mattbettcher/m68030-sbc/README.md

# m68030-sbc

Homebrew MC68030 single-board computer.

See [68030-design/spec.md](68030-design/spec.md) for the design specification.

Open [68030-design/kicad/m68030-sbc.kicad_pro](68030-design/kicad/m68030-sbc.kicad_pro) in KiCad 9.
