mattbettcher/m68030-sbc/68030-design/cpld/dram/pinout.csv

pin | fitter_name | function
1 | PWR_RST_n | GCLR (dedicated input)
2 |  | CLK_DRAMC on GCLK2 (for a future CPU-clock-synchronous FSM; unused in Rev A logic)
3 | VCC
4 | CAS0_n
5 | RAS1_n
6 | RAS2_n
7 | GND
8 | RAS3_n
9 | MA11
10 | MA10
11 | MA7
12 | MA6
13 | VCC
14 | TDI
15 | MA5
16 |  | reserved STERM_n (solder jumper JP801 open)
17 |  | reserved CBREQ_n (solder jumper JP802 open)
18 |  | reserved CBACK_n (solder jumper JP803 open)
19 | GND
20 | MA1
21 | MA3
22 | MA0
23 | TMS
24 | MA4
25 | MA2
26 | VCC
27 | MA8
28 | DSACK0_n
29 | MA9
30 | DSACK1_n
31 | R_W
32 | GND
33 | DRAM_SEL_n
34 | A0
35 | SIZ1
36 | SIZ0
37 | A1
38 | VCC
39 | A26
40 | A25
41 | A24
42 | GND
43 | VCC
44 | A23
45 | A21
46 | A22
47 | GND
48 | A18
49 | A19
50 |  | reserved DS_n (solder jumper JP804 open)
51 | A11
52 | A17
53 | VCC
54 | A10
55 | A13
56 | A7
57 | A8
58 | A4
59 | GND
60 | A2
61 | A6
62 | TCK
63 | A9
64 | A3
65 | A12
66 | VCC
67 | A15
68 | A5
69 | A14
70 | CAS2_n
71 | TDO
72 | GND
73 | A16
74 | MUX_SEL
75 | WE_n
76 | RAS0_n
77 | CAS1_n
78 | VCC
79 | CAS3_n
80 | A20
81 |  | spare I/O/GCLK3 (test point TP809)
82 | GND
83 | DRAM_CLK | GCLK1 (dedicated input)
84 | AS_n | OE1 (dedicated input)
