mattbettcher/m68030-sbc/68030-design/cpld/glue/pinout.csv

pin | fitter_name | function
1 | PWR_RST_n | GCLR (dedicated input)
2 | DS_n | OE2/GCLK2 (dedicated input)
3 | VCC
4 | IPL1_n
5 | DRAM_SEL_n
6 | AVEC_n
7 | GND
8 | DSACK0_n
9 | FC2
10 | FC1
11 | FC0
12 | EXP_SEL_n
13 | VCC
14 | TDI
15 | PERIPH_RST_n
16 | EXP_INT_n
17 | A19
18 | R_W
19 | GND
20 | EXP_BUF_EN_n
21 | IDE_DIOR_n
22 | A16
23 | TMS
24 | A15
25 | NMI_BTN_n
26 | VCC
27 | WARM_RST_BTN_n
28 | A2
29 | LED_n
30 | A3
31 | A13
32 | GND
33 | A18
34 | BUS_RD_n
35 | A17
36 | A14
37 | DUART_INT_n
38 | VCC
39 | BUS_WR_n
40 | ROM_CE_n
41 | NIC_INT_n
42 | GND
43 | VCC
44 | HALT_LED_n
45 | DUART_RST
46 |  | reserved SPI_HW_SCK (jumper | open)
47 | GND
48 |  | reserved SPI_HW_MOSI (jumper | open)
49 |  | reserved SPI_HW_MISO (jumper | open)
50 | IDE_BUF_EN_n
51 | DUART_CS_n
52 | IDE_CS1_n
53 | VCC
54 | IDE_INTRQ
55 | IDE_CS0_n
56 | IDE_IORDY
57 | IDE_DA2
58 | IDE_DIOW_n
59 | GND
60 | IDE_DA1
61 | CIIN_n
62 | TCK
63 | IDE_DA0
64 | HALT_n
65 | BERR_n
66 | VCC
67 | FPU_CS_n
68 | IPL0_n
69 | STATUS_n
70 | IPL2_n
71 | TDO
72 | GND
73 | RESET_n
74 | A29
75 | A28
76 | A31
77 | A30
78 | VCC
79 | A27
80 | A1
81 | DSACK1_n
82 | GND
83 | CLK | GCLK1 (dedicated input)
84 | AS_n | OE1 (dedicated input)
