mattbettcher/m68030-sbc/68030-design/fab/check/drill-overlay-v3.png

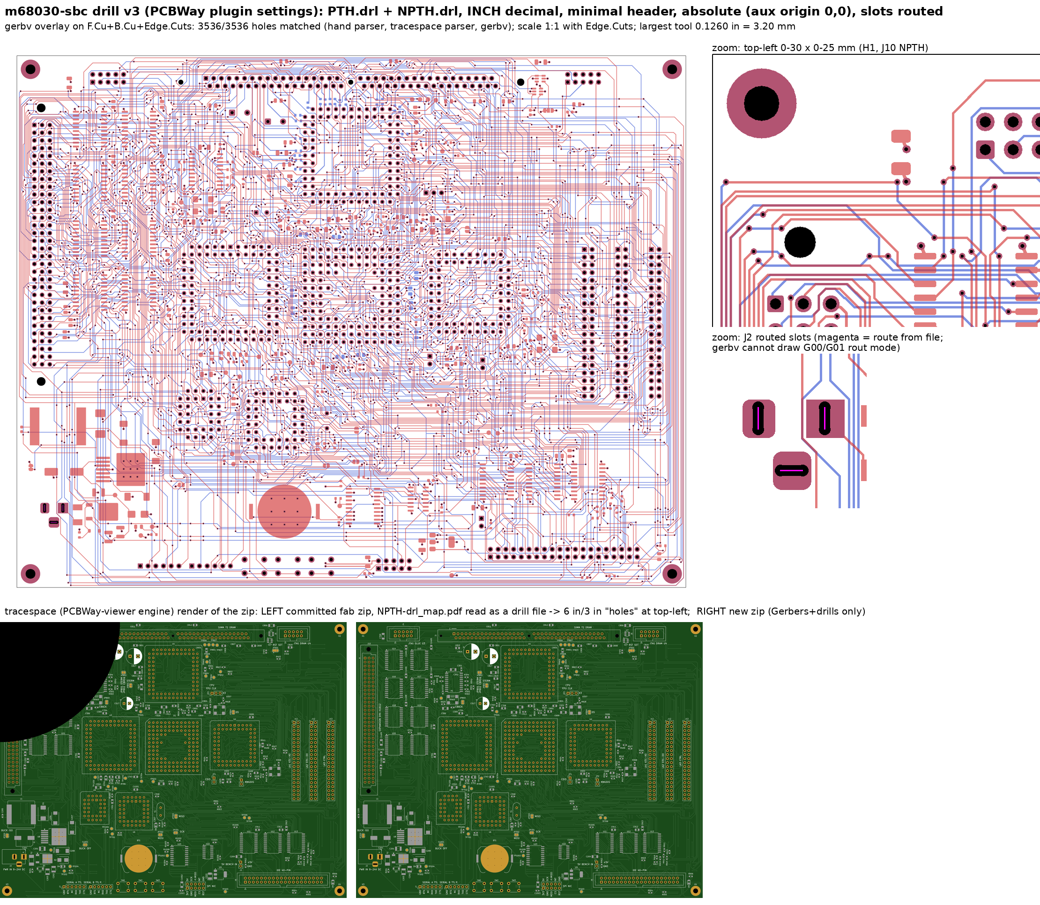
68030-design/fab/check/drill-overlay-v3.png
