mattbettcher/m68030-sbc/68030-design/fab/check/In1_Cu.png

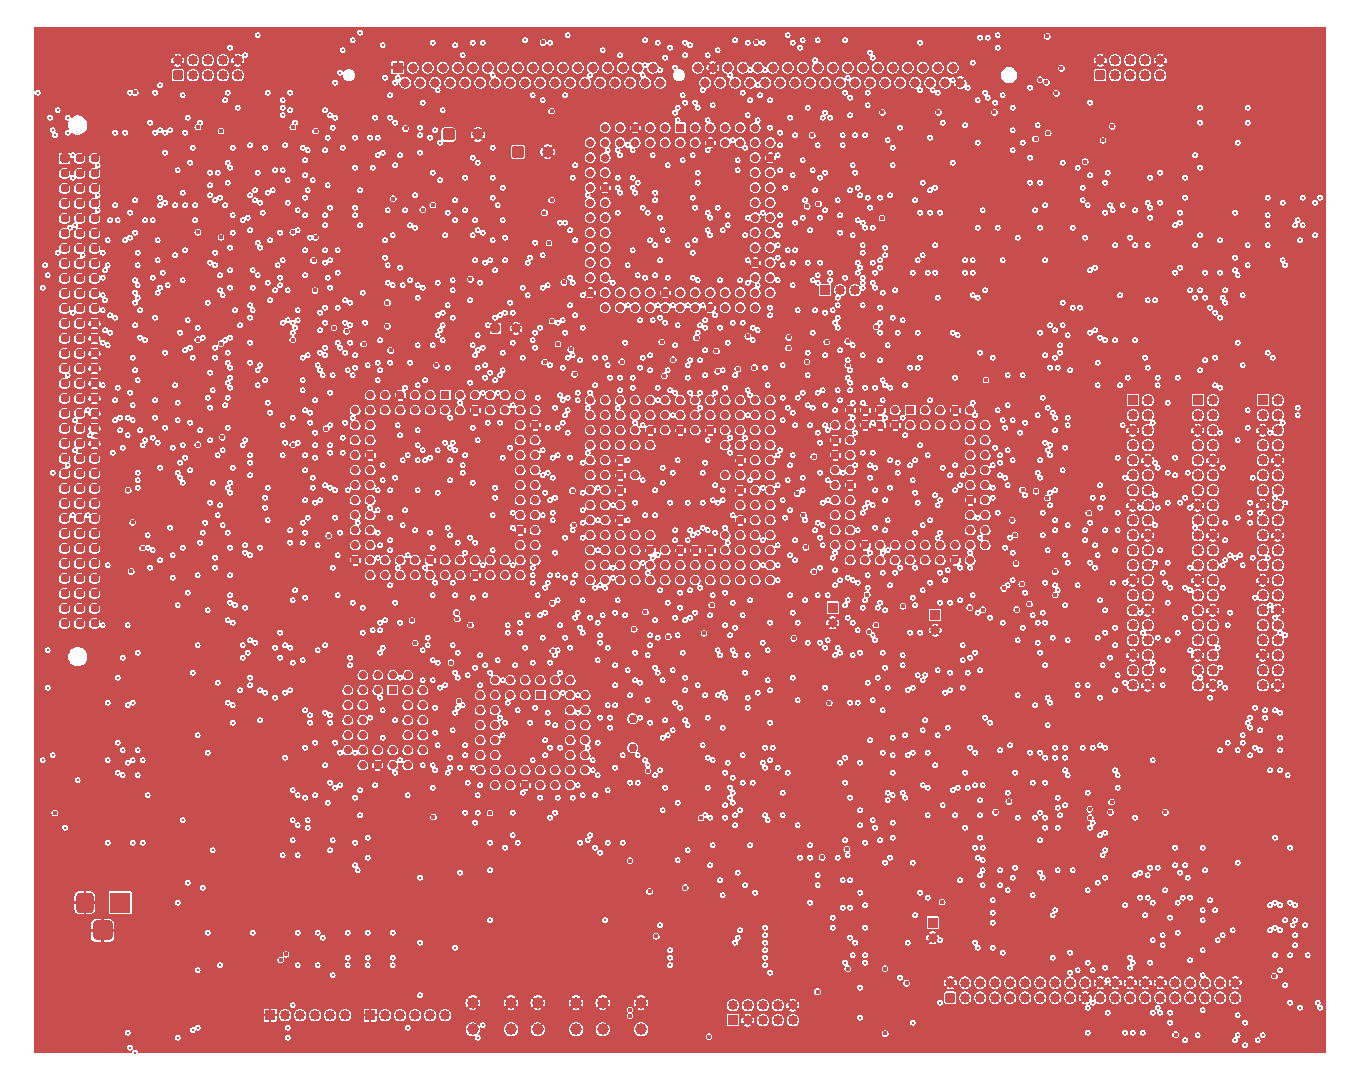
68030-design/fab/check/In1_Cu.png
