mattbettcher/m68030-sbc/68030-design/fab/check/In2_Cu.png

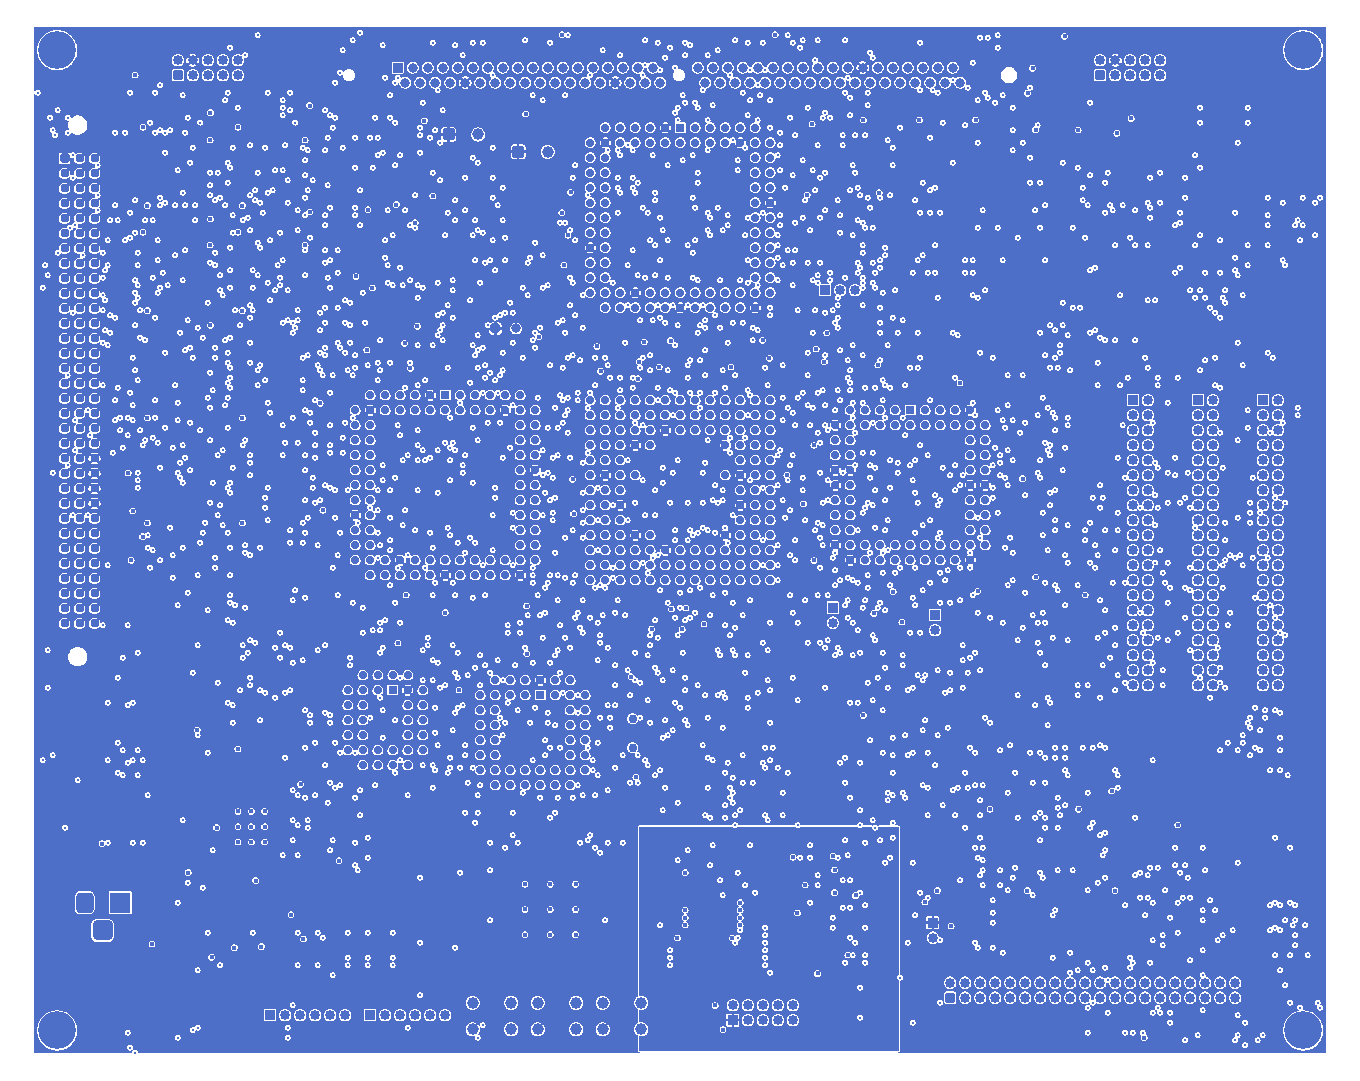
68030-design/fab/check/In2_Cu.png
