mattbettcher/m68030-sbc/68030-design/fab/check/inner-planes-gerbv.png

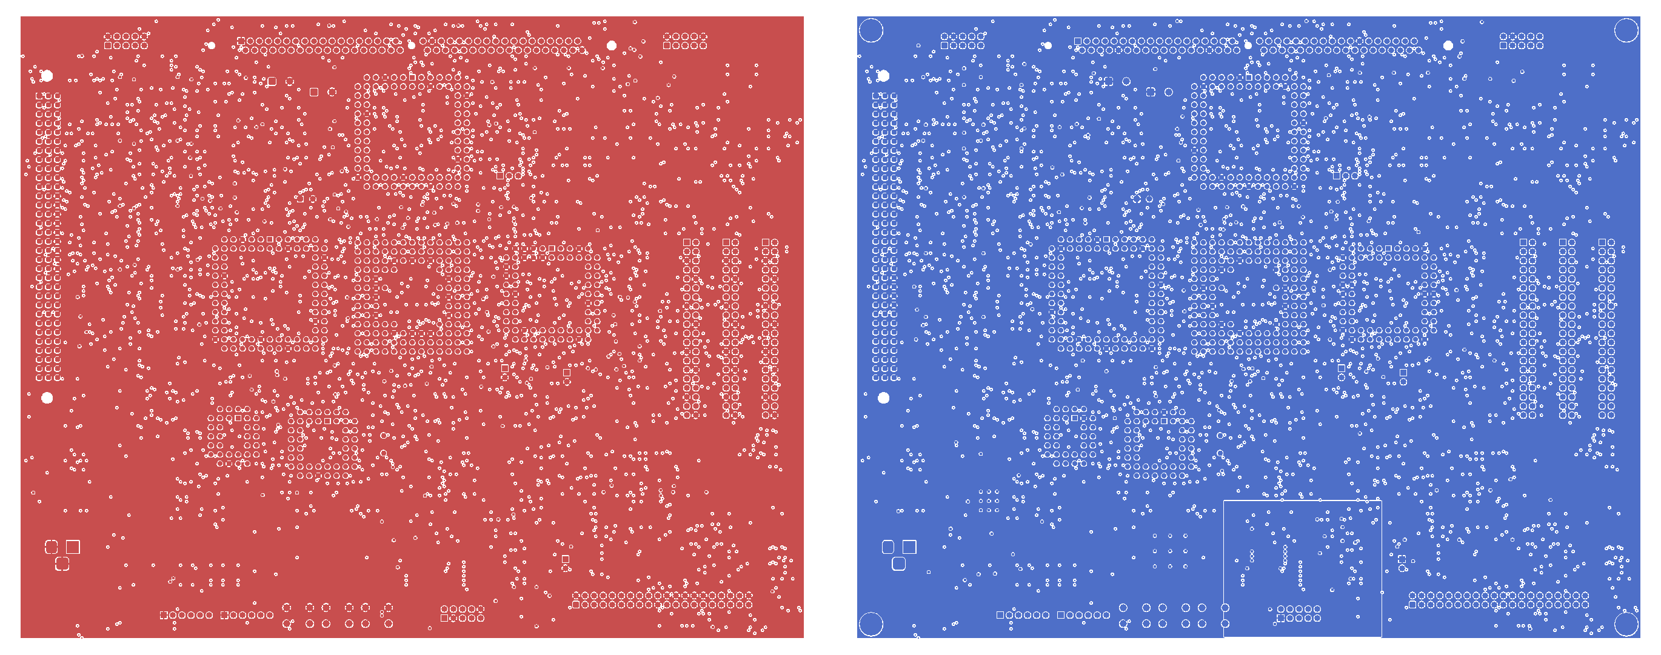
68030-design/fab/check/inner-planes-gerbv.png
