mattbettcher/m68030-sbc/68030-design/fab/check/topleft.png

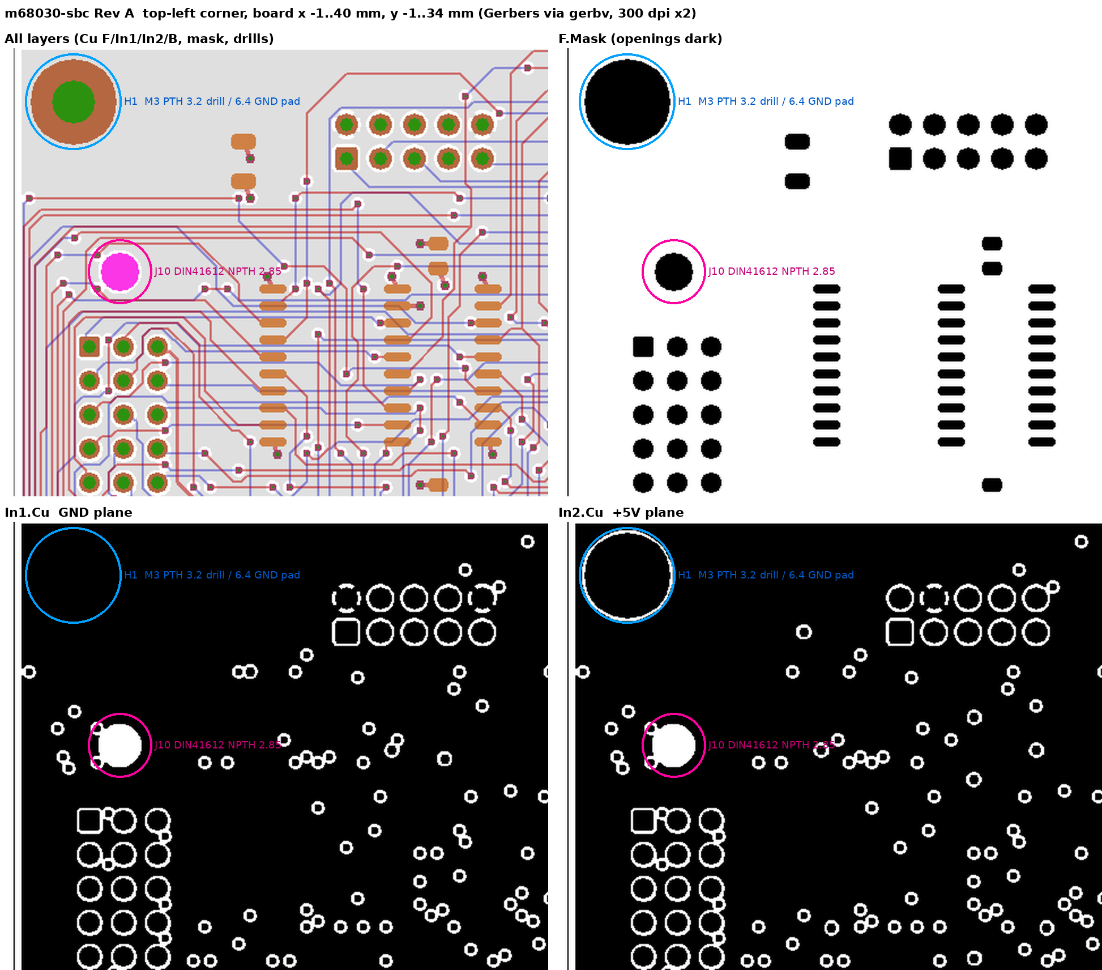
68030-design/fab/check/topleft.png
