mattbettcher/m68030-sbc/68030-design/renders/condense-assessment.png

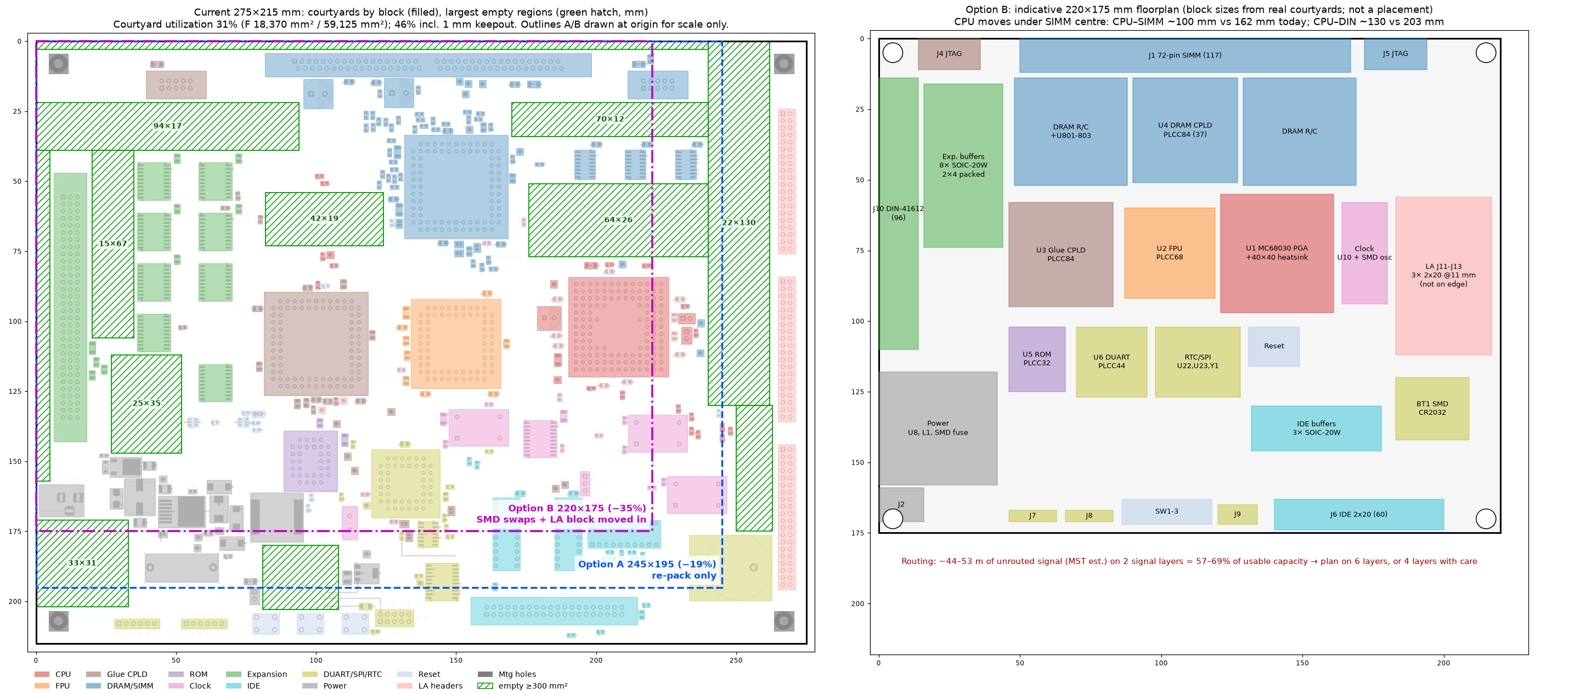
68030-design/renders/condense-assessment.png
