mattbettcher/m68030-sbc/68030-design/renders/m68030-sbc-3d-bottom.png

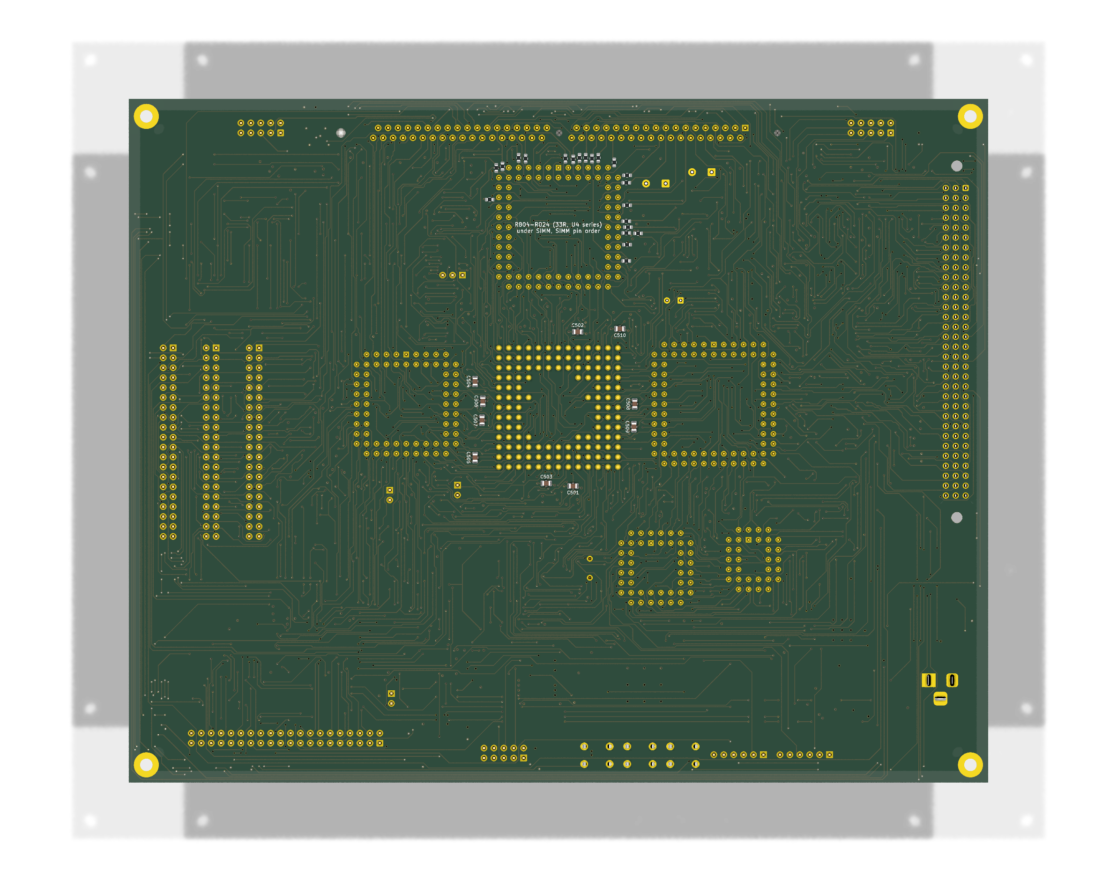
68030-design/renders/m68030-sbc-3d-bottom.png
