mattbettcher/m68030-sbc/68030-design/renders/m68030-sbc-220x175-pinswap-autoroute-4L.png

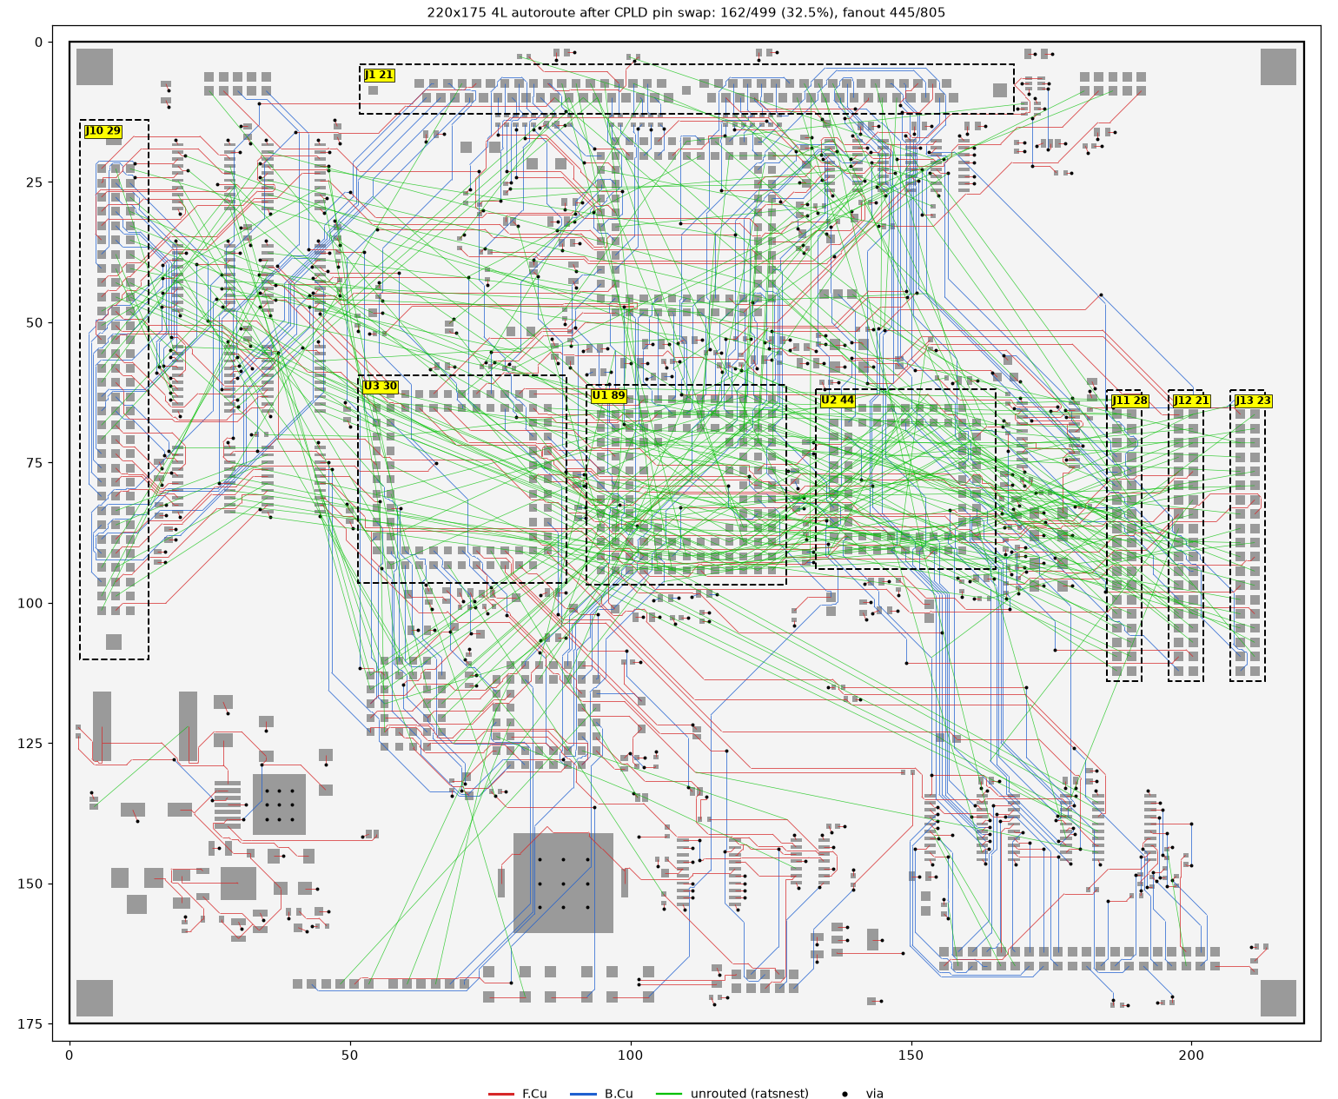
68030-design/renders/m68030-sbc-220x175-pinswap-autoroute-4L.png
