mattbettcher/m68030-sbc/68030-design/renders/m68030-sbc-B.Cu.png

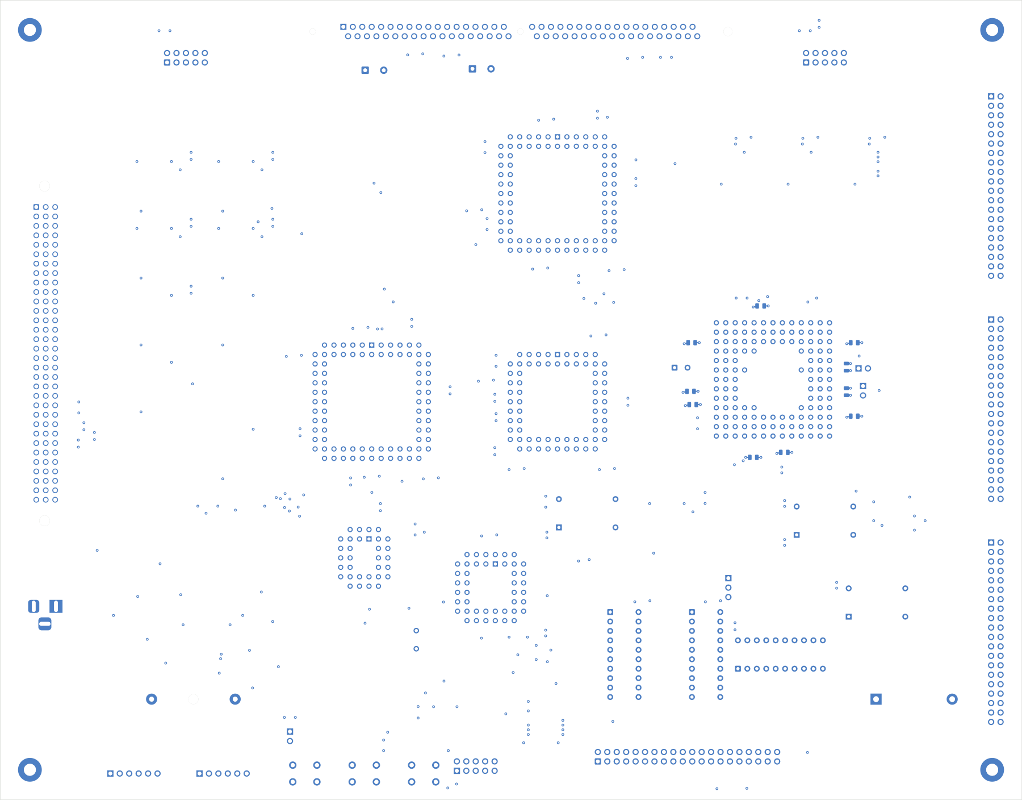
68030-design/renders/m68030-sbc-B.Cu.png
