mattbettcher/m68030-sbc/68030-design/renders/m68030-sbc-labels-zoom-bottom-right.png

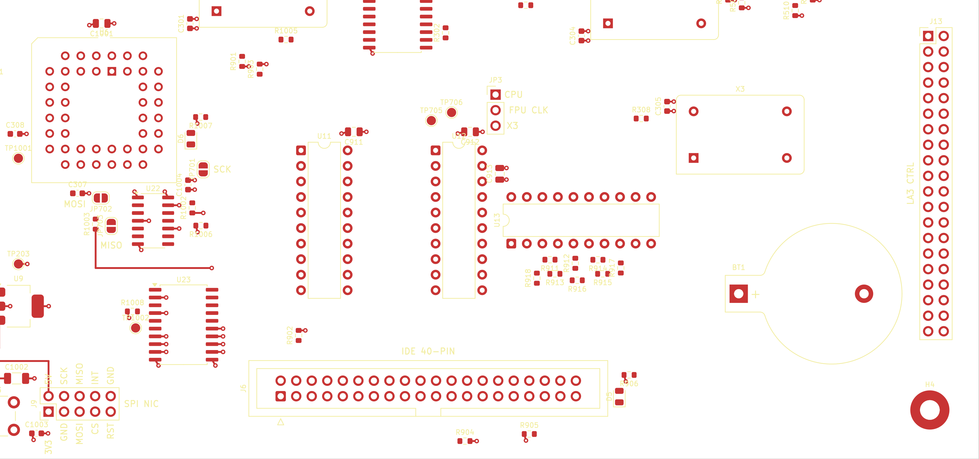
68030-design/renders/m68030-sbc-labels-zoom-bottom-right.png
