mattbettcher/m68030-sbc/68030-design/renders/m68030-sbc-labels-zoom-cpu-jumpers.png

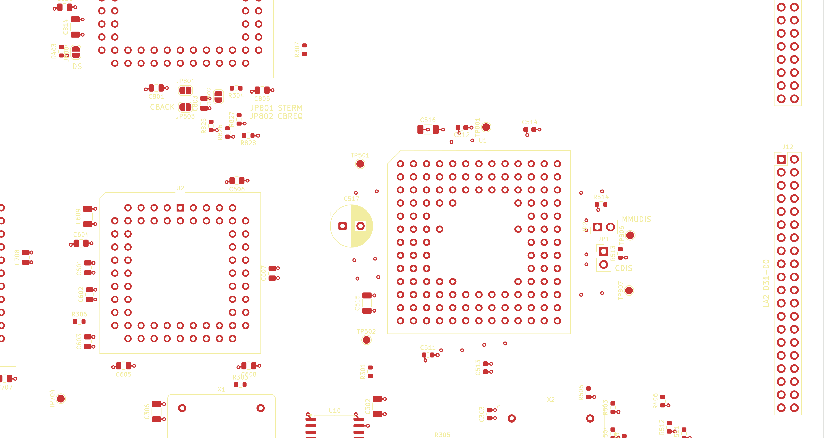
68030-design/renders/m68030-sbc-labels-zoom-cpu-jumpers.png
