mattbettcher/m68030-sbc/68030-design/renders/m68030-sbc-labels-zoom-top.png

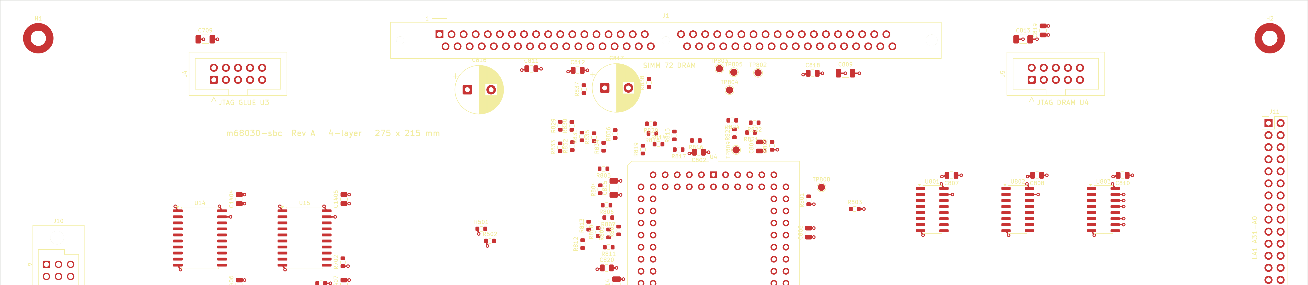
68030-design/renders/m68030-sbc-labels-zoom-top.png
