mattbettcher/m68030-sbc/68030-design/renders/m68030-sbc-routed-top.png

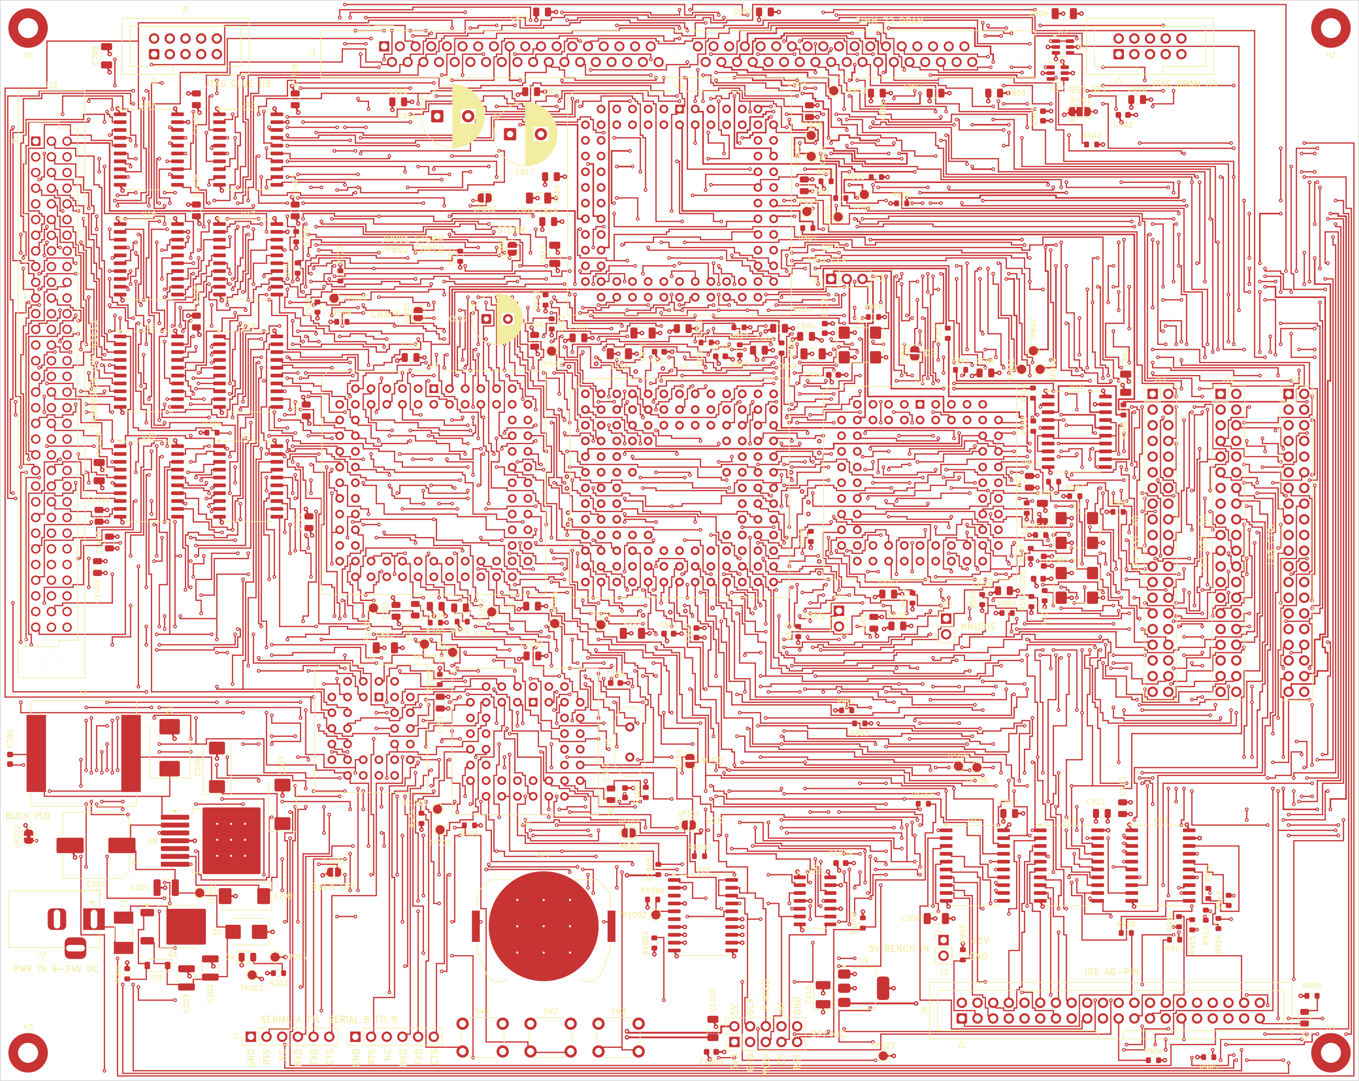
68030-design/renders/m68030-sbc-routed-top.png
