mattbettcher/m68030-sbc/68030-design/fab/m68030-sbc-bom.csv

Section | Refs | Qty | Value | Footprint | MPN | Source (bom.csv) | DNP | Notes
Fitted | BT1 | 1 | CR2032 | Battery:BatteryHolder_Keystone_3034_1x20mm | Keystone 3034 | DigiKey 36-3034-ND
Fitted | C201 C202 C203 | 3 | 10u | Capacitor_SMD:C_1210_3225Metric
Fitted | C204 | 1 | 100u | Capacitor_SMD:CP_Elec_10x10.5
Fitted | C205 | 1 | 10n | Capacitor_SMD:C_0603_1608Metric
Fitted | C206 C207 C208 | 3 | 100u | Capacitor_Tantalum_SMD:CP_EIA-7343-43_Kemet-X | KEMET T495X107K010ATE100 [VERIFY]
Fitted | C209 C302 C306 C515 C516 C552 C609 C709 C809 C813 C814 C815 C1002 C1409 | 14 | 10u | Capacitor_SMD:C_1206_3216Metric
Fitted | C210 | 1 | 22u 10V tant | Capacitor_Tantalum_SMD:CP_EIA-3528-21_Kemet-B
Fitted | C301 C303 C305 C401 C402 C1003 C1004 | 7 | 100n | Capacitor_SMD:C_0603_1608Metric
Fitted | C307 C308 | 2 | 22p C0G | Capacitor_SMD:C_0603_1608Metric
Fitted | C501 C502 C503 C504 C505 C506 C507 C508 C509 C510 C551 C601 C602 C603 C604 C605 C606 C607 C608 C701 C702 C703 C704 C705 C706 C707 C708 C801 C802 C803 C804 C805 C806 C807 C808 C810 C811 C812 C911 C912 C913 C1001 C1401 C1402 C1403 C1404 C1405 C1406 C1407 C1408 | 50 | 100n | Capacitor_SMD:C_0805_2012Metric
Fitted | C511 C512 C513 C514 | 4 | 330p | Capacitor_SMD:C_0603_1608Metric
Fitted | C517 | 1 | 220u | Capacitor_THT:CP_Radial_D8.0mm_P3.50mm
Fitted | C816 C817 | 2 | 470u | Capacitor_THT:CP_Radial_D10.0mm_P5.00mm
Fitted | D1 | 1 | B540C | Diode_SMD:D_SMC | B540C-13-F
Fitted | D2 | 1 | SMBJ28CA | Diode_SMD:D_SMB | SMBJ28CA (28 V standoff, bidirectional)
Fitted | D3 | 1 | MMSZ5242B | Diode_SMD:D_SOD-123 | MMSZ5242B (12 V)
Fitted | D4 | 1 | PWR | LED_SMD:LED_0805_2012Metric
Fitted | D5 | 1 | IDE | LED_SMD:LED_0805_2012Metric
Fitted | D6 | 1 | OP6 | LED_SMD:LED_0805_2012Metric
Fitted | D701 | 1 | USER | LED_SMD:LED_0805_2012Metric
Fitted | D702 | 1 | HALTED | LED_SMD:LED_0805_2012Metric
Fitted | F1 | 1 | T5A 0454005.MR | Fuse:Fuse_Littelfuse-NANO2-451_453 | Littelfuse 0454005.MR | DigiKey / Newark
Fitted | J1 | 1 | SIMM-72 socket | m68030-sbc:SIMM-72_TE-5822021-4 | TE 5822021-4
Fitted | J2 | 1 | 9-24V DC | Connector_BarrelJack:BarrelJack_Horizontal
Fitted | J4 | 1 | JTAG (ATDH1150USB) | Connector_IDC:IDC-Header_2x05_P2.54mm_Vertical
Fitted | J5 | 1 | JTAG U4 (ATDH1150USB) | Connector_IDC:IDC-Header_2x05_P2.54mm_Vertical
Fitted | J6 | 1 | IDE 40-pin | Connector_IDC:IDC-Header_2x20_P2.54mm_Vertical | Wurth 61204021621 | Wurth
Fitted | J7 J8 | 2 | TTL-232 | Connector_PinHeader_2.54mm:PinHeader_1x06_P2.54mm_Vertical
Fitted | J9 | 1 | SPI NIC | Connector_PinHeader_2.54mm:PinHeader_2x05_P2.54mm_Vertical
Fitted | J10 | 1 | DIN41612-C-96 | Connector_DIN:DIN41612_C_3x32_Female_Vertical_THT | HARTING 09032966821 | HARTING
Fitted | J11 | 1 | LA1 A31-A0 | Connector_PinHeader_2.54mm:PinHeader_2x20_P2.54mm_Vertical | Samtec TSW-120-07-G-D
Fitted | J12 | 1 | LA2 D31-D0 | Connector_PinHeader_2.54mm:PinHeader_2x20_P2.54mm_Vertical | Samtec TSW-120-07-G-D
Fitted | J13 | 1 | LA3 control | Connector_PinHeader_2.54mm:PinHeader_2x20_P2.54mm_Vertical | Samtec TSW-120-07-G-D
Fitted | JP1 | 1 | CDIS (cache disable) | Connector_PinHeader_2.54mm:PinHeader_1x02_P2.54mm_Vertical
Fitted | JP2 | 1 | MMUDIS (MMU disable) | Connector_PinHeader_2.54mm:PinHeader_1x02_P2.54mm_Vertical
Fitted | JP3 | 1 | FPU_CLK_SEL | Connector_PinHeader_2.54mm:PinHeader_1x03_P2.54mm_Vertical
Fitted | L1 | 1 | 22uH | Inductor_SMD:L_Bourns_SRP1770TA_16.9x16.9mm | Bourns SRP1770TA-220M
Fitted | Q1 | 1 | SUD50P04-08 | Package_TO_SOT_SMD:TO-252-2 | SUD50P04-08-GE3 | Newark / TME
Fitted | R201 R401 R403 R404 R405 R510 R511 R512 R513 R514 R825 R826 R827 R828 R902 R903 R905 R1002 R1003 R1004 R1008 | 21 | 10k | Resistor_SMD:R_0603_1608Metric
Fitted | R202 R406 R407 R501 R502 R503 R504 R505 R506 R507 R508 R509 R705 R706 R906 R1007 | 16 | 1k | Resistor_SMD:R_0603_1608Metric
Fitted | R301 R302 R303 R304 R305 R306 R307 | 7 | 33R | Resistor_SMD:R_0603_1608Metric
Fitted | R402 | 1 | 100k | Resistor_SMD:R_0603_1608Metric
Fitted | R701 R702 R703 R704 R801 R802 R803 R901 R1001 | 9 | 4.7k | Resistor_SMD:R_0603_1608Metric
Fitted | R804 R805 R806 R807 R808 R809 R810 R811 R812 R813 R814 R815 R816 R817 R818 R819 R820 R821 R822 R823 R824 R911 R912 R913 R914 R915 R916 R917 R918 | 29 | 33 | Resistor_SMD:R_0603_1608Metric
Fitted | R904 | 1 | 5.6k | Resistor_SMD:R_0603_1608Metric
Fitted | R1005 | 1 | 1.0k | Resistor_SMD:R_0603_1608Metric
Fitted | R1006 | 1 | 2.2k | Resistor_SMD:R_0603_1608Metric
Fitted | SW1 | 1 | WARM_RESET | Button_Switch_THT:SW_PUSH_6mm_H5mm
Fitted | SW2 | 1 | NMI | Button_Switch_THT:SW_PUSH_6mm_H5mm
Fitted | SW3 | 1 | COLD_RESET | Button_Switch_THT:SW_PUSH_6mm_H5mm
Fitted | U1 | 1 | MC68030RC33C | m68030-sbc:PGA128_13x13_MC68030 | MC68030RC33C | Rochester Electronics via DigiKey (authorized)
Fitted | U2 | 1 | MC68882FN33A | Package_LCC:PLCC-68_THT-Socket | MC68882FN33A (or FN25A) | Brokers (FN33A); verify authenticity
Fitted | U3 U4 | 2 | ATF1508AS-7JX84 | Package_LCC:PLCC-84_THT-Socket | ATF1508AS-7JX84 | Microchip Direct
Fitted | U5 | 1 | SST39SF040-70-4C-NHE | Package_LCC:PLCC-32_THT-Socket | SST39SF040-70-4C-NHE | Microchip / distributors
Fitted | U6 | 1 | SC26C92A1A | Package_LCC:PLCC-44_THT-Socket | SC26C92A1A | Brokers only (Digi-Key/Mouser/Rochester stock 0 on 2026-10-03)
Fitted | U7 | 1 | TPS3702CX50DDCR | Package_TO_SOT_SMD:SOT-23-6 | TPS3702CX50DDCR | DigiKey
Fitted | U8 | 1 | LM2678S-5.0 | Package_TO_SOT_SMD:TO-263-7_TabPin4 | LM2678S-5.0/NOPB | DigiKey
Fitted | U9 | 1 | AMS1117-3.3 | Package_TO_SOT_SMD:SOT-223-3_TabPin2 | AMS1117-3.3
Fitted | U10 | 1 | 74ACT244 | Package_SO:SOIC-20W_7.5x12.8mm_P1.27mm | SN74ACT244DWR
Fitted | U11 U12 U13 U18 U19 U20 U21 | 7 | SN74ACT245DW | Package_SO:SOIC-20W_7.5x12.8mm_P1.27mm | SN74ACT245DW | TI; TI / Mouser 595-SN74ACT245DW
Fitted | U14 U15 U16 U17 | 4 | SN74ACT244DW | Package_SO:SOIC-20W_7.5x12.8mm_P1.27mm | SN74ACT244DW | TI
Fitted | U22 | 1 | SN74LVC125ADR | Package_SO:SOIC-14_3.9x8.7mm_P1.27mm | SN74LVC125ADR | TI
Fitted | U23 | 1 | DS3234S# | Package_SO:SOIC-20W_7.5x12.8mm_P1.27mm | DS3234S# | DigiKey
Fitted | U27 | 1 | TPS3808G50DBVR | Package_TO_SOT_SMD:SOT-23-6 | TPS3808G50DBVR | DigiKey
Fitted | X1 | 1 | 25.000MHz | m68030-sbc:Oscillator_SMD_ECS-3951M_7.0x5.0mm_DIP14PinMap | ECS-3951M-250-BN-TR | DigiKey / Mouser (ECS authorized)
Fitted | X2 | 1 | 50.000MHz | m68030-sbc:Oscillator_SMD_ECS-3951M_7.0x5.0mm_DIP14PinMap | ECS-3951M-500-BN-TR | Mouser 520-3951M-500-BN / DigiKey XC324CT-ND
Fitted | Y1 | 1 | 3.6864MHz | Crystal:Crystal_HC49-4H_Vertical | 3.6864 MHz HC-49 (CL per chosen part)
DNP | C304 | 1 | 100n | Capacitor_SMD:C_0603_1608Metric |  |  | yes
DNP | C818 C819 C820 | 3 | 100n | Capacitor_SMD:C_0805_2012Metric |  |  | yes
DNP | J3 | 1 | 5V_BENCH | Connector_PinHeader_2.54mm:PinHeader_1x02_P2.54mm_Vertical |  |  | yes
DNP | R308 | 1 | 33R | Resistor_SMD:R_0603_1608Metric |  |  | yes
DNP | X3 | 1 | FPU osc (DNP) | m68030-sbc:Oscillator_SMD_ECS-3951M_7.0x5.0mm_DIP14PinMap | ECS-3951M-200-BN-TR [VERIFY freq vs 68882 grade] | DigiKey / Mouser | yes
PCB feature (no part) | H1 H2 H3 H4 | 4 | M3 | MountingHole:MountingHole_3.2mm_M3_Pad |  | n/a
PCB feature (no part) | JP202 | 1 | ISOLATE | Jumper:SolderJumper-2_P1.3mm_Bridged_RoundedPad1.0x1.5mm |  | n/a (PCB)
PCB feature (no part) | JP401 | 1 | SET | Jumper:SolderJumper-3_P1.3mm_Bridged12_RoundedPad1.0x1.5mm |  | n/a (PCB)
PCB feature (no part) | JP701 JP702 JP703 JP801 JP802 JP803 JP804 | 7 | open | Jumper:SolderJumper-2_P1.3mm_Open_RoundedPad1.0x1.5mm |  | n/a (PCB)
PCB feature (no part) | SJ201 | 1 | DISABLE | Jumper:SolderJumper-2_P1.3mm_Open_RoundedPad1.0x1.5mm |  | n/a (PCB)
PCB feature (no part) | TP201 | 1 | VIN | TestPoint:TestPoint_Pad_D1.5mm |  | n/a
PCB feature (no part) | TP202 | 1 | +5V | TestPoint:TestPoint_Pad_D1.5mm |  | n/a
PCB feature (no part) | TP203 | 1 | +3V3 | TestPoint:TestPoint_Pad_D1.5mm |  | n/a
PCB feature (no part) | TP204 | 1 | GND | TestPoint:TestPoint_Pad_D1.5mm |  | n/a
PCB feature (no part) | TP501 | 1 | CIOUT# | TestPoint:TestPoint_Pad_D1.5mm |  | n/a
PCB feature (no part) | TP502 | 1 | DBEN# | TestPoint:TestPoint_Pad_D1.5mm |  | n/a
PCB feature (no part) | TP503 | 1 | BG# | TestPoint:TestPoint_Pad_D1.5mm |  | n/a
PCB feature (no part) | TP701 | 1 | BUS_RD# | TestPoint:TestPoint_Pad_D1.5mm |  | n/a
PCB feature (no part) | TP702 | 1 | BUS_WR# | TestPoint:TestPoint_Pad_D1.5mm |  | n/a
PCB feature (no part) | TP703 | 1 | ROM_CE# | TestPoint:TestPoint_Pad_D1.5mm |  | n/a
PCB feature (no part) | TP704 | 1 | DUART_CS# | TestPoint:TestPoint_Pad_D1.5mm |  | n/a
PCB feature (no part) | TP705 | 1 | IDE_DIOR# | TestPoint:TestPoint_Pad_D1.5mm |  | n/a
PCB feature (no part) | TP706 | 1 | IDE_DIOW# | TestPoint:TestPoint_Pad_D1.5mm |  | n/a
PCB feature (no part) | TP801 | 1 | RAS0# | TestPoint:TestPoint_Pad_D1.5mm |  | n/a
PCB feature (no part) | TP802 | 1 | RAS1# | TestPoint:TestPoint_Pad_D1.5mm |  | n/a
PCB feature (no part) | TP803 | 1 | CAS0# | TestPoint:TestPoint_Pad_D1.5mm |  | n/a
PCB feature (no part) | TP804 | 1 | CAS1# | TestPoint:TestPoint_Pad_D1.5mm |  | n/a
PCB feature (no part) | TP805 | 1 | CAS2# | TestPoint:TestPoint_Pad_D1.5mm |  | n/a
PCB feature (no part) | TP806 | 1 | CAS3# | TestPoint:TestPoint_Pad_D1.5mm |  | n/a
PCB feature (no part) | TP807 | 1 | WE# | TestPoint:TestPoint_Pad_D1.5mm |  | n/a
PCB feature (no part) | TP808 | 1 | MUX_SEL | TestPoint:TestPoint_Pad_D1.5mm |  | n/a
PCB feature (no part) | TP809 | 1 | U4-81 | TestPoint:TestPoint_Pad_D1.5mm |  | n/a
PCB feature (no part) | TP1001 | 1 | OP7 | TestPoint:TestPoint_Pad_D1.5mm |  | n/a
PCB feature (no part) | TP1002 | 1 | RTC_INT | TestPoint:TestPoint_Pad_D1.5mm |  | n/a
PCB feature (no part) | TP1101 | 1 | LED_n | TestPoint:TestPoint_Pad_D1.5mm |  | n/a
PCB feature (no part) | TP1102 | 1 | HALT_LED_n | TestPoint:TestPoint_Pad_D1.5mm |  | n/a
Extra (not a footprint) | XU1 | 1 | Socket for U1 | m68030-sbc:PGA128_13x13_MC68030 (derived from mackerel-68k, | PGA-128 13x13 socket | TBD |  | Verify pin grid and 0.762 mm drill vs chosen socket [VERIFY]
Extra (not a footprint) | XU2 | 1 | Socket for U2 | Package_LCC:PLCC-68_THT-Socket | PLCC-68 THT socket | TBD
Extra (not a footprint) | XU3 XU4 | 2 | Sockets for U3/U4 | Package_LCC:PLCC-84_THT-Socket | PLCC-84 THT socket | TBD
Extra (not a footprint) | XU5 | 1 | Socket for U5 | Package_LCC:PLCC-32_THT-Socket | PLCC-32 THT socket | TBD
Extra (not a footprint) | XU6 | 1 | Socket for U6 | Package_LCC:PLCC-44_THT-Socket | PLCC-44 THT socket | TBD
Extra (not a footprint) | M1 | 1 | Main memory (start with known-good 16 or 64 MB) | n/a (module) | 72-pin 5 V SIMM, 60 ns EDO or FPM, 16-128 MB | Arch Memory (64 MB 60 ns EDO, new-old-stock) |  | Price for 64 MB module; prefer 11/11, 12/11 or 12/12 geometries
Extra (not a footprint) | HS1 | 1 | CPU cooling (up to 2.6 W) | n/a | PGA stick-on heatsink | TBD
