mattbettcher/m68030-sbc/68030-design/kicad/out/m68030-sbc.pdf

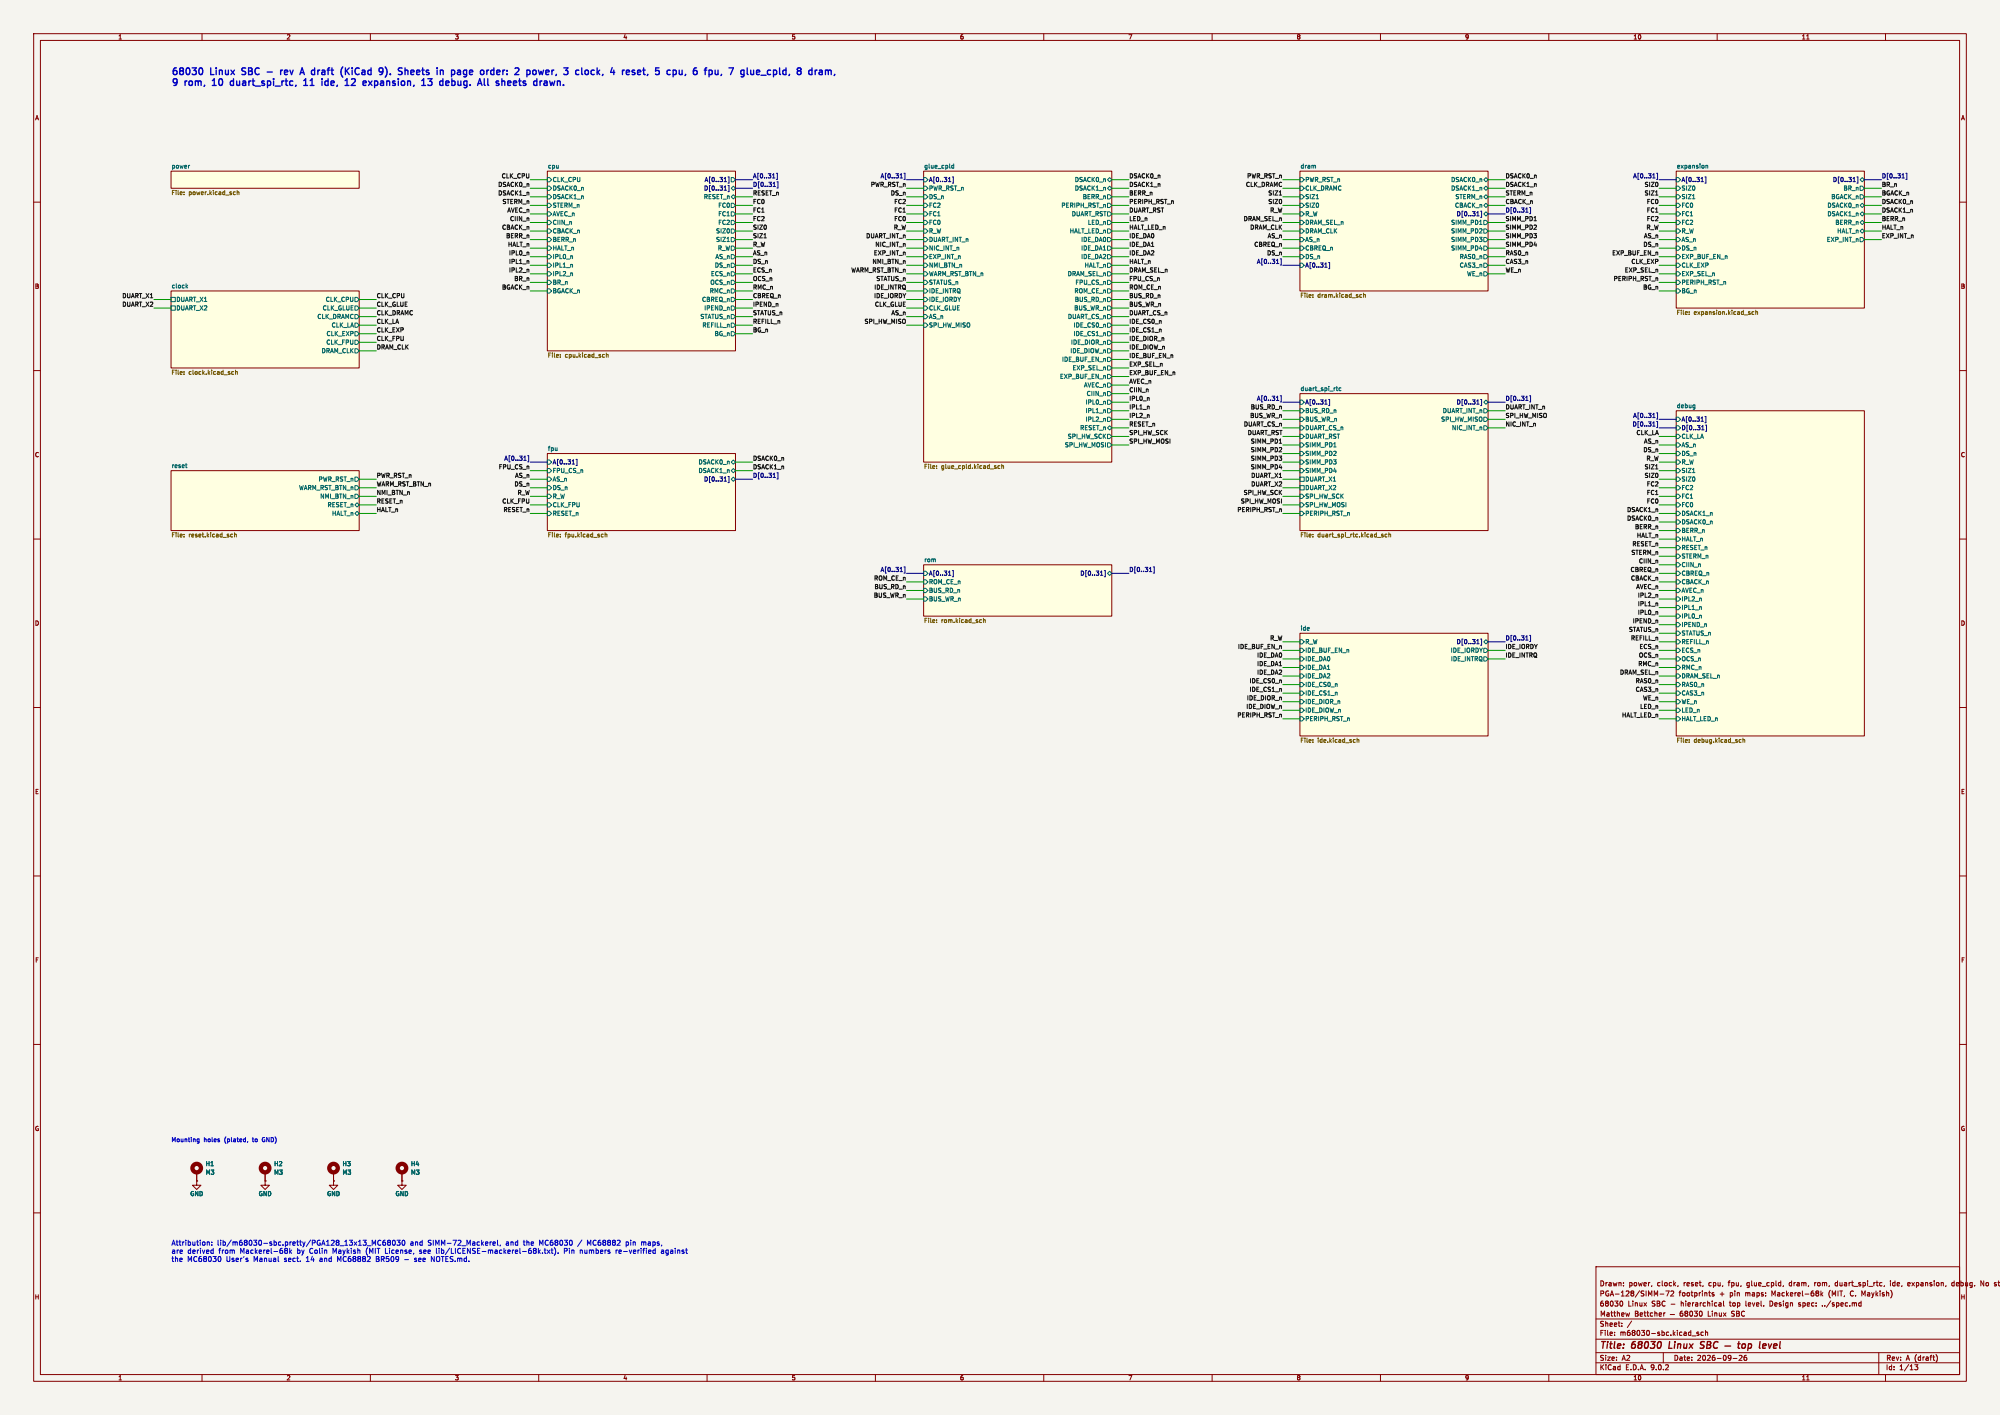
[picture p28: page 1]

68030 Linux SBC - rev A draft (KiCad 9). Sheets in page order: 2 power, 3 clock, 4 reset, 5 cpu, 6 fpu, 7 glue_cpld, 8 dram,

File: dram.kicad_sch power File: power.kicad_sch

the MC68030 User's Manual sect. 14 and MC68882 BR509 - see NOTES.md.

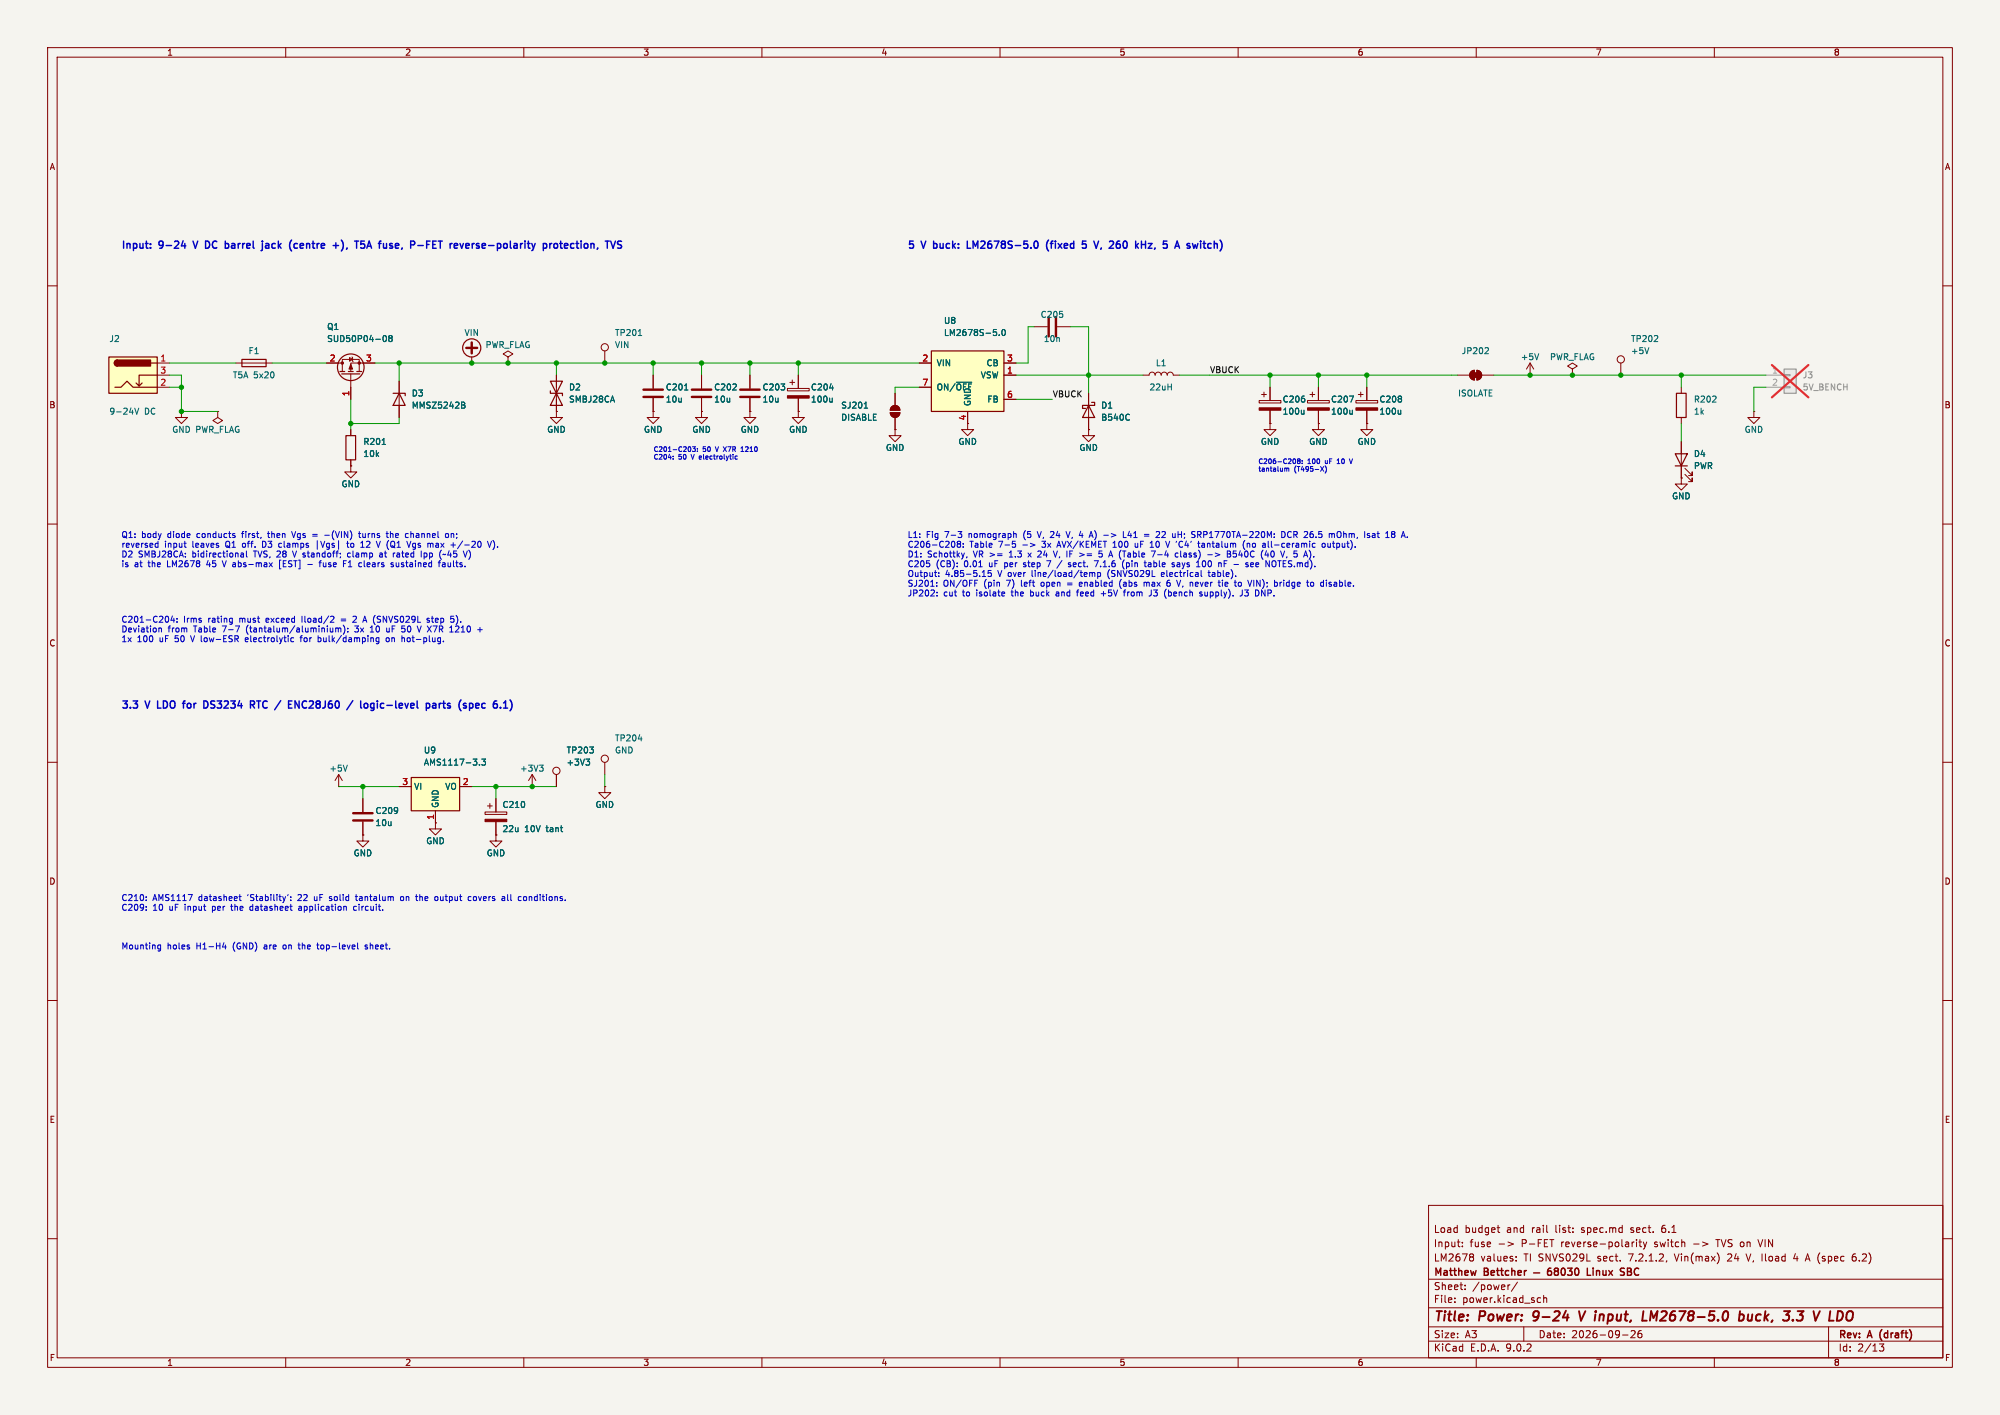
[picture p29: page 2]

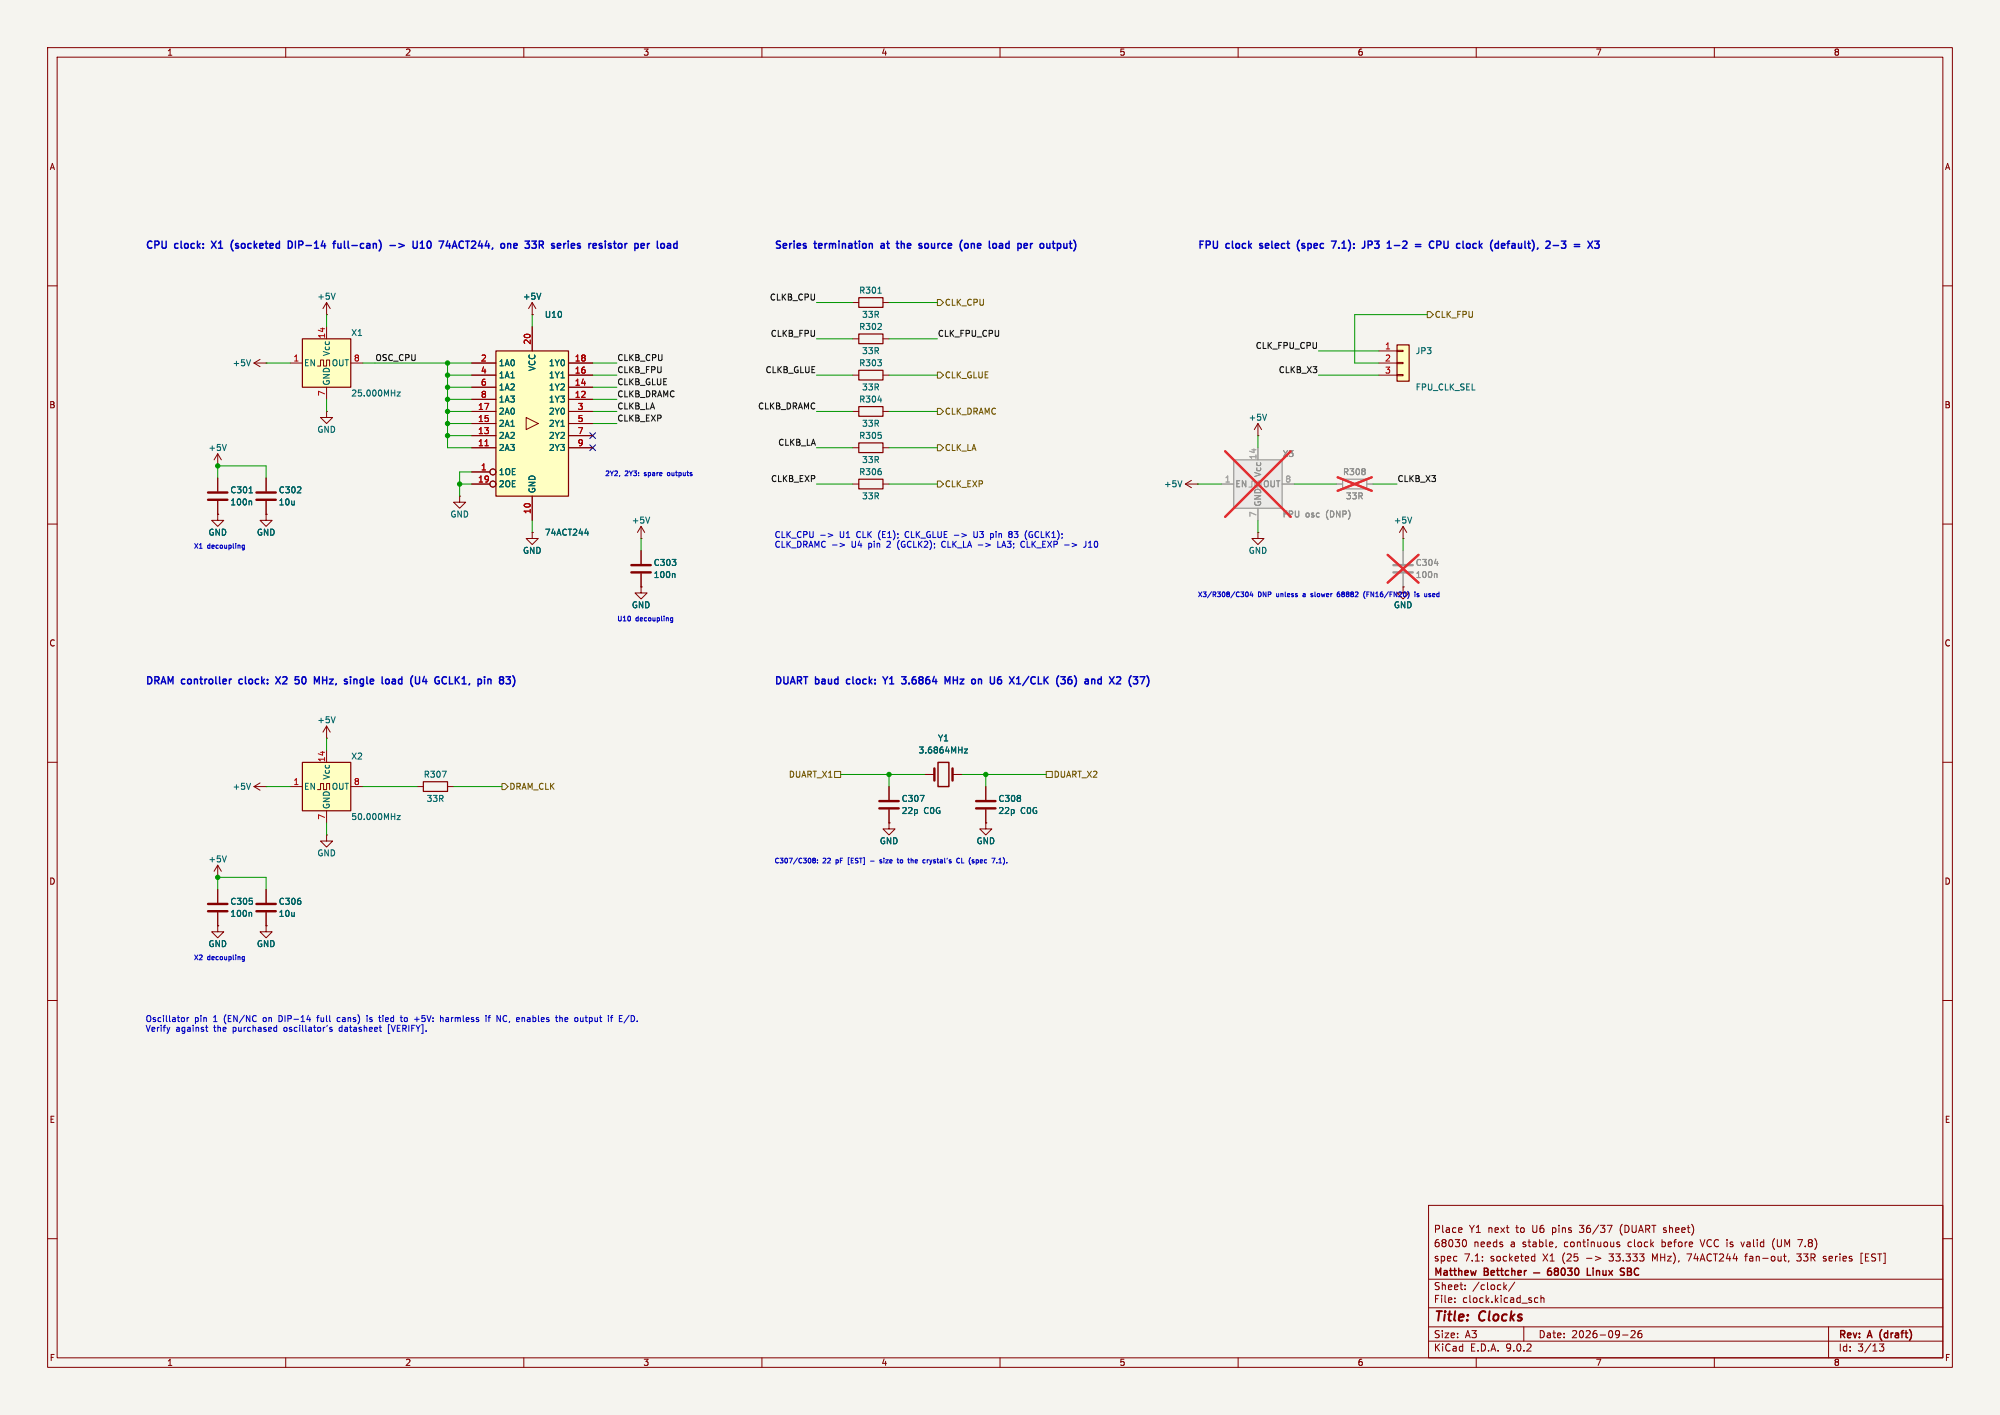
[picture p30: page 3]

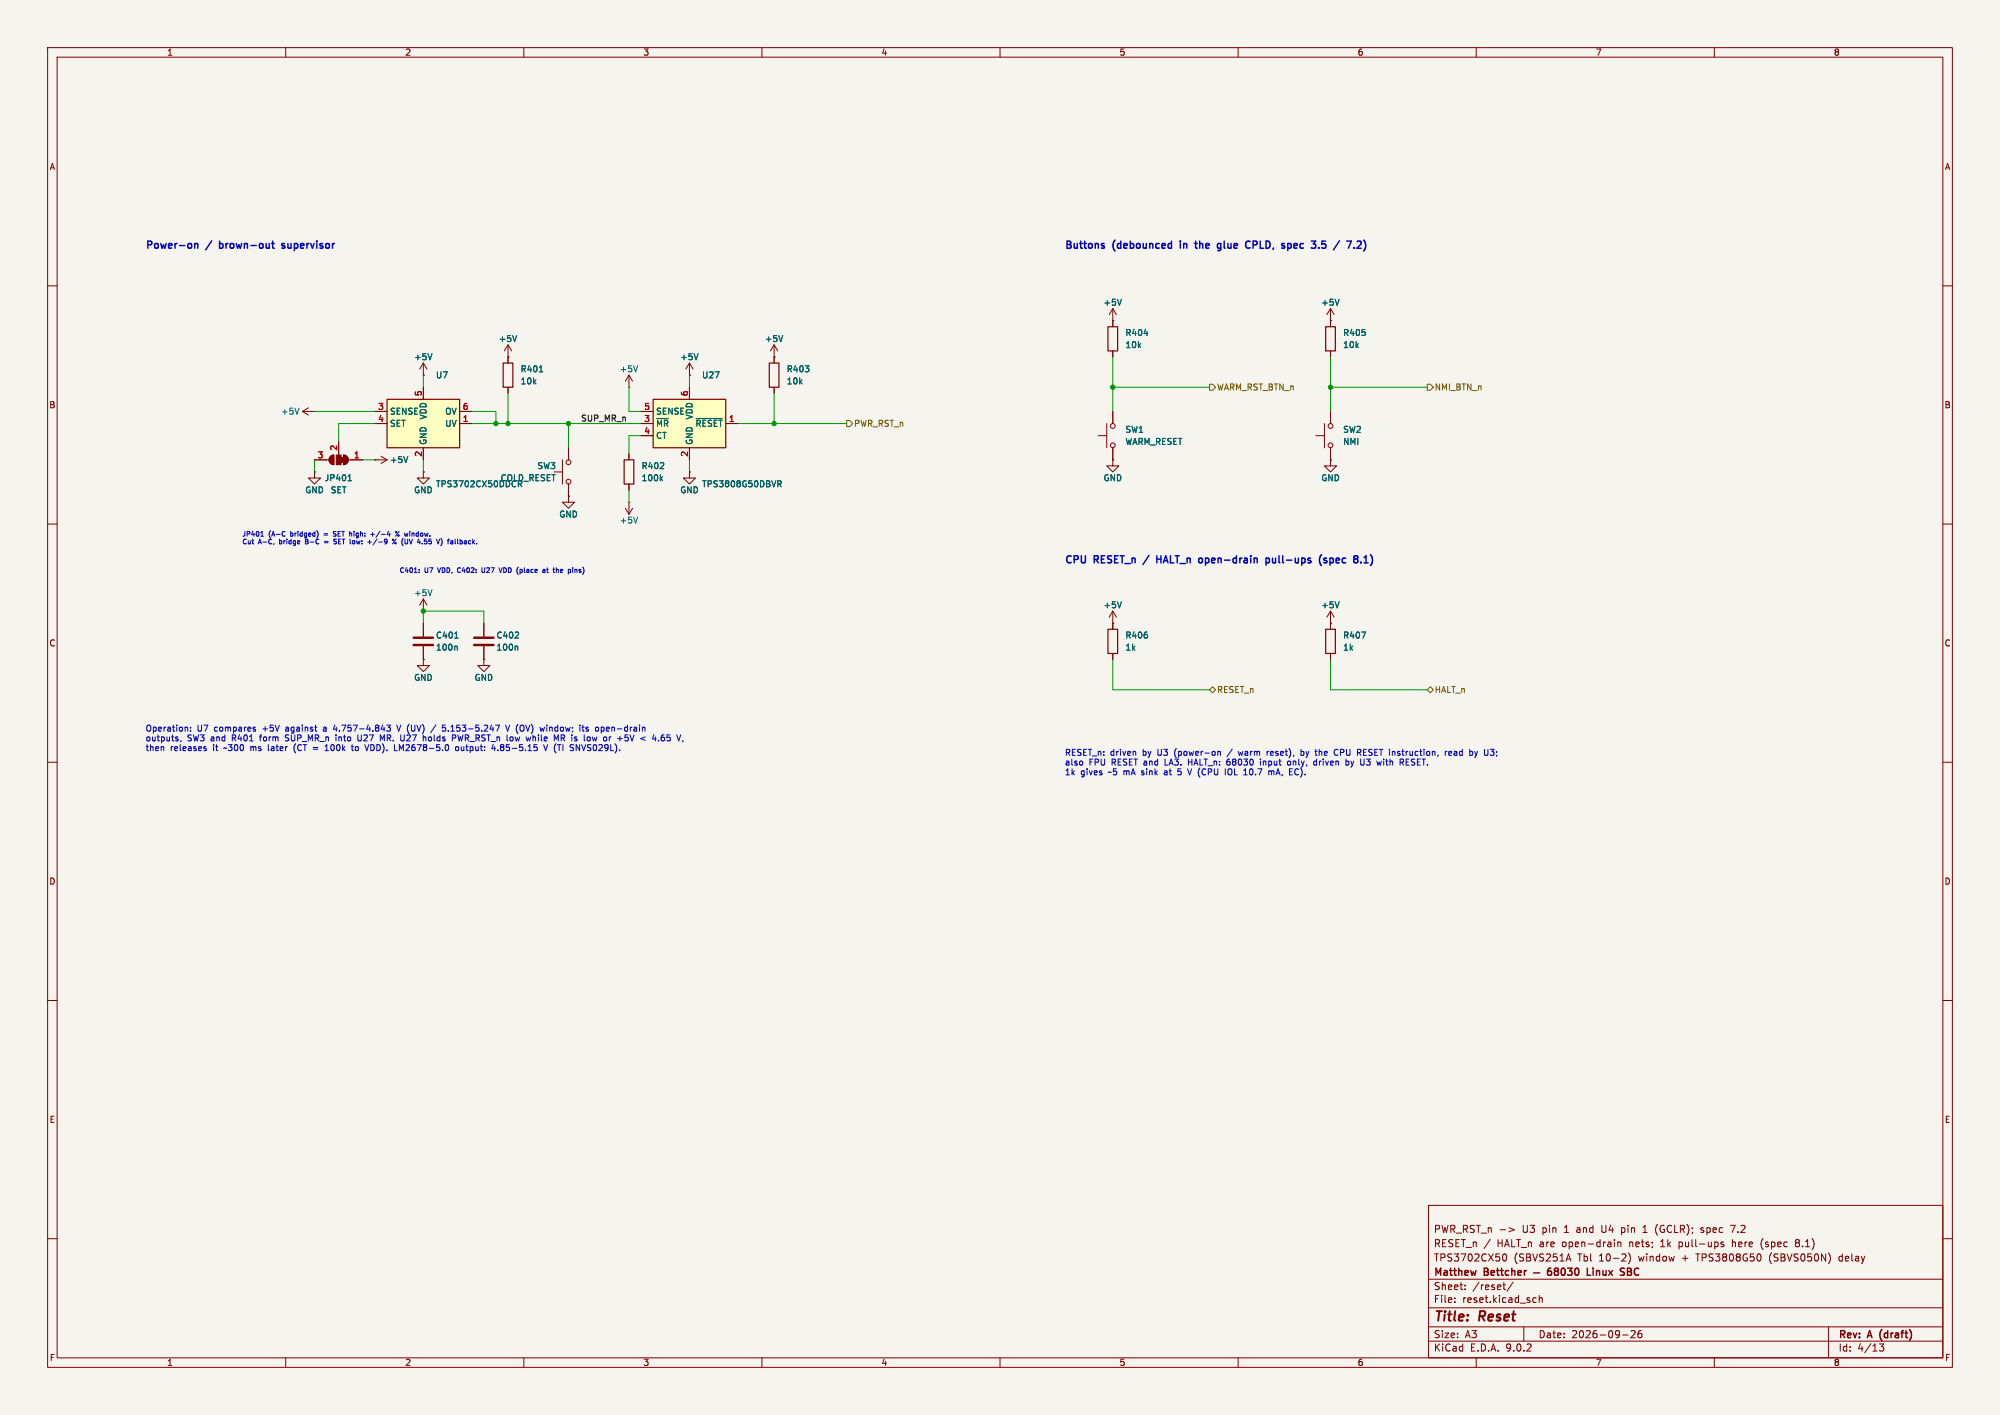
[picture p31: page 4]

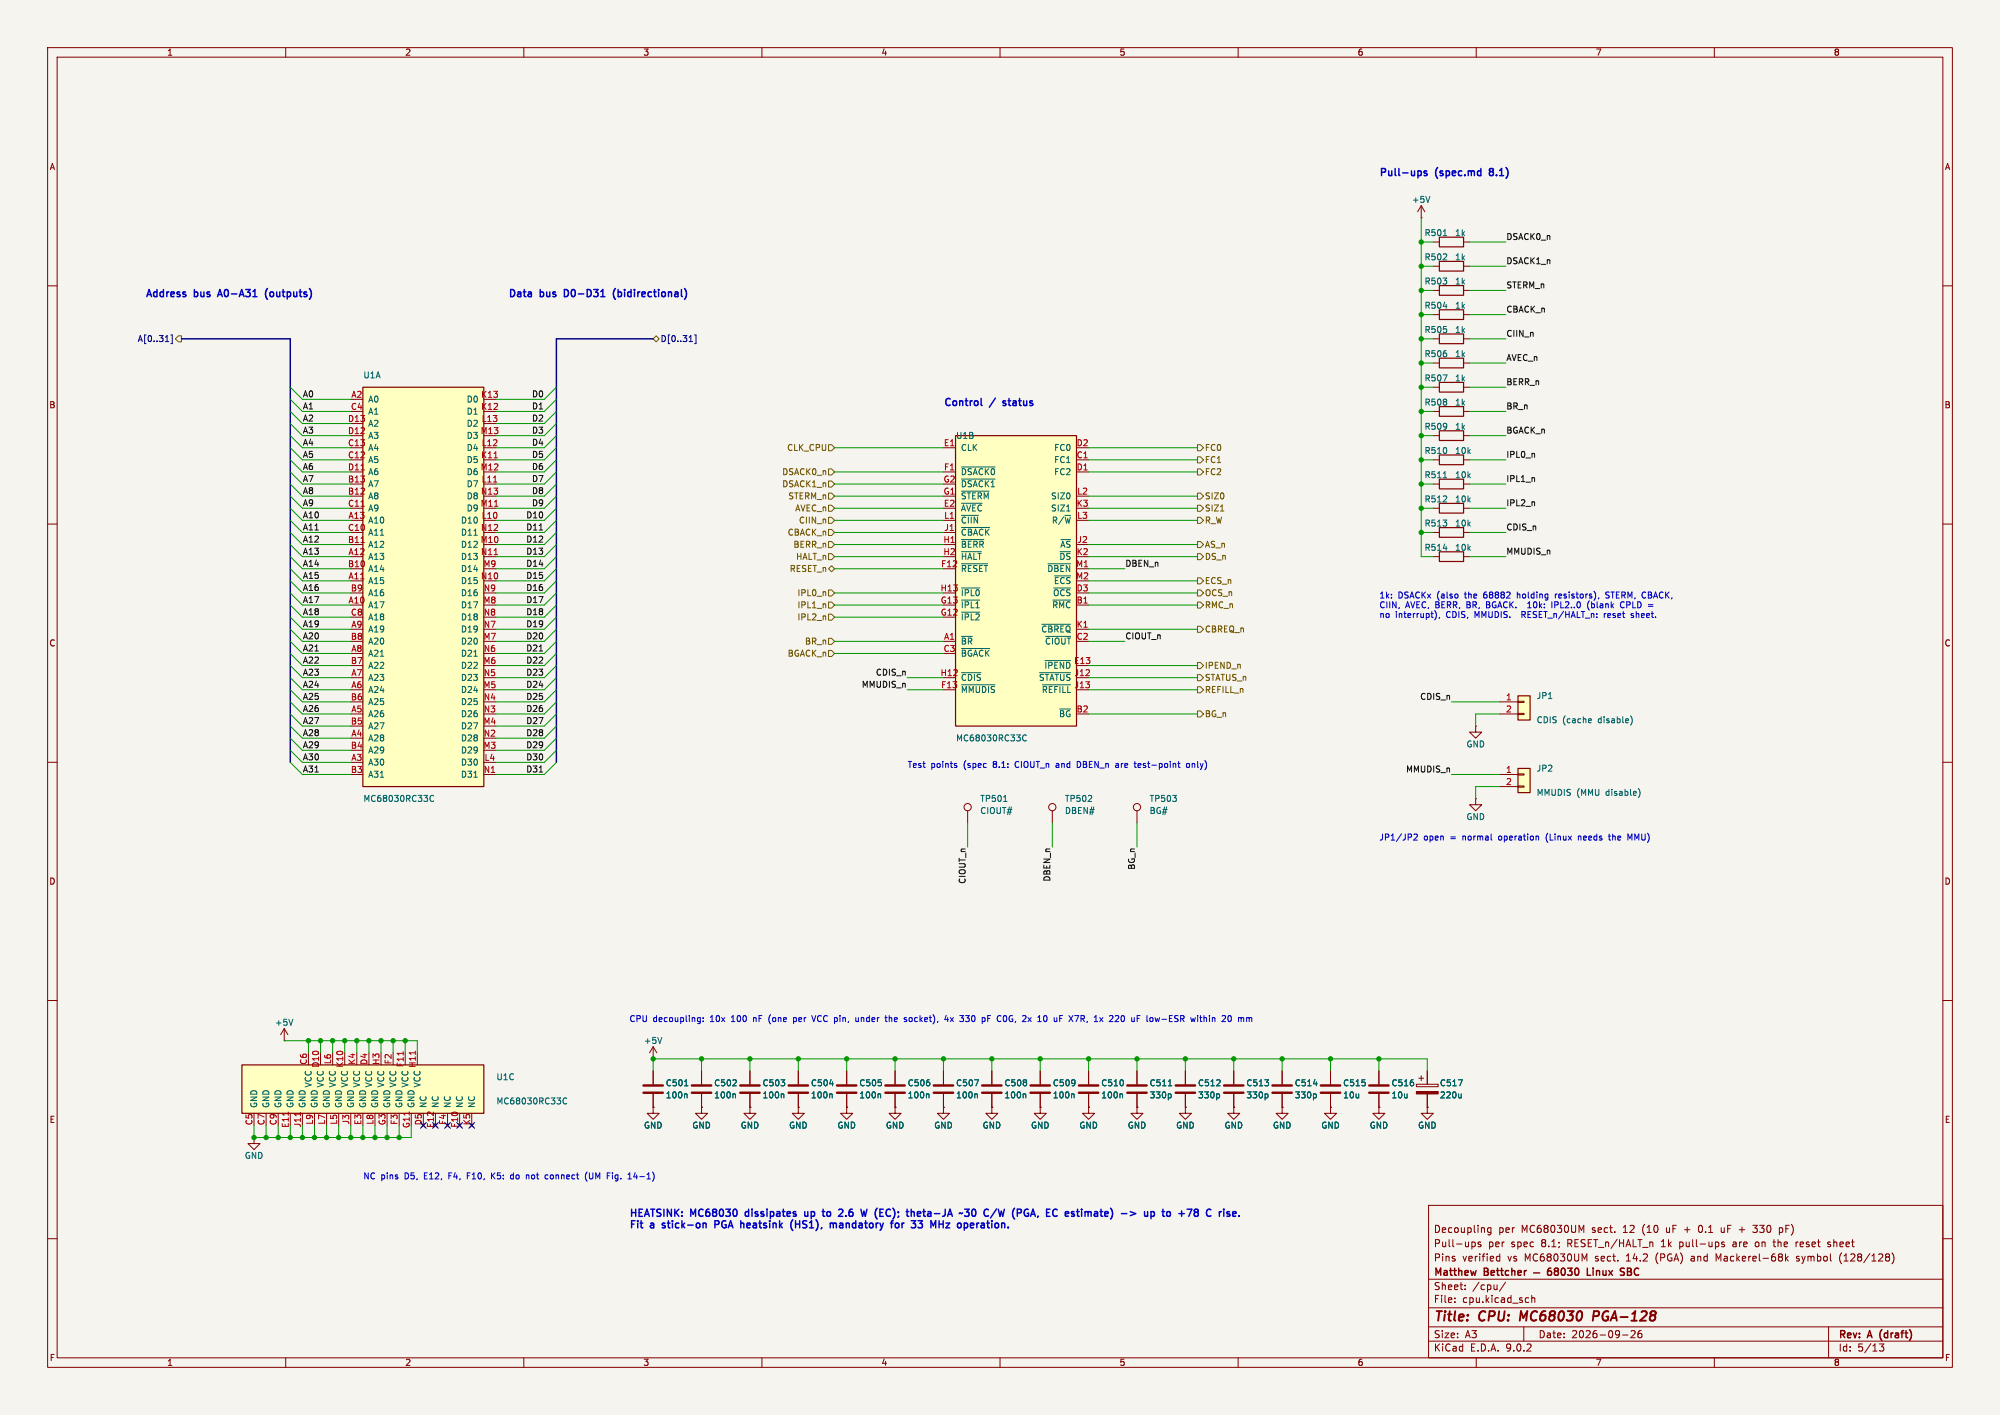
[picture p32: page 5]

NC pins D5, E12, F4, F10, K5: do not connect (UM Fig. 14-1)

Id: 5/13 Title: CPU: MC68030 PGA-128

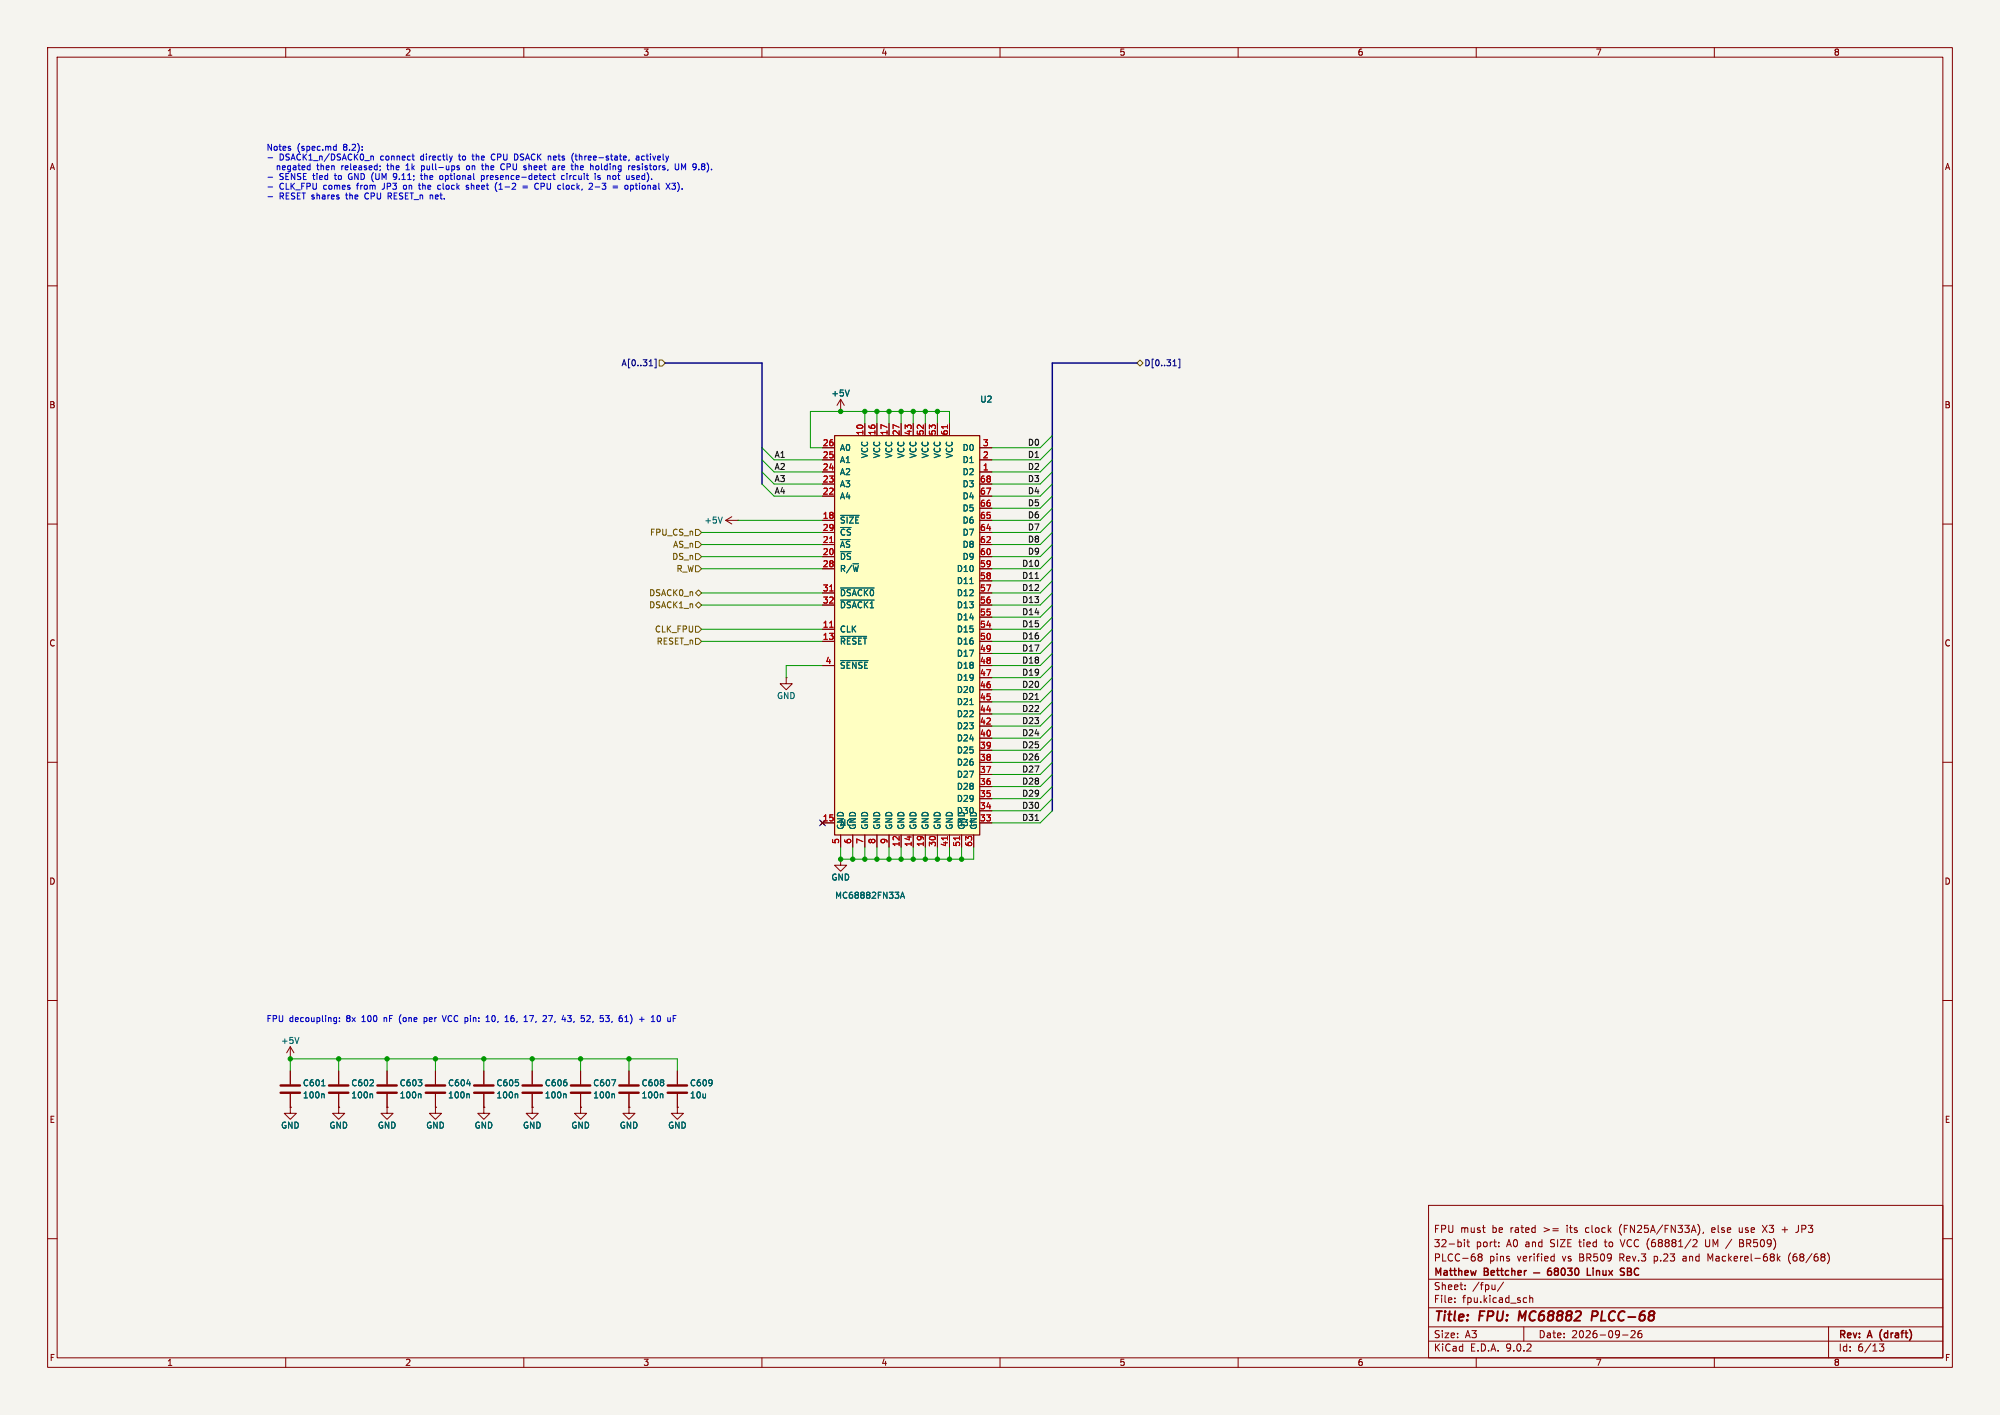
[picture p33: page 6]

9 VCC 27 GND 12 VCC 43 GND 14 VCC 52 GND 19 VCC 53 GND 30 VCC 61 GND 41 GND 51 GND 63 D0 3 D1 2 D2 1 D3 68 D4 67 D5 66 D6 65 D7 64 D8 62 D9 60 D10 59 D11 58 D12 57 D13 56 D14 55 D15 54 D16 50 D17 49 D18 48 D19 47 D20 46 D21 45 D22 44 D23 42 D24 40 D25 39 D26 38 D27 37 D28 36 D29 35 D30 34 D31 33U2 MC68882FN33A

9 VCC 27 GND 12 VCC 43 GND 14 VCC 52 GND 19 VCC 53 GND 30 VCC 61 GND 41 GND 51 GND 63 D0 3 D1 2 D2 1 D3 68 D4 67 D5 66 D6 65 D7 64 D8 62 D9 60 D10 59 D11 58 D12 57 D13 56 D14 55 D15 54 D16 50 D17 49 D18 48 D19 47 D20 46 D21 45 D22 44 D23 42 D24 40 D25 39 D26 38 D27 37 D28 36 D29 35 D30 34 D31 33

Id: 6/13 Title: FPU: MC68882 PLCC-68

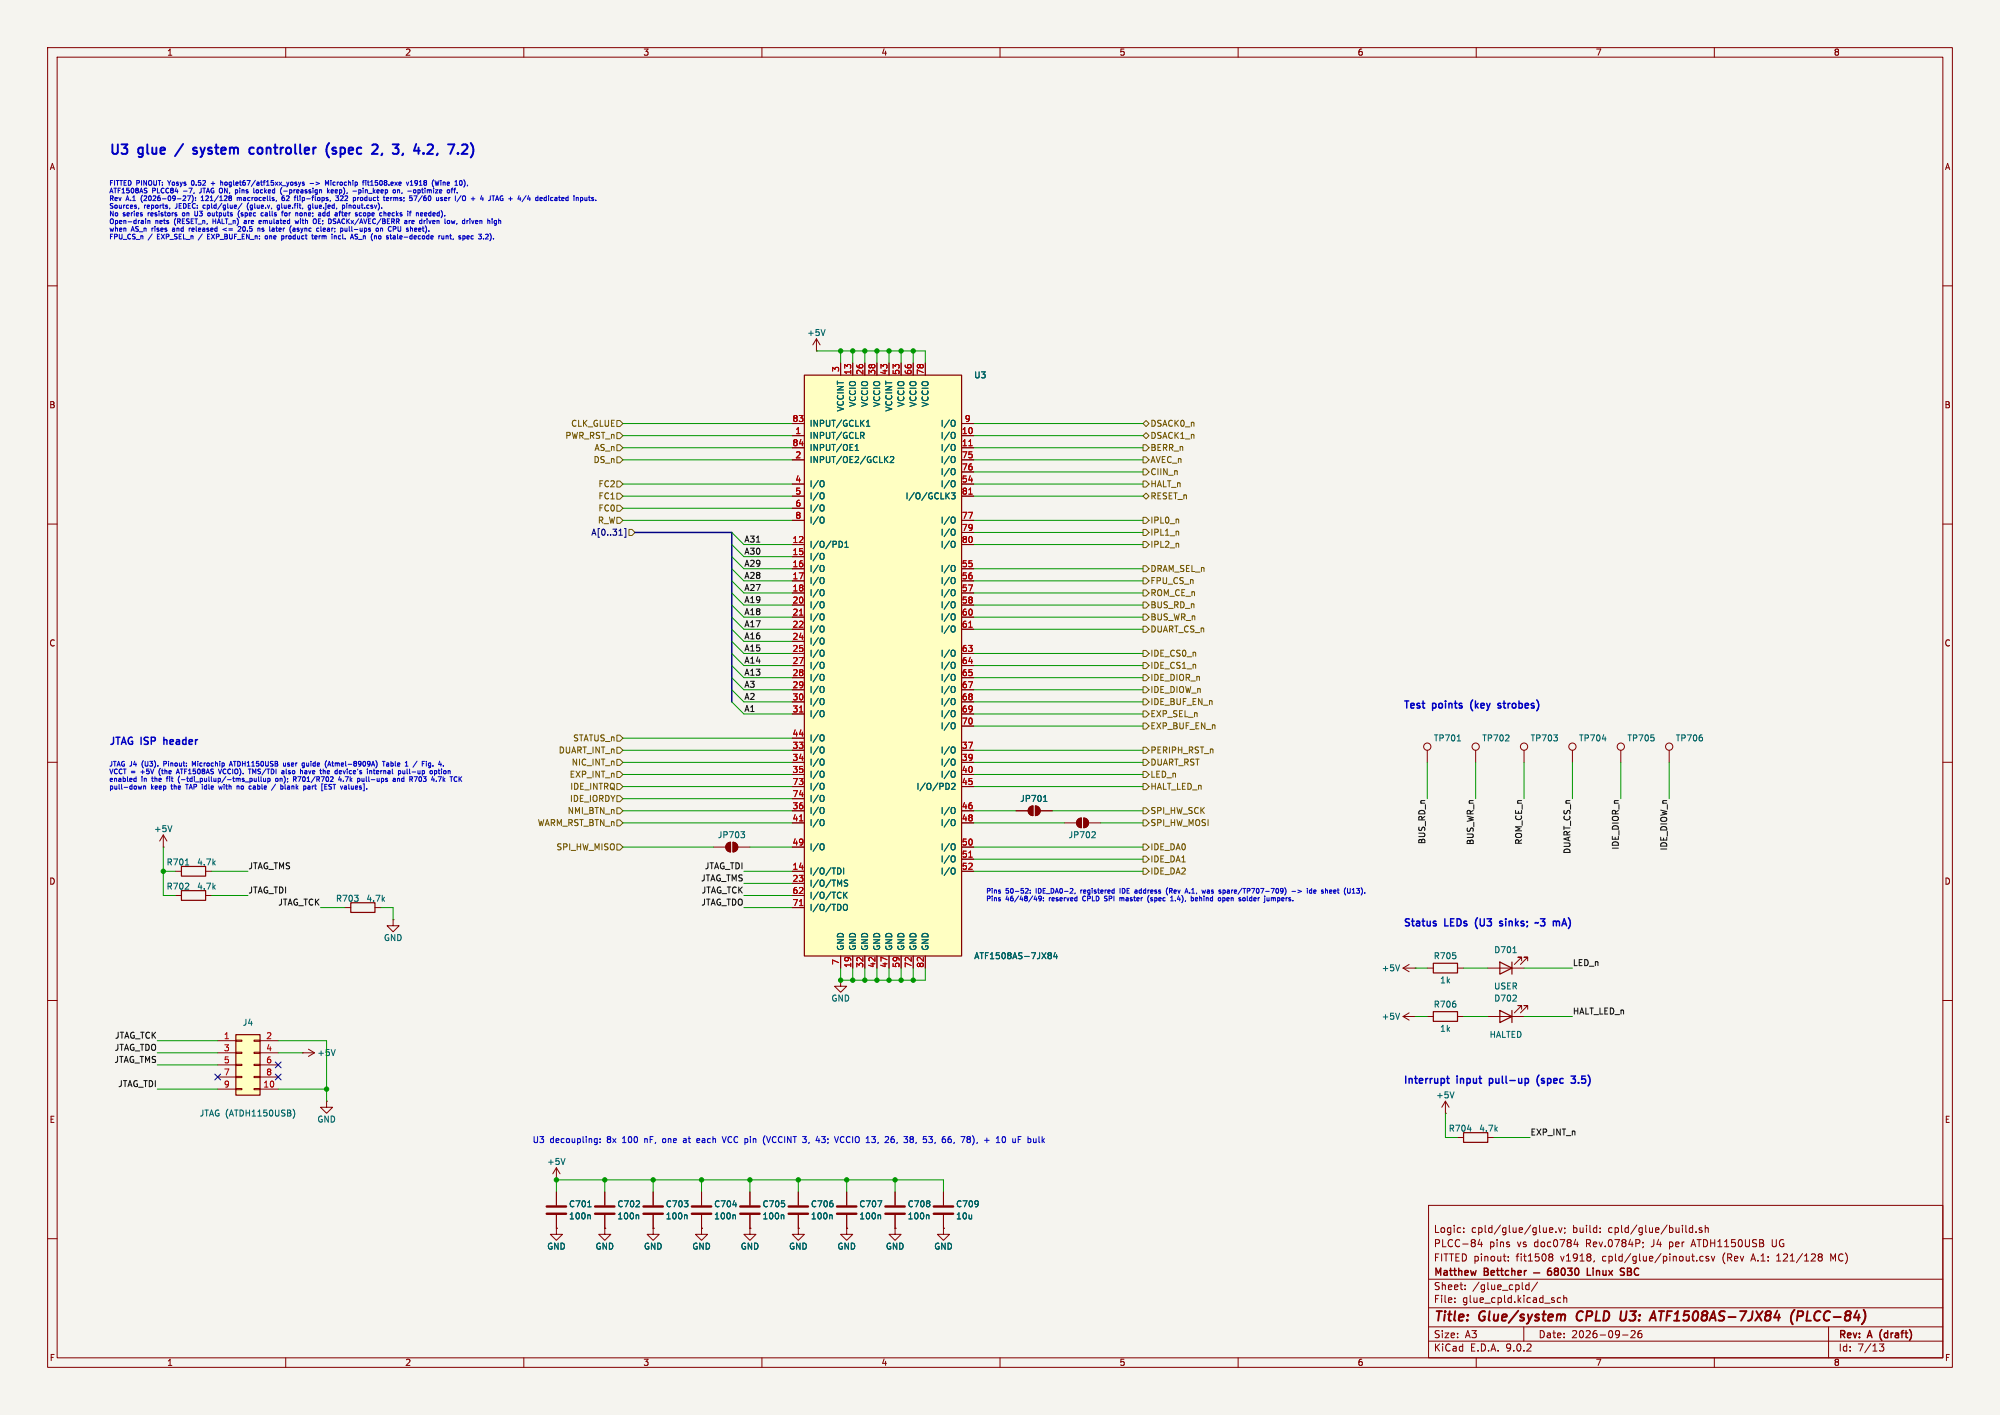
[picture p34: page 7]

7 VCCIO 13 GND 19 VCCIO 26 GND 32 VCCIO 38 GND 42 VCCINT 43 GND 47 VCCIO 53 GND 59 VCCIO 66 GND 72 VCCIO 78 GND 82
U3ATF1508AS-7JX84

Test points (key strobes) C702

FITTED | pinout: fit1508 | pins vs doc0784 | v1918, cpld/glue/pinout.csv | Rev.0784P; | J4 | per ATDH1150USB UG | (Rev A.1: | 121/128 MC) PLCC-84

Bettcher þÿ 68030 | CPLD U3: ATF1508AS-7JX84 Linux SBC (PLCC-84) File: glue_cpld.kicad_sch Sheet: /glue_cpld/ Matthew Id: 7/13 Title: Glue/system

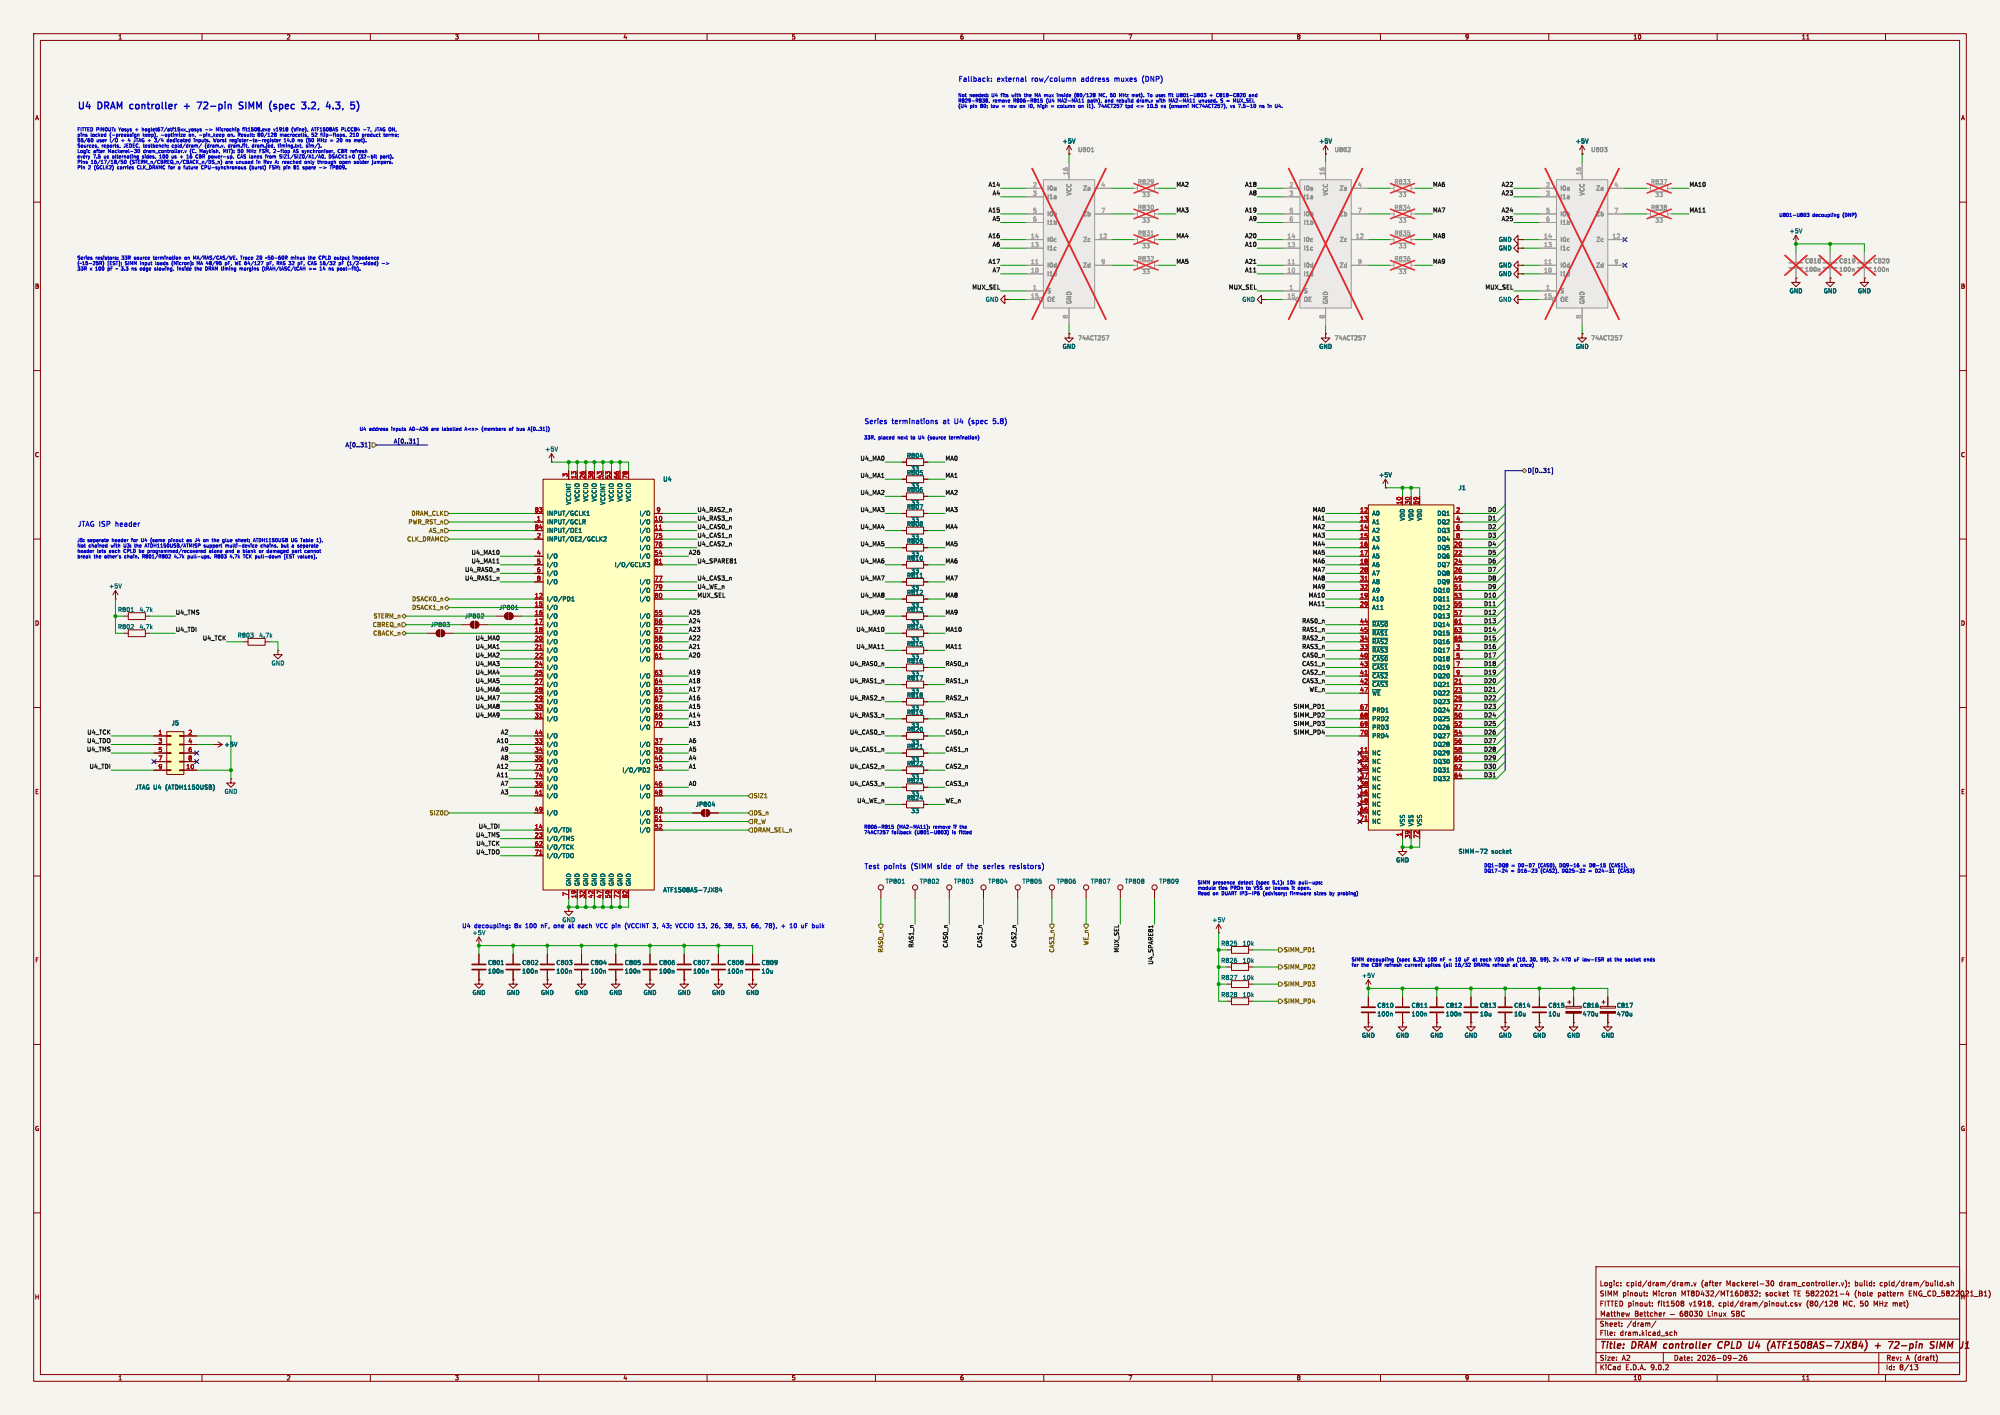
[picture p35: page 8]

7 VCCIO 13 GND 19 VCCIO 26 GND 32 VCCIO 38 GND 42 VCCINT 43 GND 47 VCCIO 53 GND 59 VCCIO 66 GND 72 VCCIO 78 GND 82
U4ATF1508AS-7JX84

1 VDD 30 VSS 39 VDD 59 VSS 72 DQ1

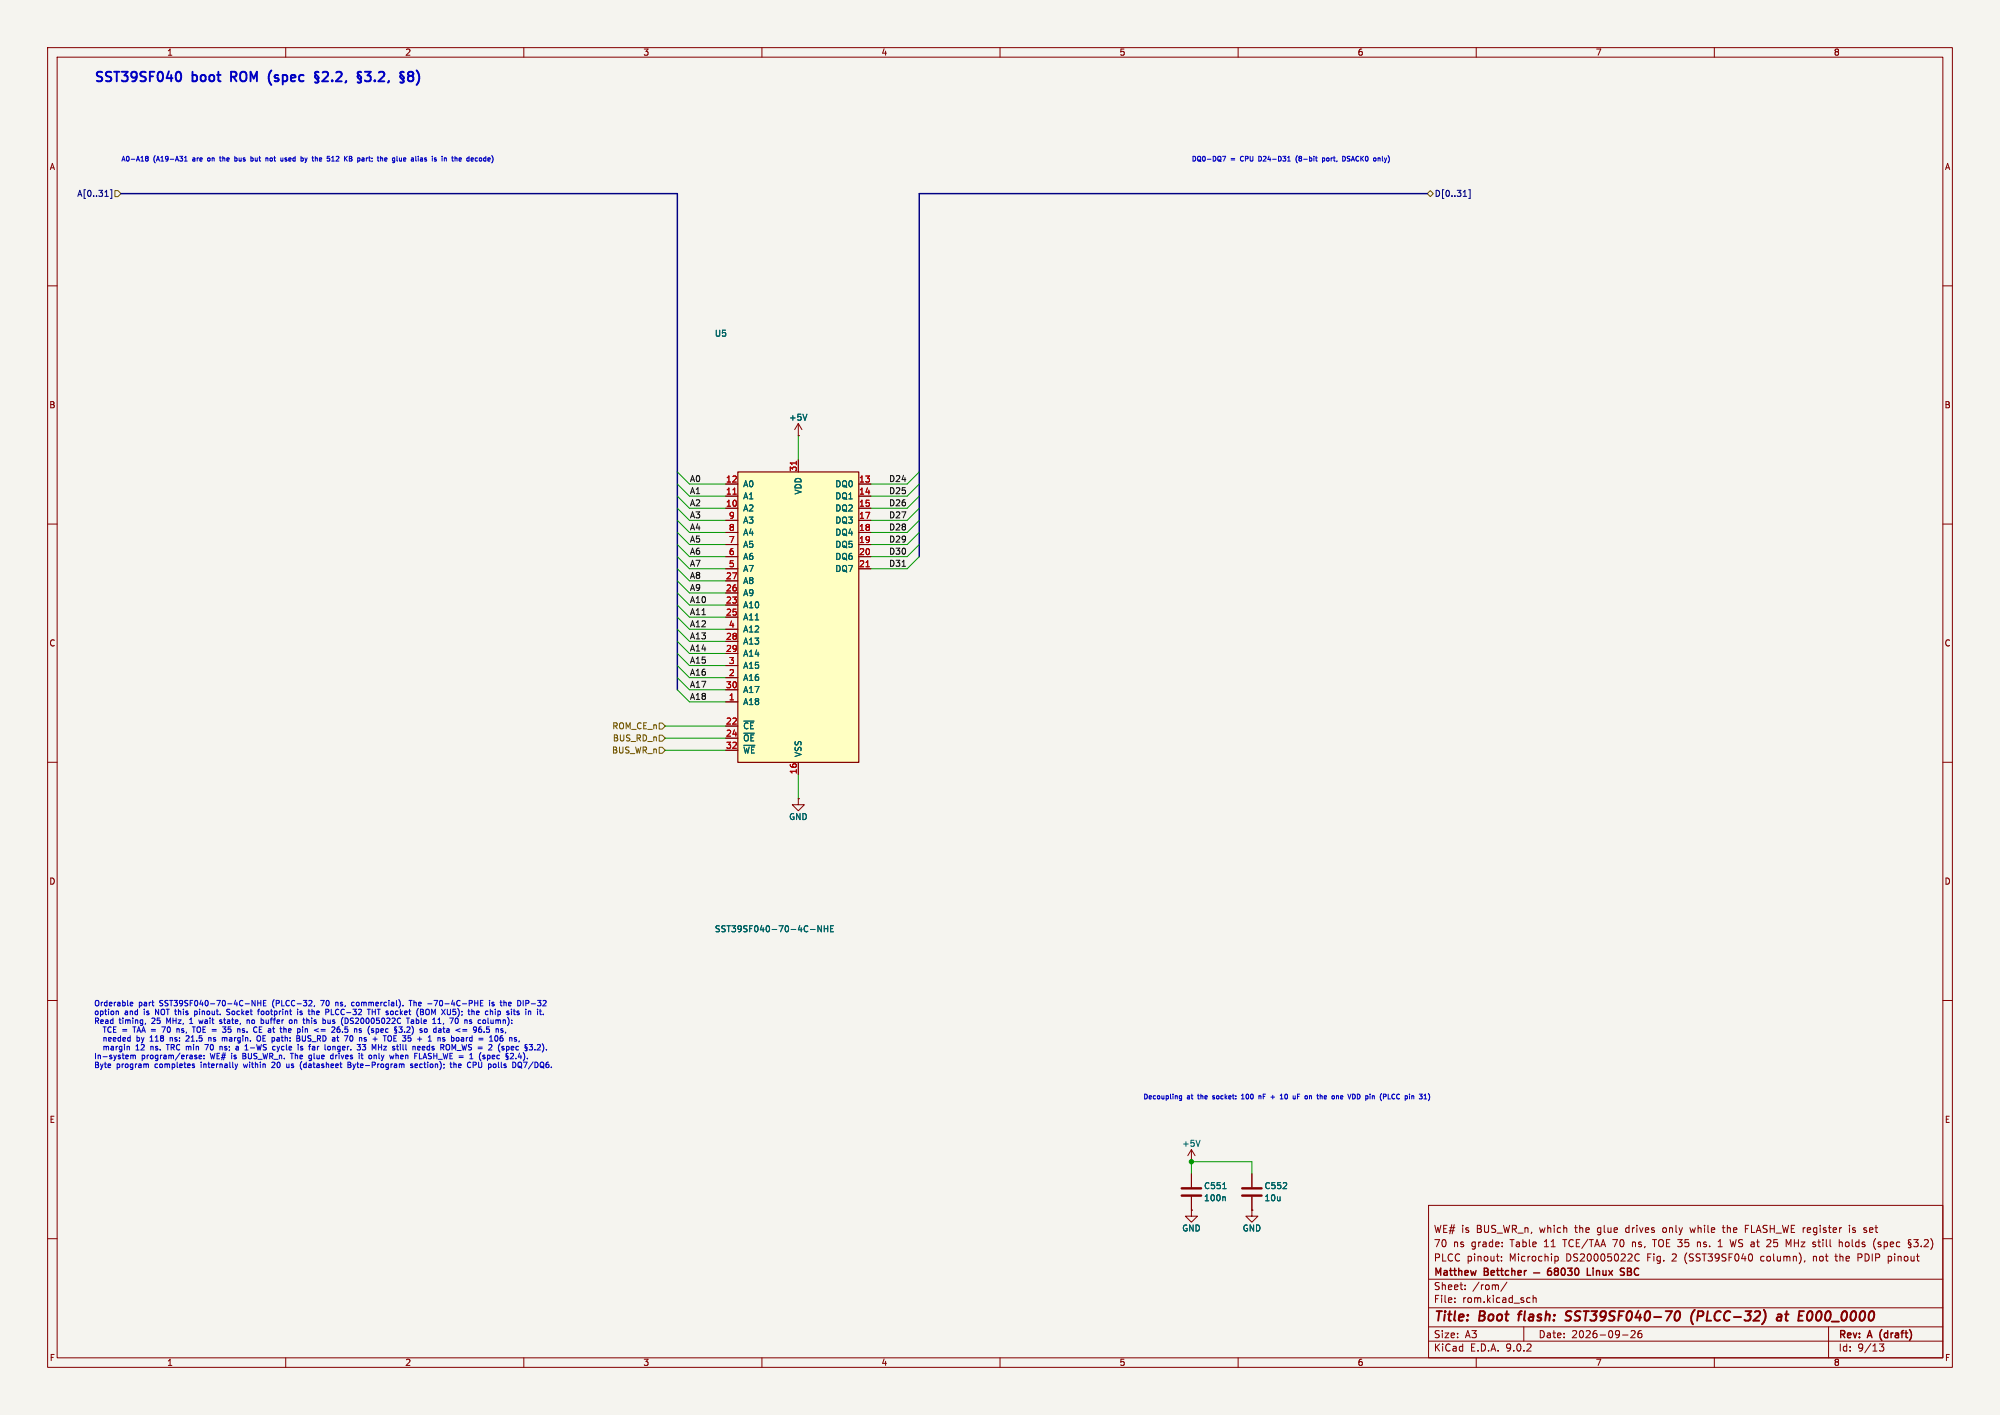
[picture p36: page 9]

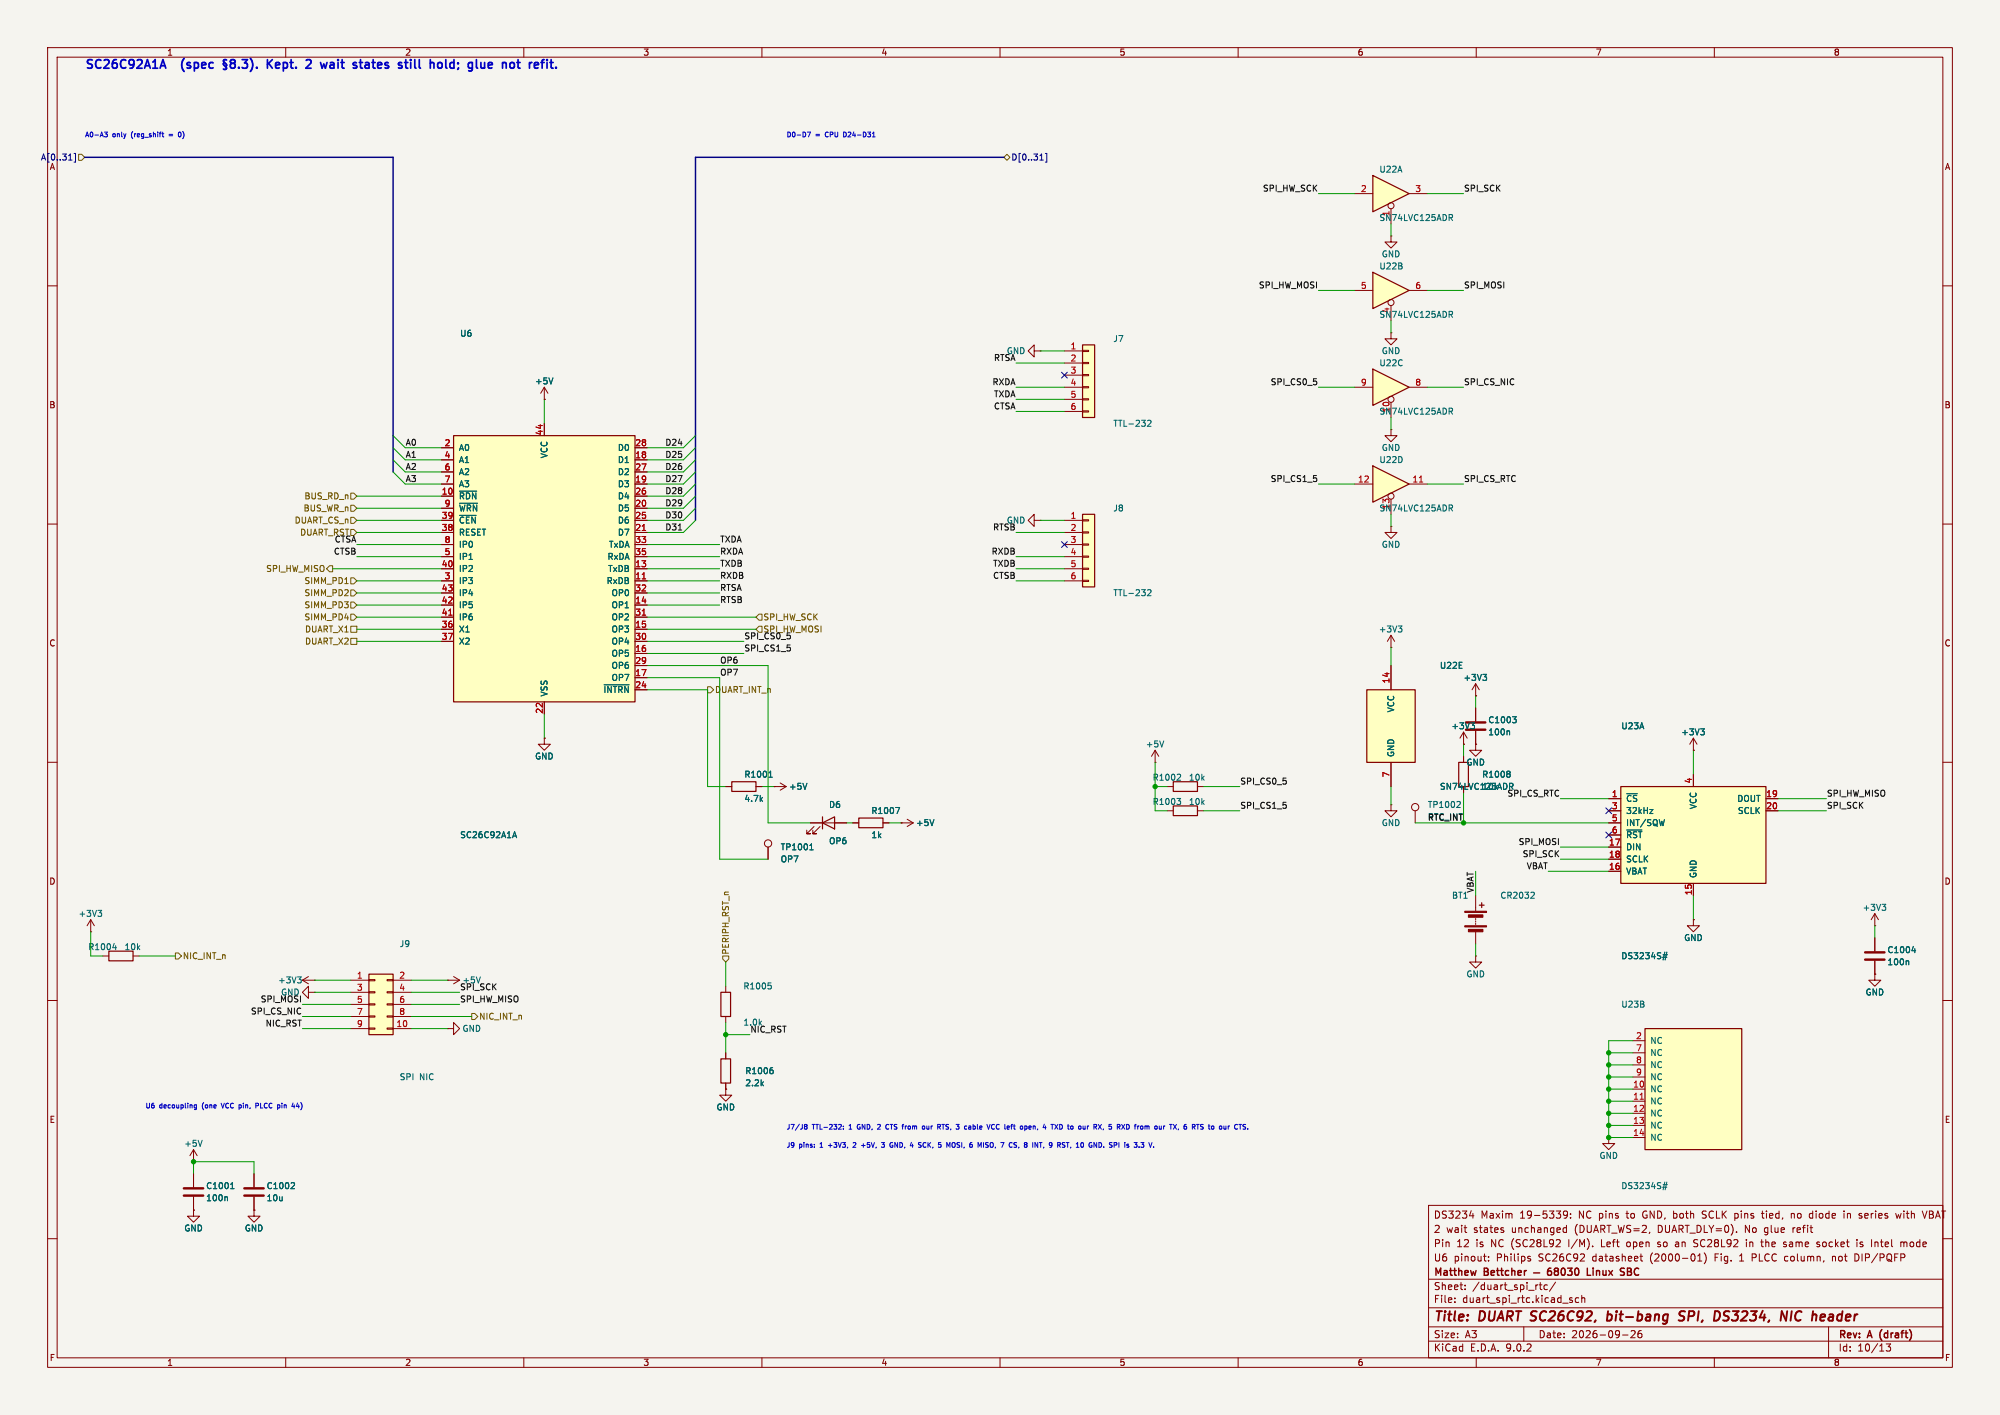
[picture p37: page 10]

A0 2 A1 4 A2 6 A3 7 ~{RDN} 10 ~{WRN} 9 ~{CEN} 39 RESET 38

+5V GND

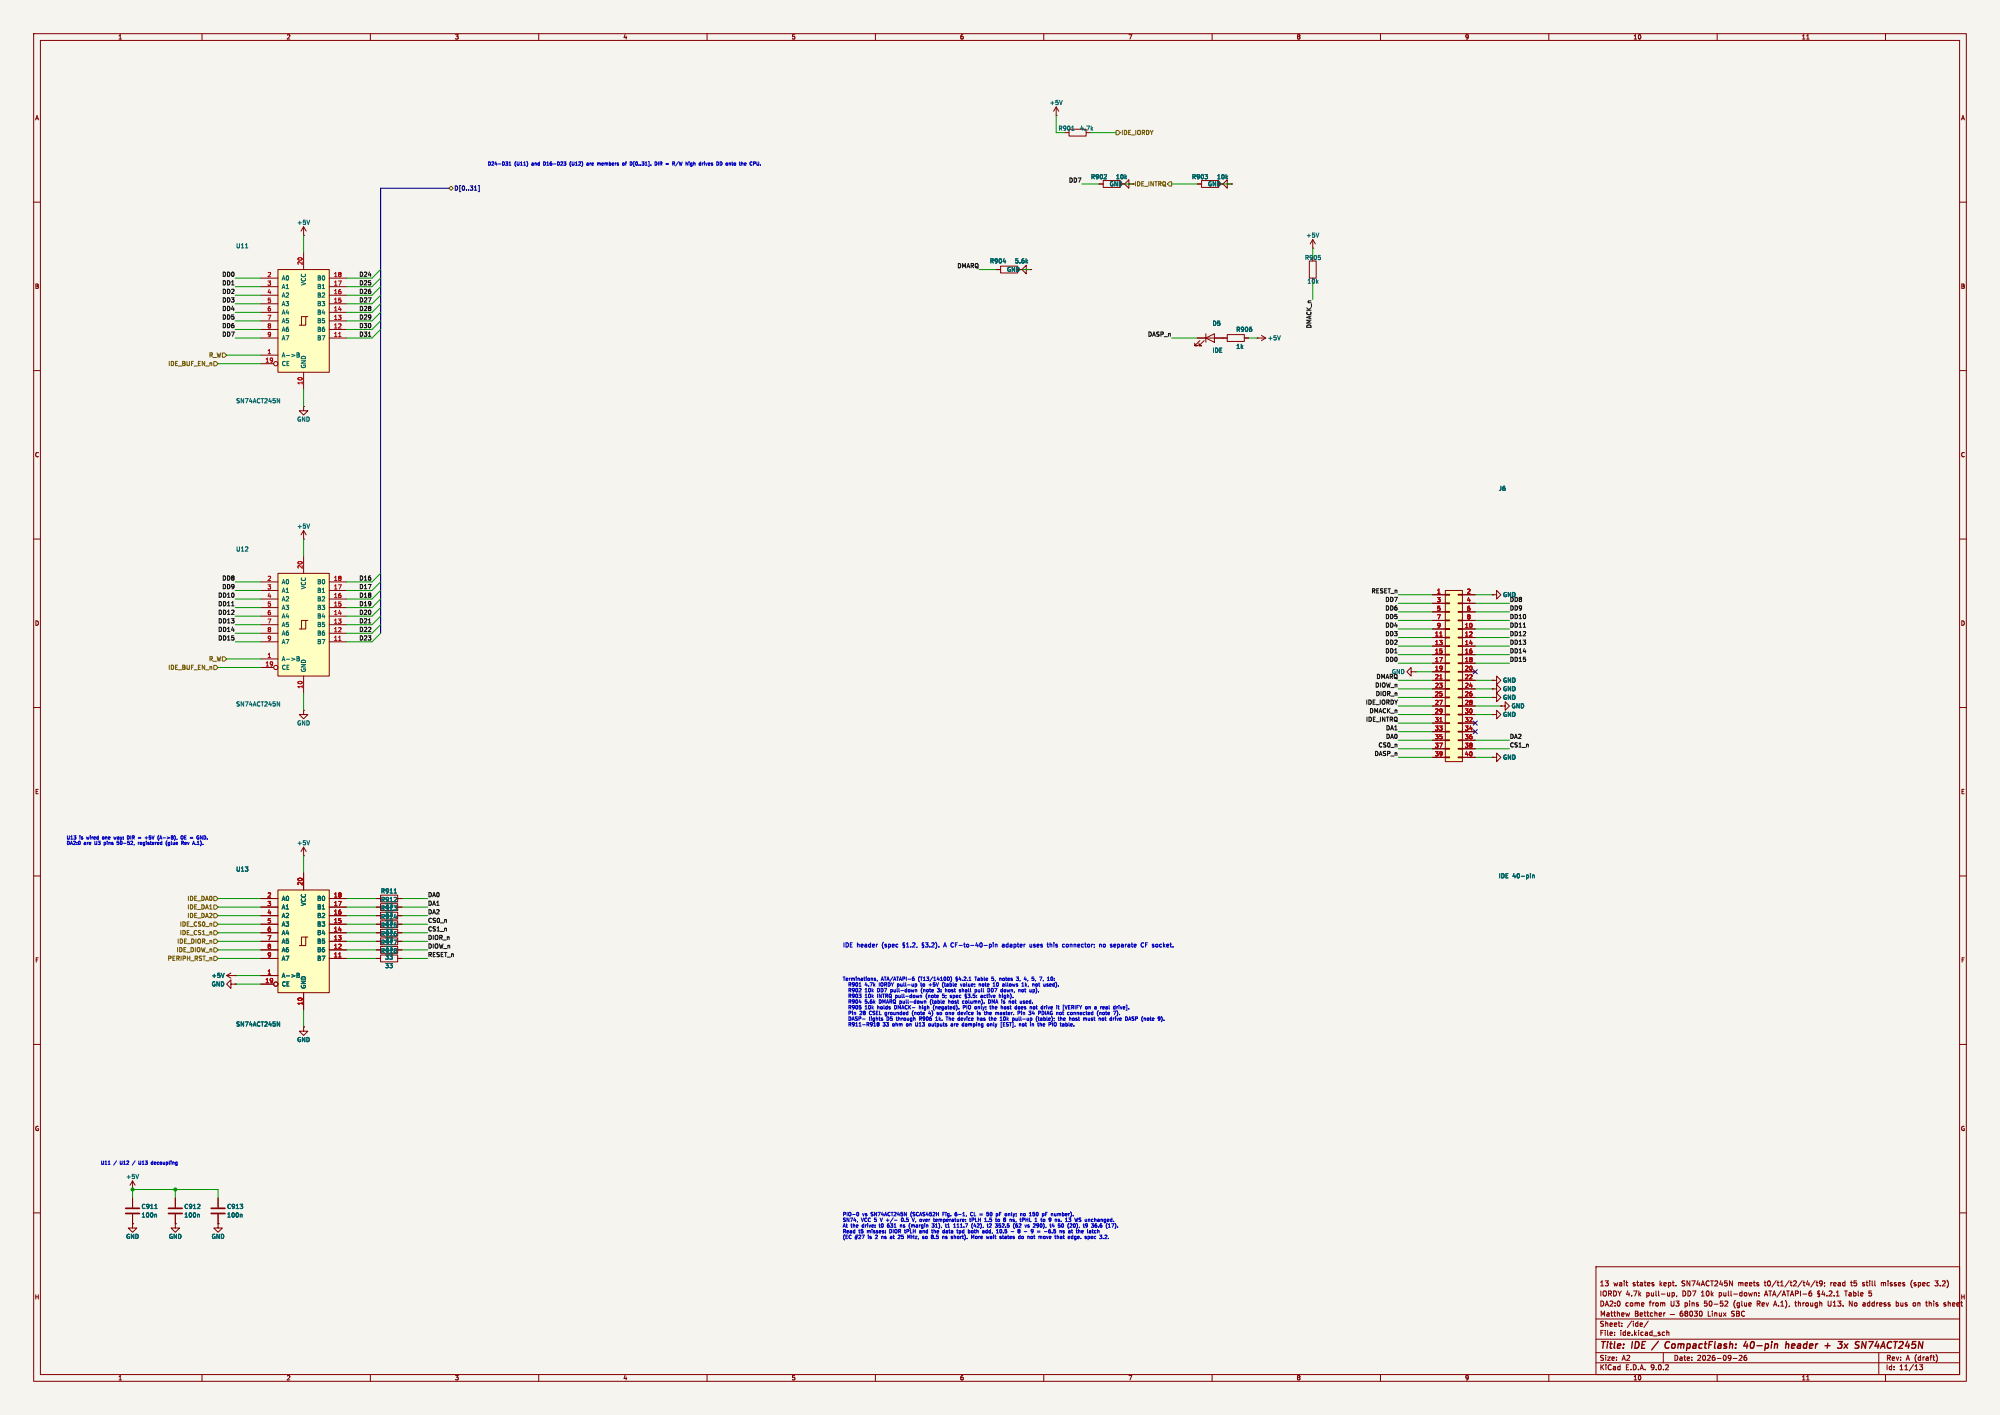
[picture p38: page 11]

IDE 40-pin GND GND

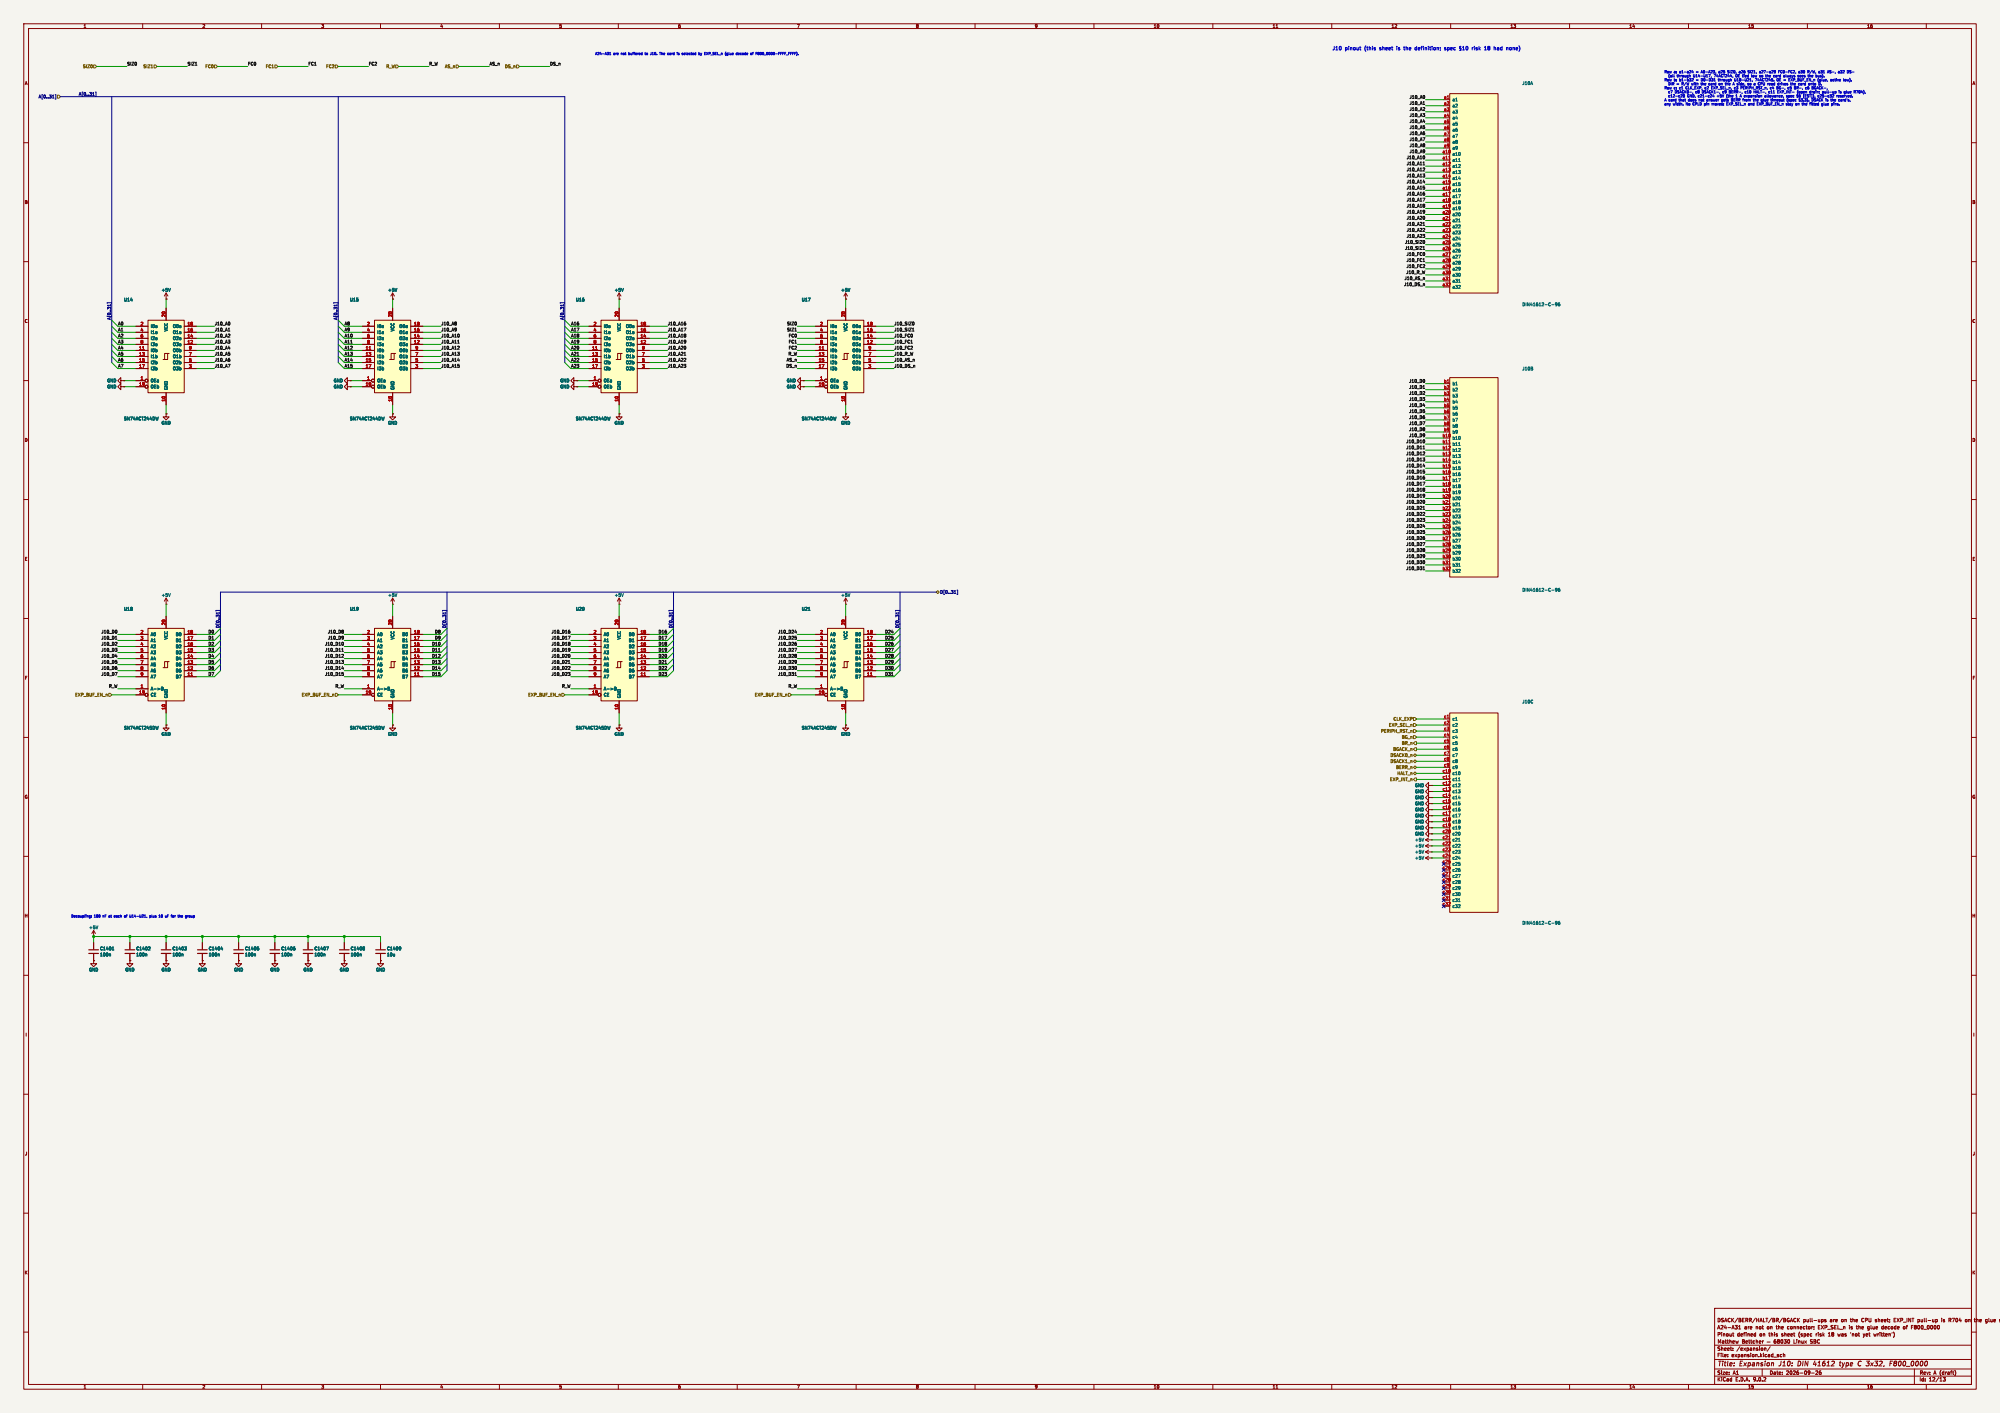
[picture p39: page 12]

+5V GND GND GND GND

GND GND GND GND GND GND GND GND GND
GND

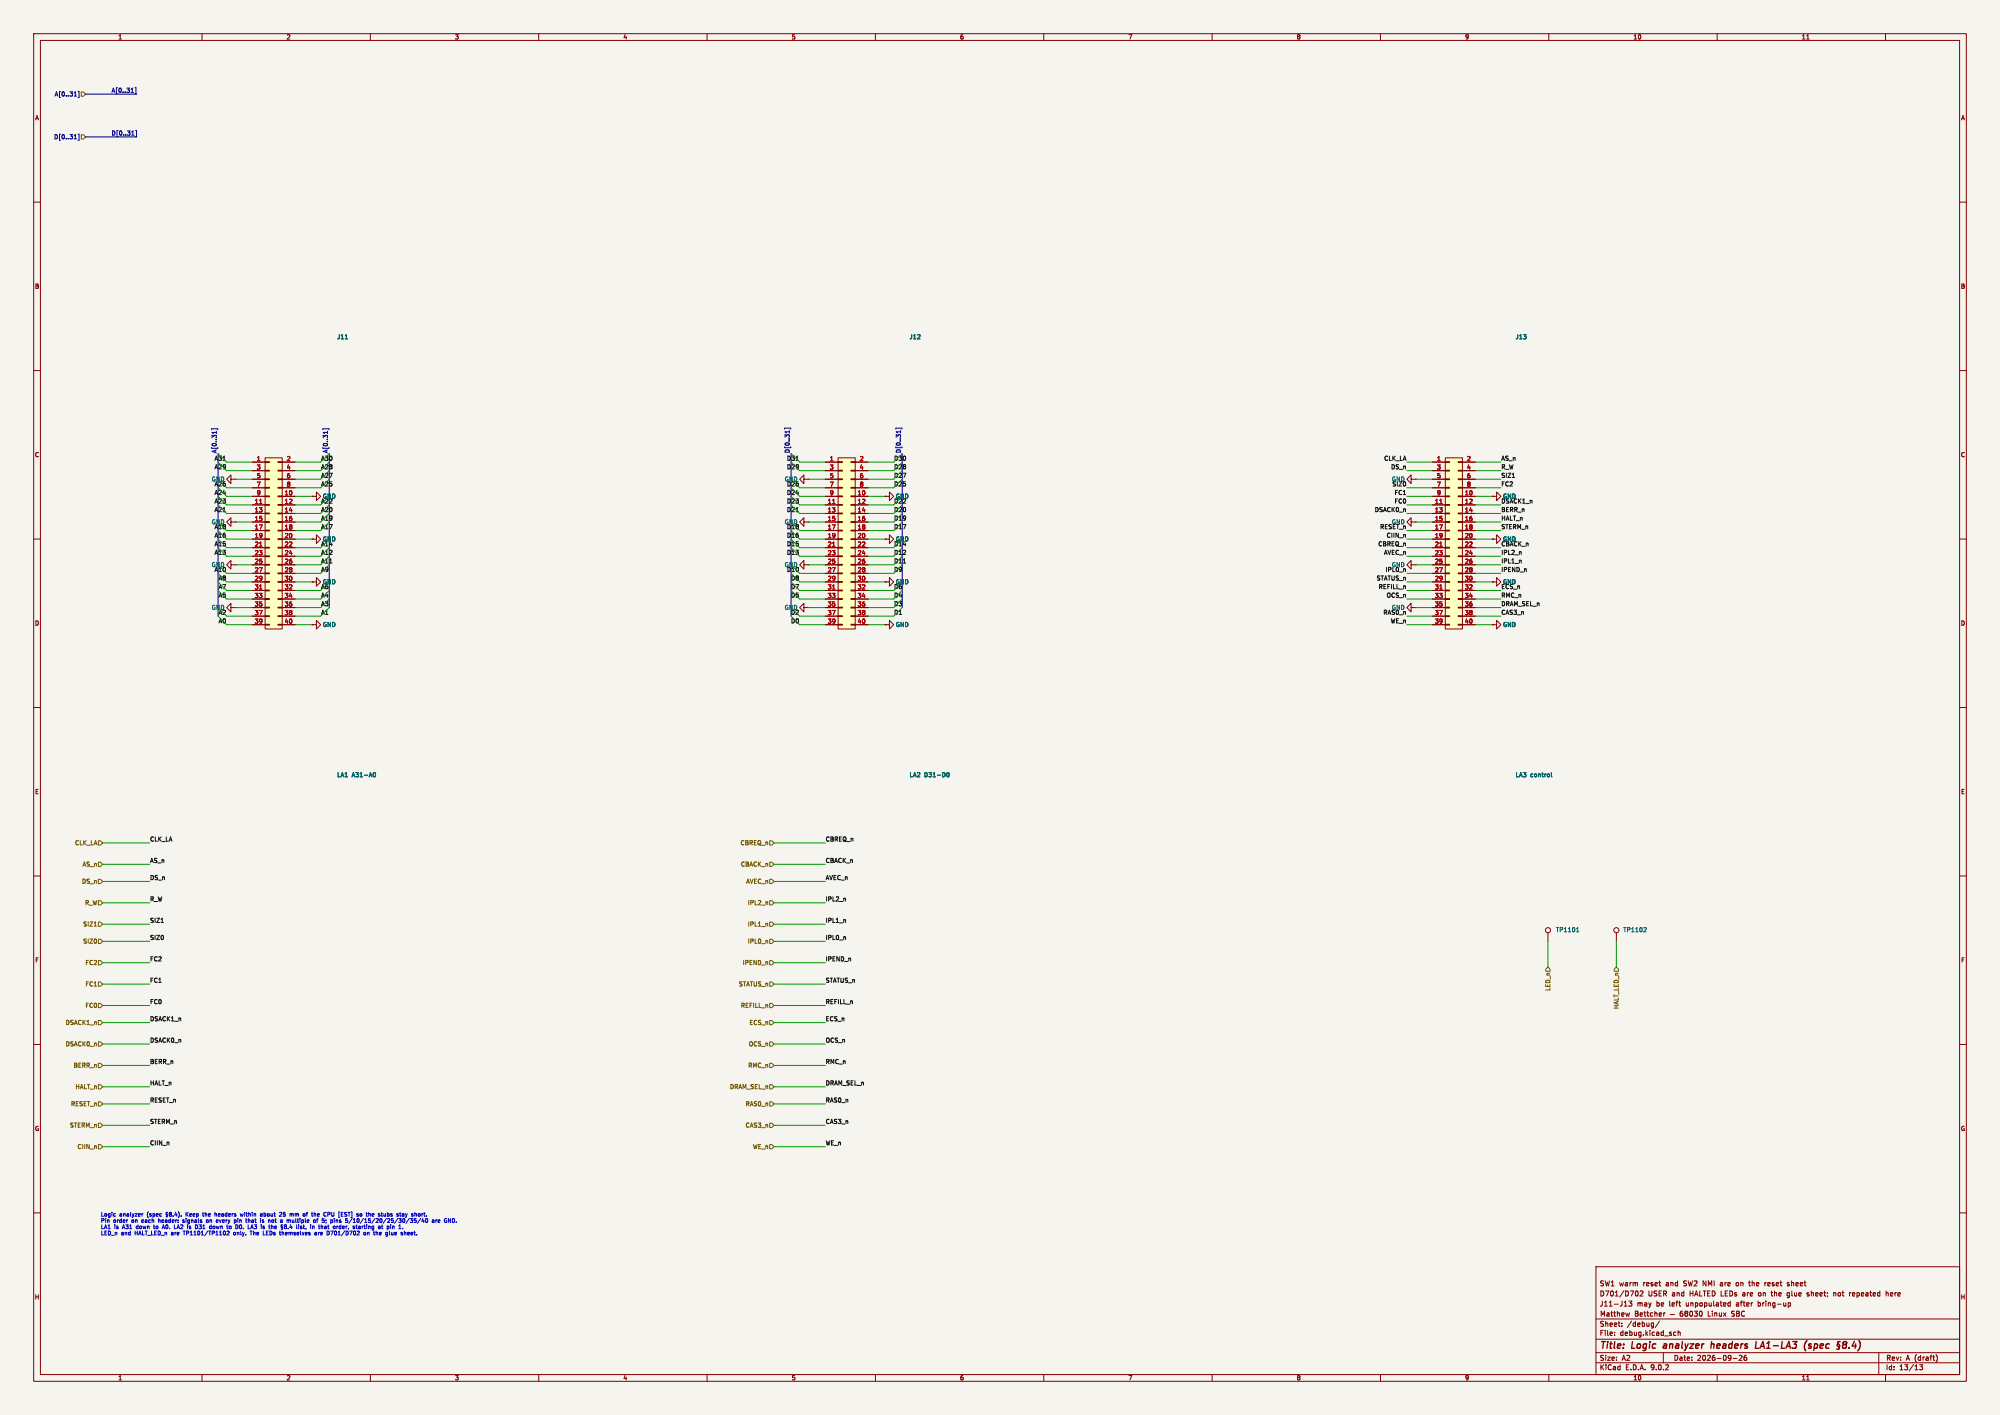
[picture p40: page 13]

SIZ1 A16 A18 A21 A23 A29 A26 A24
LA1 A31-A0 GND GND GND GND GND GND GND GND
