mattbettcher/m68030-sbc/68030-design/kicad/m68030-sbc.kicad_pcb

## KiCad design 68030-design/kicad/m68030-sbc.kicad_pcb (2026-10-18)

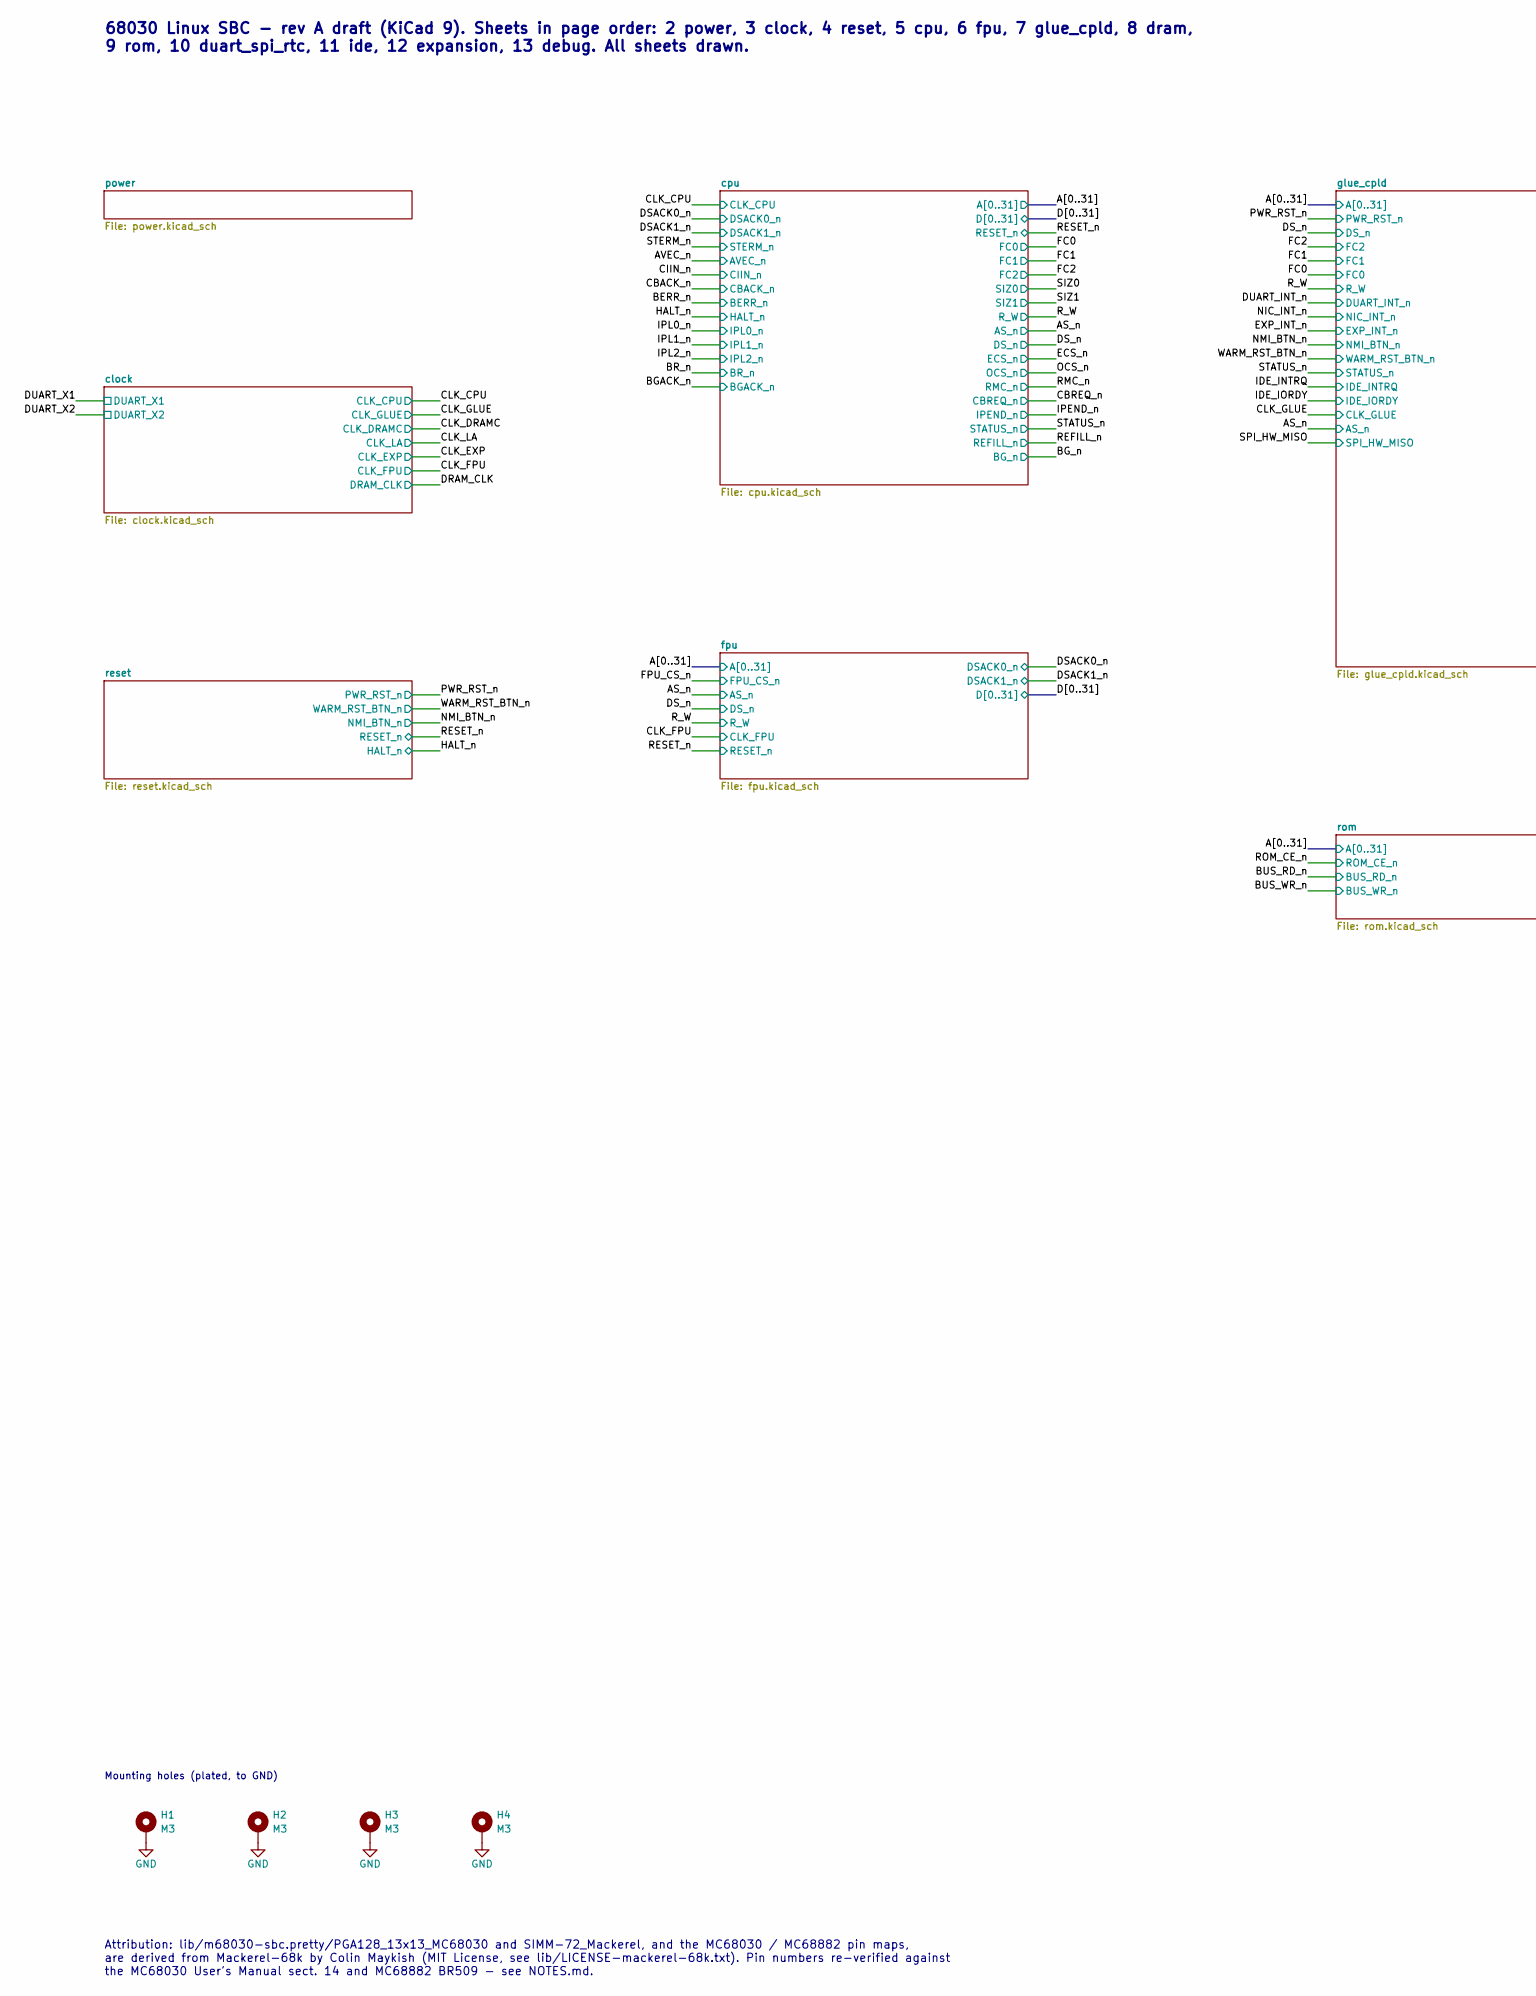
[picture p41: schematic m68030-sbc.kicad_sch, 68030 Linux SBC — top level, part in row 1, column 1]

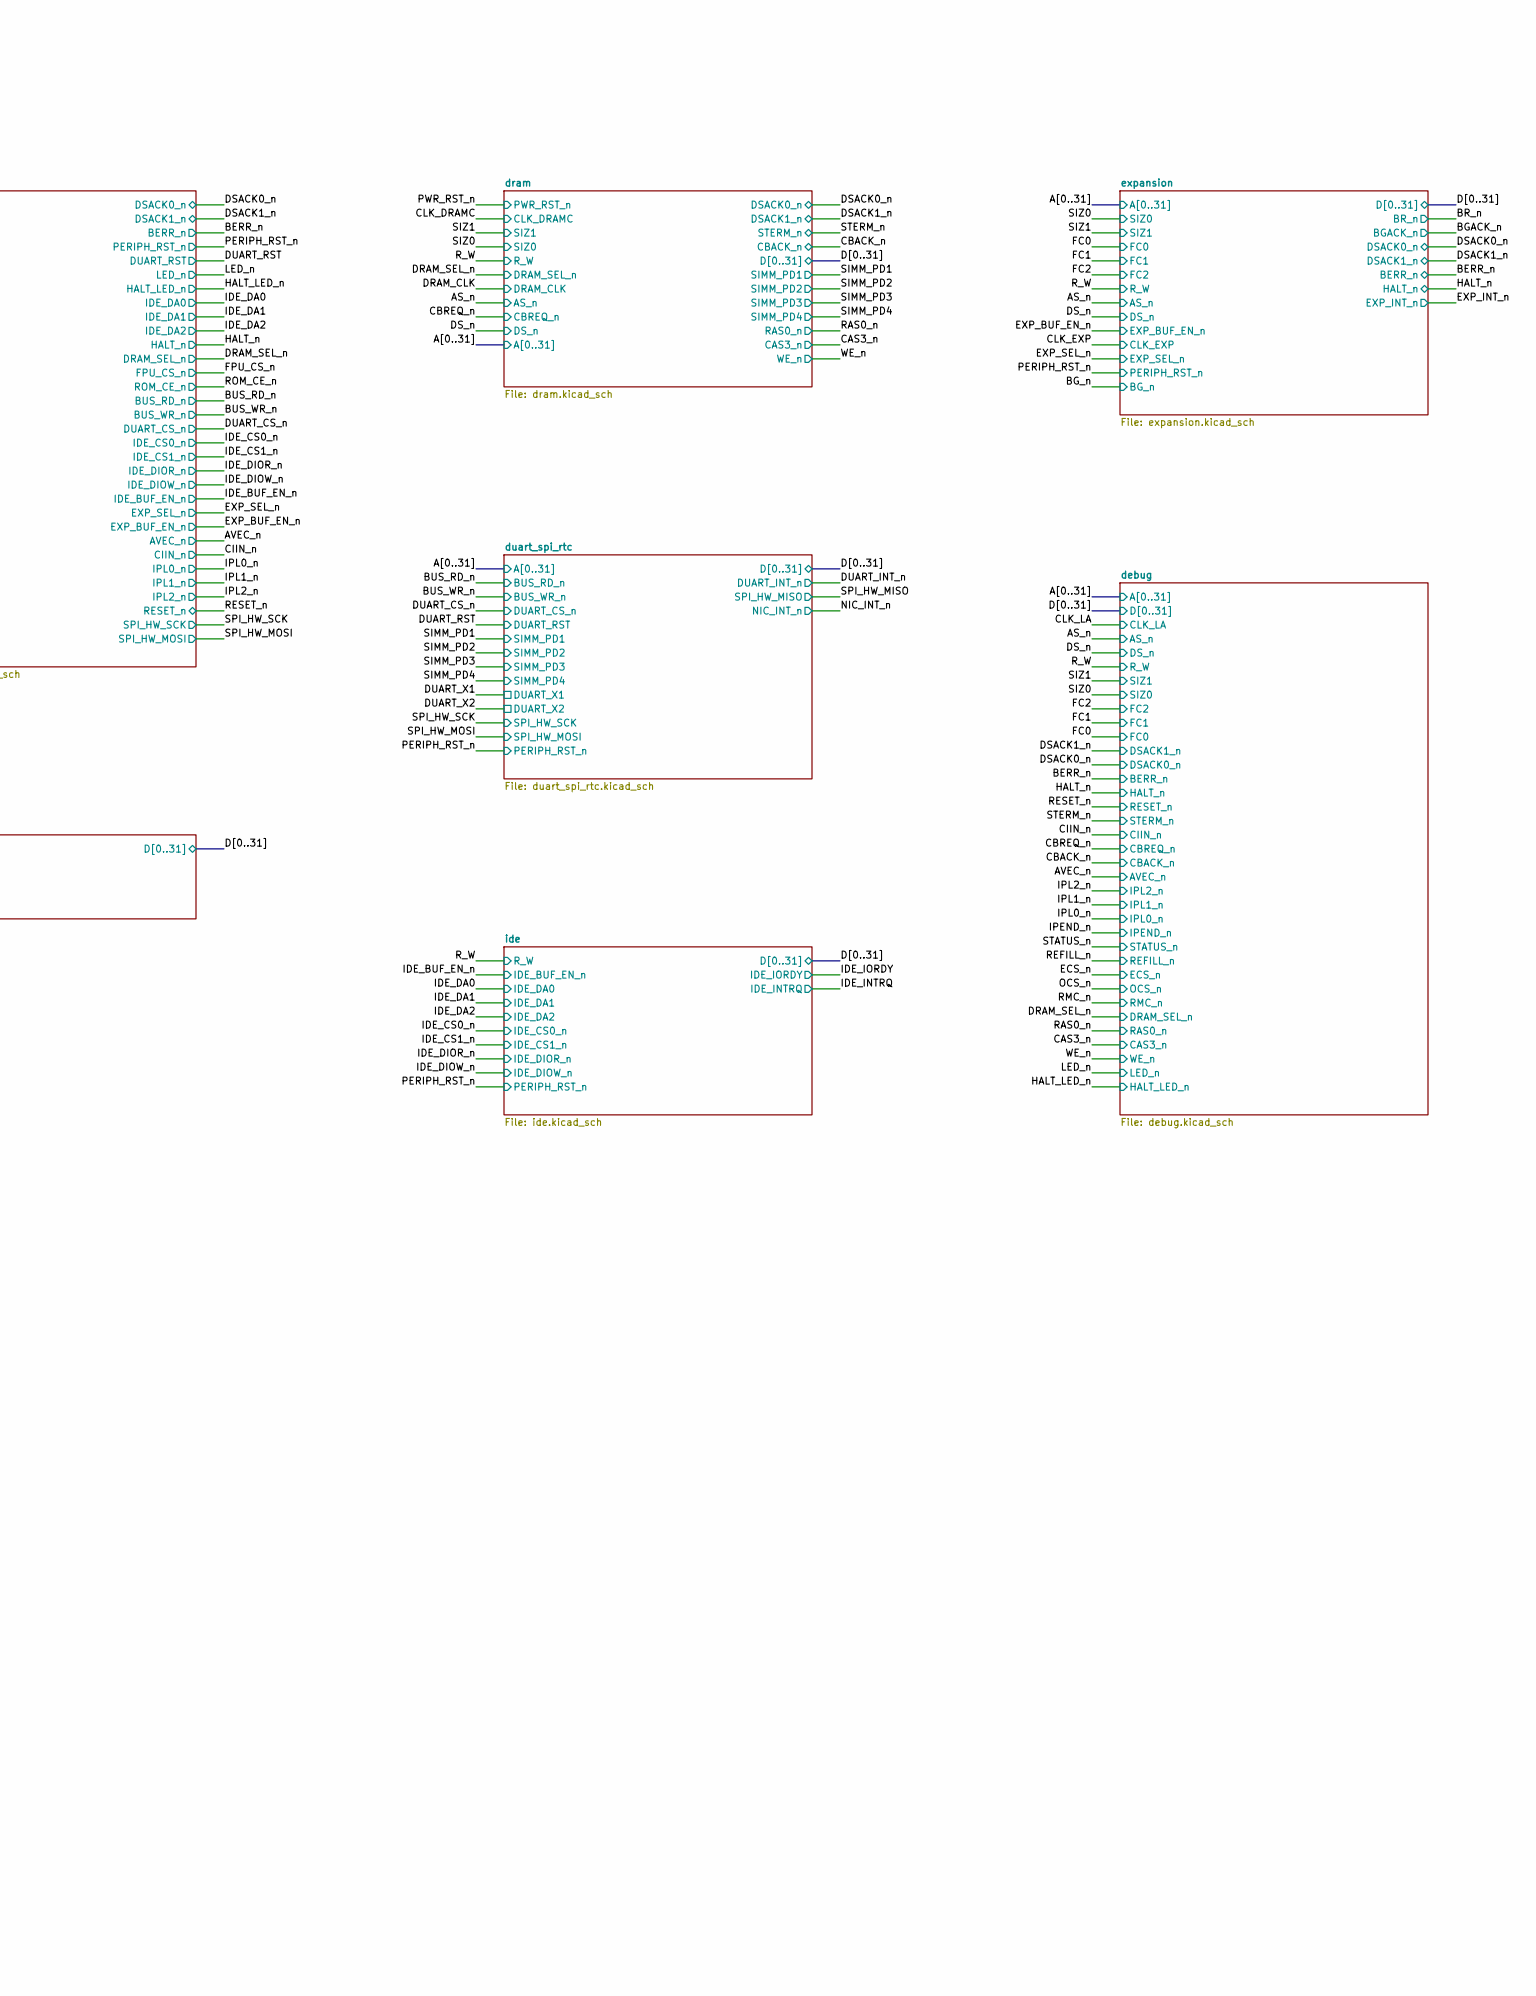
[picture p42: schematic m68030-sbc.kicad_sch, 68030 Linux SBC — top level, part in row 1, column 2]

Parts:
H1, H2, H3, H4: M3; MountingHole_3.2mm_M3_Pad

Connections:
GND: H1.1, H2.1, H3.1, H4.1; also elsewhere on the board

Notes on the sheet:
68030 Linux SBC - rev A draft (KiCad 9). Sheets in page order: 2 power, 3 clock, 4 reset, 5 cpu, 6 fpu, 7 glue_cpld, 8 dram, 9 rom, 10 duart_spi_rtc, 11 ide, 12 expansion, 13 debug. All sheets drawn.
Attribution: lib/m68030-sbc.pretty/PGA128_13x13_MC68030 and SIMM-72_Mackerel, and the MC68030 / MC68882 pin maps, are derived from Mackerel-68k by Colin Maykish (MIT License, see lib/LICENSE-mackerel-68k.txt). Pin numbers re-verified against the MC68030 User's Manual sect. 14 and MC68882 BR509 - se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
Mounting holes (plated, to GND)

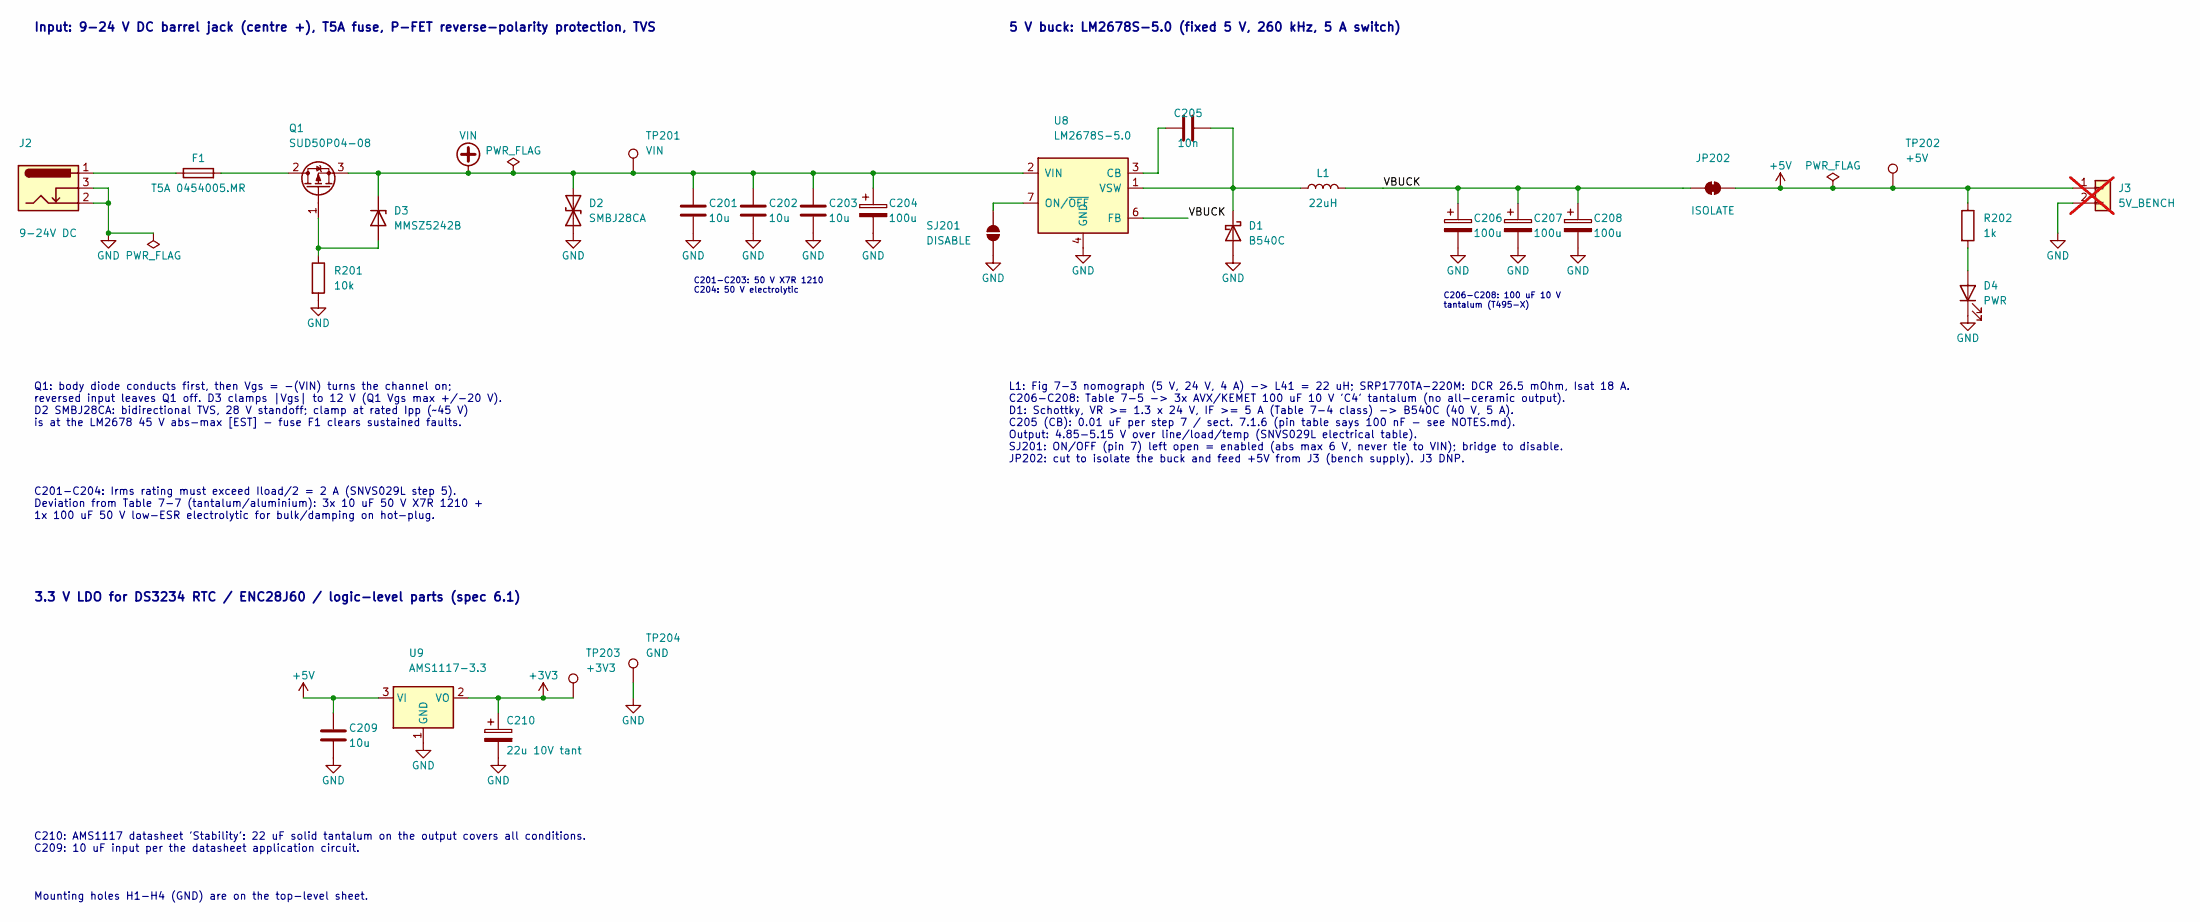
[picture p43: schematic power.kicad_sch, Power: 9-24 V input, LM2678-5.0 buck, 3.3 V LDO]

Parts:
C201, C202, C203: 10u; C_1210_3225Metric; Rating 10 uF 50 V X7R 1210
C204: 100u; CP_Elec_10x10.5; Rating 100 uF 50 V low-ESR aluminium, 10x10.5
C205: 10n; C_0603_1608Metric
C206, C207, C208: 100u; CP_EIA-7343-43_Kemet-X; Rating 100 uF 10 V tantalum; MPN KEMET T495X107K010ATE100 [VERIFY]
C209: 10u; C_1206_3216Metric
C210: 22u 10V tant; CP_EIA-3528-21_Kemet-B
D1: B540C; D_SMC; MPN B540C-13-F
D2: SMBJ28CA; D_SMB; MPN SMBJ28CA (28 V standoff, bidirectional)
D3: MMSZ5242B; D_SOD-123; MPN MMSZ5242B (12 V)
D4: PWR; LED_0805_2012Metric
F1: T5A 0454005.MR; Fuse_Littelfuse-NANO2-451_453; MPN Littelfuse 0454005.MR
J2: 9-24V DC; BarrelJack_Horizontal
J3: 5V_BENCH; PinHeader_1x02_P2.54mm_Vertical; not fitted
JP202: ISOLATE; SolderJumper-2_P1.3mm_Bridged_RoundedPad1.0x1.5mm
L1: 22uH; L_Bourns_SRP1770TA_16.9x16.9mm; MPN Bourns SRP1770TA-220M
Q1: SUD50P04-08; TO-252-2; MPN SUD50P04-08-GE3
R201: 10k; R_0603_1608Metric
R202: 1k; R_0603_1608Metric
SJ201: DISABLE; SolderJumper-2_P1.3mm_Open_RoundedPad1.0x1.5mm
TP201: VIN; TestPoint_Pad_D1.5mm
TP202: +5V; TestPoint_Pad_D1.5mm
TP203: +3V3; TestPoint_Pad_D1.5mm
TP204: GND; TestPoint_Pad_D1.5mm
U8: LM2678S-5.0; TO-263-7_TabPin4; MPN LM2678S-5.0/NOPB
U9: AMS1117-3.3; SOT-223-3_TabPin2; MPN AMS1117-3.3

Connections:
+3V3: C210.1, TP203.1, U9.2 (VO); also elsewhere on the board
+5V: C209.1, J3.1, JP202.2 (B), R202.1, TP202.1, U9.3 (VI); also elsewhere on the board
/power/VBUCK: C206.1, C207.1, C208.1, JP202.1 (A), L1.2, U8.6 (FB)
GND: C201.2, C202.2, C203.2, C204.2, C206.2, C207.2, C208.2, C209.2, C210.2, D1.2 (A), D2.1 (A1), D4.1 (K), J2.2, J2.3, J3.2, R201.2, SJ201.1 (A), TP204.1, U8.4 (GND), U9.1 (GND); also elsewhere on the board
unnamed: C205.2, D1.1 (K), L1.1, U8.1 (VSW)
unnamed: D3.2 (A), Q1.1 (G), R201.1
unnamed: D4.2 (A), R202.2
unnamed: F1.1, J2.1
unnamed: F1.2, Q1.2 (D)
unnamed: SJ201.2 (B), U8.7 (ON/~OFF)
unnamed: C205.1, U8.3 (CB)
VIN: C201.1, C202.1, C203.1, C204.1, D2.2 (A2), D3.1 (K), Q1.3 (S), TP201.1, U8.2 (VIN)

Notes on the sheet:
Input: 9-24 V DC barrel jack (centre +), T5A fuse, P-FET reverse-polarity protection, TVS
C201-C203: 50 V X7R 1210 C204: 50 V electrolytic
Q1: body diode conducts first, then Vgs = -(VIN) turns the channel on; reversed input leaves Q1 off. D3 clamps |Vgs| to 12 V (Q1 Vgs max +/-20 V). D2 SMBJ28CA: bidirectional TVS, 28 V standoff; clamp at rated Ipp (~45 V) is at the LM2678 45 V abs-max [EST] - fuse F1 clears sustained faults.
C201-C204: Irms rating must exceed Iload/2 = 2 A (SNVS029L step 5). Deviation from Table 7-7 (tantalum/aluminium): 3x 10 uF 50 V X7R 1210 + 1x 100 uF 50 V low-ESR electrolytic for bulk/damping on hot-plug.
5 V buck: LM2678S-5.0 (fixed 5 V, 260 kHz, 5 A switch)
C206-C208: 100 uF 10 V tantalum (T495-X)
L1: Fig 7-3 nomograph (5 V, 24 V, 4 A) -> L41 = 22 uH; SRP1770TA-220M: DCR 26.5 mOhm, Isat 18 A. C206-C208: Table 7-5 -> 3x AVX/KEMET 100 uF 10 V 'C4' tantalum (no all-ceramic output). D1: Schottky, VR >= 1.3 x 24 V, IF >= 5 A (Table 7-4 class) -> B540C (40 V, 5 A). C205 (CB): 0.01 uF per step 7 / 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
3.3 V LDO for DS3234 RTC / ENC28J60 / logic-level parts (spec 6.1)
C210: AMS1117 datasheet 'Stability': 22 uF solid tantalum on the output covers all conditions. C209: 10 uF input per the datasheet application circuit.
Mounting holes H1-H4 (GND) are on the top-level sheet.

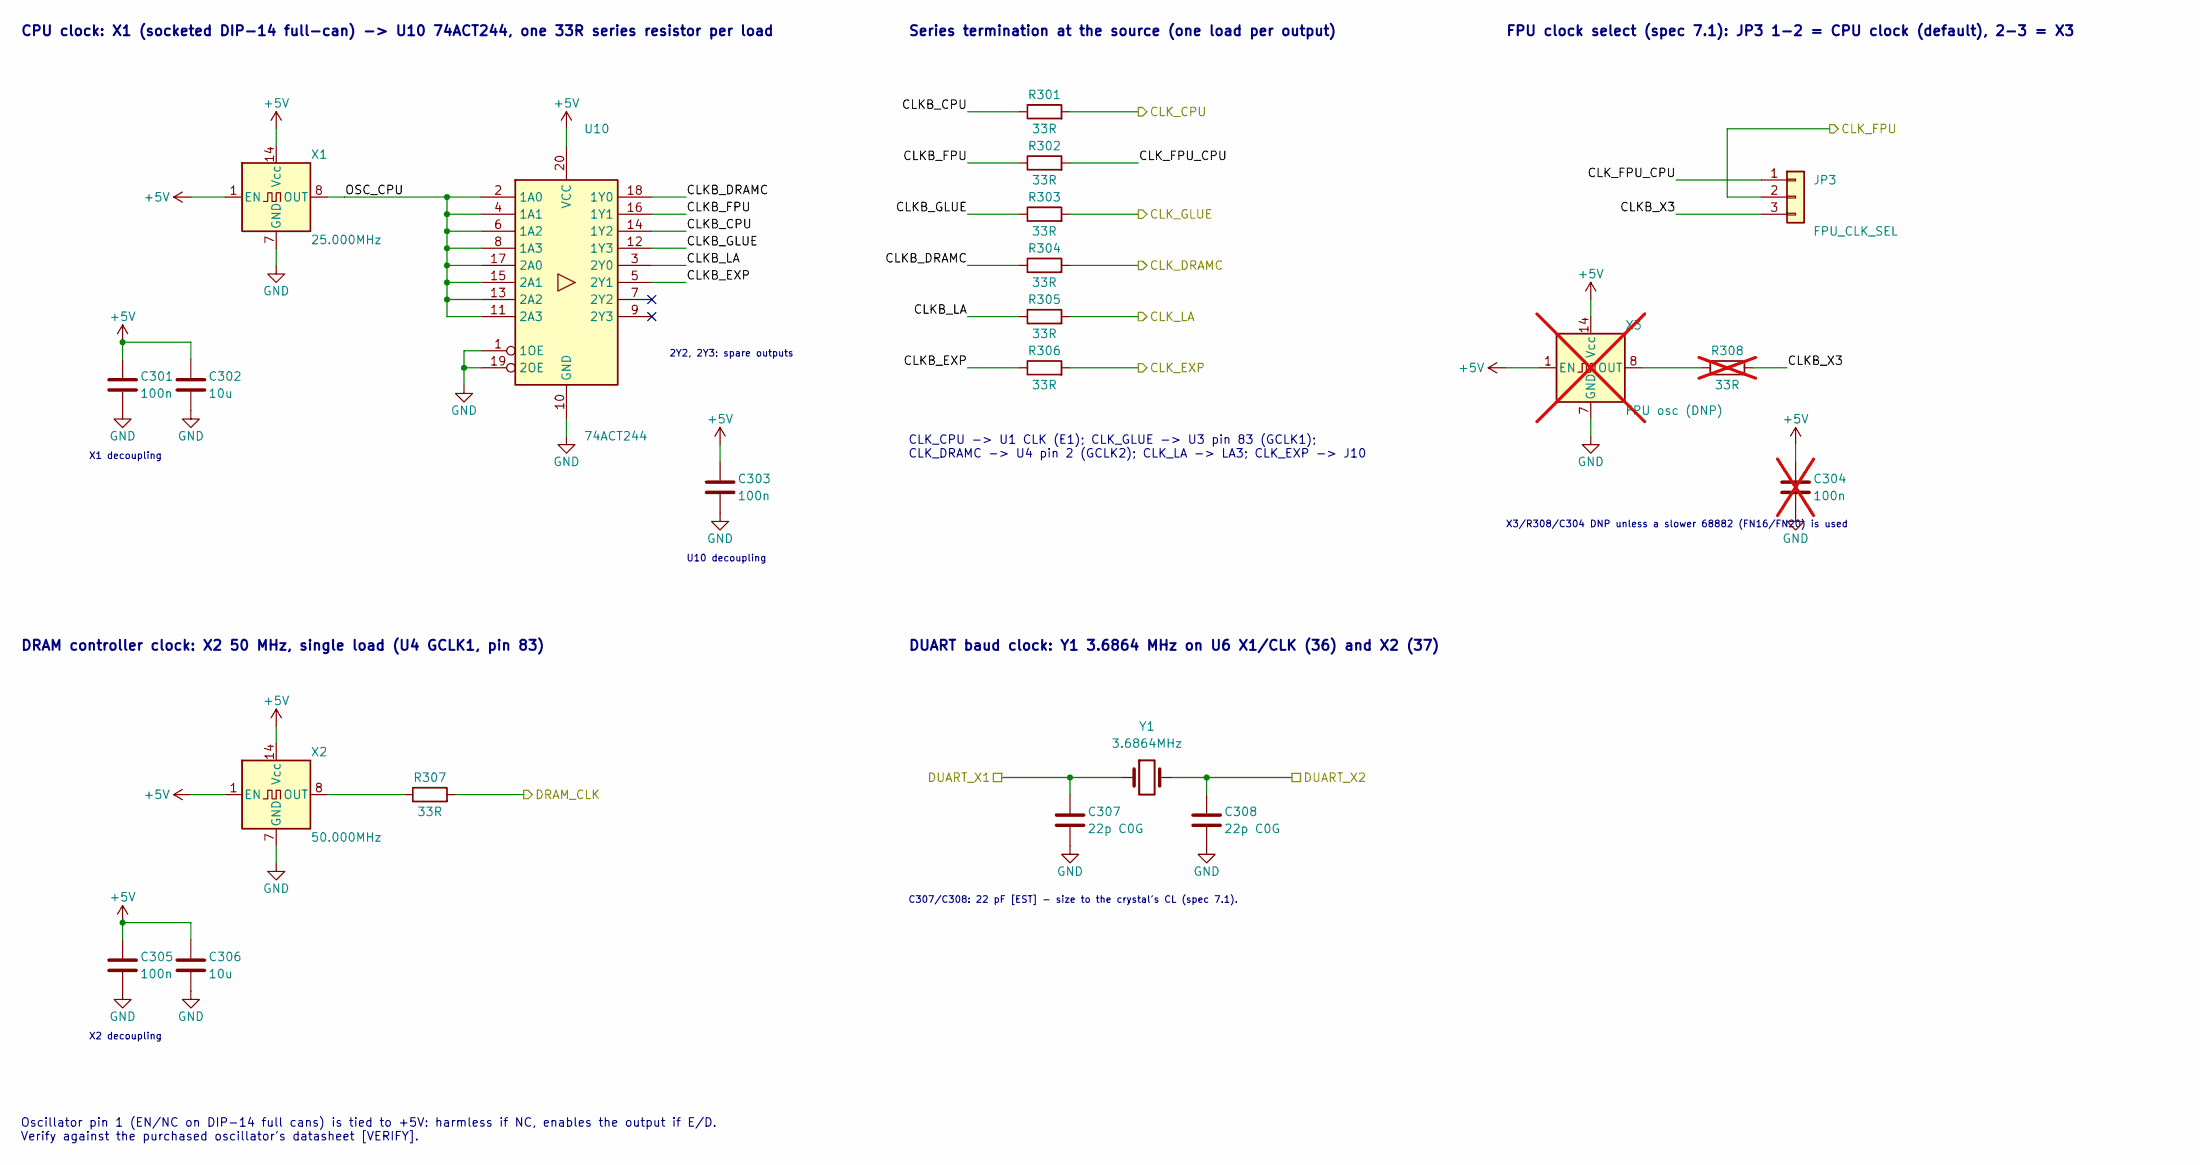
[picture p44: schematic clock.kicad_sch, Clocks]

Parts:
C301, C303, C305: 100n; C_0603_1608Metric
C302, C306: 10u; C_1206_3216Metric
C304: 100n; C_0603_1608Metric; not fitted
C307, C308: 22p C0G; C_0603_1608Metric
JP3: FPU_CLK_SEL; PinHeader_1x03_P2.54mm_Vertical
R301, R302, R303, R304, R305, R306, R307: 33R; R_0603_1608Metric
R308: 33R; R_0603_1608Metric; not fitted
U10: 74ACT244; SOIC-20W_7.5x12.8mm_P1.27mm; MPN SN74ACT244DWR
X1: 25.000MHz; Oscillator_SMD_ECS-3951M_7.0x5.0mm_DIP14PinMap; MPN ECS-3951M-250-BN-TR
X2: 50.000MHz; Oscillator_SMD_ECS-3951M_7.0x5.0mm_DIP14PinMap; MPN ECS-3951M-500-BN-TR
X3: FPU osc (DNP); Oscillator_SMD_ECS-3951M_7.0x5.0mm_DIP14PinMap; MPN ECS-3951M-200-BN-TR [VERIFY freq vs 688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; not fitted
Y1: 3.6864MHz; Crystal_HC49-4H_Vertical; MPN 3.6864 MHz HC-49 (CL per chosen part)

Connections:
+5V: C301.1, C302.1, C303.1, C304.1, C305.1, C306.1, U10.20 (VCC), X1.1 (EN), X1.14 (Vcc), X2.1 (EN), X2.14 (Vcc), X3.1 (EN), X3.14 (Vcc); also elsewhere on the board
/CLK_CPU: R301.2; also elsewhere on the board
/CLK_DRAMC: R304.2; also elsewhere on the board
/CLK_EXP: R306.2; also elsewhere on the board
/CLK_FPU: JP3.2; also elsewhere on the board
/CLK_GLUE: R303.2; also elsewhere on the board
/CLK_LA: R305.2; also elsewhere on the board
/DRAM_CLK: R307.2; also elsewhere on the board
/DUART_X1: C307.1, Y1.1; also elsewhere on the board
/DUART_X2: C308.1, Y1.2; also elsewhere on the board
/clock/CLKB_CPU: R301.1, U10.14 (1Y2)
/clock/CLKB_DRAMC: R304.1, U10.18 (1Y0)
/clock/CLKB_EXP: R306.1, U10.5 (2Y1)
/clock/CLKB_FPU: R302.1, U10.16 (1Y1)
/clock/CLKB_GLUE: R303.1, U10.12 (1Y3)
/clock/CLKB_LA: R305.1, U10.3 (2Y0)
/clock/CLKB_X3: JP3.3, R308.2
/clock/CLK_FPU_CPU: JP3.1, R302.2
/clock/OSC_CPU: U10.2 (1A0), U10.4 (1A1), U10.6 (1A2), U10.8 (1A3), U10.11 (2A3), U10.13 (2A2), U10.15 (2A1), U10.17 (2A0), X1.8 (OUT)
GND: C301.2, C302.2, C303.2, C304.2, C305.2, C306.2, C307.2, C308.2, U10.1 (1OE), U10.10 (GND), U10.19 (2OE), X1.7 (GND), X2.7 (GND), X3.7 (GND); also elsewhere on the board
unnamed: R307.1, X2.8 (OUT)
unnamed: R308.1, X3.8 (OUT)

Notes on the sheet:
CPU clock: X1 (socketed DIP-14 full-can) -> U10 74ACT244, one 33R series resistor per load
2Y2, 2Y3: spare outputs
X1 decoupling
U10 decoupling
Series termination at the source (one load per output)
CLK_CPU -> U1 CLK (E1); CLK_GLUE -> U3 pin 83 (GCLK1); CLK_DRAMC -> U4 pin 2 (GCLK2); CLK_LA -> LA3; CLK_EXP -> J10
FPU clock select (spec 7.1): JP3 1-2 = CPU clock (default), 2-3 = X3
X3/R308/C304 DNP unless a slower 68882 (FN16/FN20) is used
DRAM controller clock: X2 50 MHz, single load (U4 GCLK1, pin 83)
X2 decoupling
DUART baud clock: Y1 3.6864 MHz on U6 X1/CLK (36) and X2 (37)
C307/C308: 22 pF [EST] - size to the crystal's CL (spec 7.1).
Oscillator pin 1 (EN/NC on DIP-14 full cans) is tied to +5V: harmless if NC, enables the output if E/D. Verify against the purchased oscillator's datasheet [VERIFY].

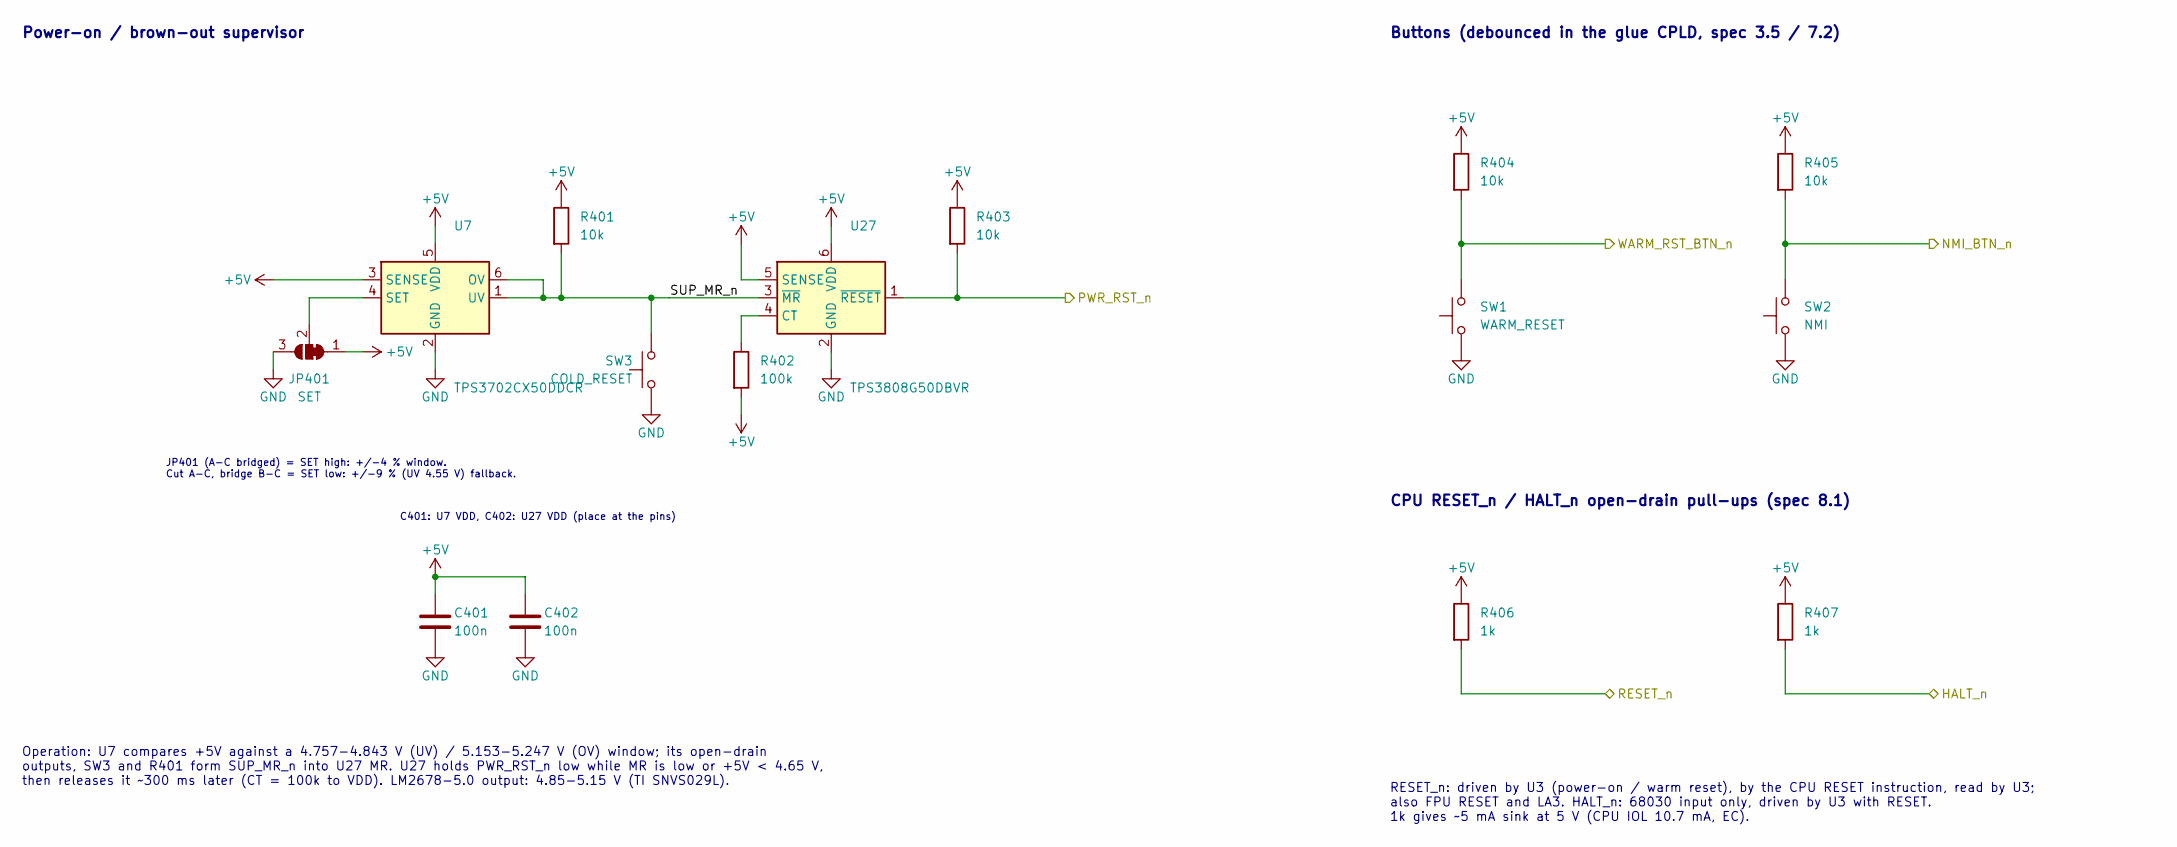
[picture p45: schematic reset.kicad_sch]

Parts:
C401, C402: 100n; C_0603_1608Metric
JP401: SET; SolderJumper-3_P1.3mm_Bridged12_RoundedPad1.0x1.5mm
R401, R403, R404, R405: 10k; R_0603_1608Metric
R402: 100k; R_0603_1608Metric
R406, R407: 1k; R_0603_1608Metric
SW1: WARM_RESET; SW_PUSH_6mm_H5mm
SW2: NMI; SW_PUSH_6mm_H5mm
SW3: COLD_RESET; SW_PUSH_6mm_H5mm
U7: TPS3702CX50DDCR; SOT-23-6; MPN TPS3702CX50DDCR
U27: TPS3808G50DBVR; SOT-23-6; MPN TPS3808G50DBVR

Connections:
+5V: C401.1, C402.1, JP401.1 (A), R401.1, R402.2, R403.1, R404.1, R405.1, R406.1, R407.1, U7.3 (SENSE), U7.5 (VDD), U27.5 (SENSE), U27.6 (VDD); also elsewhere on the board
/HALT_n: R407.2; also elsewhere on the board
/NMI_BTN_n: R405.2, SW2.2; also elsewhere on the board
/PWR_RST_n: R403.2, U27.1 (~RESET); also elsewhere on the board
/RESET_n: R406.2; also elsewhere on the board
/WARM_RST_BTN_n: R404.2, SW1.2; also elsewhere on the board
/reset/SUP_MR_n: R401.2, SW3.2, U7.1 (UV), U7.6 (OV), U27.3 (~MR)
GND: C401.2, C402.2, JP401.3 (B), SW1.1, SW2.1, SW3.1, U7.2 (GND), U27.2 (GND); also elsewhere on the board
unnamed: JP401.2 (C), U7.4 (SET)
unnamed: R402.1, U27.4 (CT)

Notes on the sheet:
Power-on / brown-out supervisor
JP401 (A-C bridged) = SET high: +/-4 % window. Cut A-C, bridge B-C = SET low: +/-9 % (UV 4.55 V) fallback.
C401: U7 VDD, C402: U27 VDD (place at the pins)
Operation: U7 compares +5V against a 4.757-4.843 V (UV) / 5.153-5.247 V (OV) window; its open-drain outputs, SW3 and R401 form SUP_MR_n into U27 MR. U27 holds PWR_RST_n low while MR is low or +5V < 4.65 V, then releases it ~300 ms later (CT = 100k to VDD). LM2678-5.0 output: 4.85-5.15 V (TI SNVS029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
Buttons (debounced in the glue CPLD, spec 3.5 / 7.2)
CPU RESET_n / HALT_n open-drain pull-ups (spec 8.1)
RESET_n: driven by U3 (power-on / warm reset), by the CPU RESET instruction, read by U3; also FPU RESET and LA3. HALT_n: 68030 input only, driven by U3 with RESET. 1k gives ~5 mA sink at 5 V (CPU IOL 10.7 mA, EC).
