mattbettcher/m68030-sbc/68030-design/kicad/m68030-sbc.kicad_pcb

## KiCad design 68030-design/kicad/m68030-sbc.kicad_pcb (continued)

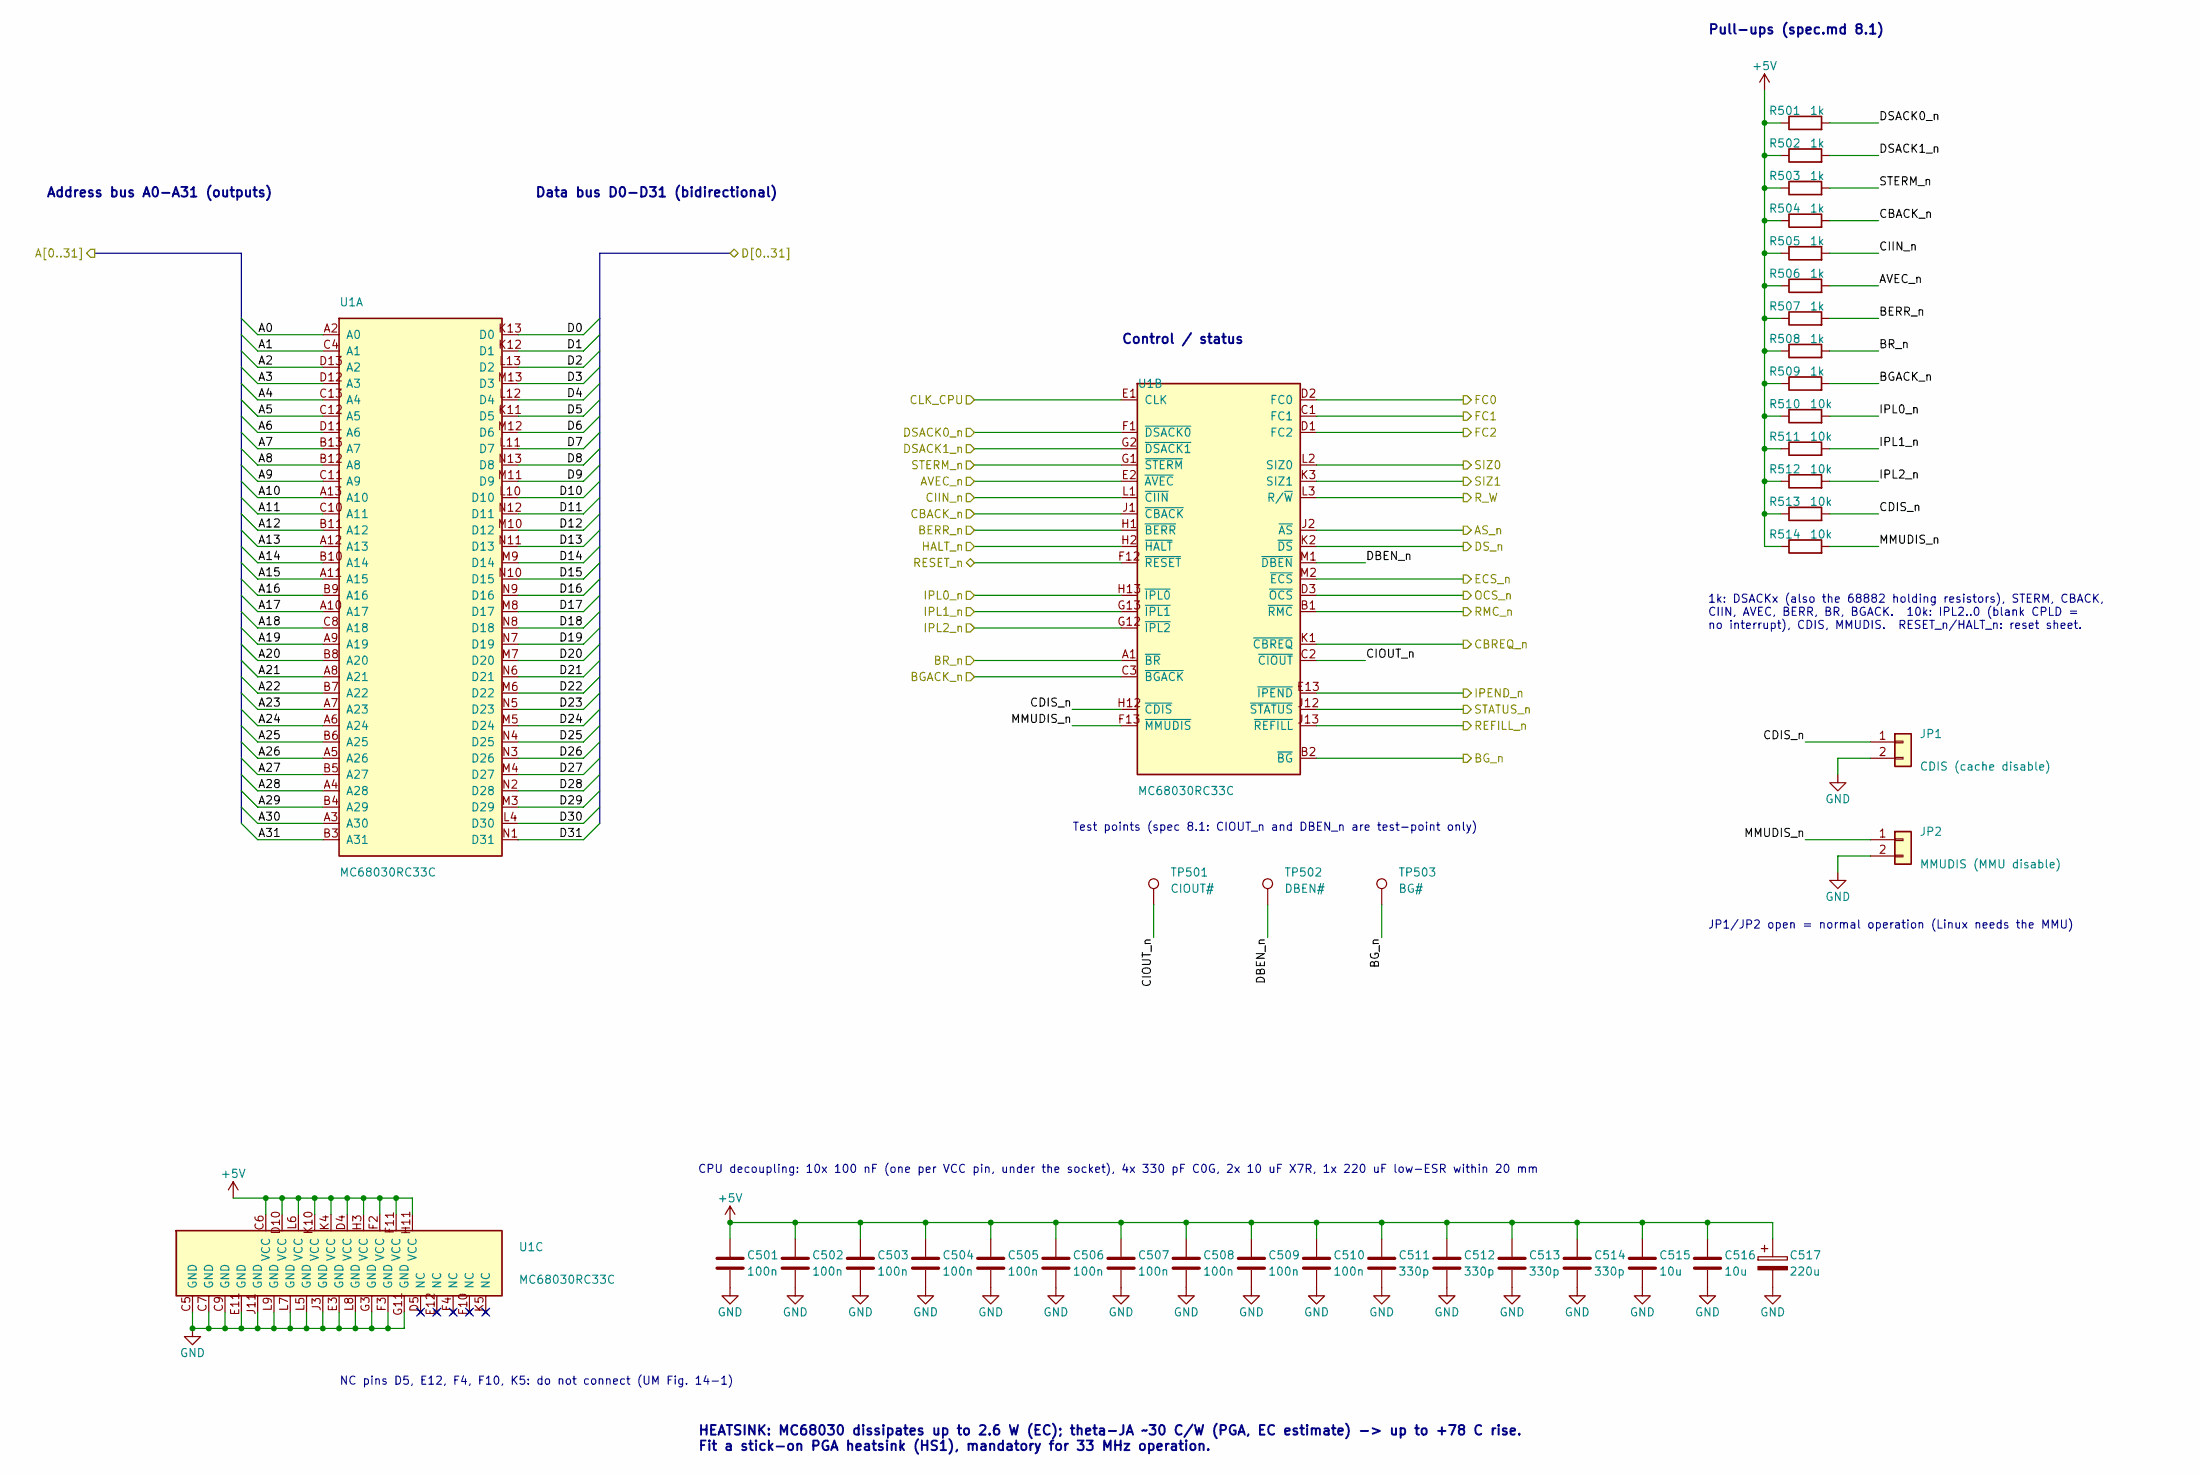
[picture p46: schematic cpu.kicad_sch, CPU: MC68030 PGA-128]

Parts:
C501, C502, C503, C504, C505, C506, C507, C508, C509, C510: 100n; C_0805_2012Metric
C511, C512, C513, C514: 330p; C_0603_1608Metric
C515, C516: 10u; C_1206_3216Metric
C517: 220u; CP_Radial_D8.0mm_P3.50mm
JP1: CDIS (cache disable); PinHeader_1x02_P2.54mm_Vertical
JP2: MMUDIS (MMU disable); PinHeader_1x02_P2.54mm_Vertical
R501, R502, R503, R504, R505, R506, R507, R508, R509: 1k; R_0603_1608Metric
R510, R511, R512, R513, R514: 10k; R_0603_1608Metric
TP501: CIOUT#; TestPoint_Pad_D1.5mm
TP502: DBEN#; TestPoint_Pad_D1.5mm
TP503: BG#; TestPoint_Pad_D1.5mm
U1: MC68030RC33C; PGA128_13x13_MC68030; MPN MC68030RC33C

Connections:
+5V: C501.1, C502.1, C503.1, C504.1, C505.1, C506.1, C507.1, C508.1, C509.1, C510.1, C511.1, C512.1, C513.1, C514.1, C515.1, C516.1, C517.1, R501.1, R502.1, R503.1, R504.1, R505.1, R506.1, R507.1, R508.1, R509.1, R510.1, R511.1, R512.1, R513.1, R514.1, U1.C6 (VCC), U1.D4 (VCC), U1.D10 (VCC), U1.F2 (VCC), U1.F11 (VCC), U1.H3 (VCC), U1.H11 (VCC), U1.K4 (VCC), U1.K10 (VCC), U1.L6 (VCC); also elsewhere on the board
/A0: U1.A2 (A0); also elsewhere on the board
/A1: U1.C4 (A1); also elsewhere on the board
/A2: U1.D13 (A2); also elsewhere on the board
/A3: U1.D12 (A3); also elsewhere on the board
/A4: U1.C13 (A4); also elsewhere on the board
/A5: U1.C12 (A5); also elsewhere on the board
/A6: U1.D11 (A6); also elsewhere on the board
/A7: U1.B13 (A7); also elsewhere on the board
/A8: U1.B12 (A8); also elsewhere on the board
/A9: U1.C11 (A9); also elsewhere on the board
/A10: U1.A13 (A10); also elsewhere on the board
/A11: U1.C10 (A11); also elsewhere on the board
/A12: U1.B11 (A12); also elsewhere on the board
/A13: U1.A12 (A13); also elsewhere on the board
/A14: U1.B10 (A14); also elsewhere on the board
/A15: U1.A11 (A15); also elsewhere on the board
/A16: U1.B9 (A16); also elsewhere on the board
/A17: U1.A10 (A17); also elsewhere on the board
/A18: U1.C8 (A18); also elsewhere on the board
/A19: U1.A9 (A19); also elsewhere on the board
/A20: U1.B8 (A20); also elsewhere on the board
/A21: U1.A8 (A21); also elsewhere on the board
/A22: U1.B7 (A22); also elsewhere on the board
/A23: U1.A7 (A23); also elsewhere on the board
/A24: U1.A6 (A24); also elsewhere on the board
/A25: U1.B6 (A25); also elsewhere on the board
/A26: U1.A5 (A26); also elsewhere on the board
/A27: U1.B5 (A27); also elsewhere on the board
/A28: U1.A4 (A28); also elsewhere on the board
/A29: U1.B4 (A29); also elsewhere on the board
/A30: U1.A3 (A30); also elsewhere on the board
/A31: U1.B3 (A31); also elsewhere on the board
/AS_n: U1.J2 (~AS); also elsewhere on the board
/AVEC_n: R506.2, U1.E2 (~AVEC); also elsewhere on the board
/BERR_n: R507.2, U1.H1 (~BERR); also elsewhere on the board
/BGACK_n: R509.2, U1.C3 (~BGACK); also elsewhere on the board
/BG_n: TP503.1, U1.B2 (~BG); also elsewhere on the board
/BR_n: R508.2, U1.A1 (~BR); also elsewhere on the board
/CBACK_n: R504.2, U1.J1 (~CBACK); also elsewhere on the board
/CBREQ_n: U1.K1 (~CBREQ); also elsewhere on the board
/CIIN_n: R505.2, U1.L1 (~CIIN); also elsewhere on the board
/CLK_CPU: U1.E1 (CLK); also elsewhere on the board
/D0: U1.K13 (D0); also elsewhere on the board
/D1: U1.K12 (D1); also elsewhere on the board
/D2: U1.L13 (D2); also elsewhere on the board
/D3: U1.M13 (D3); also elsewhere on the board
/D4: U1.L12 (D4); also elsewhere on the board
/D5: U1.K11 (D5); also elsewhere on the board
/D6: U1.M12 (D6); also elsewhere on the board
/D7: U1.L11 (D7); also elsewhere on the board
/D8: U1.N13 (D8); also elsewhere on the board
/D9: U1.M11 (D9); also elsewhere on the board
/D10: U1.L10 (D10); also elsewhere on the board
/D11: U1.N12 (D11); also elsewhere on the board
/D12: U1.M10 (D12); also elsewhere on the board
/D13: U1.N11 (D13); also elsewhere on the board
/D14: U1.M9 (D14); also elsewhere on the board
/D15: U1.N10 (D15); also elsewhere on the board
/D16: U1.N9 (D16); also elsewhere on the board
/D17: U1.M8 (D17); also elsewhere on the board
/D18: U1.N8 (D18); also elsewhere on the board
/D19: U1.N7 (D19); also elsewhere on the board
/D20: U1.M7 (D20); also elsewhere on the board
/D21: U1.N6 (D21); also elsewhere on the board
/D22: U1.M6 (D22); also elsewhere on the board
/D23: U1.N5 (D23); also elsewhere on the board
/D24: U1.M5 (D24); also elsewhere on the board
/D25: U1.N4 (D25); also elsewhere on the board
/D26: U1.N3 (D26); also elsewhere on the board
/D27: U1.M4 (D27); also elsewhere on the board
/D28: U1.N2 (D28); also elsewhere on the board
/D29: U1.M3 (D29); also elsewhere on the board
/D30: U1.L4 (D30); also elsewhere on the board
/D31: U1.N1 (D31); also elsewhere on the board
/DSACK0_n: R501.2, U1.F1 (~DSACK0); also elsewhere on the board
/DSACK1_n: R502.2, U1.G2 (~DSACK1); also elsewhere on the board
/DS_n: U1.K2 (~DS); also elsewhere on the board
/ECS_n: U1.M2 (~ECS); also elsewhere on the board
/FC0: U1.D2 (FC0); also elsewhere on the board
/FC1: U1.C1 (FC1); also elsewhere on the board
/FC2: U1.D1 (FC2); also elsewhere on the board
/HALT_n: U1.H2 (~HALT); also elsewhere on the board
/IPEND_n: U1.E13 (~IPEND); also elsewhere on the board
/IPL0_n: R510.2, U1.H13 (~IPL0); also elsewhere on the board
/IPL1_n: R511.2, U1.G13 (~IPL1); also elsewhere on the board
/IPL2_n: R512.2, U1.G12 (~IPL2); also elsewhere on the board
/OCS_n: U1.D3 (~OCS); also elsewhere on the board
/REFILL_n: U1.J13 (~REFILL); also elsewhere on the board
/RESET_n: U1.F12 (~RESET); also elsewhere on the board
/RMC_n: U1.B1 (~RMC); also elsewhere on the board
/R_W: U1.L3 (R/~W); also elsewhere on the board
/SIZ0: U1.L2 (SIZ0); also elsewhere on the board
/SIZ1: U1.K3 (SIZ1); also elsewhere on the board
/STATUS_n: U1.J12 (~STATUS); also elsewhere on the board
/STERM_n: R503.2, U1.G1 (~STERM); also elsewhere on the board
/cpu/CDIS_n: JP1.1, R513.2, U1.H12 (~CDIS)
/cpu/CIOUT_n: TP501.1, U1.C2 (~CIOUT)
/cpu/DBEN_n: TP502.1, U1.M1 (~DBEN)
/cpu/MMUDIS_n: JP2.1, R514.2, U1.F13 (~MMUDIS)
GND: C501.2, C502.2, C503.2, C504.2, C505.2, C506.2, C507.2, C508.2, C509.2, C510.2, C511.2, C512.2, C513.2, C514.2, C515.2, C516.2, C517.2, JP1.2, JP2.2, U1.C5 (GND), U1.C7 (GND), U1.C9 (GND), U1.E3 (GND), U1.E11 (GND), U1.F3 (GND), U1.G3 (GND), U1.G11 (GND), U1.J3 (GND), U1.J11 (GND), U1.L5 (GND), U1.L7 (GND), U1.L8 (GND), U1.L9 (GND); also elsewhere on the board

Notes on the sheet:
Address bus A0-A31 (outputs)
Data bus D0-D31 (bidirectional)
Control / status
Test points (spec 8.1: CIOUT_n and DBEN_n are test-point only)
Pull-ups (spec.md 8.1)
1k: DSACKx (also the 68882 holding resistors), STERM, CBACK, CIIN, AVEC, BERR, BR, BGACK. 10k: IPL2..0 (blank CPLD = no interrupt), CDIS, MMUDIS. RESET_n/HALT_n: reset sheet.
JP1/JP2 open = normal operation (Linux needs the MMU)
NC pins D5, E12, F4, F10, K5: do not connect (UM Fig. 14-1)
CPU decoupling: 10x 100 nF (one per VCC pin, under the socket), 4x 330 pF C0G, 2x 10 uF X7R, 1x 220 uF low-ESR within 20 mm
HEATSINK: MC68030 dissipates up to 2.6 W (EC); theta-JA ~30 C/W (PGA, EC estimate) -> up to +78 C rise. Fit a stick-on PGA heatsink (HS1), mandatory for 33 MHz operation.

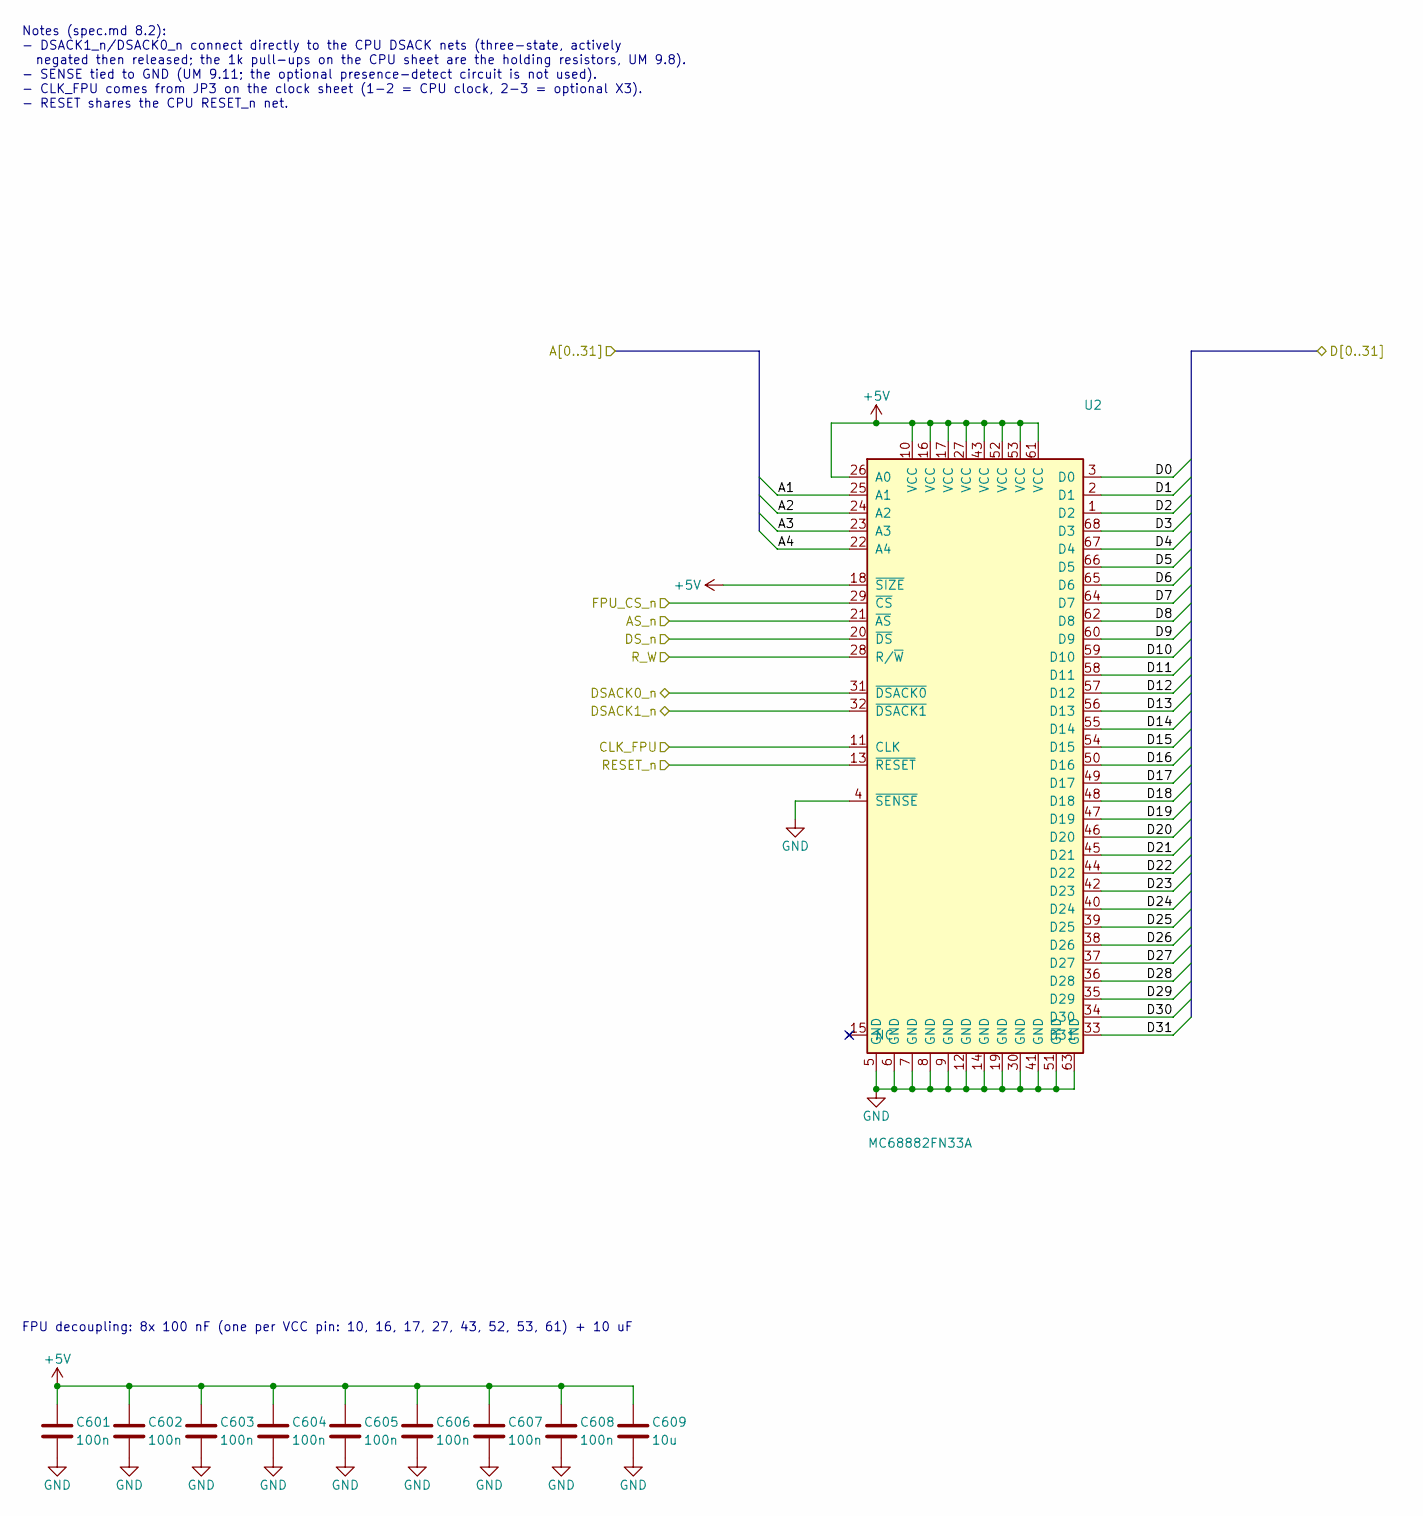
[picture p47: schematic fpu.kicad_sch, FPU: MC68882 PLCC-68]

Parts:
C601, C602, C603, C604, C605, C606, C607, C608: 100n; C_0805_2012Metric
C609: 10u; C_1206_3216Metric
U2: MC68882FN33A; PLCC-68_THT-Socket; MPN MC68882FN33A (or FN25A)

Connections:
+5V: C601.1, C602.1, C603.1, C604.1, C605.1, C606.1, C607.1, C608.1, C609.1, U2.10 (VCC), U2.16 (VCC), U2.17 (VCC), U2.18 (~SIZE), U2.26 (A0), U2.27 (VCC), U2.43 (VCC), U2.52 (VCC), U2.53 (VCC), U2.61 (VCC); also elsewhere on the board
/A1: U2.25 (A1); also elsewhere on the board
/A2: U2.24 (A2); also elsewhere on the board
/A3: U2.23 (A3); also elsewhere on the board
/A4: U2.22 (A4); also elsewhere on the board
/AS_n: U2.21 (~AS); also elsewhere on the board
/CLK_FPU: U2.11 (CLK); also elsewhere on the board
/D0: U2.3 (D0); also elsewhere on the board
/D1: U2.2 (D1); also elsewhere on the board
/D2: U2.1 (D2); also elsewhere on the board
/D3: U2.68 (D3); also elsewhere on the board
/D4: U2.67 (D4); also elsewhere on the board
/D5: U2.66 (D5); also elsewhere on the board
/D6: U2.65 (D6); also elsewhere on the board
/D7: U2.64 (D7); also elsewhere on the board
/D8: U2.62 (D8); also elsewhere on the board
/D9: U2.60 (D9); also elsewhere on the board
/D10: U2.59 (D10); also elsewhere on the board
/D11: U2.58 (D11); also elsewhere on the board
/D12: U2.57 (D12); also elsewhere on the board
/D13: U2.56 (D13); also elsewhere on the board
/D14: U2.55 (D14); also elsewhere on the board
/D15: U2.54 (D15); also elsewhere on the board
/D16: U2.50 (D16); also elsewhere on the board
/D17: U2.49 (D17); also elsewhere on the board
/D18: U2.48 (D18); also elsewhere on the board
/D19: U2.47 (D19); also elsewhere on the board
/D20: U2.46 (D20); also elsewhere on the board
/D21: U2.45 (D21); also elsewhere on the board
/D22: U2.44 (D22); also elsewhere on the board
/D23: U2.42 (D23); also elsewhere on the board
/D24: U2.40 (D24); also elsewhere on the board
/D25: U2.39 (D25); also elsewhere on the board
/D26: U2.38 (D26); also elsewhere on the board
/D27: U2.37 (D27); also elsewhere on the board
/D28: U2.36 (D28); also elsewhere on the board
/D29: U2.35 (D29); also elsewhere on the board
/D30: U2.34 (D30); also elsewhere on the board
/D31: U2.33 (D31); also elsewhere on the board
/DSACK0_n: U2.31 (~DSACK0); also elsewhere on the board
/DSACK1_n: U2.32 (~DSACK1); also elsewhere on the board
/DS_n: U2.20 (~DS); also elsewhere on the board
/FPU_CS_n: U2.29 (~CS); also elsewhere on the board
/RESET_n: U2.13 (~RESET); also elsewhere on the board
/R_W: U2.28 (R/~W); also elsewhere on the board
GND: C601.2, C602.2, C603.2, C604.2, C605.2, C606.2, C607.2, C608.2, C609.2, U2.4 (~SENSE), U2.5 (GND), U2.6 (GND), U2.7 (GND), U2.8 (GND), U2.9 (GND), U2.12 (GND), U2.14 (GND), U2.19 (GND), U2.30 (GND), U2.41 (GND), U2.51 (GND), U2.63 (GND); also elsewhere on the board

Notes on the sheet:
FPU decoupling: 8x 100 nF (one per VCC pin: 10, 16, 17, 27, 43, 52, 53, 61) + 10 uF
Notes (spec.md 8.2): - DSACK1_n/DSACK0_n connect directly to the CPU DSACK nets (three-state, actively negated then released; the 1k pull-ups on the CPU sheet are the holding resistors, UM 9.8). - SENSE tied to GND (UM 9.11; the optional presence-detect circuit is not used). - CLK_FPU comes from JP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

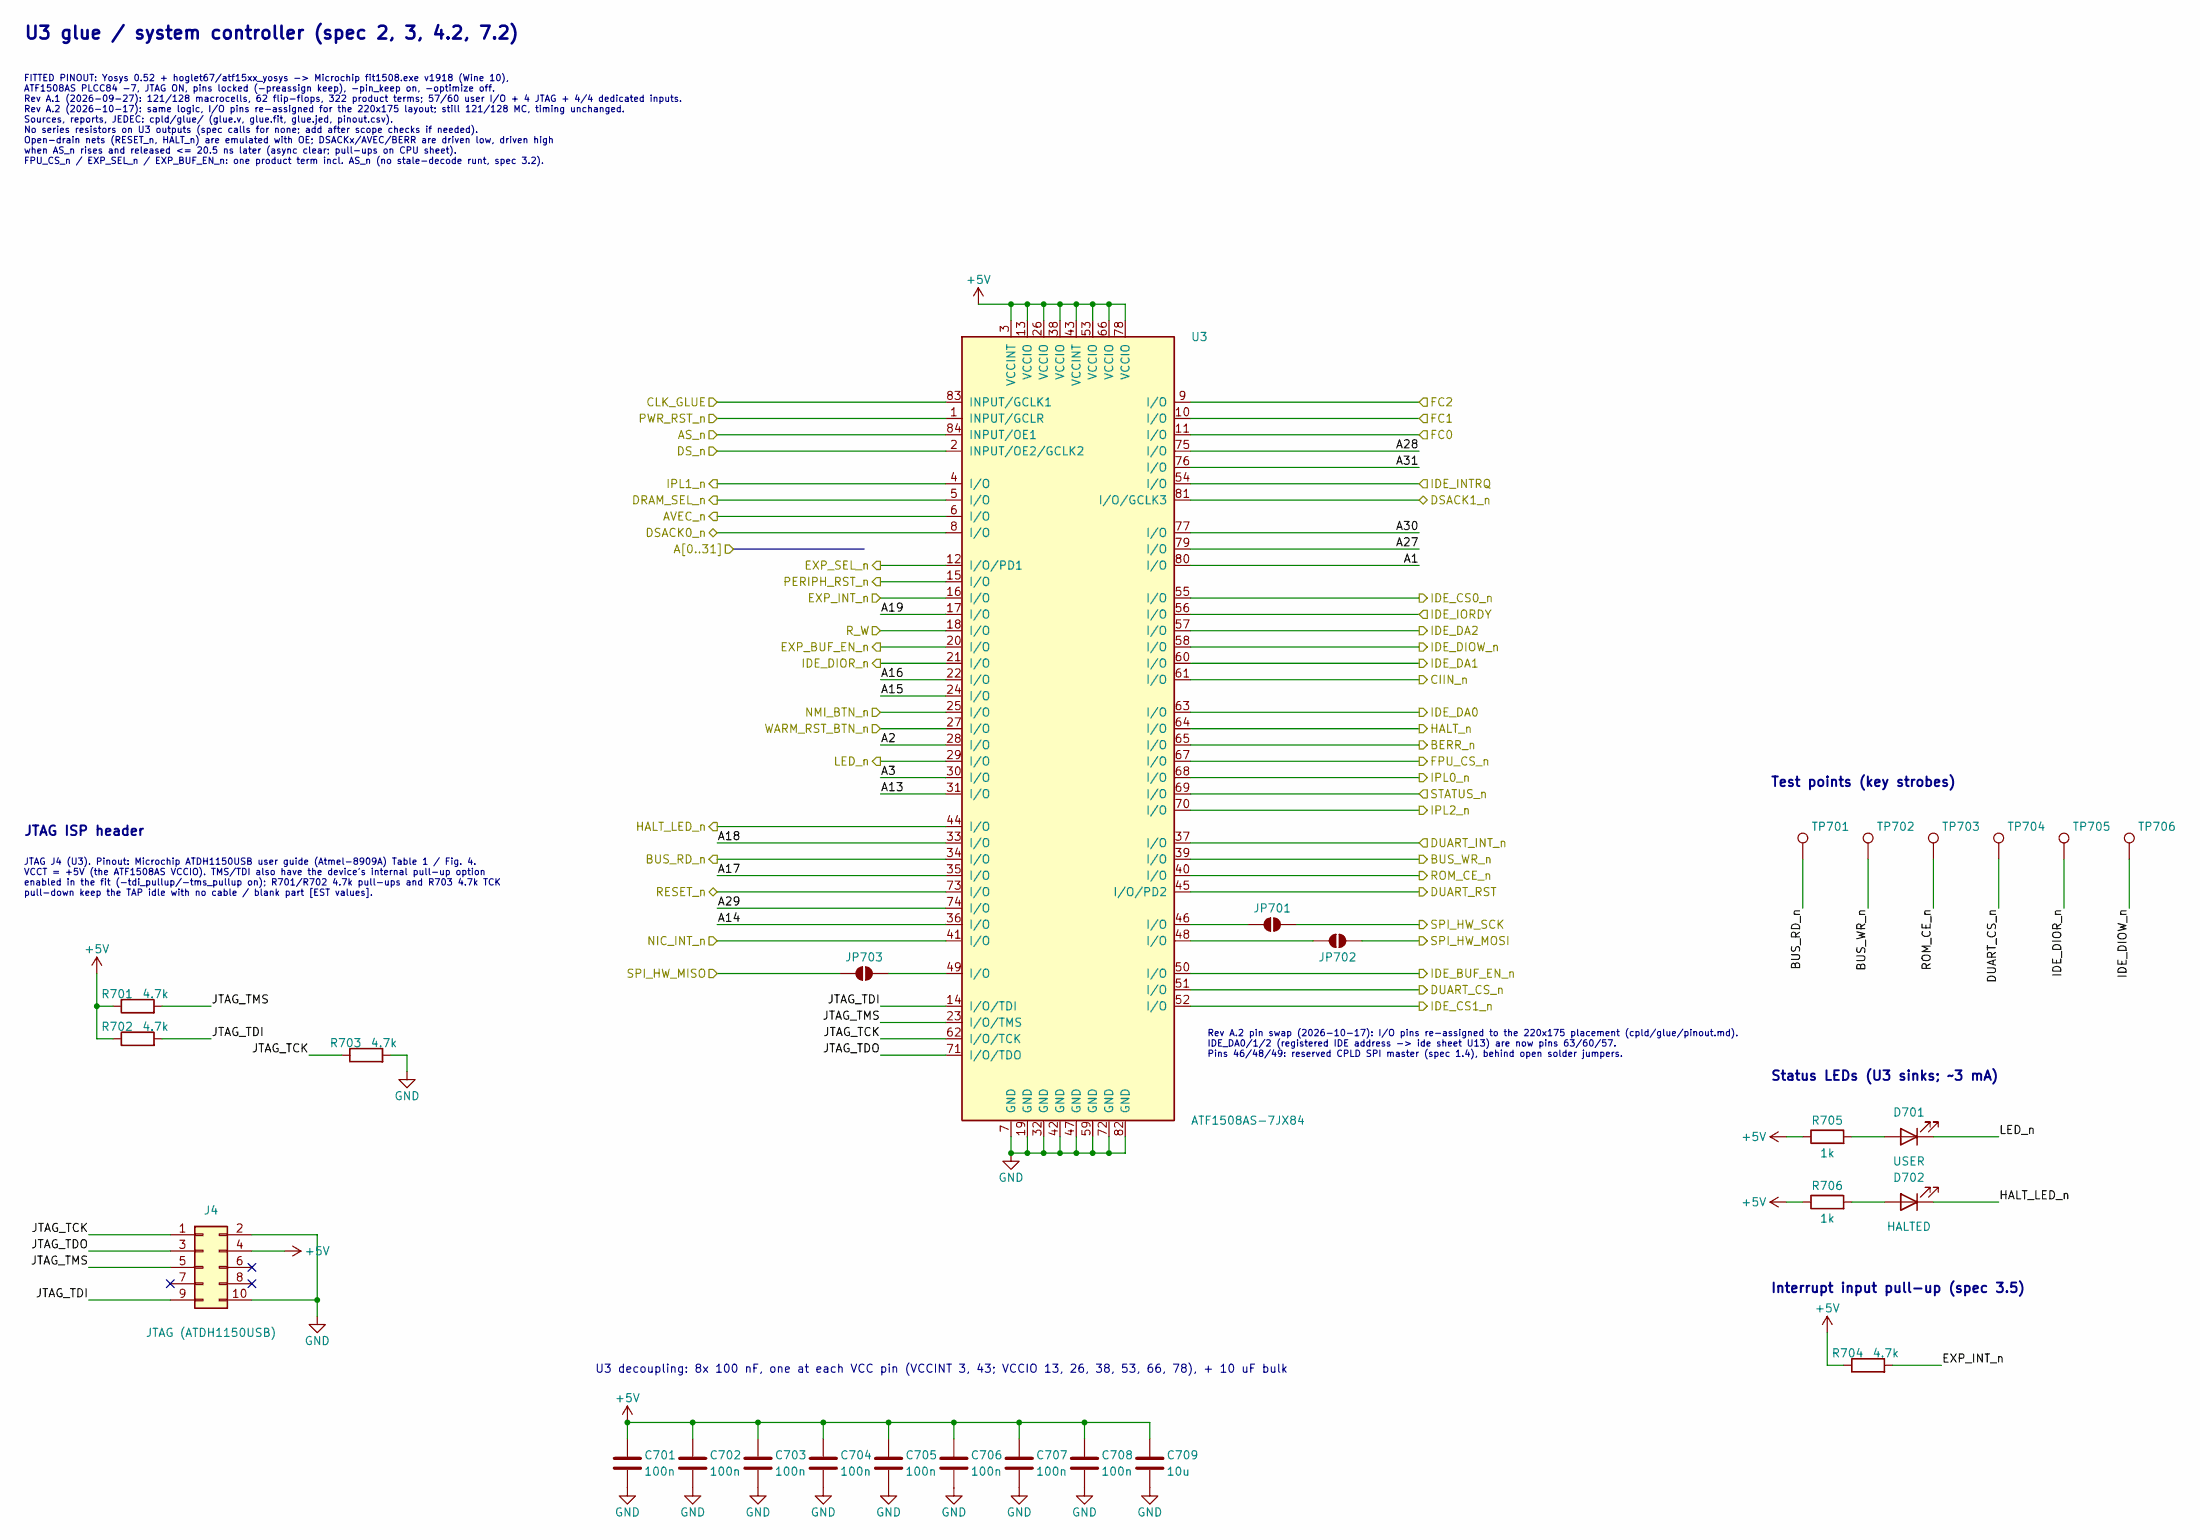
[picture p48: schematic glue_cpld.kicad_sch, Glue/system CPLD U3: ATF1508AS-7JX84 (PLCC-84)]

Parts:
C701, C702, C703, C704, C705, C706, C707, C708: 100n; C_0805_2012Metric
C709: 10u; C_1206_3216Metric
D701: USER; LED_0805_2012Metric
D702: HALTED; LED_0805_2012Metric
J4: JTAG (ATDH1150USB); IDC-Header_2x05_P2.54mm_Vertical
JP701, JP702, JP703: open; SolderJumper-2_P1.3mm_Open_RoundedPad1.0x1.5mm
R701, R702, R703, R704: 4.7k; R_0603_1608Metric
R705, R706: 1k; R_0603_1608Metric
TP701: BUS_RD#; TestPoint_Pad_D1.5mm
TP702: BUS_WR#; TestPoint_Pad_D1.5mm
TP703: ROM_CE#; TestPoint_Pad_D1.5mm
TP704: DUART_CS#; TestPoint_Pad_D1.5mm
TP705: IDE_DIOR#; TestPoint_Pad_D1.5mm
TP706: IDE_DIOW#; TestPoint_Pad_D1.5mm
U3: ATF1508AS-7JX84; PLCC-84_THT-Socket; MPN ATF1508AS-7JX84

Connections:
+5V: C701.1, C702.1, C703.1, C704.1, C705.1, C706.1, C707.1, C708.1, C709.1, J4.4, R701.1, R702.1, R704.1, R705.1, R706.1, U3.3 (VCCINT), U3.13 (VCCIO), U3.26 (VCCIO), U3.38 (VCCIO), U3.43 (VCCINT), U3.53 (VCCIO), U3.66 (VCCIO), U3.78 (VCCIO); also elsewhere on the board
/A1: U3.80 (I/O); also elsewhere on the board
/A2: U3.28 (I/O); also elsewhere on the board
/A3: U3.30 (I/O); also elsewhere on the board
/A13: U3.31 (I/O); also elsewhere on the board
/A14: U3.36 (I/O); also elsewhere on the board
/A15: U3.24 (I/O); also elsewhere on the board
/A16: U3.22 (I/O); also elsewhere on the board
/A17: U3.35 (I/O); also elsewhere on the board
/A18: U3.33 (I/O); also elsewhere on the board
/A19: U3.17 (I/O); also elsewhere on the board
/A27: U3.79 (I/O); also elsewhere on the board
/A28: U3.75 (I/O); also elsewhere on the board
/A29: U3.74 (I/O); also elsewhere on the board
/A30: U3.77 (I/O); also elsewhere on the board
/A31: U3.76 (I/O); also elsewhere on the board
/AS_n: U3.84 (INPUT/OE1); also elsewhere on the board
/AVEC_n: U3.6 (I/O); also elsewhere on the board
/BERR_n: U3.65 (I/O); also elsewhere on the board
/BUS_RD_n: TP701.1, U3.34 (I/O); also elsewhere on the board
/BUS_WR_n: TP702.1, U3.39 (I/O); also elsewhere on the board
/CIIN_n: U3.61 (I/O); also elsewhere on the board
/CLK_GLUE: U3.83 (INPUT/GCLK1); also elsewhere on the board
/DRAM_SEL_n: U3.5 (I/O); also elsewhere on the board
/DSACK0_n: U3.8 (I/O); also elsewhere on the board
/DSACK1_n: U3.81 (I/O/GCLK3); also elsewhere on the board
/DS_n: U3.2 (INPUT/OE2/GCLK2); also elsewhere on the board
/DUART_CS_n: TP704.1, U3.51 (I/O); also elsewhere on the board
/DUART_INT_n: U3.37 (I/O); also elsewhere on the board
/DUART_RST: U3.45 (I/O/PD2); also elsewhere on the board
/EXP_BUF_EN_n: U3.20 (I/O); also elsewhere on the board
/EXP_INT_n: R704.2, U3.16 (I/O); also elsewhere on the board
/EXP_SEL_n: U3.12 (I/O/PD1); also elsewhere on the board
/FC0: U3.11 (I/O); also elsewhere on the board
/FC1: U3.10 (I/O); also elsewhere on the board
/FC2: U3.9 (I/O); also elsewhere on the board
/FPU_CS_n: U3.67 (I/O); also elsewhere on the board
/HALT_LED_n: D702.1 (K), U3.44 (I/O); also elsewhere on the board
/HALT_n: U3.64 (I/O); also elsewhere on the board
/IDE_BUF_EN_n: U3.50 (I/O); also elsewhere on the board
/IDE_CS0_n: U3.55 (I/O); also elsewhere on the board
/IDE_CS1_n: U3.52 (I/O); also elsewhere on the board
/IDE_DA0: U3.63 (I/O); also elsewhere on the board
/IDE_DA1: U3.60 (I/O); also elsewhere on the board
/IDE_DA2: U3.57 (I/O); also elsewhere on the board
/IDE_DIOR_n: TP705.1, U3.21 (I/O); also elsewhere on the board
/IDE_DIOW_n: TP706.1, U3.58 (I/O); also elsewhere on the board
/IDE_INTRQ: U3.54 (I/O); also elsewhere on the board
/IDE_IORDY: U3.56 (I/O); also elsewhere on the board
/IPL0_n: U3.68 (I/O); also elsewhere on the board
/IPL1_n: U3.4 (I/O); also elsewhere on the board
/IPL2_n: U3.70 (I/O); also elsewhere on the board
/LED_n: D701.1 (K), U3.29 (I/O); also elsewhere on the board
/NIC_INT_n: U3.41 (I/O); also elsewhere on the board
/NMI_BTN_n: U3.25 (I/O); also elsewhere on the board
/PERIPH_RST_n: U3.15 (I/O); also elsewhere on the board
/PWR_RST_n: U3.1 (INPUT/GCLR); also elsewhere on the board
/RESET_n: U3.73 (I/O); also elsewhere on the board
/ROM_CE_n: TP703.1, U3.40 (I/O); also elsewhere on the board
/R_W: U3.18 (I/O); also elsewhere on the board
/SPI_HW_MISO: JP703.1 (A); also elsewhere on the board
/SPI_HW_MOSI: JP702.2 (B); also elsewhere on the board
/SPI_HW_SCK: JP701.2 (B); also elsewhere on the board
/STATUS_n: U3.69 (I/O); also elsewhere on the board
/WARM_RST_BTN_n: U3.27 (I/O); also elsewhere on the board
/glue_cpld/JTAG_TCK: J4.1, R703.1, U3.62 (I/O/TCK)
/glue_cpld/JTAG_TDI: J4.9, R702.2, U3.14 (I/O/TDI)
/glue_cpld/JTAG_TDO: J4.3, U3.71 (I/O/TDO)
/glue_cpld/JTAG_TMS: J4.5, R701.2, U3.23 (I/O/TMS)
GND: C701.2, C702.2, C703.2, C704.2, C705.2, C706.2, C707.2, C708.2, C709.2, J4.2, J4.10, R703.2, U3.7 (GND), U3.19 (GND), U3.32 (GND), U3.42 (GND), U3.47 (GND), U3.59 (GND), U3.72 (GND), U3.82 (GND); also elsewhere on the board
unnamed: D701.2 (A), R705.2
unnamed: D702.2 (A), R706.2
unnamed: JP701.1 (A), U3.46 (I/O)
unnamed: JP702.1 (A), U3.48 (I/O)
unnamed: JP703.2 (B), U3.49 (I/O)

Notes on the sheet:
Rev A.2 pin swap (2026-10-17): I/O pins re-assigned to the 220x175 placement (cpld/glue/pinout.md). IDE_DA0/1/2 (registered IDE address -> ide sheet U13) are now pins 63/60/57. Pins 46/48/49: reserved CPLD SPI master (spec 1.4), behind open solder jumpers.
U3 decoupling: 8x 100 nF, one at each VCC pin (VCCINT 3, 43; VCCIO 13, 26, 38, 53, 66, 78), + 10 uF bulk
JTAG J4 (U3). Pinout: Microchip ATDH1150USB user guide (Atmel-8909A) Table 1 / Fig. 4. VCCT = +5V (the ATF1508AS VCCIO). TMS/TDI also have the device's internal pull-up option enabled in the fit (-tdi_pullup/-tms_pullup on); R701/R702 4.7k pull-ups and R703 4.7k TCK pull-down keep the TAP idle with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
JTAG ISP header
Status LEDs (U3 sinks; ~3 mA)
Interrupt input pull-up (spec 3.5)
Test points (key strobes)
U3 glue / system controller (spec 2, 3, 4.2, 7.2)
FITTED PINOUT: Yosys 0.52 + hoglet67/atf15xx_yosys -> Microchip fit1508.exe v1918 (Wine 10), ATF1508AS PLCC84 -7, JTAG ON, pins locked (-preassign keep), -pin_keep on, -optimize off. Rev A.1 (2026-09-27): 121/128 macrocells, 62 flip-flops, 322 product terms; 57/60 user I/O + 4 JTAG + 4/4 dedicated 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
