mattbettcher/m68030-sbc/68030-design/kicad/m68030-sbc.kicad_pcb

## KiCad design 68030-design/kicad/m68030-sbc.kicad_pcb (continued)

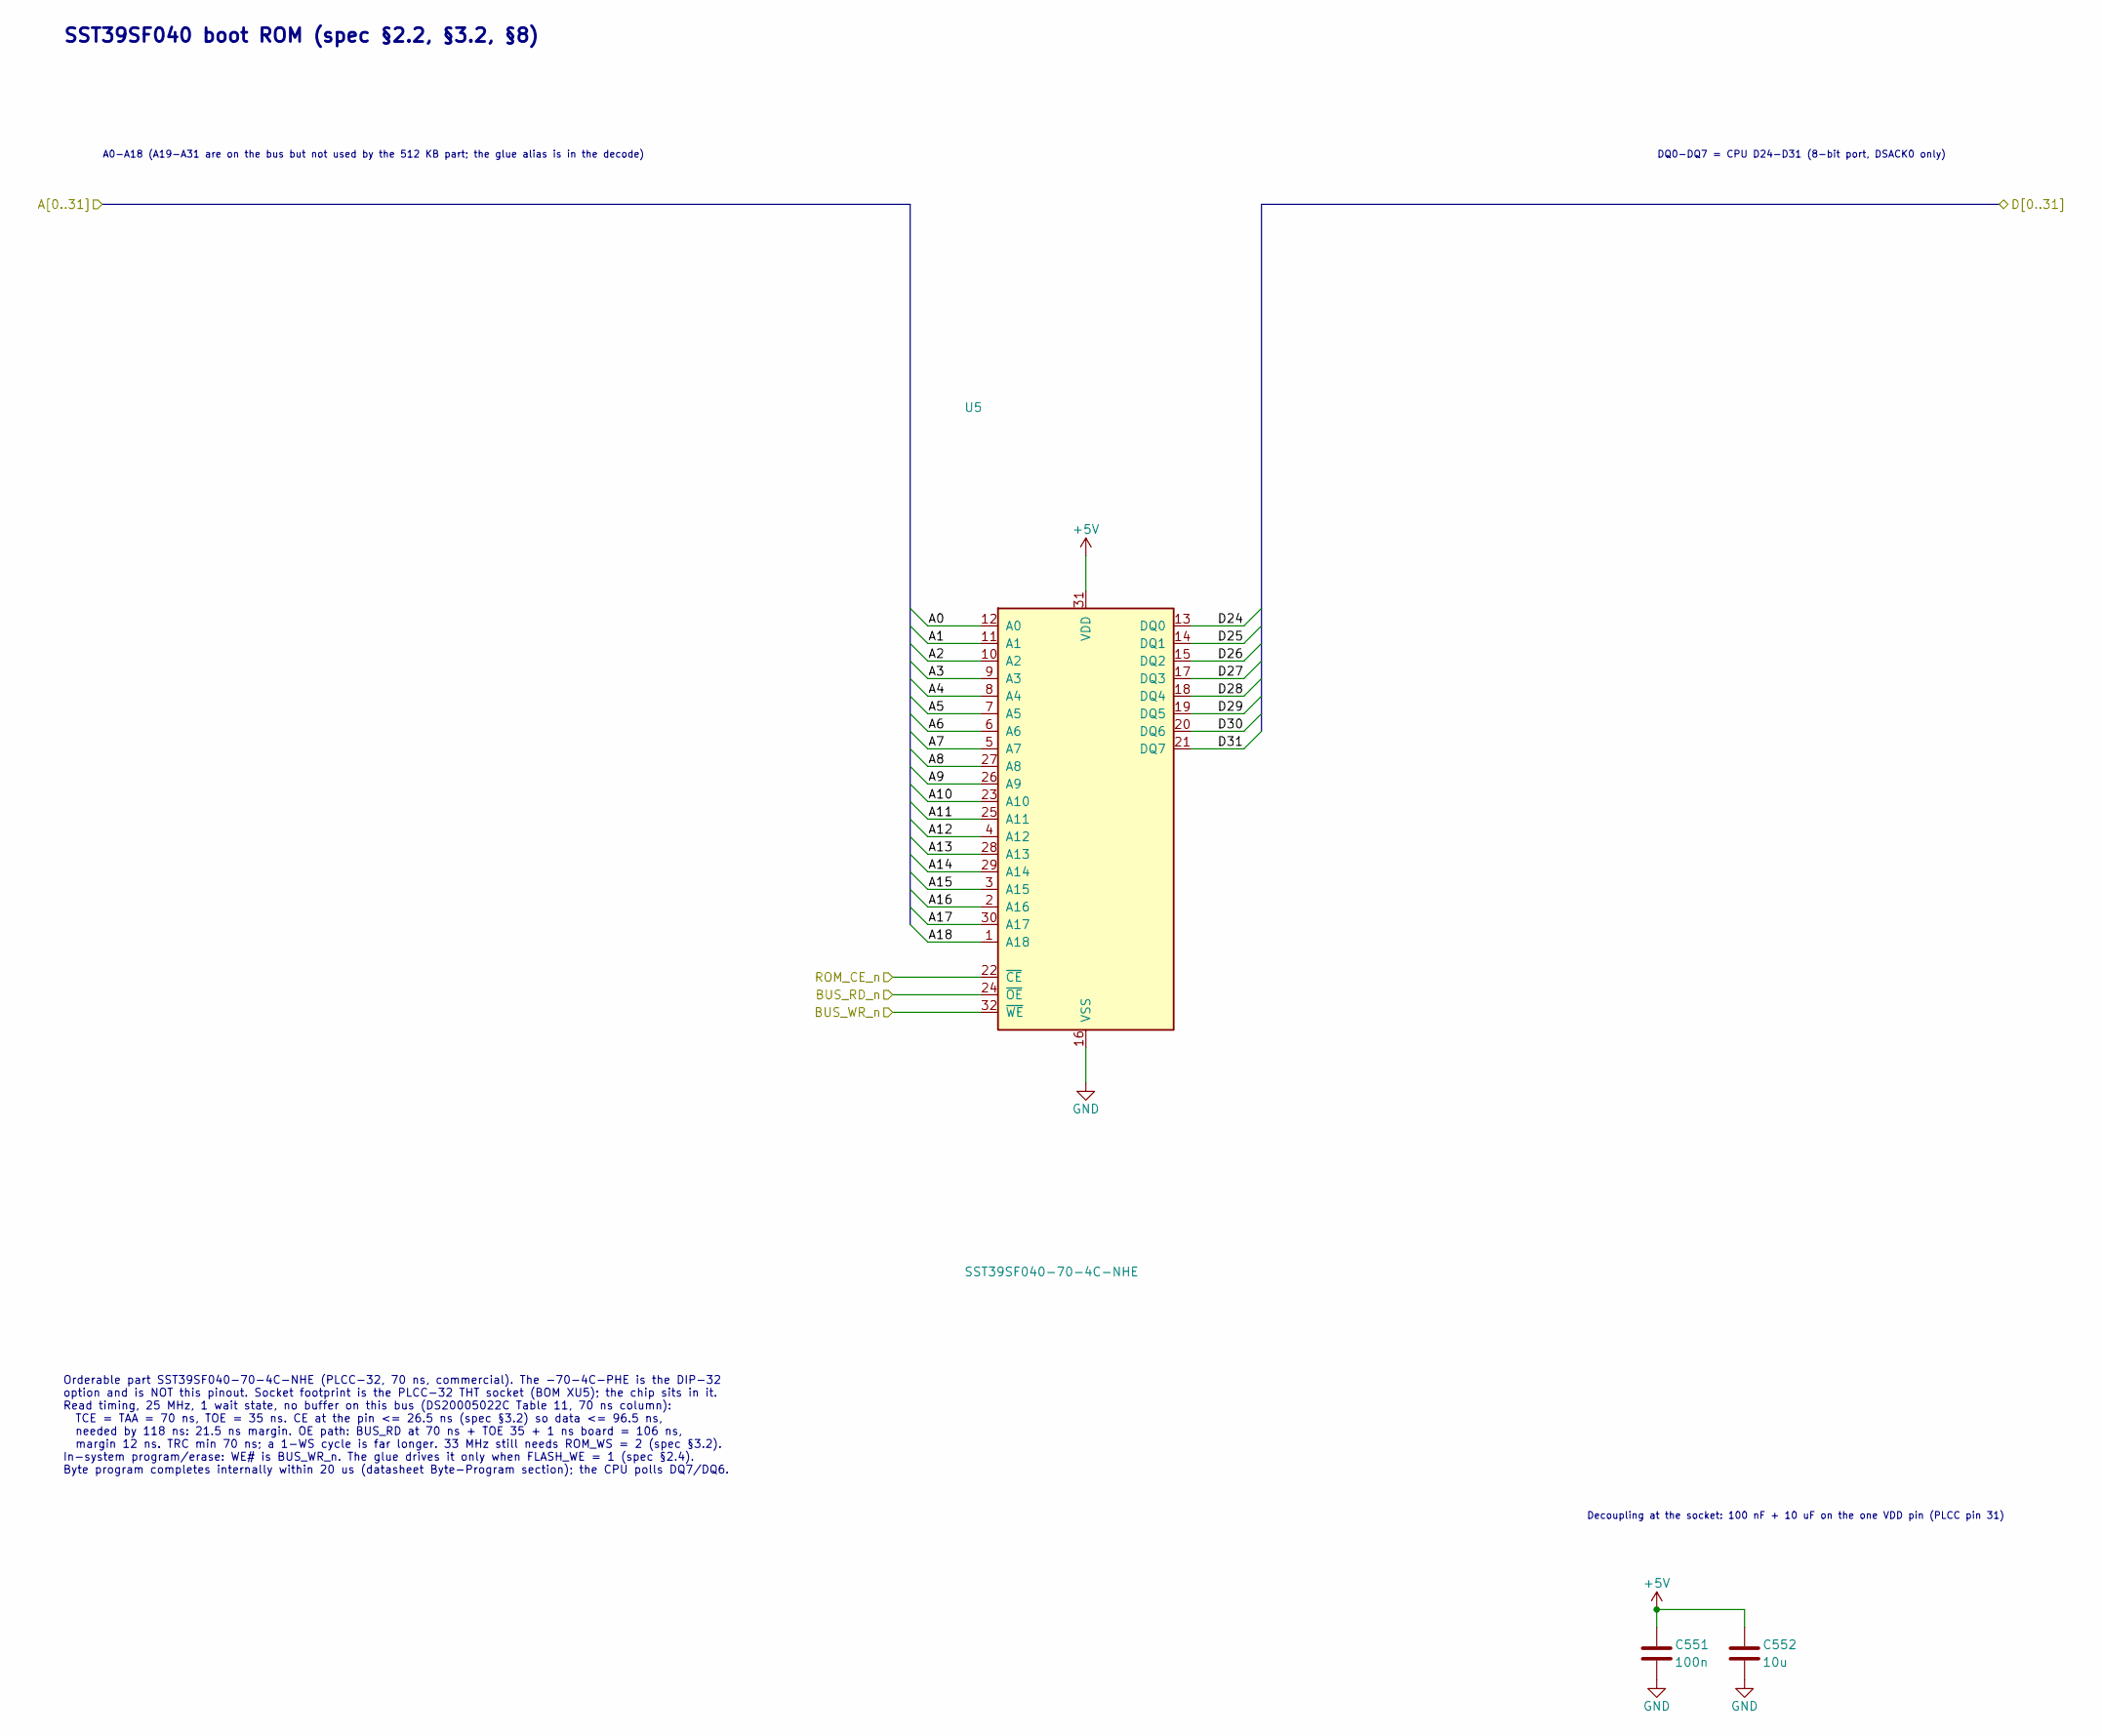
[picture p49: schematic rom.kicad_sch, Boot flash: SST39SF040-70 (PLCC-32) at E000_0000]

Parts:
C551: 100n; C_0805_2012Metric
C552: 10u; C_1206_3216Metric
U5: SST39SF040-70-4C-NHE; PLCC-32_THT-Socket; MPN SST39SF040-70-4C-NHE

Connections:
+5V: C551.1, C552.1, U5.31 (VDD); also elsewhere on the board
/A0: U5.12 (A0); also elsewhere on the board
/A1: U5.11 (A1); also elsewhere on the board
/A2: U5.10 (A2); also elsewhere on the board
/A3: U5.9 (A3); also elsewhere on the board
/A4: U5.8 (A4); also elsewhere on the board
/A5: U5.7 (A5); also elsewhere on the board
/A6: U5.6 (A6); also elsewhere on the board
/A7: U5.5 (A7); also elsewhere on the board
/A8: U5.27 (A8); also elsewhere on the board
/A9: U5.26 (A9); also elsewhere on the board
/A10: U5.23 (A10); also elsewhere on the board
/A11: U5.25 (A11); also elsewhere on the board
/A12: U5.4 (A12); also elsewhere on the board
/A13: U5.28 (A13); also elsewhere on the board
/A14: U5.29 (A14); also elsewhere on the board
/A15: U5.3 (A15); also elsewhere on the board
/A16: U5.2 (A16); also elsewhere on the board
/A17: U5.30 (A17); also elsewhere on the board
/A18: U5.1 (A18); also elsewhere on the board
/BUS_RD_n: U5.24 (~OE); also elsewhere on the board
/BUS_WR_n: U5.32 (~WE); also elsewhere on the board
/D24: U5.13 (DQ0); also elsewhere on the board
/D25: U5.14 (DQ1); also elsewhere on the board
/D26: U5.15 (DQ2); also elsewhere on the board
/D27: U5.17 (DQ3); also elsewhere on the board
/D28: U5.18 (DQ4); also elsewhere on the board
/D29: U5.19 (DQ5); also elsewhere on the board
/D30: U5.20 (DQ6); also elsewhere on the board
/D31: U5.21 (DQ7); also elsewhere on the board
/ROM_CE_n: U5.22 (~CE); also elsewhere on the board
GND: C551.2, C552.2, U5.16 (VSS); also elsewhere on the board

Notes on the sheet:
A0-A18 (A19-A31 are on the bus but not used by the 512 KB part; the glue alias is in the decode)
DQ0-DQ7 = CPU D24-D31 (8-bit port, DSACK0 only)
Decoupling at the socket: 100 nF + 10 uF on the one VDD pin (PLCC pin 31)
SST39SF040 boot ROM (spec §2.2, §3.2, §8)
Orderable part SST39SF040-70-4C-NHE (PLCC-32, 70 ns, commercial). The -70-4C-PHE is the DIP-32 option and is NOT this pinout. Socket footprint is the PLCC-32 THT socket (BOM XU5); the chip sits in it. Read timing, 25 MHz, 1 wait state, no buffer on this bus (DS20005022C Table 11, 70 ns column): TCE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

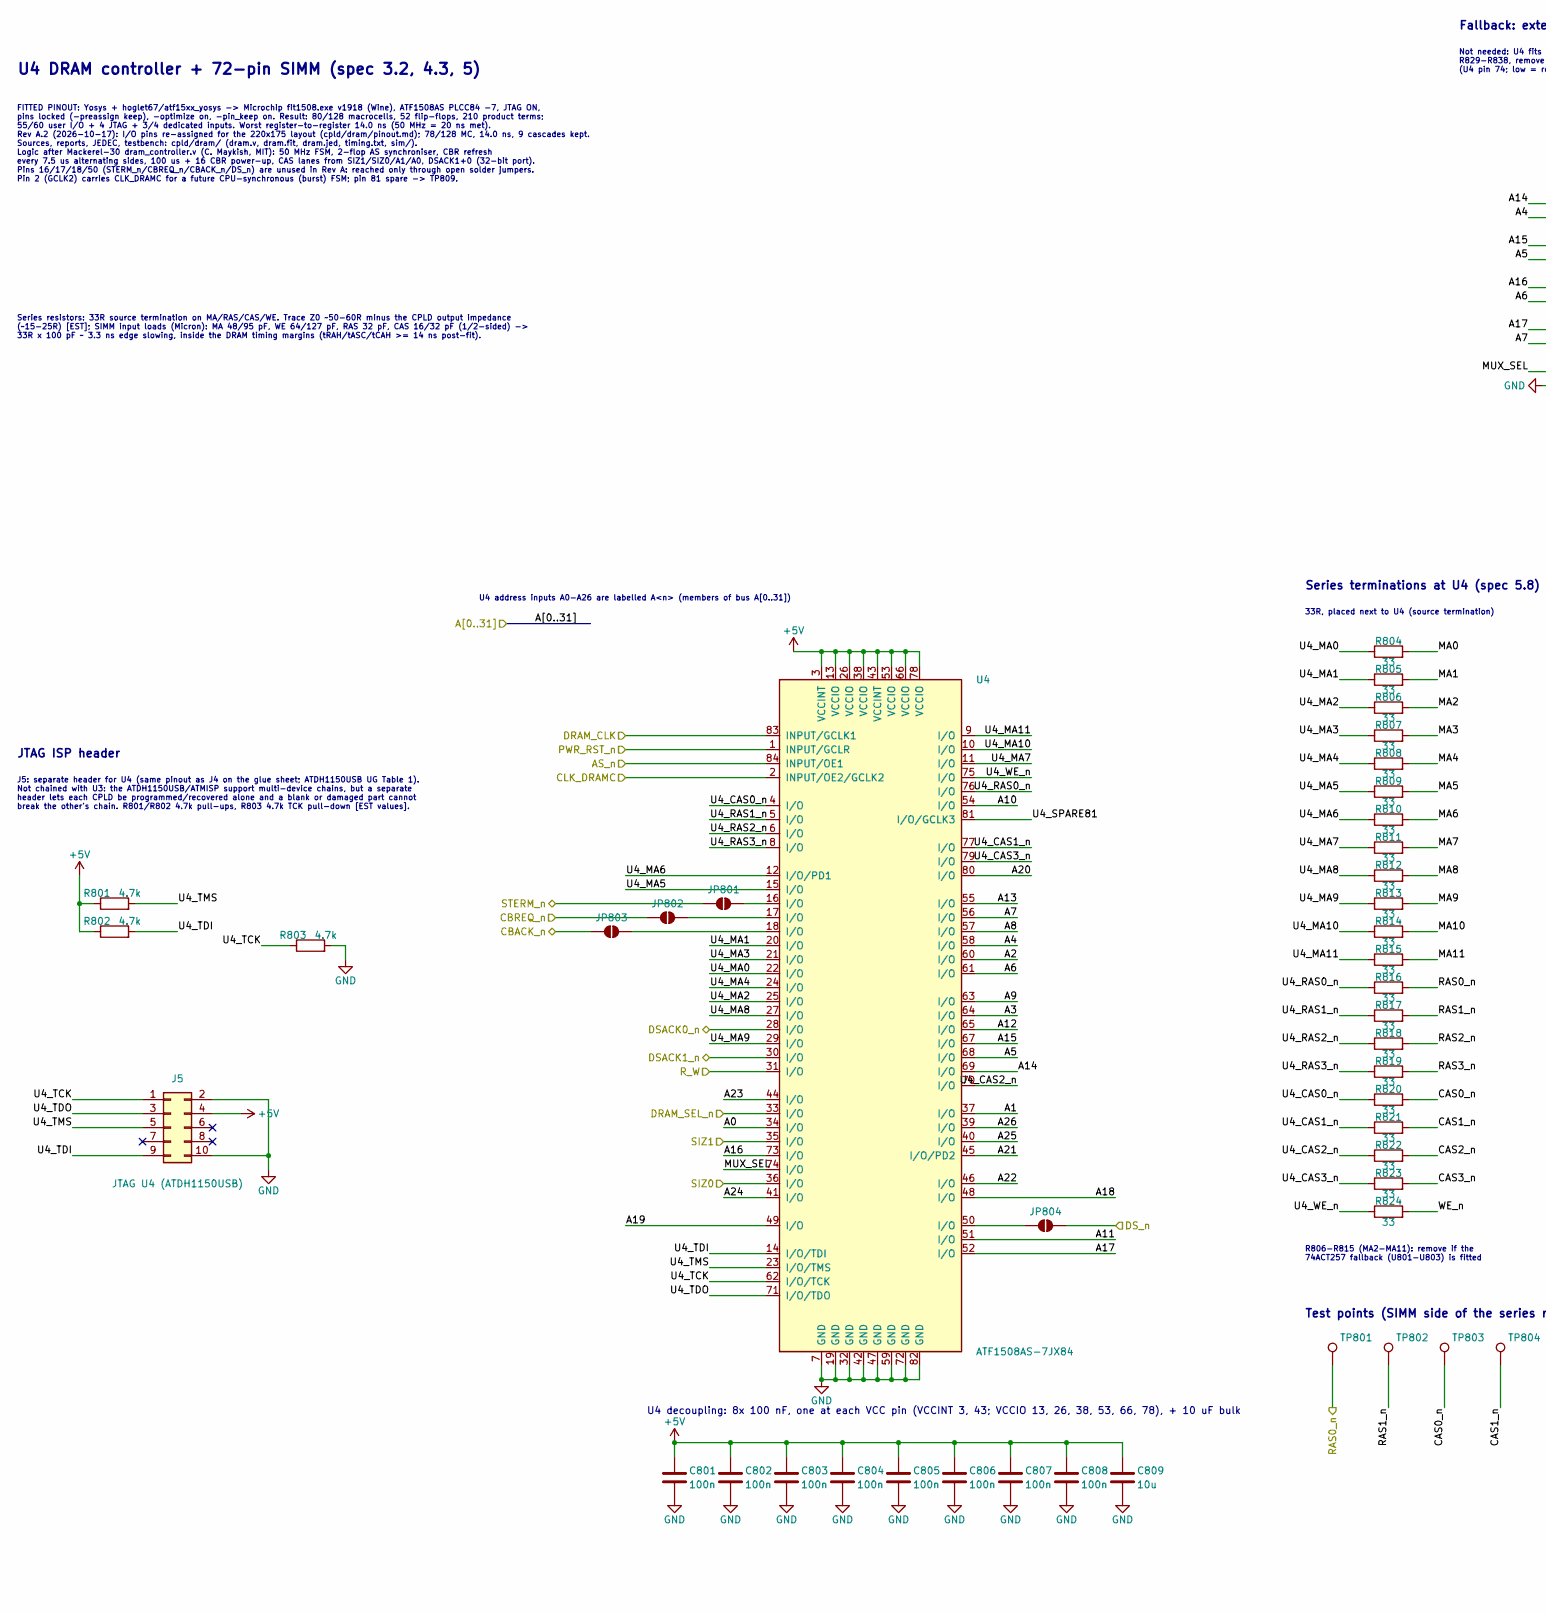
[picture p50: schematic dram.kicad_sch, DRAM controller CPLD U4 (ATF1508AS-7JX84) + 72-pin SIMM J1, part in row 1, column 1]

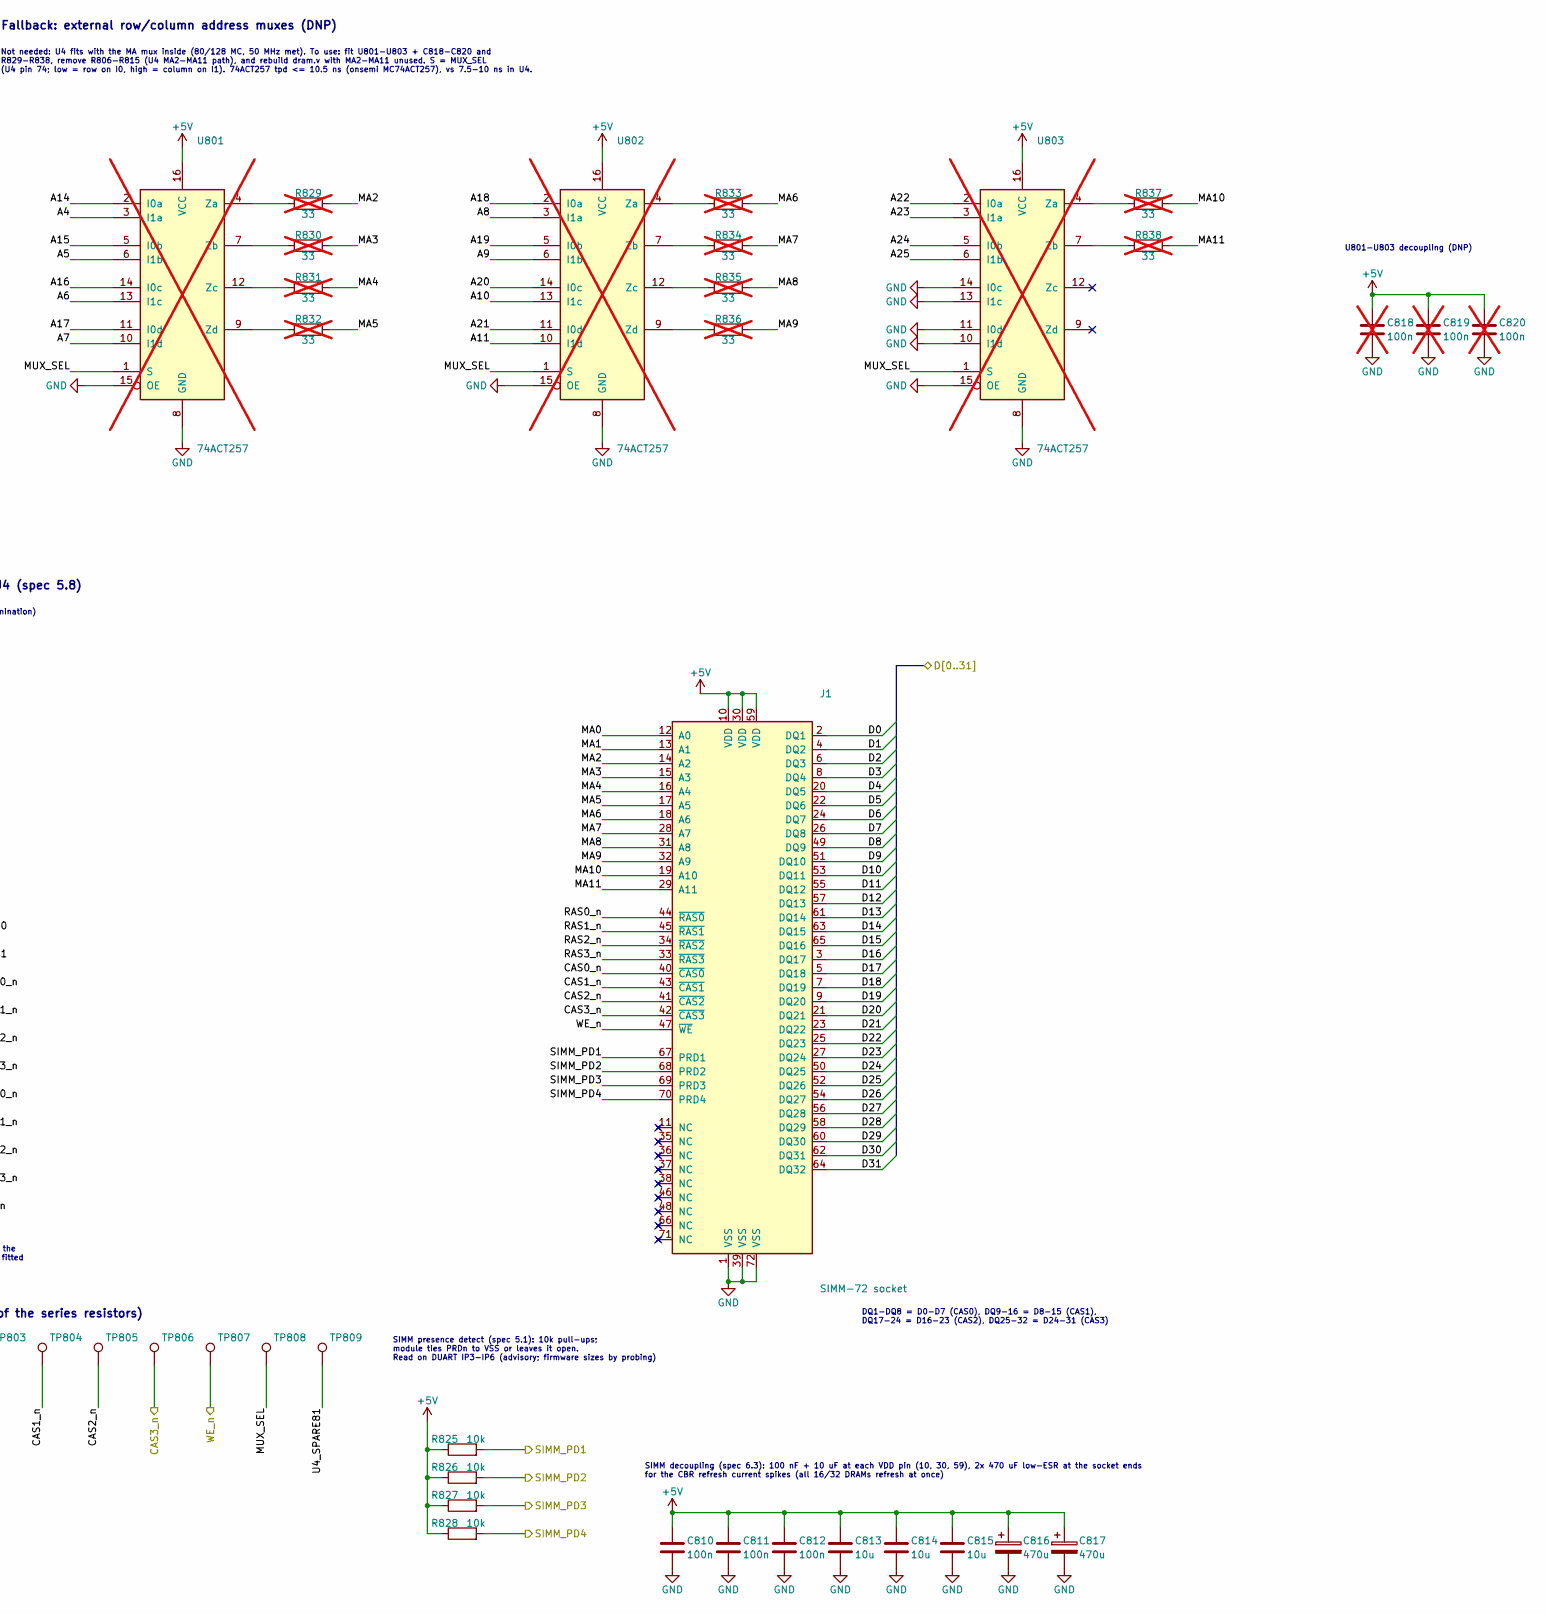
[picture p51: schematic dram.kicad_sch, DRAM controller CPLD U4 (ATF1508AS-7JX84) + 72-pin SIMM J1, part in row 1, column 2]

Parts:
C801, C802, C803, C804, C805, C806, C807, C808, C810, C811, C812: 100n; C_0805_2012Metric
C809, C813, C814, C815: 10u; C_1206_3216Metric
C816, C817: 470u; CP_Radial_D10.0mm_P5.00mm
C818, C819, C820: 100n; C_0805_2012Metric; not fitted
J1: SIMM-72 socket; SIMM-72_TE-5822021-4; MPN TE 5822021-4
J5: JTAG U4 (ATDH1150USB); IDC-Header_2x05_P2.54mm_Vertical
JP801, JP802, JP803, JP804: open; SolderJumper-2_P1.3mm_Open_RoundedPad1.0x1.5mm
R801, R802, R803: 4.7k; R_0603_1608Metric
R804, R805, R806, R807, R808, R809, R810, R811, R812, R813, R814, R815, R816, R817, R818, R819, R820, R821, R822, R823, R824: 33; R_0603_1608Metric
R825, R826, R827, R828: 10k; R_0603_1608Metric
R829, R830, R831, R832, R833, R834, R835, R836, R837, R838: 33; R_0603_1608Metric; not fitted
TP801: RAS0#; TestPoint_Pad_D1.5mm
TP802: RAS1#; TestPoint_Pad_D1.5mm
TP803: CAS0#; TestPoint_Pad_D1.5mm
TP804: CAS1#; TestPoint_Pad_D1.5mm
TP805: CAS2#; TestPoint_Pad_D1.5mm
TP806: CAS3#; TestPoint_Pad_D1.5mm
TP807: WE#; TestPoint_Pad_D1.5mm
TP808: MUX_SEL; TestPoint_Pad_D1.5mm
TP809: U4-81; TestPoint_Pad_D1.5mm
U4: ATF1508AS-7JX84; PLCC-84_THT-Socket; MPN ATF1508AS-7JX84
U801, U802, U803: 74ACT257; SOIC-16_3.9x9.9mm_P1.27mm; MPN MC74ACT257DR2G; not fitted

Connections:
+5V: C801.1, C802.1, C803.1, C804.1, C805.1, C806.1, C807.1, C808.1, C809.1, C810.1, C811.1, C812.1, C813.1, C814.1, C815.1, C816.1, C817.1, C818.1, C819.1, C820.1, J1.10 (VDD), J1.30 (VDD), J1.59 (VDD), J5.4, R801.1, R802.1, R825.1, R826.1, R827.1, R828.1, U4.3 (VCCINT), U4.13 (VCCIO), U4.26 (VCCIO), U4.38 (VCCIO), U4.43 (VCCINT), U4.53 (VCCIO), U4.66 (VCCIO), U4.78 (VCCIO), U801.16 (VCC), U802.16 (VCC), U803.16 (VCC); also elsewhere on the board
/A0: U4.34 (I/O); also elsewhere on the board
/A1: U4.37 (I/O); also elsewhere on the board
/A2: U4.60 (I/O); also elsewhere on the board
/A3: U4.64 (I/O); also elsewhere on the board
/A4: U4.58 (I/O), U801.3 (I1a); also elsewhere on the board
/A5: U4.68 (I/O), U801.6 (I1b); also elsewhere on the board
/A6: U4.61 (I/O), U801.13 (I1c); also elsewhere on the board
/A7: U4.56 (I/O), U801.10 (I1d); also elsewhere on the board
/A8: U4.57 (I/O), U802.3 (I1a); also elsewhere on the board
/A9: U4.63 (I/O), U802.6 (I1b); also elsewhere on the board
/A10: U4.54 (I/O), U802.13 (I1c); also elsewhere on the board
/A11: U4.51 (I/O), U802.10 (I1d); also elsewhere on the board
/A12: U4.65 (I/O); also elsewhere on the board
/A13: U4.55 (I/O); also elsewhere on the board
/A14: U4.69 (I/O), U801.2 (I0a); also elsewhere on the board
/A15: U4.67 (I/O), U801.5 (I0b); also elsewhere on the board
/A16: U4.73 (I/O), U801.14 (I0c); also elsewhere on the board
/A17: U4.52 (I/O), U801.11 (I0d); also elsewhere on the board
/A18: U4.48 (I/O), U802.2 (I0a); also elsewhere on the board
/A19: U4.49 (I/O), U802.5 (I0b); also elsewhere on the board
/A20: U4.80 (I/O), U802.14 (I0c); also elsewhere on the board
/A21: U4.45 (I/O/PD2), U802.11 (I0d); also elsewhere on the board
/A22: U4.46 (I/O), U803.2 (I0a); also elsewhere on the board
/A23: U4.44 (I/O), U803.3 (I1a); also elsewhere on the board
/A24: U4.41 (I/O), U803.5 (I0b); also elsewhere on the board
/A25: U4.40 (I/O), U803.6 (I1b); also elsewhere on the board
/A26: U4.39 (I/O); also elsewhere on the board
/AS_n: U4.84 (INPUT/OE1); also elsewhere on the board
/CAS3_n: J1.42 (~CAS3), R823.2, TP806.1
/CBACK_n: JP803.1 (A); also elsewhere on the board
/CBREQ_n: JP802.1 (A); also elsewhere on the board
/CLK_DRAMC: U4.2 (INPUT/OE2/GCLK2); also elsewhere on the board
/D0: J1.2 (DQ1); also elsewhere on the board
/D1: J1.4 (DQ2); also elsewhere on the board
/D2: J1.6 (DQ3); also elsewhere on the board
/D3: J1.8 (DQ4); also elsewhere on the board
/D4: J1.20 (DQ5); also elsewhere on the board
/D5: J1.22 (DQ6); also elsewhere on the board
/D6: J1.24 (DQ7); also elsewhere on the board
/D7: J1.26 (DQ8); also elsewhere on the board
/D8: J1.49 (DQ9); also elsewhere on the board
/D9: J1.51 (DQ10); also elsewhere on the board
/D10: J1.53 (DQ11); also elsewhere on the board
/D11: J1.55 (DQ12); also elsewhere on the board
/D12: J1.57 (DQ13); also elsewhere on the board
/D13: J1.61 (DQ14); also elsewhere on the board
/D14: J1.63 (DQ15); also elsewhere on the board
/D15: J1.65 (DQ16); also elsewhere on the board
/D16: J1.3 (DQ17); also elsewhere on the board
/D17: J1.5 (DQ18); also elsewhere on the board
/D18: J1.7 (DQ19); also elsewhere on the board
/D19: J1.9 (DQ20); also elsewhere on the board
/D20: J1.21 (DQ21); also elsewhere on the board
/D21: J1.23 (DQ22); also elsewhere on the board
/D22: J1.25 (DQ23); also elsewhere on the board
/D23: J1.27 (DQ24); also elsewhere on the board
/D24: J1.50 (DQ25); also elsewhere on the board
/D25: J1.52 (DQ26); also elsewhere on the board
/D26: J1.54 (DQ27); also elsewhere on the board
/D27: J1.56 (DQ28); also elsewhere on the board
/D28: J1.58 (DQ29); also elsewhere on the board
/D29: J1.60 (DQ30); also elsewhere on the board
/D30: J1.62 (DQ31); also elsewhere on the board
/D31: J1.64 (DQ32); also elsewhere on the board
/DRAM_CLK: U4.83 (INPUT/GCLK1); also elsewhere on the board
/DRAM_SEL_n: U4.33 (I/O); also elsewhere on the board
/DSACK0_n: U4.28 (I/O); also elsewhere on the board
/DSACK1_n: U4.30 (I/O); also elsewhere on the board
/DS_n: JP804.2 (B); also elsewhere on the board
/PWR_RST_n: U4.1 (INPUT/GCLR); also elsewhere on the board
/RAS0_n: J1.44 (~RAS0), R816.2, TP801.1
/R_W: U4.31 (I/O); also elsewhere on the board
/SIMM_PD1: J1.67 (PRD1), R825.2; also elsewhere on the board
/SIMM_PD2: J1.68 (PRD2), R826.2; also elsewhere on the board
/SIMM_PD3: J1.69 (PRD3), R827.2; also elsewhere on the board
/SIMM_PD4: J1.70 (PRD4), R828.2; also elsewhere on the board
/SIZ0: U4.36 (I/O); also elsewhere on the board
/SIZ1: U4.35 (I/O); also elsewhere on the board
/STERM_n: JP801.1 (A); also elsewhere on the board
/WE_n: J1.47 (~WE), R824.2, TP807.1
/dram/CAS0_n: J1.40 (~CAS0), R820.2, TP803.1
/dram/CAS1_n: J1.43 (~CAS1), R821.2, TP804.1
/dram/CAS2_n: J1.41 (~CAS2), R822.2, TP805.1
/dram/MA0: J1.12 (A0), R804.2
/dram/MA1: J1.13 (A1), R805.2
/dram/MA2: J1.14 (A2), R806.2, R829.2
/dram/MA3: J1.15 (A3), R807.2, R830.2
/dram/MA4: J1.16 (A4), R808.2, R831.2
/dram/MA5: J1.17 (A5), R809.2, R832.2
/dram/MA6: J1.18 (A6), R810.2, R833.2
/dram/MA7: J1.28 (A7), R811.2, R834.2
/dram/MA8: J1.31 (A8), R812.2, R835.2
/dram/MA9: J1.32 (A9), R813.2, R836.2
/dram/MA10: J1.19 (A10), R814.2, R837.2
/dram/MA11: J1.29 (A11), R815.2, R838.2
/dram/MUX_SEL: TP808.1, U4.74 (I/O), U801.1 (S), U802.1 (S), U803.1 (S)
/dram/RAS1_n: J1.45 (~RAS1), R817.2, TP802.1
/dram/RAS2_n: J1.34 (~RAS2), R818.2
/dram/RAS3_n: J1.33 (~RAS3), R819.2
/dram/U4_CAS0_n: R820.1, U4.4 (I/O)
/dram/U4_CAS1_n: R821.1, U4.77 (I/O)
/dram/U4_CAS2_n: R822.1, U4.70 (I/O)
/dram/U4_CAS3_n: R823.1, U4.79 (I/O)
/dram/U4_MA0: R804.1, U4.22 (I/O)
/dram/U4_MA1: R805.1, U4.20 (I/O)
/dram/U4_MA2: R806.1, U4.25 (I/O)
/dram/U4_MA3: R807.1, U4.21 (I/O)
/dram/U4_MA4: R808.1, U4.24 (I/O)
/dram/U4_MA5: R809.1, U4.15 (I/O)
/dram/U4_MA6: R810.1, U4.12 (I/O/PD1)
/dram/U4_MA7: R811.1, U4.11 (I/O)
/dram/U4_MA8: R812.1, U4.27 (I/O)
/dram/U4_MA9: R813.1, U4.29 (I/O)
/dram/U4_MA10: R814.1, U4.10 (I/O)
/dram/U4_MA11: R815.1, U4.9 (I/O)
/dram/U4_RAS0_n: R816.1, U4.76 (I/O)
/dram/U4_RAS1_n: R817.1, U4.5 (I/O)
/dram/U4_RAS2_n: R818.1, U4.6 (I/O)
/dram/U4_RAS3_n: R819.1, U4.8 (I/O)
/dram/U4_SPARE81: TP809.1, U4.81 (I/O/GCLK3)
/dram/U4_TCK: J5.1, R803.1, U4.62 (I/O/TCK)
/dram/U4_TDI: J5.9, R802.2, U4.14 (I/O/TDI)
/dram/U4_TDO: J5.3, U4.71 (I/O/TDO)
/dram/U4_TMS: J5.5, R801.2, U4.23 (I/O/TMS)
/dram/U4_WE_n: R824.1, U4.75 (I/O)
GND: C801.2, C802.2, C803.2, C804.2, C805.2, C806.2, C807.2, C808.2, C809.2, C810.2, C811.2, C812.2, C813.2, C814.2, C815.2, C816.2, C817.2, C818.2, C819.2, C820.2, J1.1 (VSS), J1.39 (VSS), J1.72 (VSS), J5.2, J5.10, R803.2, U4.7 (GND), U4.19 (GND), U4.32 (GND), U4.42 (GND), U4.47 (GND), U4.59 (GND), U4.72 (GND), U4.82 (GND), U801.8 (GND), U801.15 (OE), U802.8 (GND), U802.15 (OE), U803.8 (GND), U803.10 (I1d), U803.11 (I0d), U803.13 (I1c), U803.14 (I0c), U803.15 (OE); also elsewhere on the board
unnamed: JP801.2 (B), U4.16 (I/O)
unnamed: JP802.2 (B), U4.17 (I/O)
unnamed: JP803.2 (B), U4.18 (I/O)
unnamed: JP804.1 (A), U4.50 (I/O)
unnamed: R829.1, U801.4 (Za)
unnamed: R830.1, U801.7 (Zb)
unnamed: R831.1, U801.12 (Zc)
unnamed: R832.1, U801.9 (Zd)
unnamed: R833.1, U802.4 (Za)
unnamed: R834.1, U802.7 (Zb)
unnamed: R835.1, U802.12 (Zc)
unnamed: R836.1, U802.9 (Zd)
unnamed: R837.1, U803.4 (Za)
unnamed: R838.1, U803.7 (Zb)

Notes on the sheet:
U4 address inputs A0-A26 are labelled A<n> (members of bus A[0..31])
U4 decoupling: 8x 100 nF, one at each VCC pin (VCCINT 3, 43; VCCIO 13, 26, 38, 53, 66, 78), + 10 uF bulk
Series terminations at U4 (spec 5.8)
33R, placed next to U4 (source termination)
R806-R815 (MA2-MA11): remove if the 74ACT257 fallback (U801-U803) is fitted
DQ1-DQ8 = D0-D7 (CAS0), DQ9-16 = D8-15 (CAS1), DQ17-24 = D16-23 (CAS2), DQ25-32 = D24-31 (CAS3)
SIMM presence detect (spec 5.1): 10k pull-ups; module ties PRDn to VSS or leaves it open. Read on DUART IP3-IP6 (advisory; firmware sizes by probing)
SIMM decoupling (spec 6.3): 100 nF + 10 uF at each VDD pin (10, 30, 59), 2x 470 uF low-ESR at the socket ends for the CBR refresh current spikes (all 16/32 DRAMs refresh at once)
Test points (SIMM side of the series resistors)
JTAG ISP header
J5: separate header for U4 (same pinout as J4 on the glue sheet; ATDH1150USB UG Table 1). Not chained with U3: the ATDH1150USB/ATMISP support multi-device chains, but a separate header lets each CPLD be programmed/recovered alone and a blank or damaged part cannot break the other's chain. R801/R802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
Fallback: external row/column address muxes (DNP)
Not needed: U4 fits with the MA mux inside (80/128 MC, 50 MHz met). To use: fit U801-U803 + C818-C820 and R829-R838, remove R806-R815 (U4 MA2-MA11 path), and rebuild dram.v with MA2-MA11 unused. S = MUX_SEL (U4 pin 74; low = row on I0, high = column on I1). 74ACT257 tpd <= 10.5 ns (onsemi MC74ACT25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
U801-U803 decoupling (DNP)
U4 DRAM controller + 72-pin SIMM (spec 3.2, 4.3, 5)
FITTED PINOUT: Yosys + hoglet67/atf15xx_yosys -> Microchip fit1508.exe v1918 (Wine), ATF1508AS PLCC84 -7, JTAG ON, pins locked (-preassign keep), -optimize on, -pin_keep on. Result: 80/128 macrocells, 52 flip-flops, 210 product terms; 55/60 user I/O + 4 JTAG + 3/4 dedicated inputs. Worst register-t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
Series resistors: 33R source termination on MA/RAS/CAS/WE. Trace Z0 ~50-60R minus the CPLD output impedance (~15-25R) [EST]; SIMM input loads (Micron): MA 48/95 pF, WE 64/127 pF, RAS 32 pF, CAS 16/32 pF (1/2-sided) -> 33R x 100 pF ~ 3.3 ns edge slowing, inside the DRAM timing margins (tRAH/tASC/tCA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

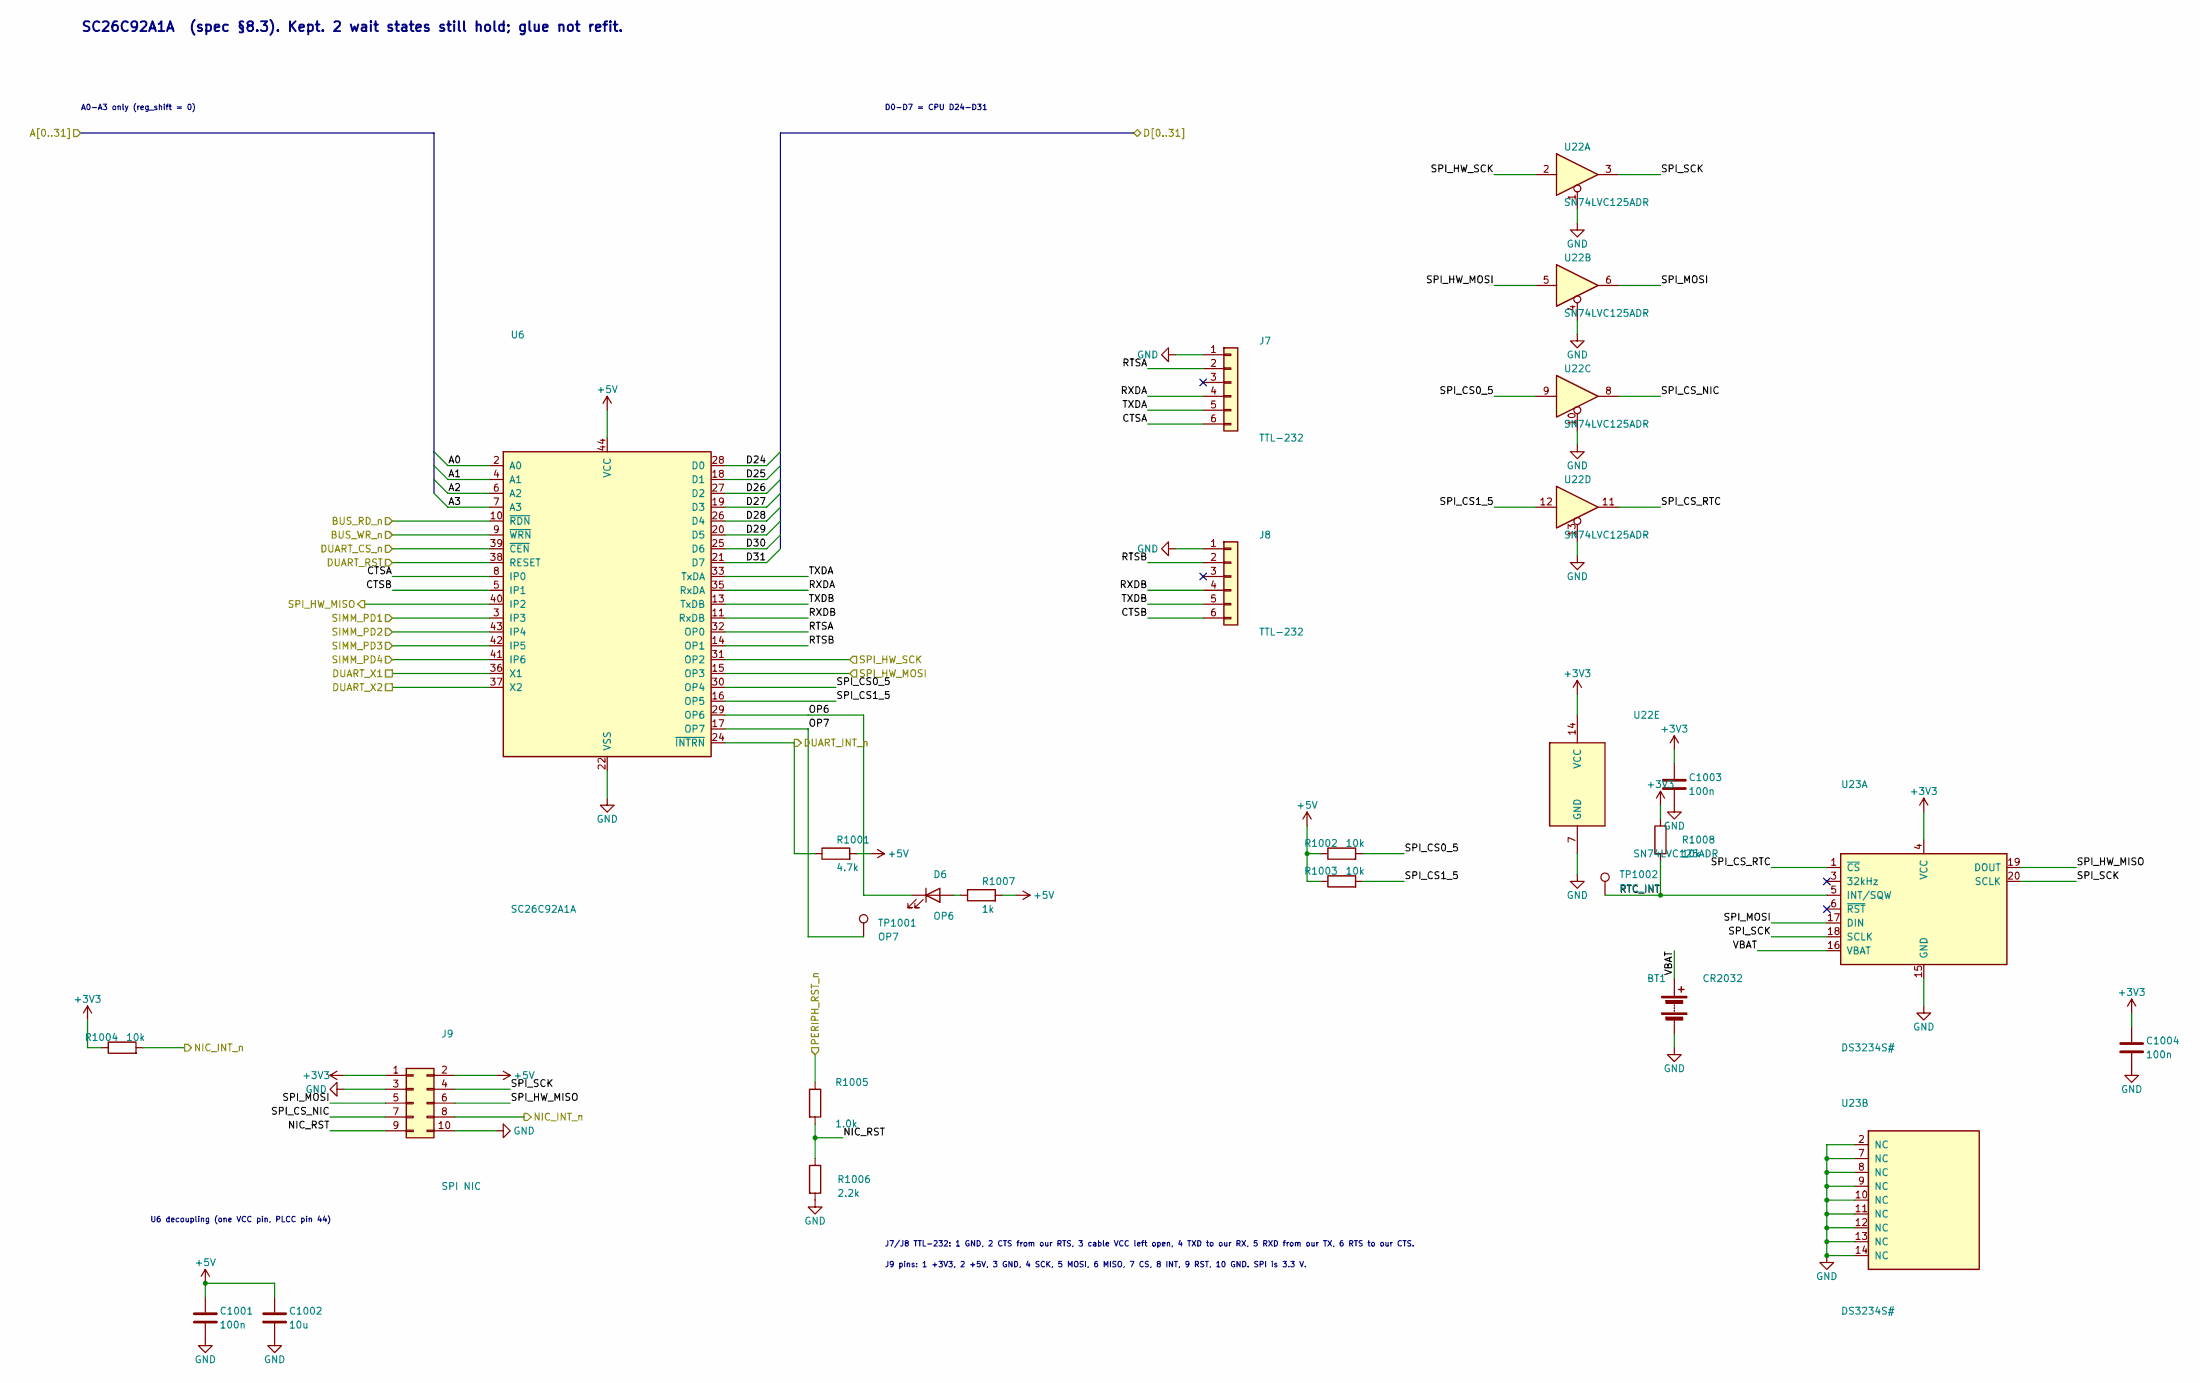
[picture p52: schematic duart_spi_rtc.kicad_sch, DUART SC26C92, bit-bang SPI, DS3234, NIC header]

Parts:
BT1: CR2032; BatteryHolder_Keystone_3034_1x20mm; MPN Keystone 3034
C1001: 100n; C_0805_2012Metric
C1002: 10u; C_1206_3216Metric
C1003, C1004: 100n; C_0603_1608Metric
D6: OP6; LED_0805_2012Metric
J7, J8: TTL-232; PinHeader_1x06_P2.54mm_Vertical
J9: SPI NIC; PinHeader_2x05_P2.54mm_Vertical
R1001: 4.7k; R_0603_1608Metric
R1002, R1003, R1004, R1008: 10k; R_0603_1608Metric
R1005: 1.0k; R_0603_1608Metric
R1006: 2.2k; R_0603_1608Metric
R1007: 1k; R_0603_1608Metric
TP1001: OP7; TestPoint_Pad_D1.5mm
TP1002: RTC_INT; TestPoint_Pad_D1.5mm
U6: SC26C92A1A; PLCC-44_THT-Socket; MPN SC26C92A1A
U22: SN74LVC125ADR; SOIC-14_3.9x8.7mm_P1.27mm; MPN SN74LVC125ADR
U23: DS3234S#; SOIC-20W_7.5x12.8mm_P1.27mm; MPN DS3234S#

Connections:
+3V3: C1003.1, C1004.1, J9.1, R1004.1, R1008.1, U22.14 (VCC), U23.4 (VCC); also elsewhere on the board
+5V: C1001.1, C1002.1, J9.2, R1001.2, R1002.1, R1003.1, R1007.2, U6.44 (VCC); also elsewhere on the board
/A0: U6.2 (A0); also elsewhere on the board
/A1: U6.4 (A1); also elsewhere on the board
/A2: U6.6 (A2); also elsewhere on the board
/A3: U6.7 (A3); also elsewhere on the board
/BUS_RD_n: U6.10 (~RDN); also elsewhere on the board
/BUS_WR_n: U6.9 (~WRN); also elsewhere on the board
/D24: U6.28 (D0); also elsewhere on the board
/D25: U6.18 (D1); also elsewhere on the board
/D26: U6.27 (D2); also elsewhere on the board
/D27: U6.19 (D3); also elsewhere on the board
/D28: U6.26 (D4); also elsewhere on the board
/D29: U6.20 (D5); also elsewhere on the board
/D30: U6.25 (D6); also elsewhere on the board
/D31: U6.21 (D7); also elsewhere on the board
/DUART_CS_n: U6.39 (~CEN); also elsewhere on the board
/DUART_INT_n: R1001.1, U6.24 (~INTRN); also elsewhere on the board
/DUART_RST: U6.38 (RESET); also elsewhere on the board
/DUART_X1: U6.36 (X1); also elsewhere on the board
/DUART_X2: U6.37 (X2); also elsewhere on the board
/NIC_INT_n: J9.8, R1004.2; also elsewhere on the board
/PERIPH_RST_n: R1005.1; also elsewhere on the board
/SIMM_PD1: U6.3 (IP3); also elsewhere on the board
/SIMM_PD2: U6.43 (IP4); also elsewhere on the board
/SIMM_PD3: U6.42 (IP5); also elsewhere on the board
/SIMM_PD4: U6.41 (IP6); also elsewhere on the board
/SPI_HW_MISO: J9.6, U6.40 (IP2), U23.19 (DOUT); also elsewhere on the board
/SPI_HW_MOSI: U6.15 (OP3), U22.5; also elsewhere on the board
/SPI_HW_SCK: U6.31 (OP2), U22.2; also elsewhere on the board
/duart_spi_rtc/CTSA: J7.6, U6.8 (IP0)
/duart_spi_rtc/CTSB: J8.6, U6.5 (IP1)
/duart_spi_rtc/NIC_RST: J9.9, R1005.2, R1006.1
/duart_spi_rtc/OP6: D6.1 (K), U6.29 (OP6)
/duart_spi_rtc/OP7: TP1001.1, U6.17 (OP7)
/duart_spi_rtc/RTC_INT: R1008.2, TP1002.1, U23.5 (INT/SQW)
/duart_spi_rtc/RTSA: J7.2, U6.32 (OP0)
/duart_spi_rtc/RTSB: J8.2, U6.14 (OP1)
/duart_spi_rtc/RXDA: J7.4, U6.35 (RxDA)
/duart_spi_rtc/RXDB: J8.4, U6.11 (RxDB)
/duart_spi_rtc/SPI_CS0_5: R1002.2, U6.30 (OP4), U22.9
/duart_spi_rtc/SPI_CS1_5: R1003.2, U6.16 (OP5), U22.12
/duart_spi_rtc/SPI_CS_NIC: J9.7, U22.8
/duart_spi_rtc/SPI_CS_RTC: U22.11, U23.1 (~CS)
/duart_spi_rtc/SPI_MOSI: J9.5, U22.6, U23.17 (DIN)
/duart_spi_rtc/SPI_SCK: J9.4, U22.3, U23.18 (SCLK), U23.20 (SCLK)
/duart_spi_rtc/TXDA: J7.5, U6.33 (TxDA)
/duart_spi_rtc/TXDB: J8.5, U6.13 (TxDB)
/duart_spi_rtc/VBAT: BT1.1 (+), U23.16 (VBAT)
GND: BT1.2 (-), C1001.2, C1002.2, C1003.2, C1004.2, J7.1, J8.1, J9.3, J9.10, R1006.2, U6.22 (VSS), U22.1, U22.4, U22.7 (GND), U22.10, U22.13, U23.2 (NC), U23.7 (NC), U23.8 (NC), U23.9 (NC), U23.10 (NC), U23.11 (NC), U23.12 (NC), U23.13 (NC), U23.14 (NC), U23.15 (GND); also elsewhere on the board
unnamed: D6.2 (A), R1007.1

Notes on the sheet:
A0-A3 only (reg_shift = 0)
D0-D7 = CPU D24-D31
U6 decoupling (one VCC pin, PLCC pin 44)
SC26C92A1A (spec §8.3). Kept. 2 wait states still hold; glue not refit.
J7/J8 TTL-232: 1 GND, 2 CTS from our RTS, 3 cable VCC left open, 4 TXD to our RX, 5 RXD from our TX, 6 RTS to our CTS.
J9 pins: 1 +3V3, 2 +5V, 3 GND, 4 SCK, 5 MOSI, 6 MISO, 7 CS, 8 INT, 9 RST, 10 GND. SPI is 3.3 V.
