mattbettcher/m68030-sbc/68030-design/kicad/m68030-sbc.kicad_pcb

## KiCad design 68030-design/kicad/m68030-sbc.kicad_pcb (continued)

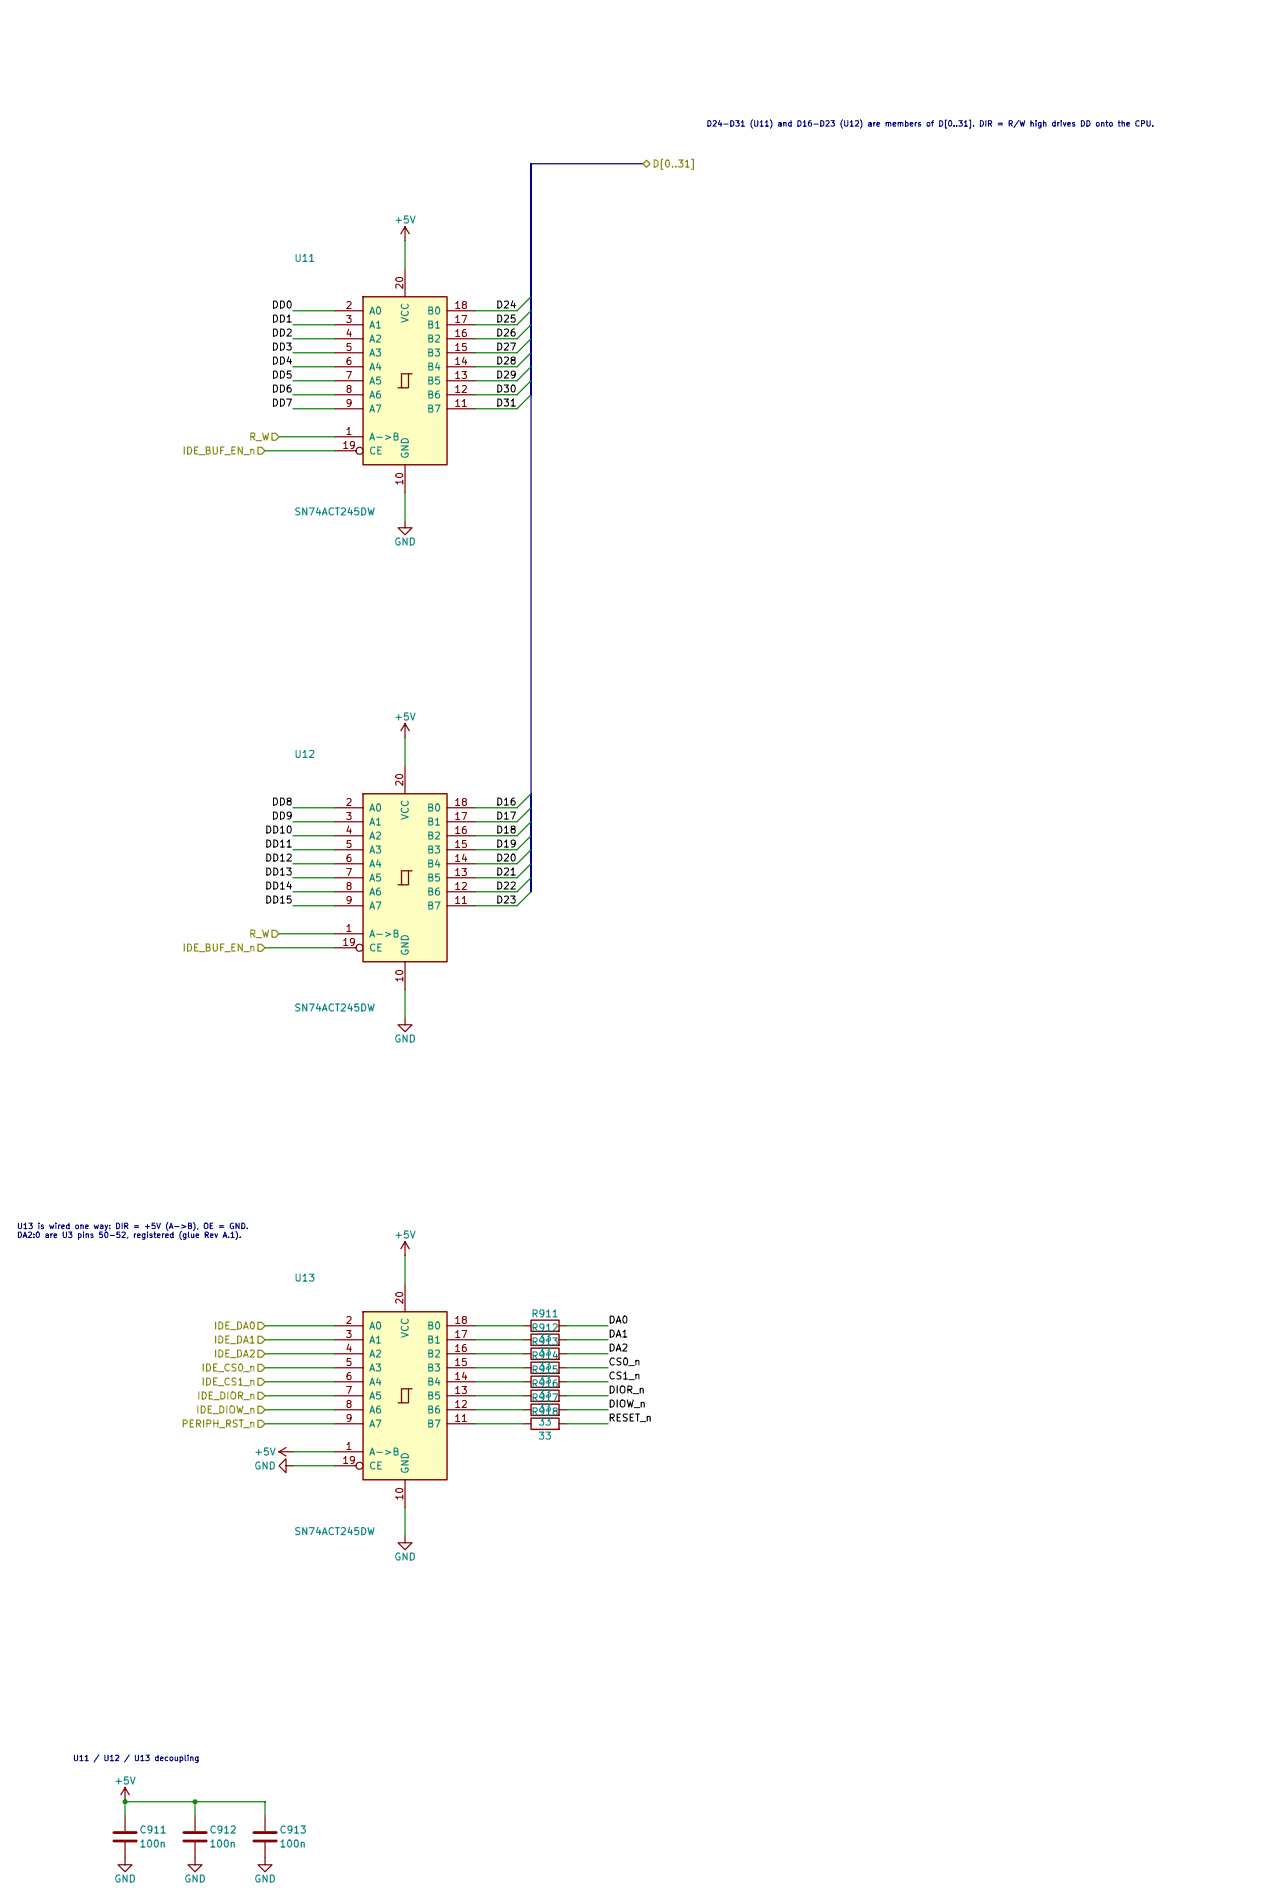
[picture p53: schematic ide.kicad_sch, IDE / CompactFlash: 40-pin header + 3x SN74ACT245N, part in row 1, column 1]

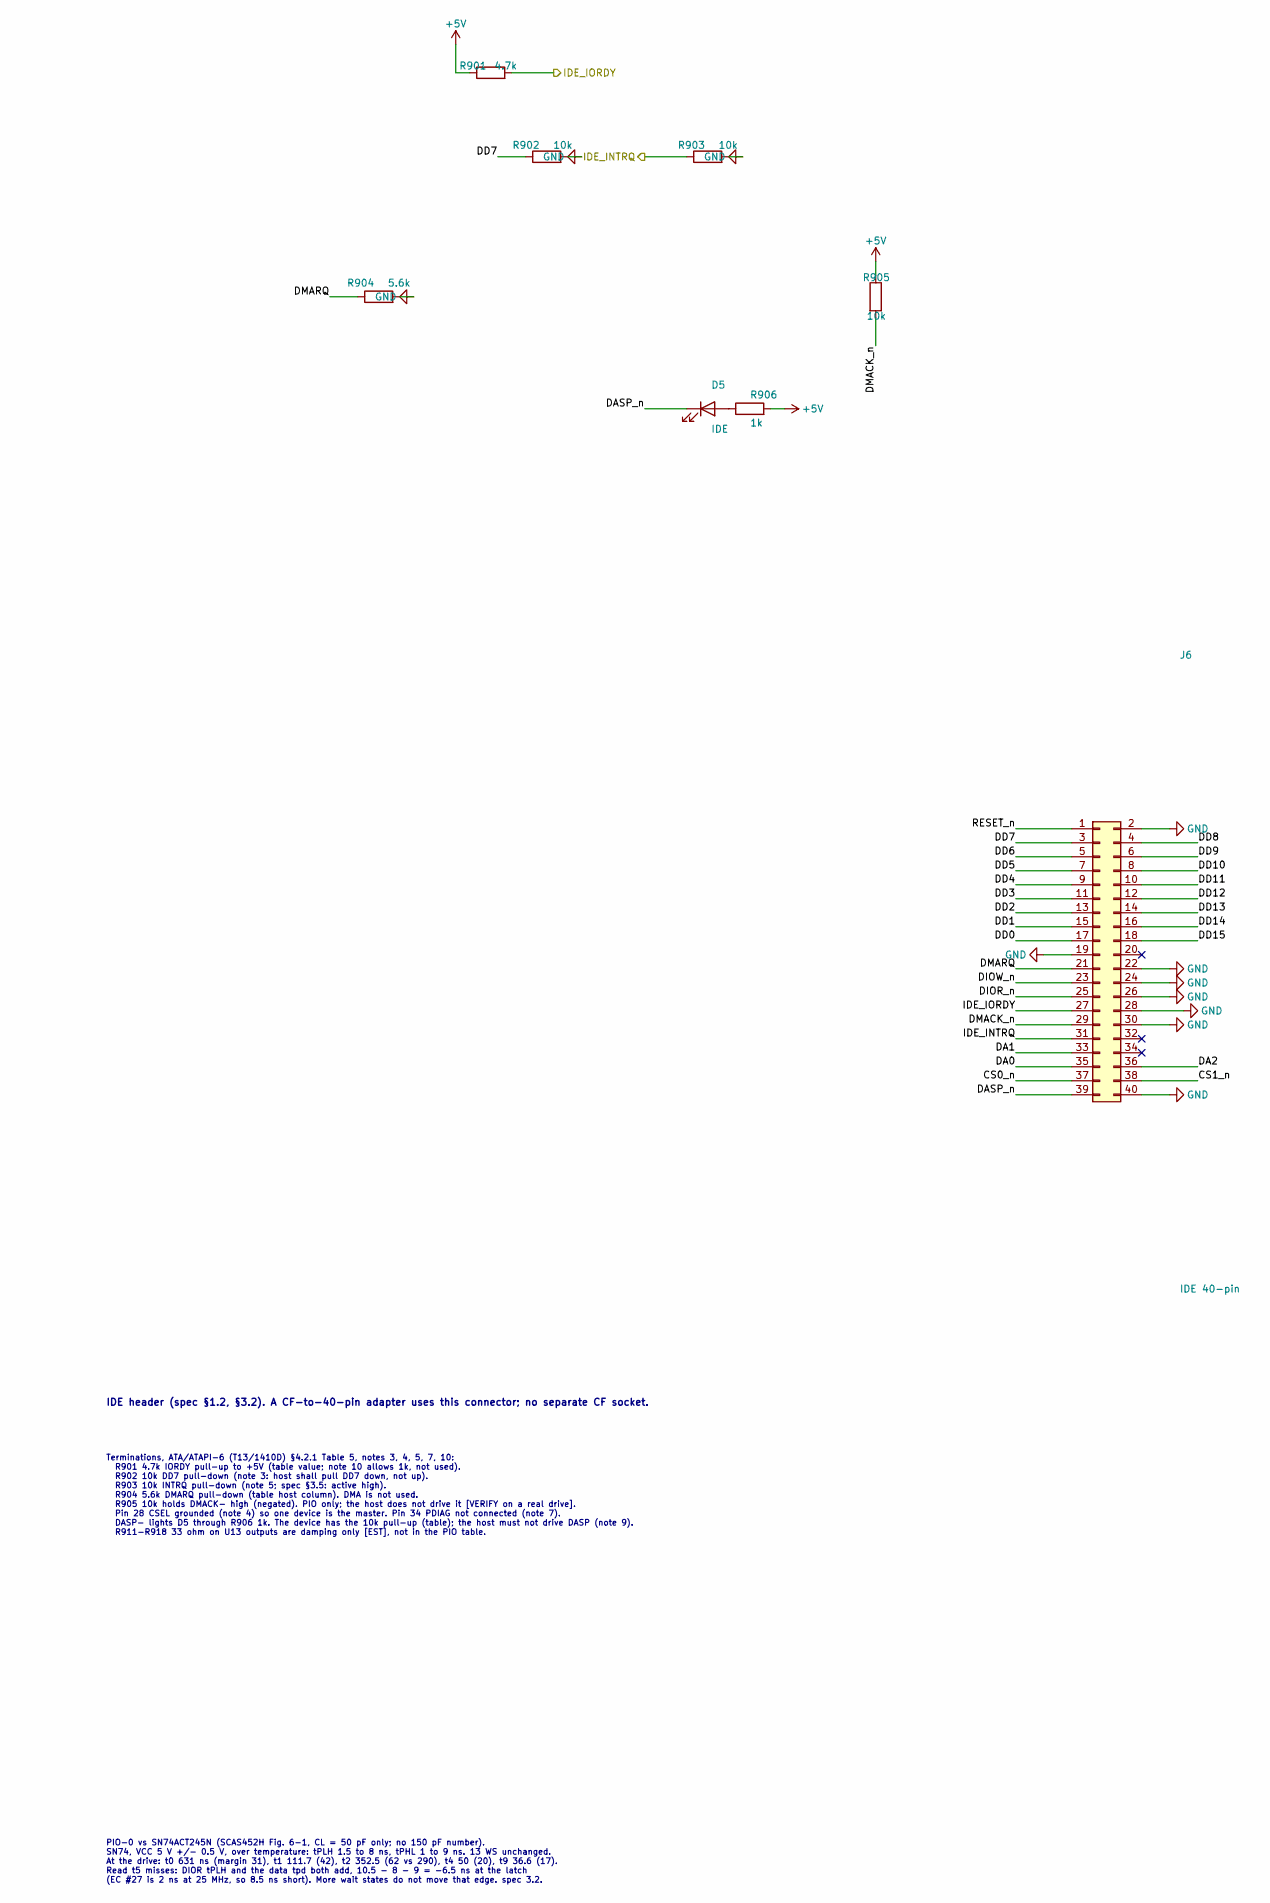
[picture p54: schematic ide.kicad_sch, IDE / CompactFlash: 40-pin header + 3x SN74ACT245N, part in row 1, column 2]

Parts:
C911, C912, C913: 100n; C_0805_2012Metric
D5: IDE; LED_0805_2012Metric
J6: IDE 40-pin; IDC-Header_2x20_P2.54mm_Vertical; MPN Wurth 61204021621
R901: 4.7k; R_0603_1608Metric
R902, R903, R905: 10k; R_0603_1608Metric
R904: 5.6k; R_0603_1608Metric
R906: 1k; R_0603_1608Metric
R911, R912, R913, R914, R915, R916, R917, R918: 33; R_0603_1608Metric
U11, U12, U13: SN74ACT245DW; SOIC-20W_7.5x12.8mm_P1.27mm; MPN SN74ACT245DW

Connections:
+5V: C911.1, C912.1, C913.1, R901.1, R905.1, R906.2, U11.20 (VCC), U12.20 (VCC), U13.1 (A->B), U13.20 (VCC); also elsewhere on the board
/D16: U12.18 (B0); also elsewhere on the board
/D17: U12.17 (B1); also elsewhere on the board
/D18: U12.16 (B2); also elsewhere on the board
/D19: U12.15 (B3); also elsewhere on the board
/D20: U12.14 (B4); also elsewhere on the board
/D21: U12.13 (B5); also elsewhere on the board
/D22: U12.12 (B6); also elsewhere on the board
/D23: U12.11 (B7); also elsewhere on the board
/D24: U11.18 (B0); also elsewhere on the board
/D25: U11.17 (B1); also elsewhere on the board
/D26: U11.16 (B2); also elsewhere on the board
/D27: U11.15 (B3); also elsewhere on the board
/D28: U11.14 (B4); also elsewhere on the board
/D29: U11.13 (B5); also elsewhere on the board
/D30: U11.12 (B6); also elsewhere on the board
/D31: U11.11 (B7); also elsewhere on the board
/IDE_BUF_EN_n: U11.19 (CE), U12.19 (CE); also elsewhere on the board
/IDE_CS0_n: U13.5 (A3); also elsewhere on the board
/IDE_CS1_n: U13.6 (A4); also elsewhere on the board
/IDE_DA0: U13.2 (A0); also elsewhere on the board
/IDE_DA1: U13.3 (A1); also elsewhere on the board
/IDE_DA2: U13.4 (A2); also elsewhere on the board
/IDE_DIOR_n: U13.7 (A5); also elsewhere on the board
/IDE_DIOW_n: U13.8 (A6); also elsewhere on the board
/IDE_INTRQ: J6.31, R903.1; also elsewhere on the board
/IDE_IORDY: J6.27, R901.2; also elsewhere on the board
/PERIPH_RST_n: U13.9 (A7); also elsewhere on the board
/R_W: U11.1 (A->B), U12.1 (A->B); also elsewhere on the board
/ide/CS0_n: J6.37, R914.2
/ide/CS1_n: J6.38, R915.2
/ide/DA0: J6.35, R911.2
/ide/DA1: J6.33, R912.2
/ide/DA2: J6.36, R913.2
/ide/DASP_n: D5.1 (K), J6.39
/ide/DD0: J6.17, U11.2 (A0)
/ide/DD1: J6.15, U11.3 (A1)
/ide/DD2: J6.13, U11.4 (A2)
/ide/DD3: J6.11, U11.5 (A3)
/ide/DD4: J6.9, U11.6 (A4)
/ide/DD5: J6.7, U11.7 (A5)
/ide/DD6: J6.5, U11.8 (A6)
/ide/DD7: J6.3, R902.1, U11.9 (A7)
/ide/DD8: J6.4, U12.2 (A0)
/ide/DD9: J6.6, U12.3 (A1)
/ide/DD10: J6.8, U12.4 (A2)
/ide/DD11: J6.10, U12.5 (A3)
/ide/DD12: J6.12, U12.6 (A4)
/ide/DD13: J6.14, U12.7 (A5)
/ide/DD14: J6.16, U12.8 (A6)
/ide/DD15: J6.18, U12.9 (A7)
/ide/DIOR_n: J6.25, R916.2
/ide/DIOW_n: J6.23, R917.2
/ide/DMACK_n: J6.29, R905.2
/ide/DMARQ: J6.21, R904.1
/ide/RESET_n: J6.1, R918.2
GND: C911.2, C912.2, C913.2, J6.2, J6.19, J6.22, J6.24, J6.26, J6.28, J6.30, J6.40, R902.2, R903.2, R904.2, U11.10 (GND), U12.10 (GND), U13.10 (GND), U13.19 (CE); also elsewhere on the board
unnamed: D5.2 (A), R906.1
unnamed: R911.1, U13.18 (B0)
unnamed: R912.1, U13.17 (B1)
unnamed: R913.1, U13.16 (B2)
unnamed: R914.1, U13.15 (B3)
unnamed: R915.1, U13.14 (B4)
unnamed: R916.1, U13.13 (B5)
unnamed: R917.1, U13.12 (B6)
unnamed: R918.1, U13.11 (B7)

Notes on the sheet:
D24-D31 (U11) and D16-D23 (U12) are members of D[0..31]. DIR = R/W high drives DD onto the CPU.
U13 is wired one way: DIR = +5V (A->B), OE = GND. DA2:0 are U3 pins 50-52, registered (glue Rev A.1).
U11 / U12 / U13 decoupling
IDE header (spec §1.2, §3.2). A CF-to-40-pin adapter uses this connector; no separate CF socket.
Terminations, ATA/ATAPI-6 (T13/1410D) §4.2.1 Table 5, notes 3, 4, 5, 7, 10: R901 4.7k IORDY pull-up to +5V (table value; note 10 allows 1k, not used). R902 10k DD7 pull-down (note 3: host shall pull DD7 down, not up). R903 10k INTRQ pull-down (note 5; spec §3.5: active high). R904 5.6k DMARQ pull-d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
PIO-0 vs SN74ACT245N (SCAS452H Fig. 6-1, CL = 50 pF only; no 150 pF number). SN74, VCC 5 V +/- 0.5 V, over temperature: tPLH 1.5 to 8 ns, tPHL 1 to 9 ns. 13 WS unchanged. At the drive: t0 631 ns (margin 31), t1 111.7 (42), t2 352.5 (62 vs 290), t4 50 (20), t9 36.6 (17). Read t5 misses: DIOR tPLH an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

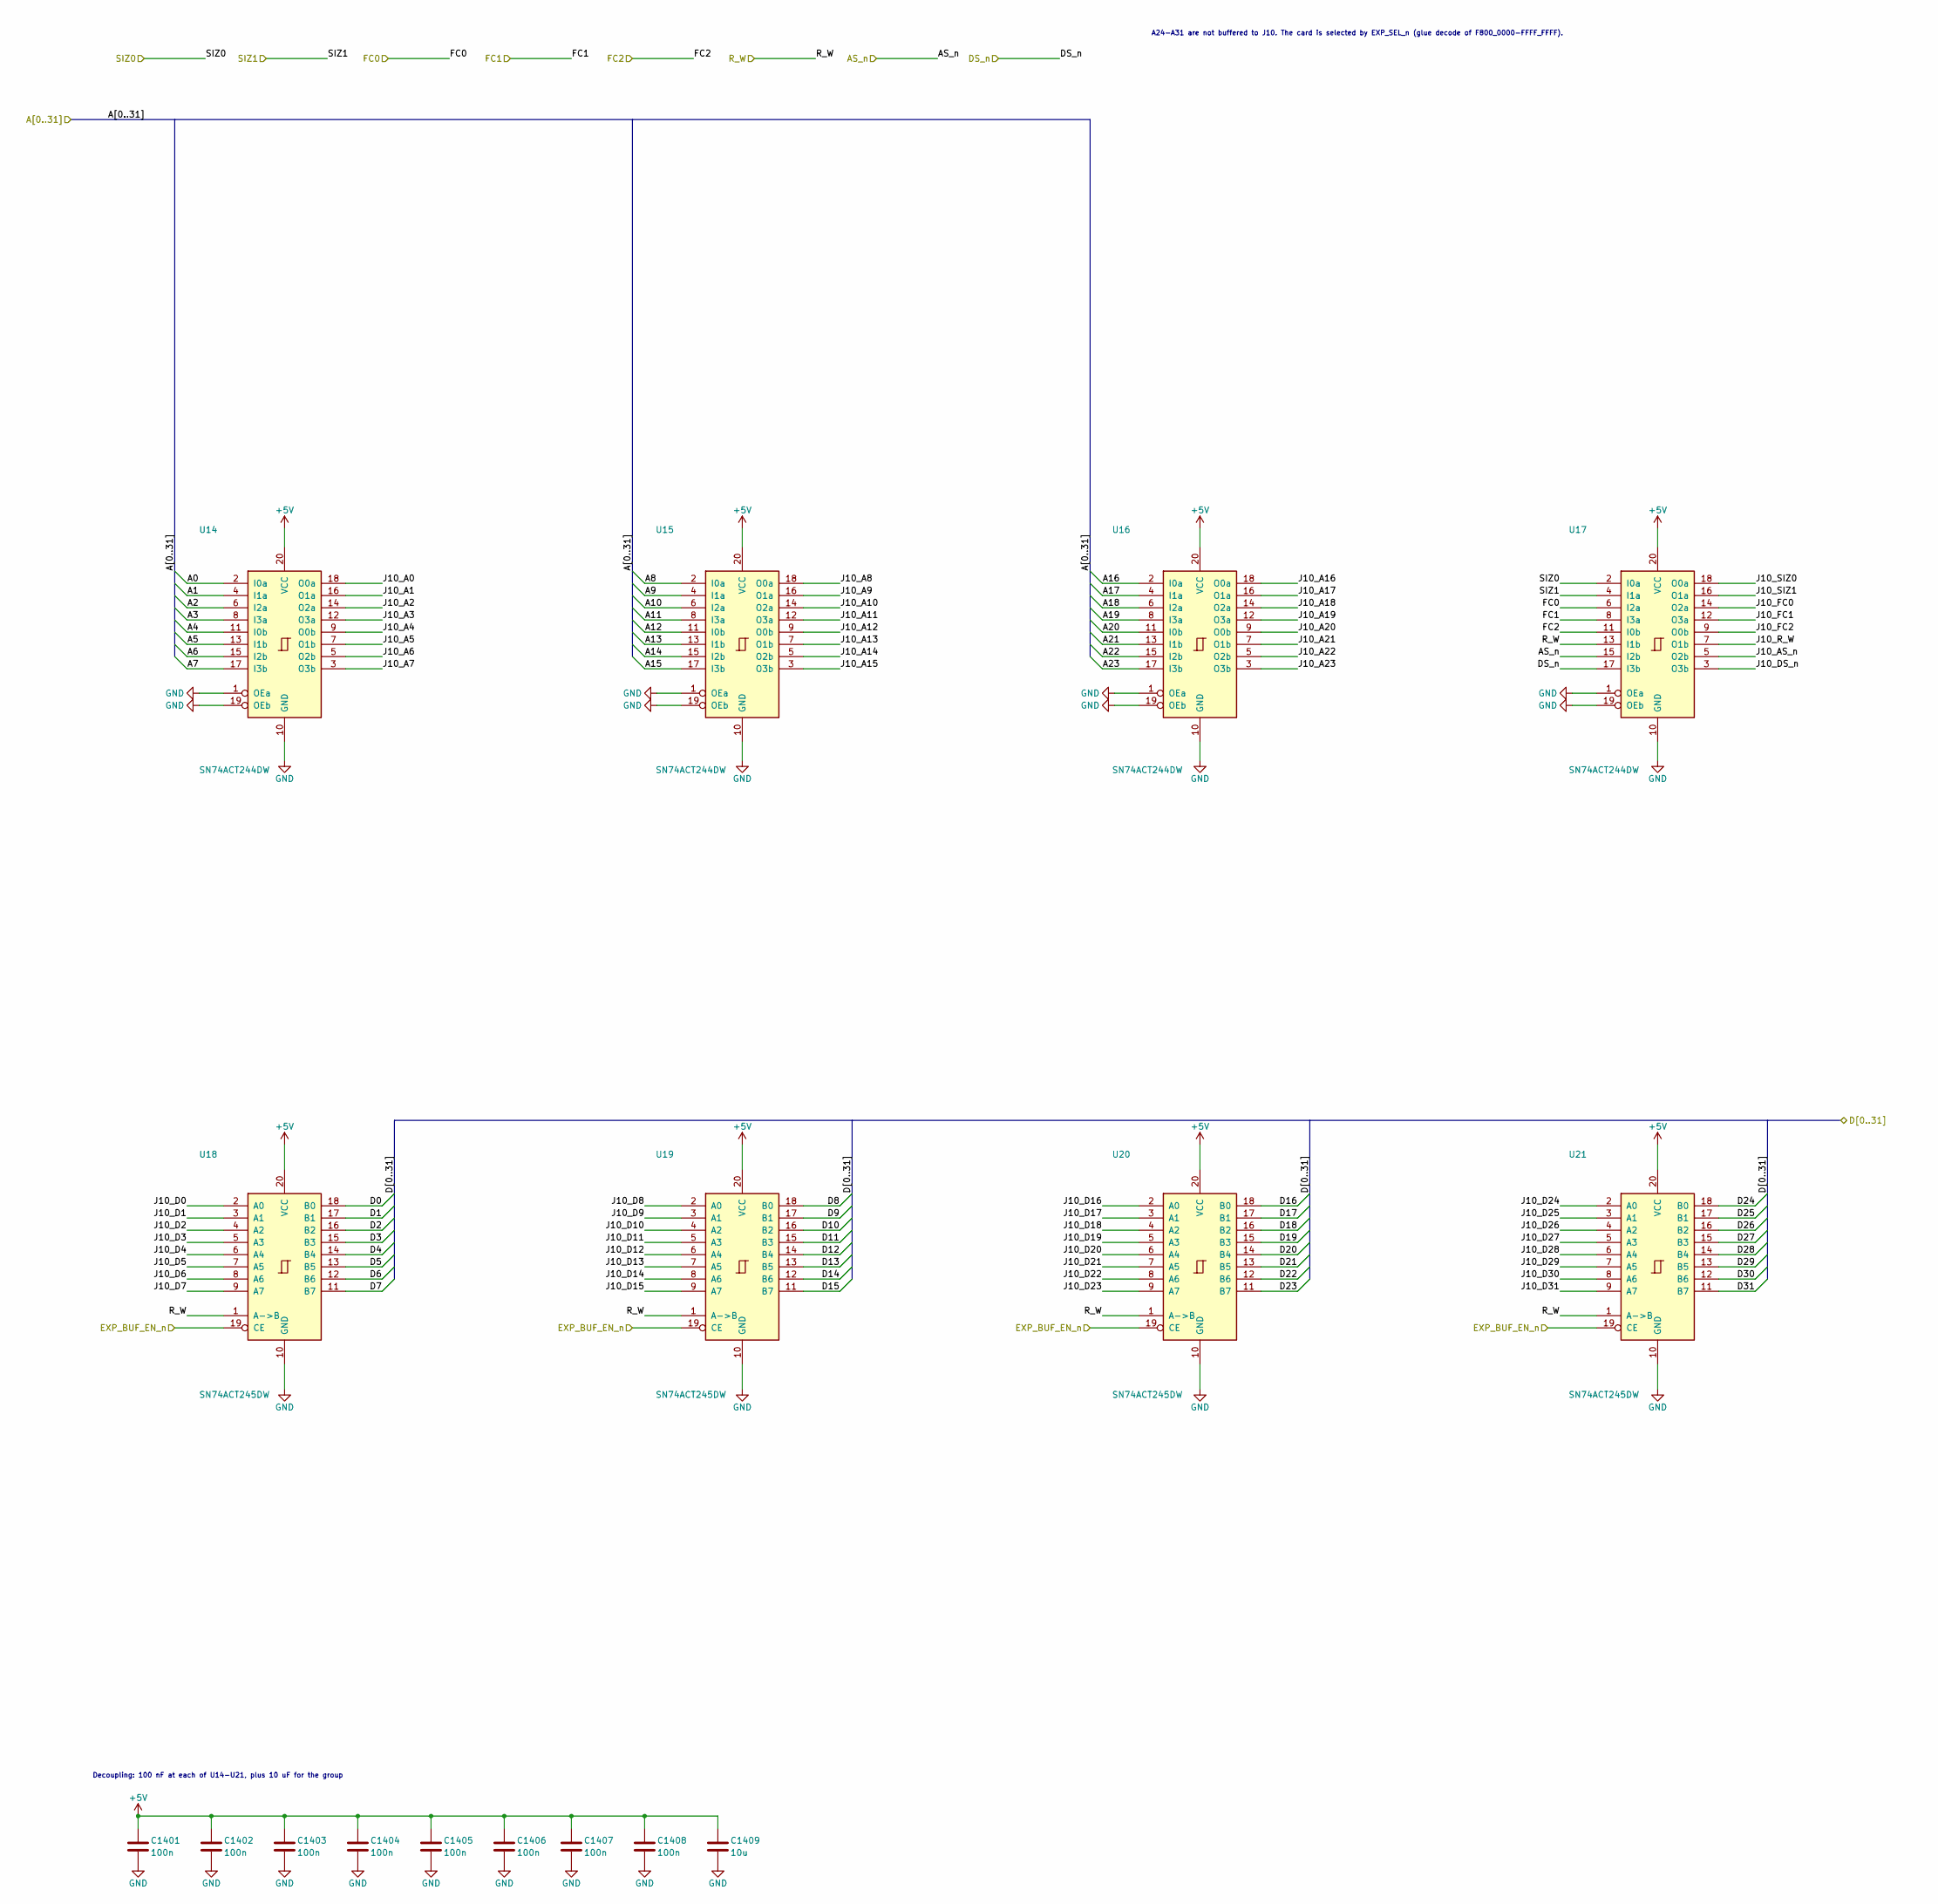
[picture p55: schematic expansion.kicad_sch, Expansion J10: DIN 41612 type C 3x32, F800_0000, part in row 1, column 1]

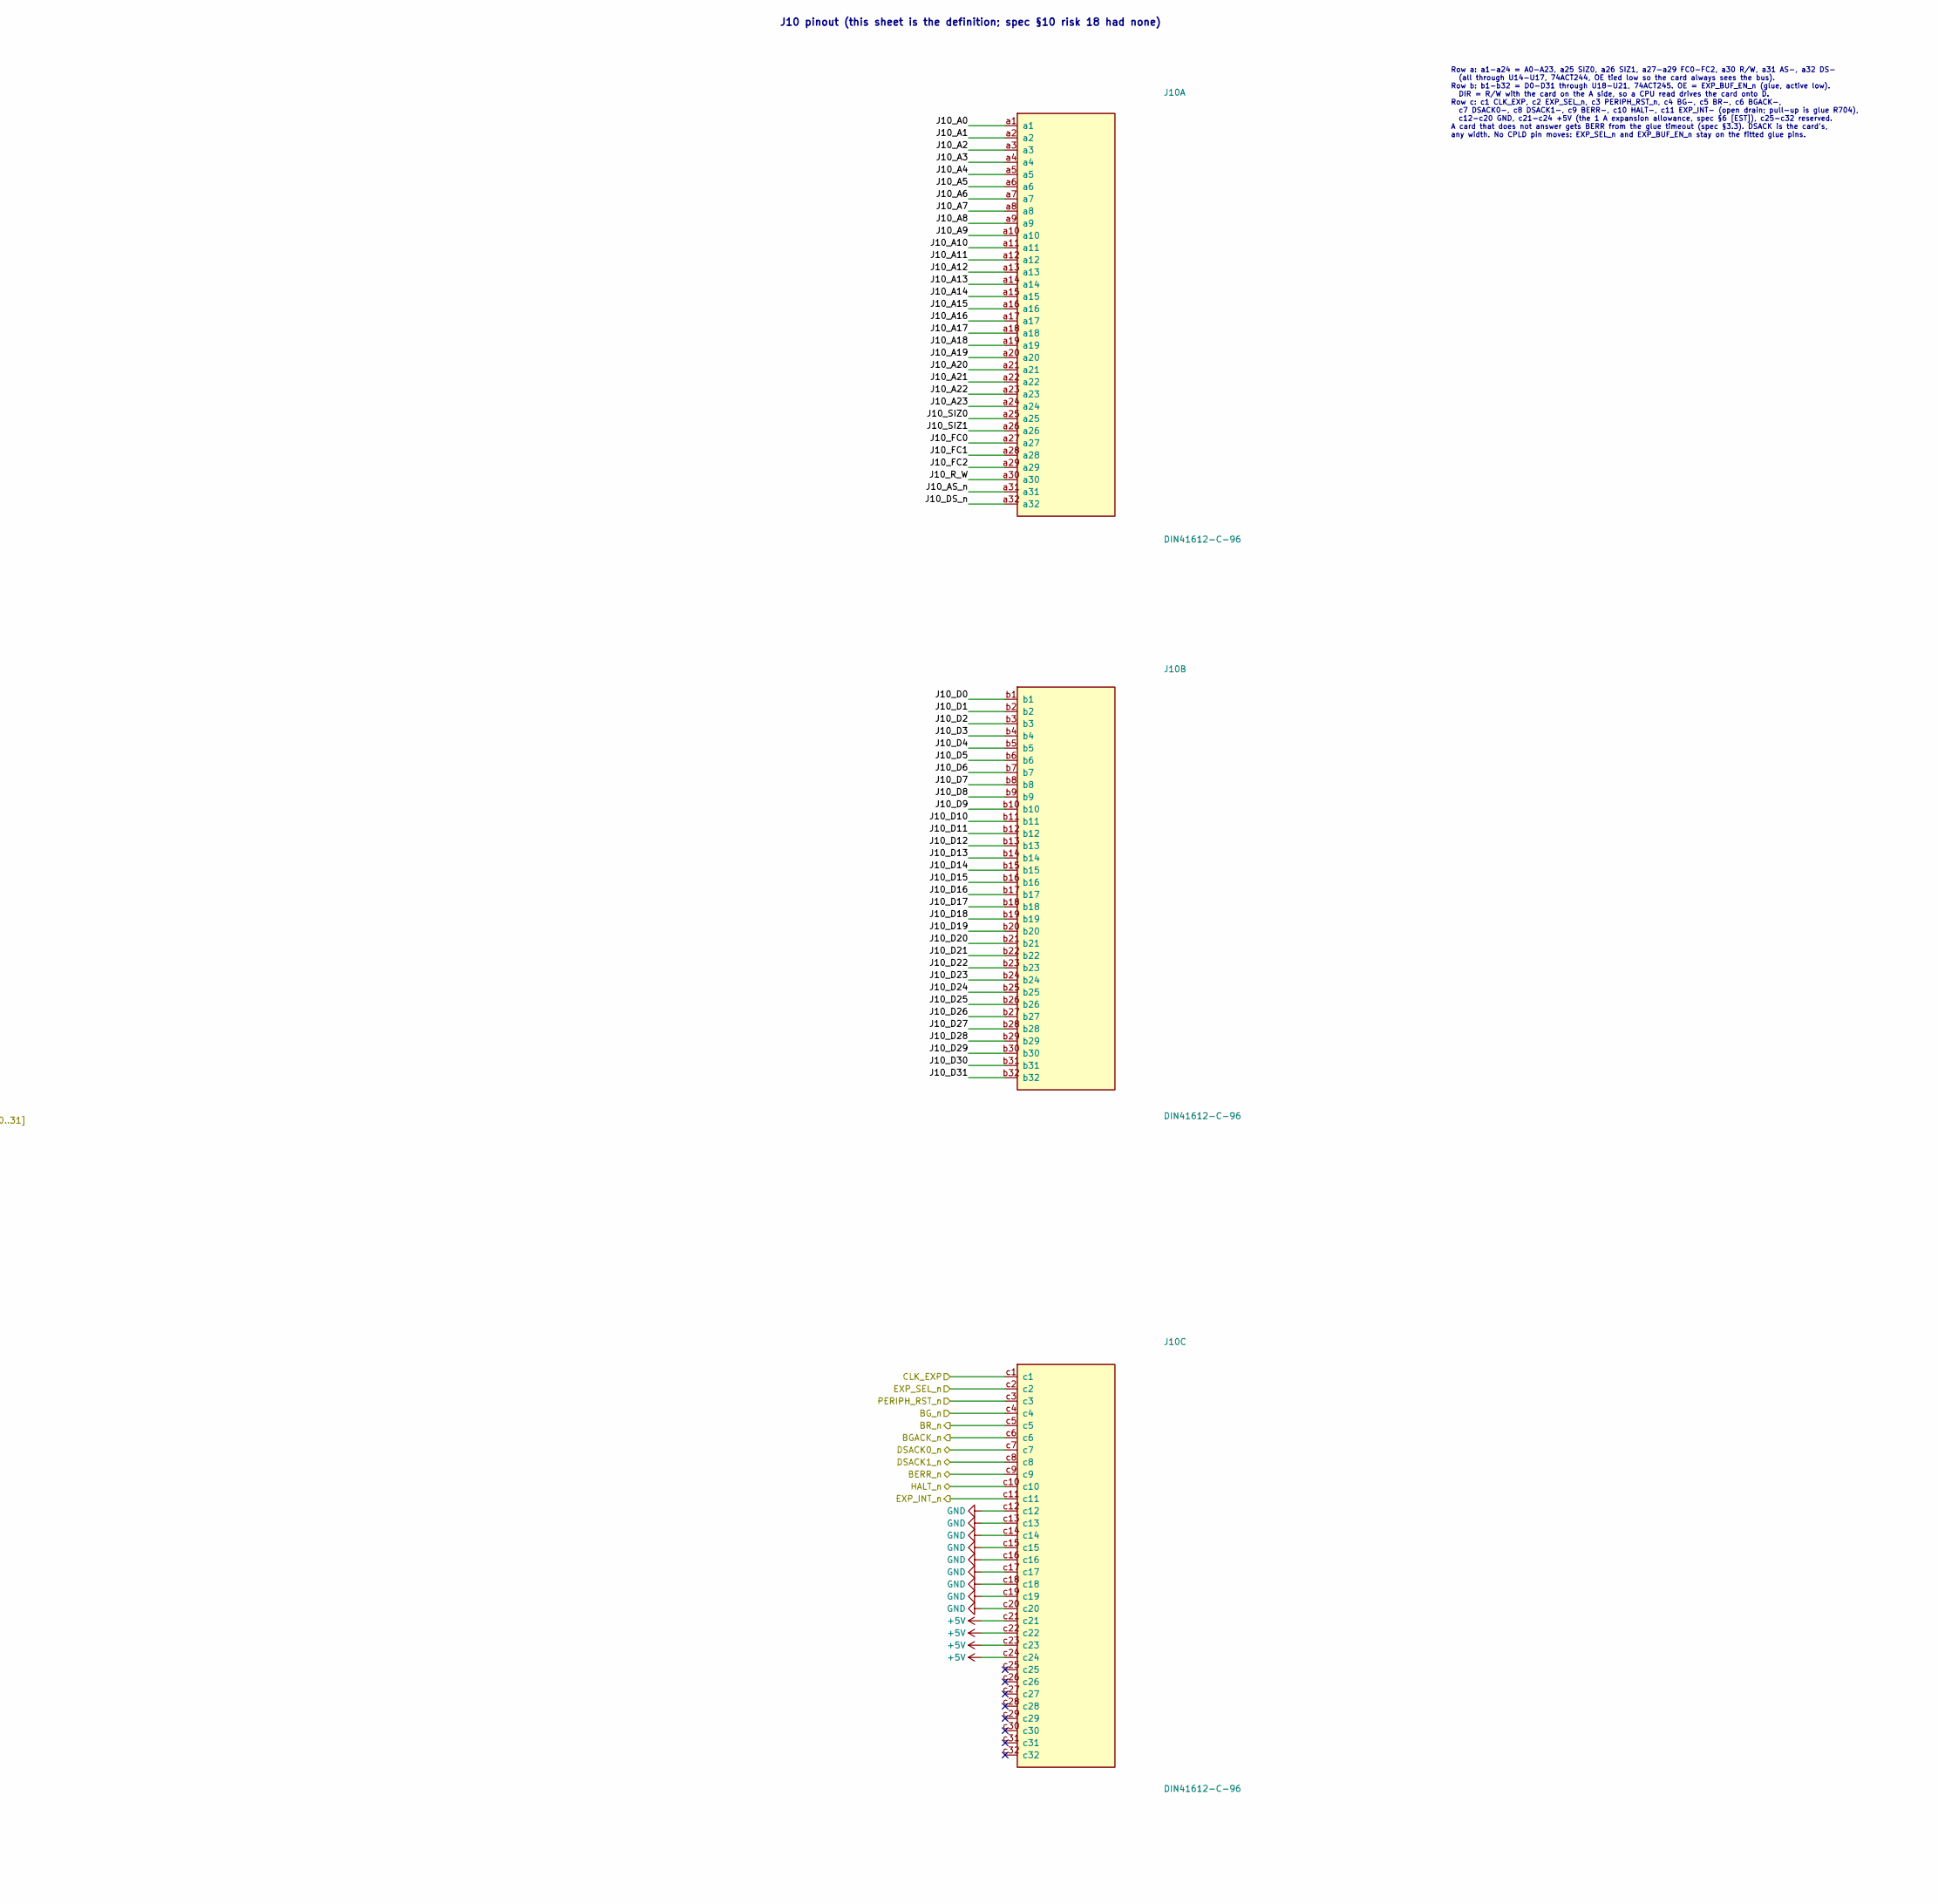
[picture p56: schematic expansion.kicad_sch, Expansion J10: DIN 41612 type C 3x32, F800_0000, part in row 1, column 2]

Parts:
C1401, C1402, C1403, C1404, C1405, C1406, C1407, C1408: 100n; C_0805_2012Metric
C1409: 10u; C_1206_3216Metric
J10: DIN41612-C-96; DIN41612_C_3x32_Female_Vertical_THT; MPN HARTING 09032966821
U14, U15, U16, U17: SN74ACT244DW; SOIC-20W_7.5x12.8mm_P1.27mm; MPN SN74ACT244DW
U18, U19, U20, U21: SN74ACT245DW; SOIC-20W_7.5x12.8mm_P1.27mm; MPN SN74ACT245DW

Connections:
+5V: C1401.1, C1402.1, C1403.1, C1404.1, C1405.1, C1406.1, C1407.1, C1408.1, C1409.1, J10.c21, J10.c22, J10.c23, J10.c24, U14.20 (VCC), U15.20 (VCC), U16.20 (VCC), U17.20 (VCC), U18.20 (VCC), U19.20 (VCC), U20.20 (VCC), U21.20 (VCC); also elsewhere on the board
/A0: U14.2 (I0a); also elsewhere on the board
/A1: U14.4 (I1a); also elsewhere on the board
/A2: U14.6 (I2a); also elsewhere on the board
/A3: U14.8 (I3a); also elsewhere on the board
/A4: U14.11 (I0b); also elsewhere on the board
/A5: U14.13 (I1b); also elsewhere on the board
/A6: U14.15 (I2b); also elsewhere on the board
/A7: U14.17 (I3b); also elsewhere on the board
/A8: U15.2 (I0a); also elsewhere on the board
/A9: U15.4 (I1a); also elsewhere on the board
/A10: U15.6 (I2a); also elsewhere on the board
/A11: U15.8 (I3a); also elsewhere on the board
/A12: U15.11 (I0b); also elsewhere on the board
/A13: U15.13 (I1b); also elsewhere on the board
/A14: U15.15 (I2b); also elsewhere on the board
/A15: U15.17 (I3b); also elsewhere on the board
/A16: U16.2 (I0a); also elsewhere on the board
/A17: U16.4 (I1a); also elsewhere on the board
/A18: U16.6 (I2a); also elsewhere on the board
/A19: U16.8 (I3a); also elsewhere on the board
/A20: U16.11 (I0b); also elsewhere on the board
/A21: U16.13 (I1b); also elsewhere on the board
/A22: U16.15 (I2b); also elsewhere on the board
/A23: U16.17 (I3b); also elsewhere on the board
/AS_n: U17.15 (I2b); also elsewhere on the board
/BERR_n: J10.c9; also elsewhere on the board
/BGACK_n: J10.c6; also elsewhere on the board
/BG_n: J10.c4; also elsewhere on the board
/BR_n: J10.c5; also elsewhere on the board
/CLK_EXP: J10.c1; also elsewhere on the board
/D0: U18.18 (B0); also elsewhere on the board
/D1: U18.17 (B1); also elsewhere on the board
/D2: U18.16 (B2); also elsewhere on the board
/D3: U18.15 (B3); also elsewhere on the board
/D4: U18.14 (B4); also elsewhere on the board
/D5: U18.13 (B5); also elsewhere on the board
/D6: U18.12 (B6); also elsewhere on the board
/D7: U18.11 (B7); also elsewhere on the board
/D8: U19.18 (B0); also elsewhere on the board
/D9: U19.17 (B1); also elsewhere on the board
/D10: U19.16 (B2); also elsewhere on the board
/D11: U19.15 (B3); also elsewhere on the board
/D12: U19.14 (B4); also elsewhere on the board
/D13: U19.13 (B5); also elsewhere on the board
/D14: U19.12 (B6); also elsewhere on the board
/D15: U19.11 (B7); also elsewhere on the board
/D16: U20.18 (B0); also elsewhere on the board
/D17: U20.17 (B1); also elsewhere on the board
/D18: U20.16 (B2); also elsewhere on the board
/D19: U20.15 (B3); also elsewhere on the board
/D20: U20.14 (B4); also elsewhere on the board
/D21: U20.13 (B5); also elsewhere on the board
/D22: U20.12 (B6); also elsewhere on the board
/D23: U20.11 (B7); also elsewhere on the board
/D24: U21.18 (B0); also elsewhere on the board
/D25: U21.17 (B1); also elsewhere on the board
/D26: U21.16 (B2); also elsewhere on the board
/D27: U21.15 (B3); also elsewhere on the board
/D28: U21.14 (B4); also elsewhere on the board
/D29: U21.13 (B5); also elsewhere on the board
/D30: U21.12 (B6); also elsewhere on the board
/D31: U21.11 (B7); also elsewhere on the board
/DSACK0_n: J10.c7; also elsewhere on the board
/DSACK1_n: J10.c8; also elsewhere on the board
/DS_n: U17.17 (I3b); also elsewhere on the board
/EXP_BUF_EN_n: U18.19 (CE), U19.19 (CE), U20.19 (CE), U21.19 (CE); also elsewhere on the board
/EXP_INT_n: J10.c11; also elsewhere on the board
/EXP_SEL_n: J10.c2; also elsewhere on the board
/FC0: U17.6 (I2a); also elsewhere on the board
/FC1: U17.8 (I3a); also elsewhere on the board
/FC2: U17.11 (I0b); also elsewhere on the board
/HALT_n: J10.c10; also elsewhere on the board
/PERIPH_RST_n: J10.c3; also elsewhere on the board
/R_W: U17.13 (I1b), U18.1 (A->B), U19.1 (A->B), U20.1 (A->B), U21.1 (A->B); also elsewhere on the board
/SIZ0: U17.2 (I0a); also elsewhere on the board
/SIZ1: U17.4 (I1a); also elsewhere on the board
/expansion/J10_A0: J10.a1, U14.18 (O0a)
/expansion/J10_A1: J10.a2, U14.16 (O1a)
/expansion/J10_A2: J10.a3, U14.14 (O2a)
/expansion/J10_A3: J10.a4, U14.12 (O3a)
/expansion/J10_A4: J10.a5, U14.9 (O0b)
/expansion/J10_A5: J10.a6, U14.7 (O1b)
/expansion/J10_A6: J10.a7, U14.5 (O2b)
/expansion/J10_A7: J10.a8, U14.3 (O3b)
/expansion/J10_A8: J10.a9, U15.18 (O0a)
/expansion/J10_A9: J10.a10, U15.16 (O1a)
/expansion/J10_A10: J10.a11, U15.14 (O2a)
/expansion/J10_A11: J10.a12, U15.12 (O3a)
/expansion/J10_A12: J10.a13, U15.9 (O0b)
/expansion/J10_A13: J10.a14, U15.7 (O1b)
/expansion/J10_A14: J10.a15, U15.5 (O2b)
/expansion/J10_A15: J10.a16, U15.3 (O3b)
/expansion/J10_A16: J10.a17, U16.18 (O0a)
/expansion/J10_A17: J10.a18, U16.16 (O1a)
/expansion/J10_A18: J10.a19, U16.14 (O2a)
/expansion/J10_A19: J10.a20, U16.12 (O3a)
/expansion/J10_A20: J10.a21, U16.9 (O0b)
/expansion/J10_A21: J10.a22, U16.7 (O1b)
/expansion/J10_A22: J10.a23, U16.5 (O2b)
/expansion/J10_A23: J10.a24, U16.3 (O3b)
/expansion/J10_AS_n: J10.a31, U17.5 (O2b)
/expansion/J10_D0: J10.b1, U18.2 (A0)
/expansion/J10_D1: J10.b2, U18.3 (A1)
/expansion/J10_D2: J10.b3, U18.4 (A2)
/expansion/J10_D3: J10.b4, U18.5 (A3)
/expansion/J10_D4: J10.b5, U18.6 (A4)
/expansion/J10_D5: J10.b6, U18.7 (A5)
/expansion/J10_D6: J10.b7, U18.8 (A6)
/expansion/J10_D7: J10.b8, U18.9 (A7)
/expansion/J10_D8: J10.b9, U19.2 (A0)
/expansion/J10_D9: J10.b10, U19.3 (A1)
/expansion/J10_D10: J10.b11, U19.4 (A2)
/expansion/J10_D11: J10.b12, U19.5 (A3)
/expansion/J10_D12: J10.b13, U19.6 (A4)
/expansion/J10_D13: J10.b14, U19.7 (A5)
/expansion/J10_D14: J10.b15, U19.8 (A6)
/expansion/J10_D15: J10.b16, U19.9 (A7)
/expansion/J10_D16: J10.b17, U20.2 (A0)
/expansion/J10_D17: J10.b18, U20.3 (A1)
/expansion/J10_D18: J10.b19, U20.4 (A2)
/expansion/J10_D19: J10.b20, U20.5 (A3)
/expansion/J10_D20: J10.b21, U20.6 (A4)
/expansion/J10_D21: J10.b22, U20.7 (A5)
/expansion/J10_D22: J10.b23, U20.8 (A6)
/expansion/J10_D23: J10.b24, U20.9 (A7)
/expansion/J10_D24: J10.b25, U21.2 (A0)
/expansion/J10_D25: J10.b26, U21.3 (A1)
/expansion/J10_D26: J10.b27, U21.4 (A2)
/expansion/J10_D27: J10.b28, U21.5 (A3)
/expansion/J10_D28: J10.b29, U21.6 (A4)
/expansion/J10_D29: J10.b30, U21.7 (A5)
/expansion/J10_D30: J10.b31, U21.8 (A6)
/expansion/J10_D31: J10.b32, U21.9 (A7)
/expansion/J10_DS_n: J10.a32, U17.3 (O3b)
/expansion/J10_FC0: J10.a27, U17.14 (O2a)
/expansion/J10_FC1: J10.a28, U17.12 (O3a)
/expansion/J10_FC2: J10.a29, U17.9 (O0b)
/expansion/J10_R_W: J10.a30, U17.7 (O1b)
/expansion/J10_SIZ0: J10.a25, U17.18 (O0a)
/expansion/J10_SIZ1: J10.a26, U17.16 (O1a)
GND: C1401.2, C1402.2, C1403.2, C1404.2, C1405.2, C1406.2, C1407.2, C1408.2, C1409.2, J10.c12, J10.c13, J10.c14, J10.c15, J10.c16, J10.c17, J10.c18, J10.c19, J10.c20, U14.1 (OEa), U14.10 (GND), U14.19 (OEb), U15.1 (OEa), U15.10 (GND), U15.19 (OEb), U16.1 (OEa), U16.10 (GND), U16.19 (OEb), U17.1 (OEa), U17.10 (GND), U17.19 (OEb), U18.10 (GND), U19.10 (GND), U20.10 (GND), U21.10 (GND); also elsewhere on the board

Notes on the sheet:
A24-A31 are not buffered to J10. The card is selected by EXP_SEL_n (glue decode of F800_0000-FFFF_FFFF).
Decoupling: 100 nF at each of U14-U21, plus 10 uF for the group
J10 pinout (this sheet is the definition; spec §10 risk 18 had none)
Row a: a1-a24 = A0-A23, a25 SIZ0, a26 SIZ1, a27-a29 FC0-FC2, a30 R/W, a31 AS-, a32 DS- (all through U14-U17, 74ACT244, OE tied low so the card always sees the bus). Row b: b1-b32 = D0-D31 through U18-U21, 74ACT245. OE = EXP_BUF_EN_n (glue, active low). DIR = R/W with the card on the A side, so a CP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
