mattbettcher/m68030-sbc/68030-design/kicad/m68030-sbc.kicad_pcb

## KiCad design 68030-design/kicad/m68030-sbc.kicad_pcb (continued)

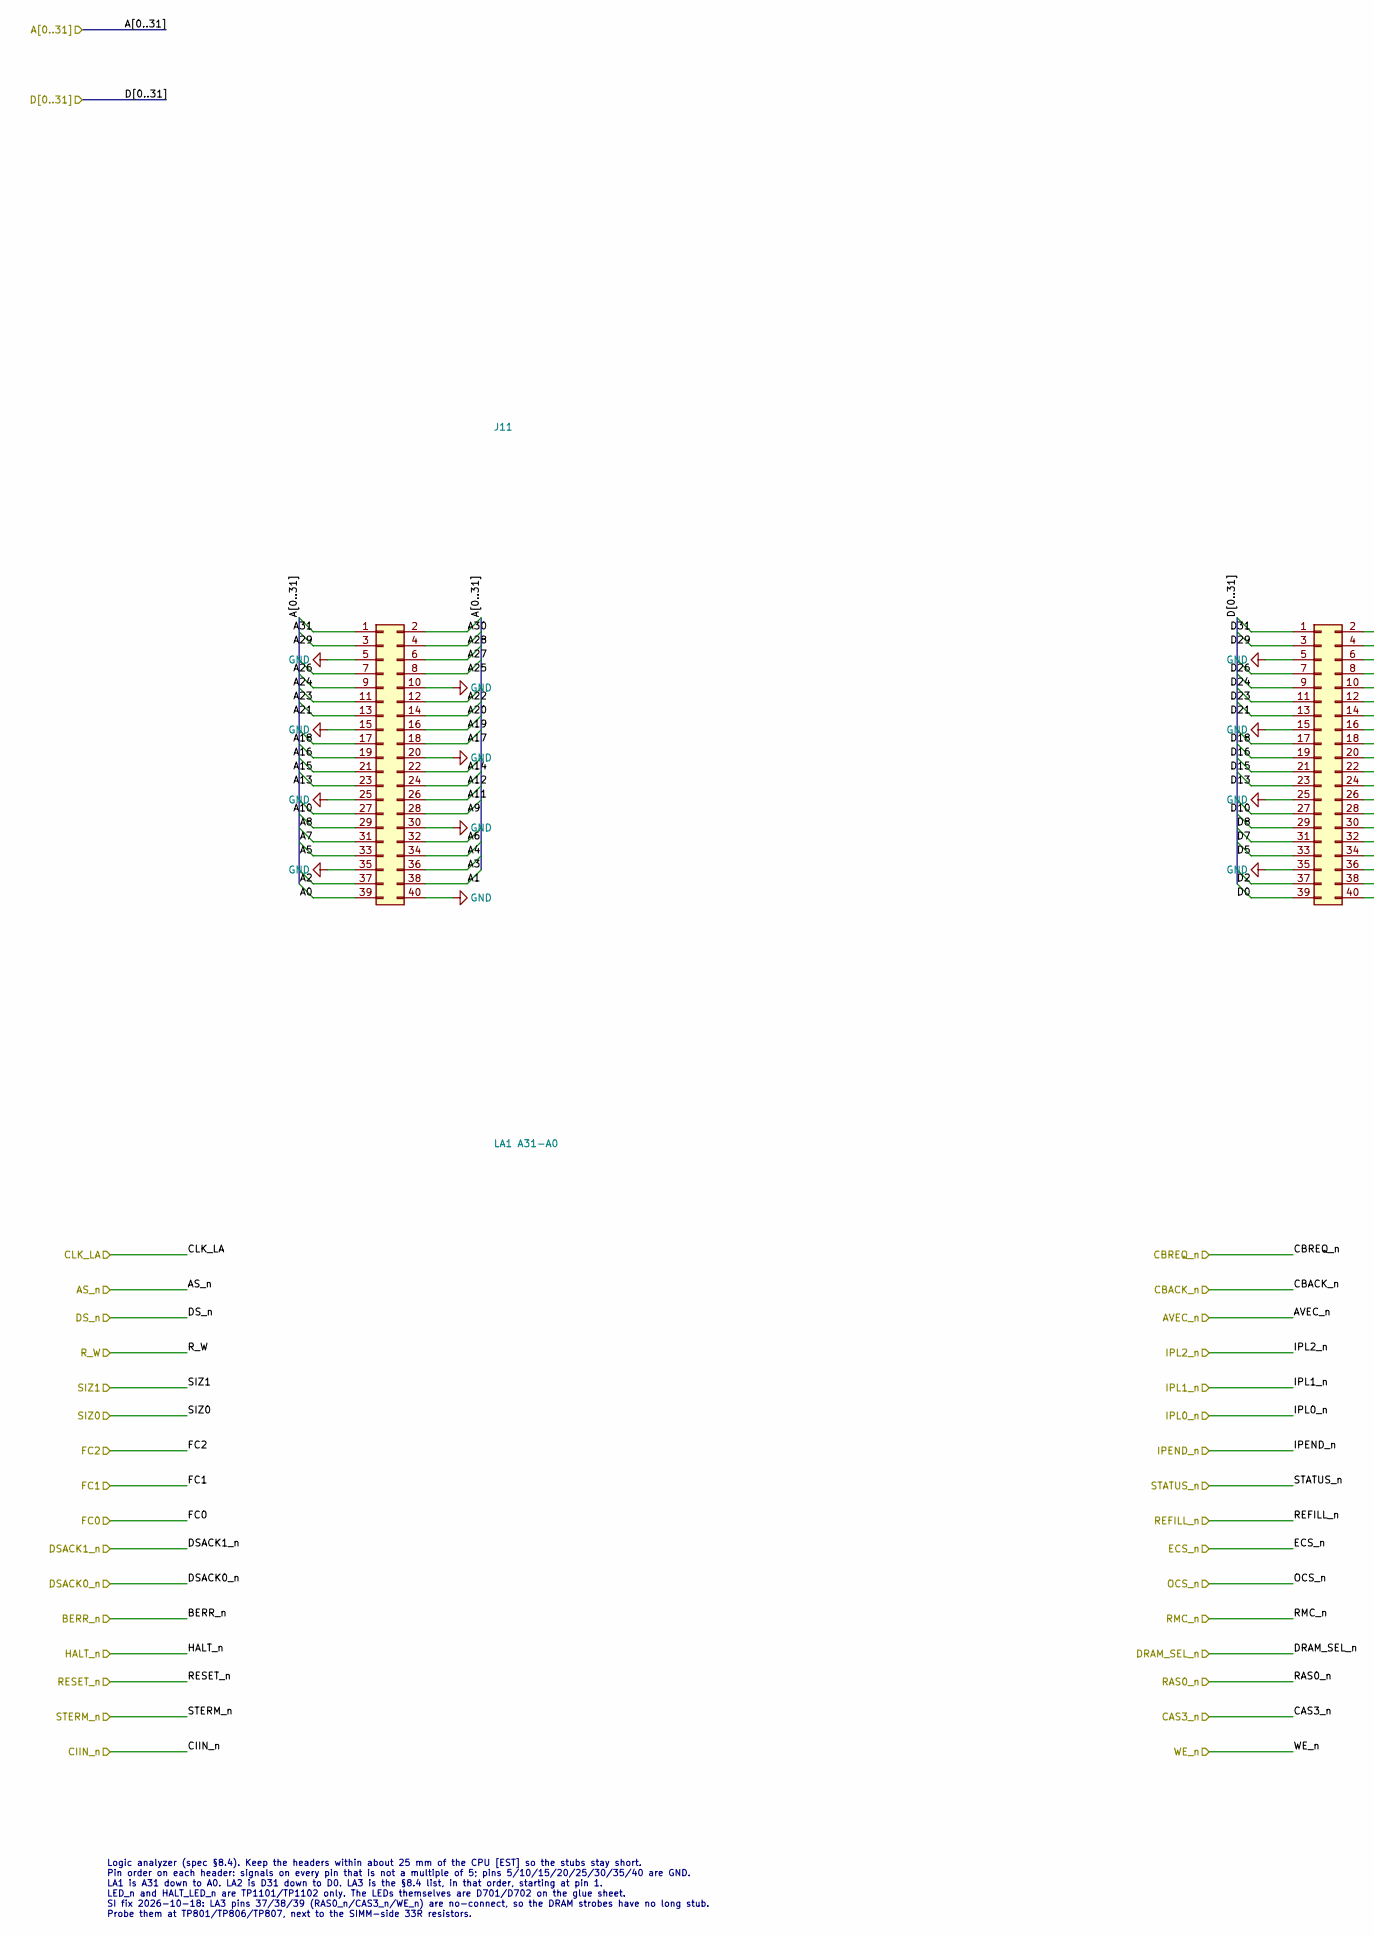
[picture p57: schematic debug.kicad_sch, Logic analyzer headers LA1-LA3 (spec §8.4), part in row 1, column 1]

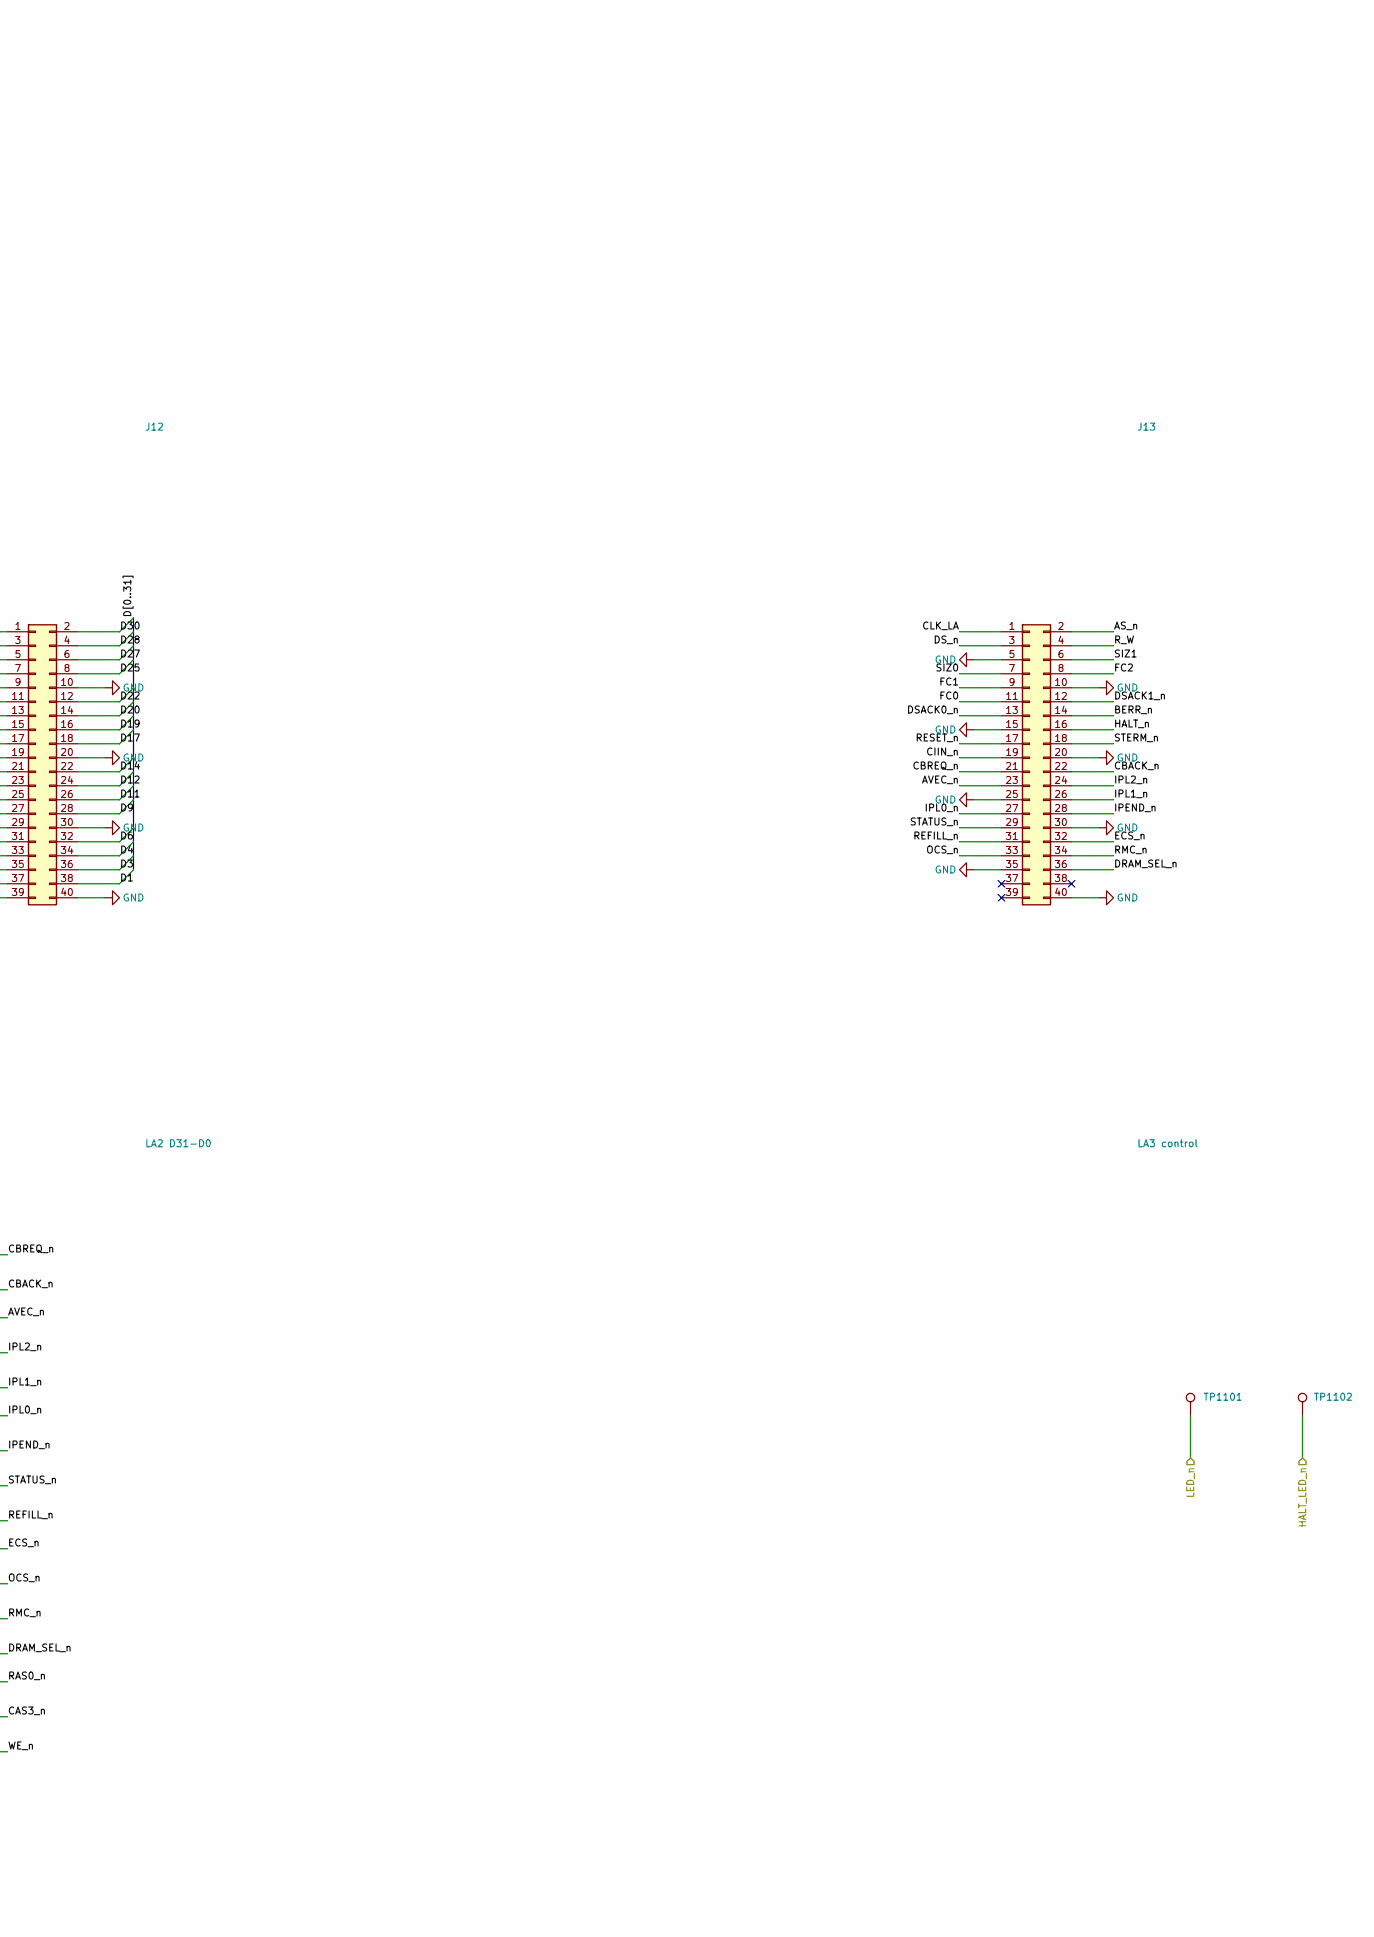
[picture p58: schematic debug.kicad_sch, Logic analyzer headers LA1-LA3 (spec §8.4), part in row 1, column 2]

Parts:
J11: LA1 A31-A0; PinHeader_2x20_P2.54mm_Vertical; MPN Samtec TSW-120-07-G-D
J12: LA2 D31-D0; PinHeader_2x20_P2.54mm_Vertical; MPN Samtec TSW-120-07-G-D
J13: LA3 control; PinHeader_2x20_P2.54mm_Vertical; MPN Samtec TSW-120-07-G-D
TP1101: LED_n; TestPoint_Pad_D1.5mm
TP1102: HALT_LED_n; TestPoint_Pad_D1.5mm

Connections:
/A0: J11.39; also elsewhere on the board
/A1: J11.38; also elsewhere on the board
/A2: J11.37; also elsewhere on the board
/A3: J11.36; also elsewhere on the board
/A4: J11.34; also elsewhere on the board
/A5: J11.33; also elsewhere on the board
/A6: J11.32; also elsewhere on the board
/A7: J11.31; also elsewhere on the board
/A8: J11.29; also elsewhere on the board
/A9: J11.28; also elsewhere on the board
/A10: J11.27; also elsewhere on the board
/A11: J11.26; also elsewhere on the board
/A12: J11.24; also elsewhere on the board
/A13: J11.23; also elsewhere on the board
/A14: J11.22; also elsewhere on the board
/A15: J11.21; also elsewhere on the board
/A16: J11.19; also elsewhere on the board
/A17: J11.18; also elsewhere on the board
/A18: J11.17; also elsewhere on the board
/A19: J11.16; also elsewhere on the board
/A20: J11.14; also elsewhere on the board
/A21: J11.13; also elsewhere on the board
/A22: J11.12; also elsewhere on the board
/A23: J11.11; also elsewhere on the board
/A24: J11.9; also elsewhere on the board
/A25: J11.8; also elsewhere on the board
/A26: J11.7; also elsewhere on the board
/A27: J11.6; also elsewhere on the board
/A28: J11.4; also elsewhere on the board
/A29: J11.3; also elsewhere on the board
/A30: J11.2; also elsewhere on the board
/A31: J11.1; also elsewhere on the board
/AS_n: J13.2; also elsewhere on the board
/AVEC_n: J13.23; also elsewhere on the board
/BERR_n: J13.14; also elsewhere on the board
/CBACK_n: J13.22; also elsewhere on the board
/CBREQ_n: J13.21; also elsewhere on the board
/CIIN_n: J13.19; also elsewhere on the board
/CLK_LA: J13.1; also elsewhere on the board
/D0: J12.39; also elsewhere on the board
/D1: J12.38; also elsewhere on the board
/D2: J12.37; also elsewhere on the board
/D3: J12.36; also elsewhere on the board
/D4: J12.34; also elsewhere on the board
/D5: J12.33; also elsewhere on the board
/D6: J12.32; also elsewhere on the board
/D7: J12.31; also elsewhere on the board
/D8: J12.29; also elsewhere on the board
/D9: J12.28; also elsewhere on the board
/D10: J12.27; also elsewhere on the board
/D11: J12.26; also elsewhere on the board
/D12: J12.24; also elsewhere on the board
/D13: J12.23; also elsewhere on the board
/D14: J12.22; also elsewhere on the board
/D15: J12.21; also elsewhere on the board
/D16: J12.19; also elsewhere on the board
/D17: J12.18; also elsewhere on the board
/D18: J12.17; also elsewhere on the board
/D19: J12.16; also elsewhere on the board
/D20: J12.14; also elsewhere on the board
/D21: J12.13; also elsewhere on the board
/D22: J12.12; also elsewhere on the board
/D23: J12.11; also elsewhere on the board
/D24: J12.9; also elsewhere on the board
/D25: J12.8; also elsewhere on the board
/D26: J12.7; also elsewhere on the board
/D27: J12.6; also elsewhere on the board
/D28: J12.4; also elsewhere on the board
/D29: J12.3; also elsewhere on the board
/D30: J12.2; also elsewhere on the board
/D31: J12.1; also elsewhere on the board
/DRAM_SEL_n: J13.36; also elsewhere on the board
/DSACK0_n: J13.13; also elsewhere on the board
/DSACK1_n: J13.12; also elsewhere on the board
/DS_n: J13.3; also elsewhere on the board
/ECS_n: J13.32; also elsewhere on the board
/FC0: J13.11; also elsewhere on the board
/FC1: J13.9; also elsewhere on the board
/FC2: J13.8; also elsewhere on the board
/HALT_LED_n: TP1102.1; also elsewhere on the board
/HALT_n: J13.16; also elsewhere on the board
/IPEND_n: J13.28; also elsewhere on the board
/IPL0_n: J13.27; also elsewhere on the board
/IPL1_n: J13.26; also elsewhere on the board
/IPL2_n: J13.24; also elsewhere on the board
/LED_n: TP1101.1; also elsewhere on the board
/OCS_n: J13.33; also elsewhere on the board
/REFILL_n: J13.31; also elsewhere on the board
/RESET_n: J13.17; also elsewhere on the board
/RMC_n: J13.34; also elsewhere on the board
/R_W: J13.4; also elsewhere on the board
/SIZ0: J13.7; also elsewhere on the board
/SIZ1: J13.6; also elsewhere on the board
/STATUS_n: J13.29; also elsewhere on the board
/STERM_n: J13.18; also elsewhere on the board
GND: J11.5, J11.10, J11.15, J11.20, J11.25, J11.30, J11.35, J11.40, J12.5, J12.10, J12.15, J12.20, J12.25, J12.30, J12.35, J12.40, J13.5, J13.10, J13.15, J13.20, J13.25, J13.30, J13.35, J13.40; also elsewhere on the board

Notes on the sheet:
Logic analyzer (spec §8.4). Keep the headers within about 25 mm of the CPU [EST] so the stubs stay short. Pin order on each header: signals on every pin that is not a multiple of 5; pins 5/10/15/20/25/30/35/40 are GND. LA1 is A31 down to A0. LA2 is D31 down to D0. LA3 is the §8.4 list, in that orde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

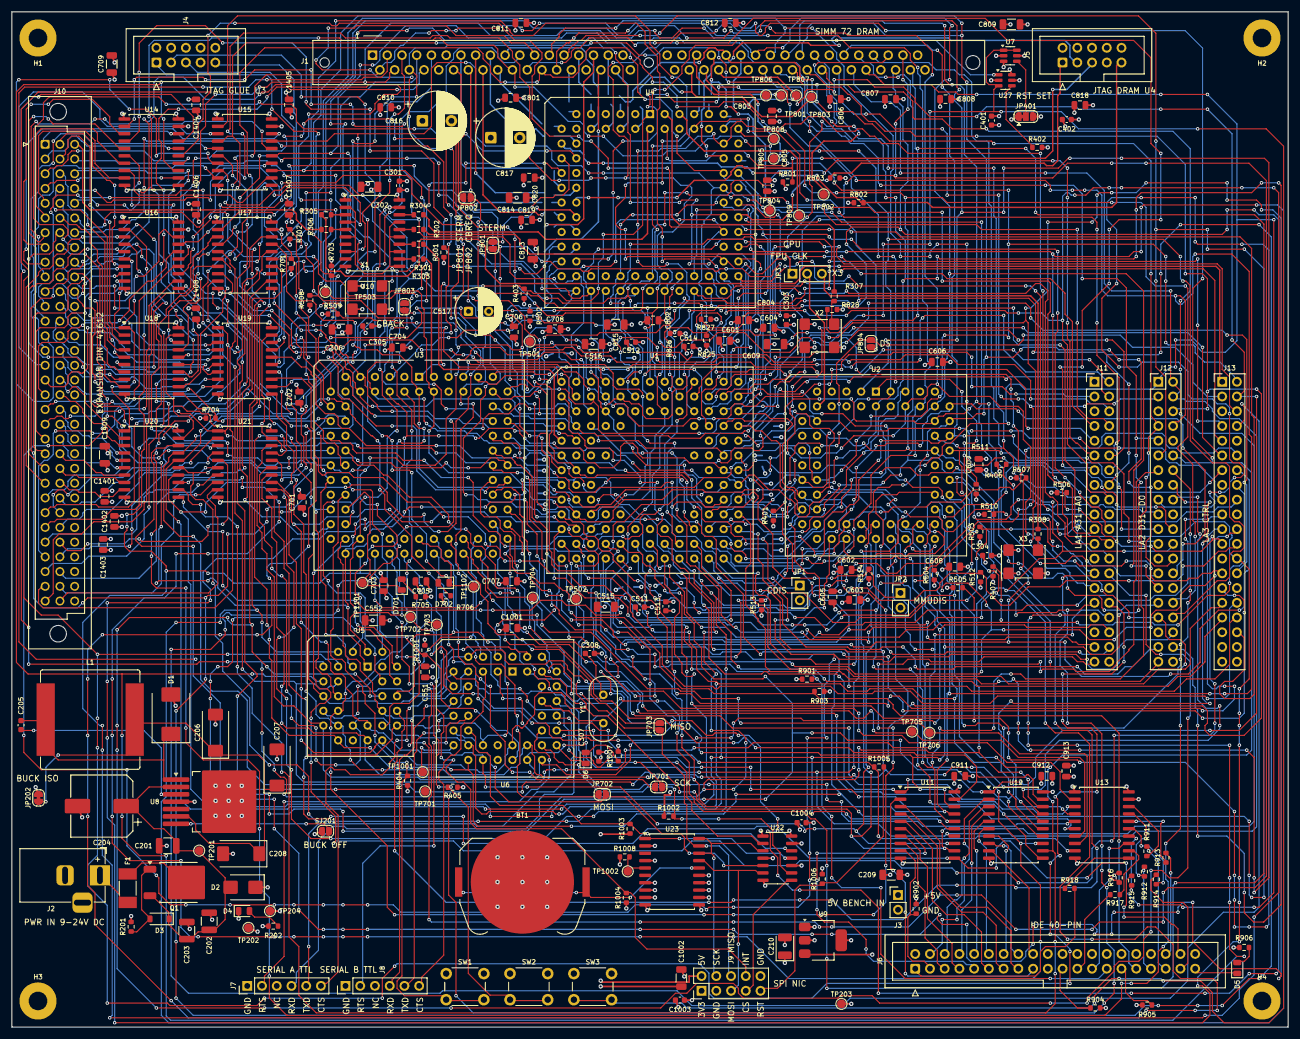
[picture p59: board m68030-sbc.kicad_pcb from above]

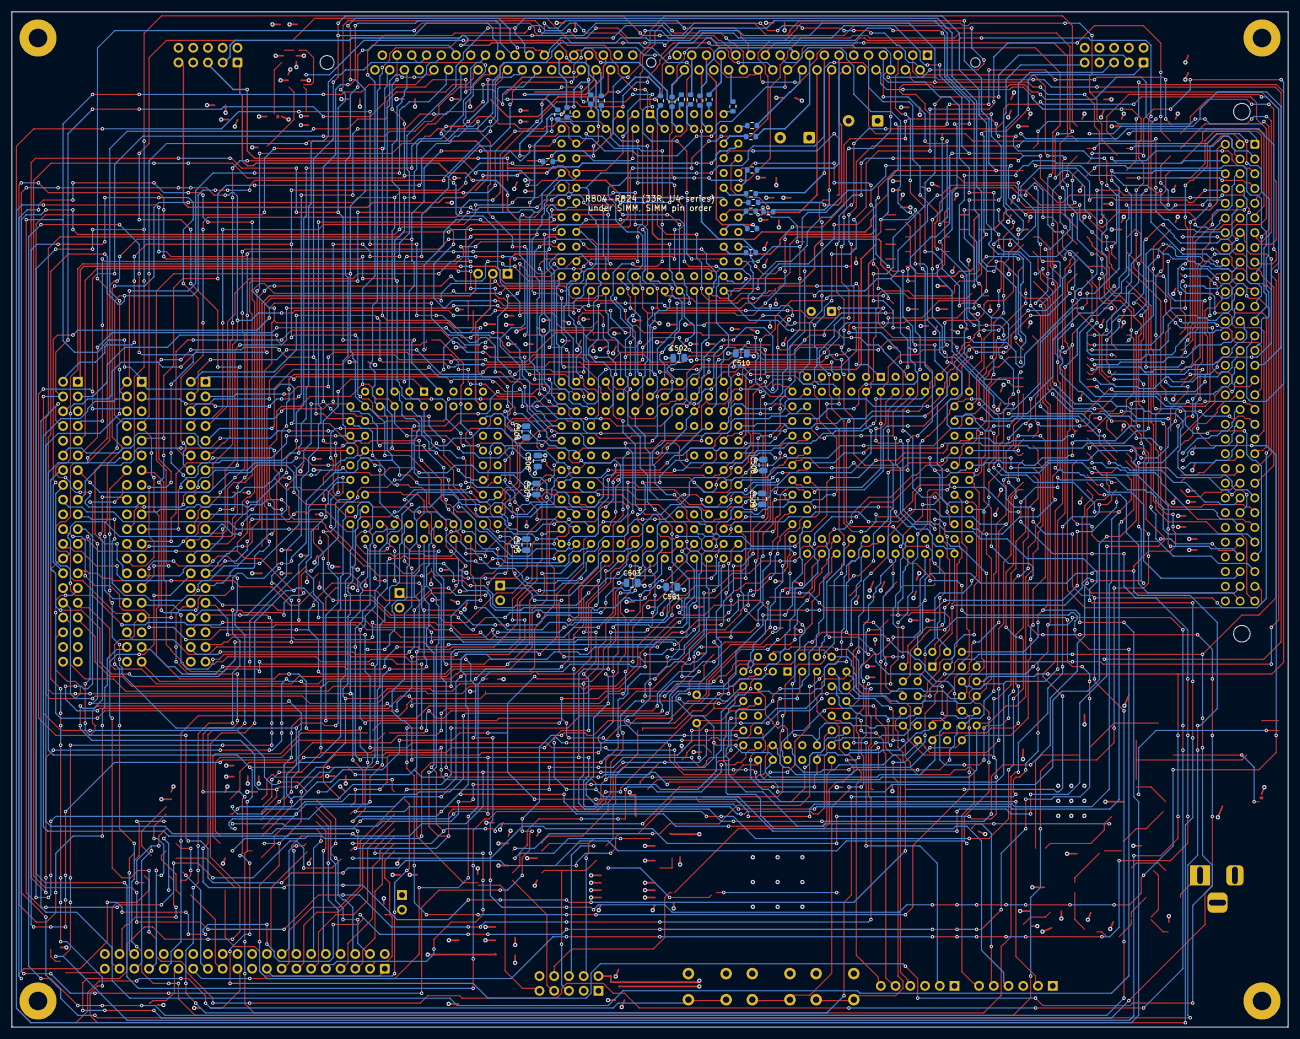
[picture p60: board m68030-sbc.kicad_pcb from below]

Board: 4 copper layers, 220.0 x 175.0 mm, 279 parts (31 on the bottom side), 349 nets.
