mattbettcher/m68030-sbc/68030-design/cpld/dram/sim/dram_timed.v

// ATF15xx verilog timing model
// Atmel ATF15xx Fitter Version 1918 created on Sat Oct 17 22:36:24 2026



`timescale 1ns / 1ps

module dram(
      A0,
      A1,
      A10,
      A11,
      A12,
      A13,
      A14,
      A15,
      A16,
      A17,
      A18,
      A19,
      A2,
      A20,
      A21,
      A22,
      A23,
      A24,
      A25,
      A26,
      A3,
      A4,
      A5,
      A6,
      A7,
      A8,
      A9,
      AS_n,
      CAS0_n,
      CAS1_n,
      CAS2_n,
      CAS3_n,
      DRAM_CLK,
      DRAM_SEL_n,
      DSACK0_n,
      DSACK1_n,
      MA0,
      MA1,
      MA10,
      MA11,
      MA2,
      MA3,
      MA4,
      MA5,
      MA6,
      MA7,
      MA8,
      MA9,
      MUX_SEL,
      PWR_RST_n,
      RAS0_n,
      RAS1_n,
      RAS2_n,
      RAS3_n,
      R_W,
      SIZ0,
      SIZ1,
      WE_n);

input A0;
input A1;
input A10;
input A11;
input A12;
input A13;
input A14;
input A15;
input A16;
input A17;
input A18;
input A19;
input A2;
input A20;
input A21;
input A22;
input A23;
input A24;
input A25;
input A26;
input A3;
input A4;
input A5;
input A6;
input A7;
input A8;
input A9;
input AS_n;
input DRAM_CLK;
input DRAM_SEL_n;
input PWR_RST_n;
input R_W;
input SIZ0;
input SIZ1;
output CAS0_n;
output CAS1_n;
output CAS2_n;
output CAS3_n;
output DSACK0_n;
output DSACK1_n;
output MA0;
output MA1;
output MA10;
output MA11;
output MA2;
output MA3;
output MA4;
output MA5;
output MA6;
output MA7;
output MA8;
output MA9;
output MUX_SEL;
output RAS0_n;
output RAS1_n;
output RAS2_n;
output RAS3_n;
output WE_n;
supply0 gnd;
supply1 vcc;


wire
     id00211, id00211D, id00205Q, id00205D, id00215, id00215D, id00207Q, id00207D, id00206Q, id00206D, id00204Q, id00204D, id00212, id00212D, id00244, id00244D, id00210, id00210D, id00196, id00196D, id00242, id00242D, id00243, id00243D, id00197, id00197D, id00213, id00213D, id00231, id00231D, id00200, id00200D, Com_Ctrl_553, id00096Q, id00209, id00209D, id00232, id00232D, id00233, id00233D, id00239, id00239D, id00238, id00238D, DSACK1_n_combQ, id00234, id00234D, DSACK0_n_combQ, id00236, id00236D, id00240, id00240D, id00048Q, id00237, id00237D, id00216, id00216D, id00241, id00241D, id00230, id00230D, id00223, id00223D, id00099Q, id00108Q, id00235, id00235D, id00218, id00218D, id00214, id00214D, id00217, id00217D, id00101QN, id00003, id00003D, Com_Ctrl_554, id00229, id00229D, id00222, id00222D, id00225, id00225D, id00226, id00226D, id00228, id00228D, id00227, id00227D, id00224, id00224D, id00221, id00221D, id00219, id00219D, id00220, id00220D, id00202Q, id00202D, id00199Q, id00199D, id00198Q, id00198D, id00208Q, id00208D, id00203Q, id00203D, id00201Q, id00201D, FB_555, FB_8_Com_Ctrl_553, s_0, s_1, s_2, s_3, s_4, s_5, s_6, s_7, s_8, s_9, s_10, s_11, s_12, s_13, s_14, s_15, s_16, s_17, s_18, s_19, s_20, s_21, s_22, s_23, s_24, s_25, s_26, s_27, s_28, s_29, s_30, s_31, s_32, s_33, s_34, s_35, s_36, s_37, s_38, s_39, s_40, s_41, s_42, s_43, s_44, s_45, s_46, s_47, s_48, s_49, s_50, s_51, s_52, s_53, s_54, s_55, s_56, s_57, s_58, s_59, s_60, s_61, s_62, s_63, s_64, s_65, s_66, s_67, s_68, s_69, s_70, s_71, s_72, s_73, s_74, s_75, s_76, s_77, s_78, s_79, s_80, s_81, s_82, s_83, s_84, s_85, s_86, s_87, s_88, s_89, s_90, s_91, s_92, s_93, s_94, s_95, s_96, s_97, s_98, s_99, s_100, s_101, s_102, s_103, s_104, s_105, s_106, s_107, s_108, s_109, s_110, s_111, s_112, s_113, s_114, s_115, s_116, s_117, s_118, s_119, s_120, s_121, s_122, s_123, s_124, s_125, s_126, s_127, s_128, s_129, s_130, s_131, s_132, s_133, s_134, s_135, s_136, s_137, s_138, s_139, s_140, s_141, s_142, s_143, s_144, s_145, s_146, s_147, s_148, s_149, s_150, s_151, s_152, s_153, s_154, s_155, s_156, s_157, s_158, s_159, s_160, s_161, s_162, s_163, s_164, s_165, s_166, s_167, s_168, s_169, s_170, s_171, s_172, s_173, s_174, s_175, s_176, s_177, s_178, s_179, s_180, s_181, s_182, s_183, s_184, s_185, s_186, s_187, s_188, s_189, s_190, s_191, s_192, s_193, s_194, s_195, s_196, s_197, s_198, s_199, s_200, s_201, s_202, s_203, s_204, s_205, s_206, s_207, s_208, s_209, s_210, s_211, s_212, s_213, s_214, s_215, s_216, s_217, s_218, s_219, s_220, s_221, s_222, s_223, s_224, s_225, s_226, s_227, s_228, s_229, s_230, s_231, s_232, s_233, s_234, s_235, s_236, s_237, s_238, s_239, s_240, s_241, s_242, s_243, s_244, s_245, s_246, s_247, s_248, s_249, s_250, s_251, s_252, s_253, s_254, s_255, s_256, s_257, s_258, s_259, s_260, s_261, s_262, s_263, s_264, s_265, s_266, s_267, s_268, s_269, s_270, s_271, s_272, s_273, s_274, s_275, s_276, s_277, s_278, s_279, s_280, s_281, s_282, s_283, s_284, s_285, s_286, s_287, s_288, s_289, s_290, s_291, s_292, s_293, s_294, s_295, s_296, s_297, s_298, s_299, s_300, s_301, s_302, s_303, s_304, s_305, s_306, s_307, s_308, s_309, s_310, s_311, s_312, s_313, s_314, s_315, s_316, s_317, s_318, s_319, s_320, s_321, s_322, s_323, s_324, s_325, s_326, s_327, s_328, s_329, s_330, s_331, s_332, s_333, s_334, s_335, s_336, s_337, s_338, s_339, s_340, s_341, s_342, s_343, s_344, s_345, s_346, s_347, s_348, s_349, s_350, s_351, s_352, s_353, s_354, s_355, s_356, s_357, s_358, s_359, s_360, s_361, s_362, s_363, s_364, s_365, s_366, s_367, s_368, s_369, s_370, s_371, s_372, s_373, s_374, s_375, s_376, s_377, s_378, s_379, s_380, s_381, s_382, s_383, s_384, s_385, s_386, s_387, s_388, s_389, s_390, s_391, s_392, s_393, s_394, s_395, s_396, s_397, s_398, s_399, s_400, s_401, s_402, s_403, s_404, s_405, s_406, s_407, s_408, s_409, s_410, s_411, s_412, s_413, s_414, s_415, s_416, s_417, s_418, s_419, s_420, s_421, s_422, s_423, s_424, s_425, s_426, s_427, s_428, s_429, s_430, s_431, s_432, s_433, s_434, s_435, s_436, s_437, s_438, s_439, s_440, s_441, s_442, s_443, s_444, s_445, s_446, s_447, s_448, s_449, s_450, s_451, s_452, s_453, s_454, s_455, s_456, s_457, s_458, s_459, s_460, s_461, s_462, s_463, s_464, s_465, s_466, s_467, s_468, s_469, s_470, s_471, s_472, s_473, s_474, s_475, s_476, s_477, s_478, s_479, s_480, s_481, s_482, s_483, s_484, s_485, s_486, s_487, s_488, s_489, s_490, s_491, s_492, s_493, s_494, s_495, s_496, s_497, s_498, s_499, s_500, s_501, s_502, s_503, s_504, s_505, s_506, s_507, s_508, s_509, s_510, s_511, s_512, s_513, s_514, s_515, s_516, s_517, s_518, s_519, s_520, s_521, s_522, s_523, s_524, s_525, s_526, s_527, s_528, s_529, s_530, s_531, s_532, s_533, s_534, s_535, s_536, s_537, s_538, s_539, s_540, s_541, s_542, s_543, s_544, s_545, s_546, s_547, s_548, s_549, s_550, s_551, s_552, s_553, s_554, s_555, s_556, s_557, s_558, s_559, s_560, s_561, s_562, s_563, s_564, s_565, s_566, s_567, s_568, s_569, s_570, s_571, s_572, s_573, s_574, s_575, s_576, s_577, s_578, s_579, s_580, s_581, s_582, s_583, s_584, s_585, s_586, s_587, s_588, s_589, s_590, s_591, s_592, s_593, s_594, s_595, s_596, s_597, s_598, s_599, s_600, s_601, s_602, s_603, s_604, s_605, s_606, s_607, s_608, s_609, s_610, s_611, s_612, s_613, s_614, s_615, s_616, s_617, s_618, s_619, s_620, s_621, s_622, s_623, s_624, s_625, s_626, s_627, s_628, s_629, s_630, s_631, s_632, s_633, s_634, s_635, s_636, s_637, s_638, s_639, s_640, s_641, s_642, s_643, s_644, s_645, s_646, s_647, s_648, s_649, s_650, s_651, s_652, s_653, s_654, s_655, s_656, s_657, s_658, s_659, s_660, s_661, s_662, s_663, s_664, s_665, s_666, s_667, s_668, s_669, s_670, s_671, s_672, s_673, s_674, s_675, s_676, s_677, s_678, s_679, s_680, s_681, s_682, s_683, s_684, s_685, s_686, s_687, s_688, s_689, s_690, s_691, s_692, s_693, s_694, s_695, s_696, s_697, s_698, s_699, s_700, s_701, s_702, s_703, s_704, s_705, s_706, s_707, s_708, s_709, s_710, s_711, s_712, s_713, s_714, s_715, s_716, s_717, s_718, s_719, s_720, s_721, s_722, s_723, s_724, s_725, s_726, s_727, s_728, s_729, s_730, s_731, s_732, s_733, s_734, s_735, s_736, s_737, s_738, s_739, s_740, s_741, s_742, s_743, s_744, s_745, s_746, s_747, s_748, s_749, s_750, s_751, s_752, s_753, s_754, s_755, s_756, s_757, s_758, s_759, s_760, s_761, s_762, s_763, s_764, s_765, s_766, s_767, s_768, s_769, s_770, s_771, s_772, s_773, s_774, s_775, s_776, s_777, s_778, s_779, s_780, s_781, s_782, s_783, s_784, s_785, s_786, s_787, s_788, s_789, s_790, s_791, s_792, s_793, s_794, s_795, s_796, s_797, s_798, s_799, s_800, s_801, s_802, s_803, s_804, s_805, s_806, s_807, s_808, s_809, s_810, s_811, s_812, s_813, s_814, s_815, s_816, s_817, s_818, s_819, s_820, s_821, s_822, s_823, s_824, s_825, s_826, s_827, s_828, s_829, s_830, s_831, s_832, s_833, s_834, s_835, s_836, s_837, s_838, s_839, s_840, s_841, s_842, s_843, s_844, s_845, s_846, s_847, s_848, s_849, s_850, s_851, s_852, s_853, s_854, s_855, s_856, s_857, s_858, s_859, s_860, s_861, s_862, s_863, s_864, s_865, s_866, s_867, s_868, s_869, s_870, s_871, s_872, s_873, s_874, s_875, s_876, s_877, s_878, s_879, s_880, s_881, s_882, s_883, s_884, s_885, s_886, s_887, s_888, s_889, s_890, s_891, s_892, s_893, s_894, s_895, s_896, s_897, s_898, s_899, s_900, s_901, s_902, s_903, s_904, s_905, s_906, s_907, s_908, s_909, s_910, s_911, s_912, s_913, s_914, s_915, s_916, s_917, s_918, s_919, s_920, s_921, s_922, s_923, s_924, s_925, s_926, s_927, s_928, s_929, s_930, s_931, s_932, s_933, s_934, s_935, s_936, s_937, s_938, s_939, s_940, s_941, s_942, s_943, s_944, s_945, s_946, s_947, s_948, s_949, s_950, s_951, s_952, s_953, s_954, s_955, s_956, s_957, s_958, s_959, s_960, s_961, s_962, s_963, s_964;

BUF BUF_1099 (DSACK1_n, DSACK1_n_combQ);
BUF BUF_1100 (DSACK0_n, DSACK0_n_combQ);
TRI #(.TA(2.0), .TEN(4.0)) TRI_9 (.Q(MA6), .A(s_0), .EN(vcc));
BUF #(.TP(1.0)) BUF_8 (s_0, s_1);
XOR2 #(.TP(0)) XOR2_7 (s_1, s_2, gnd);
OR2 #(.TP(0)) OR2_0 (s_2, s_3, s_4);
AND2 #(.TP(3.0)) AND2_1 (s_3, s_5, s_6);
AND2 #(.TP(3.0)) AND2_4 (s_4, s_7, s_8);
INV #(.TP(1.5)) INV_2 (s_5, id00200);
BUF #(.TP(1.5)) BUF_3 (s_6, A18);
BUF #(.TP(1.5)) BUF_5 (s_7, id00200);
BUF #(.TP(1.5)) BUF_6 (s_8, A8);
TRI #(.TA(2.0), .TEN(4.0)) TRI_19 (.Q(MA7), .A(s_9), .EN(vcc));
BUF #(.TP(1.0)) BUF_18 (s_9, s_10);
XOR2 #(.TP(0)) XOR2_17 (s_10, s_11, gnd);
OR2 #(.TP(0)) OR2_10 (s_11, s_12, s_13);
AND2 #(.TP(3.0)) AND2_11 (s_12, s_14, s_15);
AND2 #(.TP(3.0)) AND2_14 (s_13, s_16, s_17);
INV #(.TP(1.5)) INV_12 (s_14, id00200);
BUF #(.TP(1.5)) BUF_13 (s_15, A19);
BUF #(.TP(1.5)) BUF_15 (s_16, id00200);
BUF #(.TP(1.5)) BUF_16 (s_17, A9);
TRI #(.TA(2.0), .TEN(4.0)) TRI_29 (.Q(MA10), .A(s_18), .EN(vcc));
BUF #(.TP(1.0)) BUF_28 (s_18, s_19);
XOR2 #(.TP(0)) XOR2_27 (s_19, s_20, gnd);
OR2 #(.TP(0)) OR2_20 (s_20, s_21, s_22);
AND2 #(.TP(3.0)) AND2_21 (s_21, s_23, s_24);
AND2 #(.TP(3.0)) AND2_24 (s_22, s_25, s_26);
INV #(.TP(1.5)) INV_22 (s_23, id00200);
BUF #(.TP(1.5)) BUF_23 (s_24, A22);
BUF #(.TP(1.5)) BUF_25 (s_25, id00200);
BUF #(.TP(1.5)) BUF_26 (s_26, A23);
TRI #(.TA(2.0), .TEN(4.0)) TRI_39 (.Q(MA11), .A(s_27), .EN(vcc));
BUF #(.TP(1.0)) BUF_38 (s_27, s_28);
XOR2 #(.TP(0)) XOR2_37 (s_28, s_29, gnd);
OR2 #(.TP(0)) OR2_30 (s_29, s_30, s_31);
AND2 #(.TP(3.0)) AND2_31 (s_30, s_32, s_33);
AND2 #(.TP(3.0)) AND2_34 (s_31, s_34, s_35);
INV #(.TP(1.5)) INV_32 (s_32, id00200);
BUF #(.TP(1.5)) BUF_33 (s_33, A24);
BUF #(.TP(1.5)) BUF_35 (s_34, id00200);
BUF #(.TP(1.5)) BUF_36 (s_35, A25);
DFFEARS #(.TCQ(1.0), .TAR(2.0), .TAS(2.0), .TSU(3.0), .THD(2.0)) DFFEARS_44 (.Q(id00211), .D(id00211D), .CLK(s_36), .AR(s_37), .AS(gnd), .CE(vcc));
BUF #(.TP(1.5), .ND(1)) BUF_45 (s_36, DRAM_CLK);
INV #(.TP(1.5)) INV_46 (s_37, PWR_RST_n);
XOR2 #(.TP(0)) XOR2_43 (id00211D, s_38, gnd);
OR1 #(.TP(0)) OR1_42 (s_38, s_39);
AND1 #(.TP(3.0)) AND1_41 (s_39, s_40);
BUF #(.TP(1.5)) BUF_40 (s_40, id00210);
TRI #(.TA(2.0), .TEN(4.0)) TRI_59 (.Q(RAS3_n), .A(id00205Q), .EN(vcc));
DFFEARS #(.TCQ(1.0), .TAR(2.0), .TAS(2.0), .TSU(3.0), .THD(2.0)) DFFEARS_55 (.Q(id00205Q), .D(id00205D), .CLK(s_41), .AR(gnd), .AS(s_42), .CE(vcc));
BUF #(.TP(1.5), .ND(1)) BUF_56 (s_41, DRAM_CLK);
AND1 #(.TP(3.0)) AND1_57 (s_42, s_43);
BUF #(.TP(1.5)) BUF_58 (s_43, Com_Ctrl_554);
XOR2 #(.TP(0)) XOR2_54 (id00205D, s_44, gnd);
OR2 #(.TP(0)) OR2_47 (s_44, s_45, s_46);
AND2 #(.TP(3.0)) AND2_48 (s_45, s_47, s_48);
AND2 #(.TP(3.0)) AND2_51 (s_46, s_49, s_50);
INV #(.TP(1.5)) INV_49 (s_47, id00108Q);
INV #(.TP(1.5)) INV_50 (s_48, id00101QN);
INV #(.TP(1.5)) INV_52 (s_49, id00108Q);
BUF #(.TP(1.5)) BUF_53 (s_50, id00205Q);
DFFEARS #(.TCQ(1.0), .TAR(2.0), .TAS(2.0), .TSU(3.0), .THD(2.0)) DFFEARS_64 (.Q(id00215), .D(id00215D), .CLK(s_51), .AR(s_52), .AS(gnd), .CE(vcc));
BUF #(.TP(1.5), .ND(1)) BUF_65 (s_51, DRAM_CLK);
INV #(.TP(1.5)) INV_66 (s_52, PWR_RST_n);
XOR2 #(.TP(0)) XOR2_63 (id00215D, s_53, gnd);
OR1 #(.TP(0)) OR1_62 (s_53, s_54);
AND1 #(.TP(3.0)) AND1_61 (s_54, s_55);
BUF #(.TP(1.5)) BUF_60 (s_55, id00214);
TRI #(.TA(2.0), .TEN(4.0)) TRI_79 (.Q(RAS2_n), .A(id00207Q), .EN(vcc));
DFFEARS #(.TCQ(1.0), .TAR(2.0), .TAS(2.0), .TSU(3.0), .THD(2.0)) DFFEARS_75 (.Q(id00207Q), .D(id00207D), .CLK(s_56), .AR(gnd), .AS(s_57), .CE(vcc));
BUF #(.TP(1.5), .ND(1)) BUF_76 (s_56, DRAM_CLK);
AND1 #(.TP(3.0)) AND1_77 (s_57, s_58);
BUF #(.TP(1.5)) BUF_78 (s_58, Com_Ctrl_554);
XOR2 #(.TP(0)) XOR2_74 (id00207D, s_59, gnd);
OR2 #(.TP(0)) OR2_67 (s_59, s_60, s_61);
AND2 #(.TP(3.0)) AND2_68 (s_60, s_62, s_63);
AND2 #(.TP(3.0)) AND2_71 (s_61, s_64, s_65);
INV #(.TP(1.5)) INV_69 (s_62, id00099Q);
INV #(.TP(1.5)) INV_70 (s_63, id00101QN);
INV #(.TP(1.5)) INV_72 (s_64, id00099Q);
BUF #(.TP(1.5)) BUF_73 (s_65, id00207Q);
TRI #(.TA(2.0), .TEN(4.0)) TRI_92 (.Q(RAS1_n), .A(id00206Q), .EN(vcc));
DFFEARS #(.TCQ(1.0), .TAR(2.0), .TAS(2.0), .TSU(3.0), .THD(2.0)) DFFEARS_88 (.Q(id00206Q), .D(id00206D), .CLK(s_66), .AR(gnd), .AS(s_67), .CE(vcc));
BUF #(.TP(1.5), .ND(1)) BUF_89 (s_66, DRAM_CLK);
AND1 #(.TP(3.0)) AND1_90 (s_67, s_68);
BUF #(.TP(1.5)) BUF_91 (s_68, Com_Ctrl_554);
XOR2 #(.TP(0)) XOR2_87 (id00206D, s_69, gnd);
OR2 #(.TP(0)) OR2_80 (s_69, s_70, s_71);
AND2 #(.TP(3.0)) AND2_81 (s_70, s_72, s_73);
AND2 #(.TP(3.0)) AND2_84 (s_71, s_74, s_75);
INV #(.TP(1.5)) INV_82 (s_72, id00108Q);
INV #(.TP(1.5)) INV_83 (s_73, id00101QN);
INV #(.TP(1.5)) INV_85 (s_74, id00108Q);
BUF #(.TP(1.5)) BUF_86 (s_75, id00206Q);
TRI #(.TA(2.0), .TEN(4.0)) TRI_125 (.Q(CAS0_n), .A(id00204Q), .EN(vcc));
DFFEARS #(.TCQ(1.0), .TAR(2.0), .TAS(2.0), .TSU(3.0), .THD(2.0)) DFFEARS_121 (.Q(id00204Q), .D(id00204D), .CLK(s_76), .AR(gnd), .AS(s_77), .CE(vcc));
BUF #(.TP(1.5), .ND(1)) BUF_122 (s_76, DRAM_CLK);
AND1 #(.TP(3.0)) AND1_123 (s_77, s_78);
BUF #(.TP(1.5)) BUF_124 (s_78, Com_Ctrl_554);
XOR2 #(.TP(0)) XOR2_120 (id00204D, s_79, vcc);
OR3 #(.TP(0)) OR3_114 (s_79, s_80, s_81, s_82);
AND2 #(.TP(3.0)) AND2_115 (s_80, s_83, s_84);
AND1 #(.TP(3.0)) AND1_118 (s_81, s_85);
BUF #(.TP(1.5)) BUF_116 (s_83, id00211);
BUF #(.TP(1.5)) BUF_117 (s_84, R_W);
BUF #(.TP(1.5)) BUF_119 (s_85, id00214);
OR5 #(.TP(0)) OR5_93 (s_82, s_86, s_87, s_88, s_89, s_90);
AND3 #(.TP(3.0)) AND3_94 (s_86, s_91, s_92, s_93);
AND2 #(.TP(3.0)) AND2_98 (s_87, s_94, s_95);
AND3 #(.TP(3.0)) AND3_101 (s_88, s_96, s_97, s_98);
AND3 #(.TP(3.0)) AND3_105 (s_89, s_99, s_100, s_101);
AND4 #(.TP(3.0)) AND4_109 (s_90, s_102, s_103, s_104, s_105);
BUF #(.TP(1.5)) BUF_95 (s_91, id00211);
INV #(.TP(1.5)) INV_96 (s_92, SIZ0);
INV #(.TP(1.5)) INV_97 (s_93, SIZ1);
INV #(.TP(1.5)) INV_99 (s_94, id00204Q);
BUF #(.TP(1.5)) BUF_100 (s_95, id00101QN);
BUF #(.TP(1.5)) BUF_102 (s_96, id00211);
BUF #(.TP(1.5)) BUF_103 (s_97, A1);
BUF #(.TP(1.5)) BUF_104 (s_98, A0);
BUF #(.TP(1.5)) BUF_106 (s_99, id00211);
BUF #(.TP(1.5)) BUF_107 (s_100, SIZ1);
BUF #(.TP(1.5)) BUF_108 (s_101, A1);
BUF #(.TP(1.5)) BUF_110 (s_102, id00211);
BUF #(.TP(1.5)) BUF_111 (s_103, SIZ0);
BUF #(.TP(1.5)) BUF_112 (s_104, SIZ1);
BUF #(.TP(1.5)) BUF_113 (s_105, A0);
TRI #(.TA(2.0), .TEN(4.0)) TRI_135 (.Q(MA0), .A(s_106), .EN(vcc));
BUF #(.TP(1.0)) BUF_134 (s_106, s_107);
XOR2 #(.TP(0)) XOR2_133 (s_107, s_108, gnd);
OR2 #(.TP(0)) OR2_126 (s_108, s_109, s_110);
AND2 #(.TP(3.0)) AND2_127 (s_109, s_111, s_112);
AND2 #(.TP(3.0)) AND2_130 (s_110, s_113, s_114);
INV #(.TP(1.5)) INV_128 (s_111, id00200);
BUF #(.TP(1.5)) BUF_129 (s_112, A12);
BUF #(.TP(1.5)) BUF_131 (s_113, id00200);
BUF #(.TP(1.5)) BUF_132 (s_114, A2);
DFFEARS #(.TCQ(1.0), .TAR(2.0), .TAS(2.0), .TSU(3.0), .THD(2.0)) DFFEARS_143 (.Q(id00212), .D(id00212D), .CLK(s_115), .AR(s_116), .AS(gnd), .CE(vcc));
BUF #(.TP(1.5), .ND(1)) BUF_144 (s_115, DRAM_CLK);
INV #(.TP(1.5)) INV_145 (s_116, PWR_RST_n);
XOR2 #(.TP(0)) XOR2_142 (id00212D, s_117, gnd);
OR2 #(.TP(0)) OR2_136 (s_117, s_118, s_119);
AND2 #(.TP(3.0)) AND2_137 (s_118, s_120, s_121);
AND1 #(.TP(3.0)) AND1_140 (s_119, s_122);
BUF #(.TP(1.5)) BUF_138 (s_120, id00212);
INV #(.TP(1.5)) INV_139 (s_121, id00243);
BUF #(.TP(1.5)) BUF_141 (s_122, id00211);
TRI #(.TA(2.0), .TEN(4.0)) TRI_155 (.Q(MA3), .A(s_123), .EN(vcc));
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
INV #(.TP(1.5)) INV_229 (s_186, PWR_RST_n);
XOR2 #(.TP(0)) XOR2_226 (id00213D, s_187, gnd);
OR1 #(.TP(0)) OR1_225 (s_187, s_188);
AND2 #(.TP(3.0)) AND2_224 (s_188, s_189, s_190);
BUF #(.TP(1.5)) BUF_222 (s_189, id00228);
BUF #(.TP(1.5)) BUF_223 (s_190, id00209);
DFFEARS #(.TCQ(1.0), .TAR(2.0), .TAS(2.0), .TSU(3.0), .THD(2.0)) DFFEARS_241 (.Q(id00231), .D(id00231D), .CLK(s_191), .AR(s_192), .AS(gnd), .CE(vcc));
BUF #(.TP(1.5), .ND(1)) BUF_242 (s_191, DRAM_CLK);
INV #(.TP(1.5)) INV_243 (s_192, PWR_RST_n);
XOR2 #(.TP(0)) XOR2_240 (id00231D, s_193, gnd);
OR2 #(.TP(0)) OR2_230 (s_193, s_194, s_195);
AND3 #(.TP(3.0)) AND3_231 (s_194, s_196, s_197, s_198);
AND4 #(.TP(3.0)) AND4_235 (s_195, s_199, s_200, s_201, s_202);
INV #(.TP(1.5)) INV_232 (s_196, id00242);
INV #(.TP(4.0)) INV_233 (s_197, id00096Q);
BUF #(.TP(1.5)) BUF_234 (s_198, id00231);
INV #(.TP(1.5)) INV_236 (s_199, id00242);
INV #(.TP(4.0)) INV_237 (s_200, id00096Q);
BUF #(.TP(1.5)) BUF_238 (s_201, id00243);
INV #(.TP(1.5)) INV_239 (s_202, DRAM_SEL_n);
TRI #(.TA(2.0), .TEN(4.0)) TRI_253 (.Q(MA5), .A(s_203), .EN(vcc));
BUF #(.TP(1.0)) BUF_252 (s_203, s_204);
XOR2 #(.TP(0)) XOR2_251 (s_204, s_205, gnd);
OR2 #(.TP(0)) OR2_244 (s_205, s_206, s_207);
AND2 #(.TP(3.0)) AND2_245 (s_206, s_208, s_209);
AND2 #(.TP(3.0)) AND2_248 (s_207, s_210, s_211);
INV #(.TP(1.5)) INV_246 (s_208, id00200);
BUF #(.TP(1.5)) BUF_247 (s_209, A17);
BUF #(.TP(1.5)) BUF_249 (s_210, id00200);
BUF #(.TP(1.5)) BUF_250 (s_211, A7);
DFFEARS #(.TCQ(1.0), .TAR(2.0), .TAS(2.0), .TSU(3.0), .THD(2.0)) DFFEARS_263 (.Q(id00200), .D(id00200D), .CLK(s_212), .AR(s_213), .AS(gnd), .CE(vcc));
BUF #(.TP(1.5), .ND(1)) BUF_264 (s_212, DRAM_CLK);
AND1 #(.TP(3.0)) AND1_265 (s_213, s_214);
INV #(.TP(4.0)) INV_266 (s_214, Com_Ctrl_553);
XOR2 #(.TP(0)) XOR2_262 (id00200D, s_215, vcc);
OR2 #(.TP(0)) OR2_254 (s_215, s_216, s_217);
AND3 #(.TP(3.0)) AND3_255 (s_216, s_218, s_219, s_220);
AND2 #(.TP(3.0)) AND2_259 (s_217, s_221, s_222);
INV #(.TP(1.5)) INV_256 (s_218, id00210);
BUF #(.TP(1.5)) BUF_257 (s_219, id00212);
BUF #(.TP(1.5)) BUF_258 (s_220, id00243);
INV #(.TP(1.5)) INV_260 (s_221, id00210);
INV #(.TP(1.5)) INV_261 (s_222, id00200);
AND2 #(.TP(0)) AND2_267 (Com_Ctrl_553, s_223, s_224);
INV #(.TP(0)) INV_268 (s_223, AS_n);
BUF #(.TP(0)) BUF_269 (s_224, PWR_RST_n);
DFFEARS #(.TCQ(1.0), .TAR(2.0), .TAS(2.0), .TSU(3.0), .THD(2.0)) DFFEARS_304 (.Q(id00209), .D(id00209D), .CLK(s_228), .AR(gnd), .AS(s_229), .CE(vcc));
BUF #(.TP(1.5), .ND(1)) BUF_305 (s_228, DRAM_CLK);
INV #(.TP(1.5)) INV_306 (s_229, PWR_RST_n);
XOR2 #(.TP(0)) XOR2_303 (id00209D, s_230, gnd);
OR3 #(.TP(0)) OR3_292 (s_230, s_231, s_232, s_233);
AND4 #(.TP(3.0)) AND4_293 (s_231, s_234, s_235, s_236, s_237);
AND4 #(.TP(3.0)) AND4_298 (s_232, s_238, s_239, s_240, s_241);
BUF #(.TP(1.5)) BUF_294 (s_234, id00209);
INV #(.TP(1.5)) INV_295 (s_235, id00231);
INV #(.TP(1.5)) INV_296 (s_236, id00228);
BUF #(.TP(1.5)) BUF_297 (s_237, id00242);
BUF #(.TP(1.5)) BUF_299 (s_238, id00209);
INV #(.TP(1.5)) INV_300 (s_239, id00231);
INV #(.TP(1.5)) INV_301 (s_240, id00228);
BUF #(.TP(1.5)) BUF_302 (s_241, DRAM_SEL_n);
AND3 #(.TP(0)) AND3_270 (id00096Q, s_225, s_226, s_227);
BUF #(.TP(0)) BUF_271 (s_225, id00223);
BUF #(.TP(0)) BUF_272 (s_226, id00209);
INV #(.TP(0)) INV_273 (s_227, id00228);
OR4 #(.TP(0)) OR4_277 (s_233, s_244, s_245, s_246, s_247);
AND3 #(.TP(3.0)) AND3_278 (s_244, s_248, s_249, s_250);
AND1 #(.TP(3.0)) AND1_282 (s_245, s_251);
AND2 #(.TP(3.0)) AND2_284 (s_246, s_252, s_253);
AND4 #(.TP(3.0)) AND4_287 (s_247, s_254, s_255, s_256, s_257);
BUF #(.TP(1.5)) BUF_279 (s_248, id00209);
INV #(.TP(1.5)) INV_280 (s_249, id00228);
INV #(.TP(4.0)) INV_281 (s_250, id00096Q);
BUF #(.TP(1.5)) BUF_283 (s_251, id00221);
BUF #(.TP(1.5)) BUF_285 (s_252, id00243);
BUF #(.TP(1.5)) BUF_286 (s_253, id00212);
BUF #(.TP(1.5)) BUF_288 (s_254, id00209);
INV #(.TP(1.5)) INV_289 (s_255, id00231);
INV #(.TP(1.5)) INV_290 (s_256, id00228);
INV #(.TP(1.5)) INV_291 (s_257, id00243);
AND2 #(.TP(0)) AND2_274 (Com_Ctrl_553, s_242, s_243);
INV #(.TP(0)) INV_275 (s_242, AS_n);
BUF #(.TP(0)) BUF_276 (s_243, PWR_RST_n);
DFFEARS #(.TCQ(1.0), .TAR(2.0), .TAS(2.0), .TSU(3.0), .THD(2.0)) DFFEARS_320 (.Q(id00232), .D(id00232D), .CLK(s_258), .AR(s_259), .AS(gnd), .CE(vcc));
BUF #(.TP(1.5), .ND(1)) BUF_321 (s_258, DRAM_CLK);
INV #(.TP(1.5)) INV_322 (s_259, PWR_RST_n);
XOR2 #(.TP(0)) XOR2_319 (id00232D, s_260, vcc);
OR2 #(.TP(0)) OR2_307 (s_260, s_261, s_262);
AND8 #(.TP(3.0)) AND8_308 (s_261, s_263, s_264, s_265, s_266, s_267, s_268, s_269, s_270);
AND1 #(.TP(3.0)) AND1_317 (s_262, s_271);
BUF #(.TP(1.5)) BUF_309 (s_263, id00233);
BUF #(.TP(1.5)) BUF_310 (s_264, id00234);
INV #(.TP(1.5)) INV_311 (s_265, id00235);
BUF #(.TP(1.5)) BUF_312 (s_266, id00236);
BUF #(.TP(1.5)) BUF_313 (s_267, id00237);
BUF #(.TP(1.5)) BUF_314 (s_268, id00238);
INV #(.TP(1.5)) INV_315 (s_269, id00239);
BUF #(.TP(1.5)) BUF_316 (s_270, id00240);
BUF #(.TP(1.5)) BUF_318 (s_271, id00232);
DFFEARS #(.TCQ(1.0), .TAR(2.0), .TAS(2.0), .TSU(3.0), .THD(2.0)) DFFEARS_340 (.Q(id00233), .D(id00233D), .CLK(s_272), .AR(s_273), .AS(gnd), .CE(vcc));
BUF #(.TP(1.5), .ND(1)) BUF_341 (s_272, DRAM_CLK);
INV #(.TP(1.5)) INV_342 (s_273, PWR_RST_n);
XOR2 #(.TP(0)) XOR2_339 (id00233D, s_274, vcc);
OR3 #(.TP(0)) OR3_323 (s_274, s_275, s_276, s_277);
AND2 #(.TP(3.0)) AND2_324 (s_275, s_278, s_279);
AND8 #(.TP(3.0)) AND8_327 (s_276, s_280, s_281, s_282, s_283, s_284, s_285, s_286, s_287);
AND2 #(.TP(3.0)) AND2_336 (s_277, s_288, s_289);
BUF #(.TP(1.5)) BUF_325 (s_278, id00232);
BUF #(.TP(1.5)) BUF_326 (s_279, id00233);
INV #(.TP(1.5)) INV_328 (s_280, id00232);
BUF #(.TP(1.5)) BUF_329 (s_281, id00234);
INV #(.TP(1.5)) INV_330 (s_282, id00235);
BUF #(.TP(1.5)) BUF_331 (s_283, id00236);
BUF #(.TP(1.5)) BUF_332 (s_284, id00237);
BUF #(.TP(1.5)) BUF_333 (s_285, id00238);
INV #(.TP(1.5)) INV_334 (s_286, id00239);
BUF #(.TP(1.5)) BUF_335 (s_287, id00240);
INV #(.TP(1.5)) INV_337 (s_288, id00232);
INV #(.TP(1.5)) INV_338 (s_289, id00233);
DFFEARS #(.TCQ(1.0), .TAR(2.0), .TAS(2.0), .TSU(3.0), .THD(2.0)) DFFEARS_360 (.Q(id00239), .D(id00239D), .CLK(s_290), .AR(s_291), .AS(gnd), .CE(vcc));
BUF #(.TP(1.5), .ND(1)) BUF_361 (s_290, DRAM_CLK);
INV #(.TP(1.5)) INV_362 (s_291, PWR_RST_n);
XOR2 #(.TP(0)) XOR2_359 (id00239D, s_292, gnd);
OR3 #(.TP(0)) OR3_343 (s_292, s_293, s_294, s_295);
AND2 #(.TP(3.0)) AND2_344 (s_293, s_296, s_297);
AND8 #(.TP(3.0)) AND8_347 (s_294, s_298, s_299, s_300, s_301, s_302, s_303, s_304, s_305);
AND2 #(.TP(3.0)) AND2_356 (s_295, s_306, s_307);
BUF #(.TP(1.5)) BUF_345 (s_296, id00239);
INV #(.TP(1.5)) INV_346 (s_297, id00238);
INV #(.TP(1.5)) INV_348 (s_298, id00239);
BUF #(.TP(1.5)) BUF_349 (s_299, id00238);
BUF #(.TP(1.5)) BUF_350 (s_300, id00237);
BUF #(.TP(1.5)) BUF_351 (s_301, id00232);
BUF #(.TP(1.5)) BUF_352 (s_302, id00235);
BUF #(.TP(1.5)) BUF_353 (s_303, id00233);
BUF #(.TP(1.5)) BUF_354 (s_304, id00234);
BUF #(.TP(1.5)) BUF_355 (s_305, id00236);
BUF #(.TP(1.5)) BUF_357 (s_306, id00239);
INV #(.TP(4.0)) INV_358 (s_307, id00048Q);
DFFEARS #(.TCQ(1.0), .TAR(2.0), .TAS(2.0), .TSU(3.0), .THD(2.0)) DFFEARS_386 (.Q(id00238), .D(id00238D), .CLK(s_308), .AR(s_309), .AS(gnd), .CE(vcc));
BUF #(.TP(1.5), .ND(1)) BUF_387 (s_308, DRAM_CLK);
INV #(.TP(1.5)) INV_388 (s_309, PWR_RST_n);
XOR2 #(.TP(0)) XOR2_385 (id00238D, s_310, vcc);
OR3 #(.TP(0)) OR3_363 (s_310, s_311, s_312, s_313);
AND2 #(.TP(3.0)) AND2_364 (s_311, s_314, s_315);
AND9 #(.TP(3.0)) AND9_367 (s_312, s_316, s_317, s_318, s_319, s_320, s_321, s_322, s_323, s_324);
AND7 #(.TP(3.0)) AND7_377 (s_313, s_325, s_326, s_327, s_328, s_329, s_330, s_331);
INV #(.TP(1.5)) INV_365 (s_314, id00238);
INV #(.TP(4.0)) INV_366 (s_315, id00048Q);
BUF #(.TP(1.5)) BUF_368 (s_316, id00238);
BUF #(.TP(1.5)) BUF_369 (s_317, id00237);
INV #(.TP(1.5)) INV_370 (s_318, id00232);
INV #(.TP(1.5)) INV_371 (s_319, id00235);
BUF #(.TP(1.5)) BUF_372 (s_320, id00233);
BUF #(.TP(1.5)) BUF_373 (s_321, id00234);
BUF #(.TP(1.5)) BUF_374 (s_322, id00236);
INV #(.TP(1.5)) INV_375 (s_323, id00239);
BUF #(.TP(1.5)) BUF_376 (s_324, id00240);
BUF #(.TP(1.5)) BUF_378 (s_325, id00238);
BUF #(.TP(1.5)) BUF_379 (s_326, id00237);
BUF #(.TP(1.5)) BUF_380 (s_327, id00232);
BUF #(.TP(1.5)) BUF_381 (s_328, id00235);
BUF #(.TP(1.5)) BUF_382 (s_329, id00233);
BUF #(.TP(1.5)) BUF_383 (s_330, id00234);
BUF #(.TP(1.5)) BUF_384 (s_331, id00236);
TRI #(.TA(2.0), .TEN(4.0)) TRI_395 (.Q(DSACK1_n_combQ), .A(s_332), .EN(s_333));
AND1 #(.TP(3.0)) AND1_396 (s_333, s_334);
INV #(.TP(1.5)) INV_397 (s_334, id00196);
BUF #(.TP(1.0)) BUF_394 (s_332, s_335);
XOR2 #(.TP(0)) XOR2_393 (s_335, s_336, vcc);
OR1 #(.TP(0)) OR1_392 (s_336, s_337);
AND2 #(.TP(3.0)) AND2_391 (s_337, s_338, s_339);
INV #(.TP(1.5)) INV_389 (s_338, AS_n);
INV #(.TP(1.5)) INV_390 (s_339, id00196);
TRI #(.TA(2.0), .TEN(4.0)) TRI_407 (.Q(MA9), .A(s_340), .EN(vcc));
BUF #(.TP(1.0)) BUF_406 (s_340, s_341);
XOR2 #(.TP(0)) XOR2_405 (s_341, s_342, gnd);
OR2 #(.TP(0)) OR2_398 (s_342, s_343, s_344);
AND2 #(.TP(3.0)) AND2_399 (s_343, s_345, s_346);
AND2 #(.TP(3.0)) AND2_402 (s_344, s_347, s_348);
INV #(.TP(1.5)) INV_400 (s_345, id00200);
BUF #(.TP(1.5)) BUF_401 (s_346, A21);
BUF #(.TP(1.5)) BUF_403 (s_347, id00200);
BUF #(.TP(1.5)) BUF_404 (s_348, A11);
DFFEARS #(.TCQ(1.0), .TAR(2.0), .TAS(2.0), .TSU(3.0), .THD(2.0)) DFFEARS_429 (.Q(id00234), .D(id00234D), .CLK(s_349), .AR(s_350), .AS(gnd), .CE(vcc));
BUF #(.TP(1.5), .ND(1)) BUF_430 (s_349, DRAM_CLK);
INV #(.TP(1.5)) INV_431 (s_350, PWR_RST_n);
XOR2 #(.TP(0)) XOR2_428 (id00234D, s_351, vcc);
OR4 #(.TP(0)) OR4_408 (s_351, s_352, s_353, s_354, s_355);
AND2 #(.TP(3.0)) AND2_409 (s_352, s_356, s_357);
AND3 #(.TP(3.0)) AND3_412 (s_353, s_358, s_359, s_360);
AND8 #(.TP(3.0)) AND8_416 (s_354, s_361, s_362, s_363, s_364, s_365, s_366, s_367, s_368);
AND2 #(.TP(3.0)) AND2_425 (s_355, s_369, s_370);
INV #(.TP(1.5)) INV_410 (s_356, id00234);
INV #(.TP(1.5)) INV_411 (s_357, id00233);
BUF #(.TP(1.5)) BUF_413 (s_358, id00234);
BUF #(.TP(1.5)) BUF_414 (s_359, id00232);
BUF #(.TP(1.5)) BUF_415 (s_360, id00233);
BUF #(.TP(1.5)) BUF_417 (s_361, id00234);
BUF #(.TP(1.5)) BUF_418 (s_362, id00233);
INV #(.TP(1.5)) INV_419 (s_363, id00235);
BUF #(.TP(1.5)) BUF_420 (s_364, id00236);
BUF #(.TP(1.5)) BUF_421 (s_365, id00237);
BUF #(.TP(1.5)) BUF_422 (s_366, id00238);
INV #(.TP(1.5)) INV_423 (s_367, id00239);
BUF #(.TP(1.5)) BUF_424 (s_368, id00240);
INV #(.TP(1.5)) INV_426 (s_369, id00234);
INV #(.TP(1.5)) INV_427 (s_370, id00232);
TRI #(.TA(2.0), .TEN(4.0)) TRI_438 (.Q(DSACK0_n_combQ), .A(s_371), .EN(s_372));
AND1 #(.TP(3.0)) AND1_439 (s_372, s_373);
INV #(.TP(1.5)) INV_440 (s_373, id00197);
BUF #(.TP(1.0)) BUF_437 (s_371, s_374);
XOR2 #(.TP(0)) XOR2_436 (s_374, s_375, vcc);
OR1 #(.TP(0)) OR1_435 (s_375, s_376);
AND2 #(.TP(3.0)) AND2_434 (s_376, s_377, s_378);
INV #(.TP(1.5)) INV_432 (s_377, AS_n);
INV #(.TP(1.5)) INV_433 (s_378, id00197);
DFFEARS #(.TCQ(1.0), .TAR(2.0), .TAS(2.0), .TSU(3.0), .THD(2.0)) DFFEARS_471 (.Q(id00236), .D(id00236D), .CLK(s_379), .AR(s_380), .AS(gnd), .CE(vcc));
BUF #(.TP(1.5), .ND(1)) BUF_472 (s_379, DRAM_CLK);
INV #(.TP(1.5)) INV_473 (s_380, PWR_RST_n);
XOR2 #(.TP(0)) XOR2_470 (id00236D, s_381, vcc);
OR2 #(.TP(0)) OR2_466 (s_381, s_382, s_383);
AND2 #(.TP(3.0)) AND2_467 (s_382, s_384, s_385);
INV #(.TP(1.5)) INV_468 (s_384, id00236);
INV #(.TP(1.5)) INV_469 (s_385, id00233);
OR5 #(.TP(0)) OR5_441 (s_383, s_386, s_387, s_388, s_389, s_390);
AND2 #(.TP(3.0)) AND2_442 (s_386, s_391, s_392);
AND2 #(.TP(3.0)) AND2_445 (s_387, s_393, s_394);
AND8 #(.TP(3.0)) AND8_448 (s_388, s_395, s_396, s_397, s_398, s_399, s_400, s_401, s_402);
AND5 #(.TP(3.0)) AND5_457 (s_389, s_403, s_404, s_405, s_406, s_407);
AND2 #(.TP(3.0)) AND2_463 (s_390, s_408, s_409);
INV #(.TP(1.5)) INV_443 (s_391, id00236);
INV #(.TP(1.5)) INV_444 (s_392, id00234);
INV #(.TP(1.5)) INV_446 (s_393, id00236);
INV #(.TP(1.5)) INV_447 (s_394, id00235);
BUF #(.TP(1.5)) BUF_449 (s_395, id00233);
BUF #(.TP(1.5)) BUF_450 (s_396, id00234);
INV #(.TP(1.5)) INV_451 (s_397, id00235);
INV #(.TP(1.5)) INV_452 (s_398, id00232);
BUF #(.TP(1.5)) BUF_453 (s_399, id00237);
BUF #(.TP(1.5)) BUF_454 (s_400, id00238);
INV #(.TP(1.5)) INV_455 (s_401, id00239);
BUF #(.TP(1.5)) BUF_456 (s_402, id00240);
BUF #(.TP(1.5)) BUF_458 (s_403, id00236);
BUF #(.TP(1.5)) BUF_459 (s_404, id00233);
BUF #(.TP(1.5)) BUF_460 (s_405, id00234);
BUF #(.TP(1.5)) BUF_461 (s_406, id00235);
BUF #(.TP(1.5)) BUF_462 (s_407, id00232);
INV #(.TP(1.5)) INV_464 (s_408, id00236);
INV #(.TP(1.5)) INV_465 (s_409, id00232);
TRI #(.TA(2.0), .TEN(4.0)) TRI_483 (.Q(MA8), .A(s_410), .EN(vcc));
BUF #(.TP(1.0)) BUF_482 (s_410, s_411);
XOR2 #(.TP(0)) XOR2_481 (s_411, s_412, gnd);
OR2 #(.TP(0)) OR2_474 (s_412, s_413, s_414);
AND2 #(.TP(3.0)) AND2_475 (s_413, s_415, s_416);
AND2 #(.TP(3.0)) AND2_478 (s_414, s_417, s_418);
INV #(.TP(1.5)) INV_476 (s_415, id00200);
BUF #(.TP(1.5)) BUF_477 (s_416, A20);
BUF #(.TP(1.5)) BUF_479 (s_417, id00200);
BUF #(.TP(1.5)) BUF_480 (s_418, A10);
DFFEARS #(.TCQ(1.0), .TAR(2.0), .TAS(2.0), .TSU(3.0), .THD(2.0)) DFFEARS_514 (.Q(id00240), .D(id00240D), .CLK(s_419), .AR(s_420), .AS(gnd), .CE(vcc));
BUF #(.TP(1.5), .ND(1)) BUF_515 (s_419, DRAM_CLK);
INV #(.TP(1.5)) INV_516 (s_420, PWR_RST_n);
XOR2 #(.TP(0)) XOR2_513 (id00240D, s_421, vcc);
OR5 #(.TP(0)) OR5_484 (s_421, s_422, s_423, s_424, s_425, s_426);
AND8 #(.TP(3.0)) AND8_485 (s_422, s_427, s_428, s_429, s_430, s_431, s_432, s_433, s_434);
AND9 #(.TP(3.0)) AND9_494 (s_423, s_435, s_436, s_437, s_438, s_439, s_440, s_441, s_442, s_443);
AND2 #(.TP(3.0)) AND2_504 (s_424, s_444, s_445);
AND2 #(.TP(3.0)) AND2_507 (s_425, s_446, s_447);
AND2 #(.TP(3.0)) AND2_510 (s_426, s_448, s_449);
INV #(.TP(1.5)) INV_486 (s_427, id00239);
BUF #(.TP(1.5)) BUF_487 (s_428, id00238);
INV #(.TP(1.5)) INV_488 (s_429, id00232);
BUF #(.TP(1.5)) BUF_489 (s_430, id00233);
BUF #(.TP(1.5)) BUF_490 (s_431, id00234);
INV #(.TP(1.5)) INV_491 (s_432, id00235);
BUF #(.TP(1.5)) BUF_492 (s_433, id00236);
BUF #(.TP(1.5)) BUF_493 (s_434, id00237);
BUF #(.TP(1.5)) BUF_495 (s_435, id00240);
BUF #(.TP(1.5)) BUF_496 (s_436, id00239);
BUF #(.TP(1.5)) BUF_497 (s_437, id00238);
BUF #(.TP(1.5)) BUF_498 (s_438, id00232);
BUF #(.TP(1.5)) BUF_499 (s_439, id00233);
BUF #(.TP(1.5)) BUF_500 (s_440, id00234);
BUF #(.TP(1.5)) BUF_501 (s_441, id00235);
BUF #(.TP(1.5)) BUF_502 (s_442, id00236);
BUF #(.TP(1.5)) BUF_503 (s_443, id00237);
INV #(.TP(1.5)) INV_505 (s_444, id00240);
INV #(.TP(1.5)) INV_506 (s_445, id00238);
INV #(.TP(1.5)) INV_508 (s_446, id00240);
INV #(.TP(1.5)) INV_509 (s_447, id00239);
INV #(.TP(1.5)) INV_511 (s_448, id00240);
INV #(.TP(4.0)) INV_512 (s_449, id00048Q);
TRI #(.TA(2.0), .TEN(4.0)) TRI_526 (.Q(MA2), .A(s_450), .EN(vcc));
BUF #(.TP(1.0)) BUF_525 (s_450, s_451);
XOR2 #(.TP(0)) XOR2_524 (s_451, s_452, gnd);
OR2 #(.TP(0)) OR2_517 (s_452, s_453, s_454);
AND2 #(.TP(3.0)) AND2_518 (s_453, s_455, s_456);
AND2 #(.TP(3.0)) AND2_521 (s_454, s_457, s_458);
INV #(.TP(1.5)) INV_519 (s_455, id00200);
BUF #(.TP(1.5)) BUF_520 (s_456, A14);
BUF #(.TP(1.5)) BUF_522 (s_457, id00200);
BUF #(.TP(1.5)) BUF_523 (s_458, A4);
TRI #(.TA(2.0), .TEN(4.0)) TRI_536 (.Q(MA4), .A(s_459), .EN(vcc));
BUF #(.TP(1.0)) BUF_535 (s_459, s_460);
XOR2 #(.TP(0)) XOR2_534 (s_460, s_461, gnd);
OR2 #(.TP(0)) OR2_527 (s_461, s_462, s_463);
AND2 #(.TP(3.0)) AND2_528 (s_462, s_464, s_465);
AND2 #(.TP(3.0)) AND2_531 (s_463, s_466, s_467);
INV #(.TP(1.5)) INV_529 (s_464, id00200);
BUF #(.TP(1.5)) BUF_530 (s_465, A16);
BUF #(.TP(1.5)) BUF_532 (s_466, id00200);
BUF #(.TP(1.5)) BUF_533 (s_467, A6);
DFFEARS #(.TCQ(1.0), .TAR(2.0), .TAS(2.0), .TSU(3.0), .THD(2.0)) DFFEARS_578 (.Q(id00237), .D(id00237D), .CLK(s_474), .AR(s_475), .AS(gnd), .CE(vcc));
BUF #(.TP(1.5), .ND(1)) BUF_579 (s_474, DRAM_CLK);
INV #(.TP(1.5)) INV_580 (s_475, PWR_RST_n);
XOR2 #(.TP(0)) XOR2_577 (id00237D, s_476, vcc);
OR3 #(.TP(0)) OR3_570 (s_476, s_477, s_478, s_479);
AND2 #(.TP(3.0)) AND2_571 (s_477, s_480, s_481);
AND2 #(.TP(3.0)) AND2_574 (s_478, s_482, s_483);
INV #(.TP(1.5)) INV_572 (s_480, id00237);
INV #(.TP(1.5)) INV_573 (s_481, id00234);
INV #(.TP(1.5)) INV_575 (s_482, id00237);
INV #(.TP(1.5)) INV_576 (s_483, id00236);
AND6 #(.TP(0)) AND6_537 (id00048Q, s_468, s_469, s_470, s_471, s_472, s_473);
BUF #(.TP(0)) BUF_538 (s_468, id00237);
BUF #(.TP(0)) BUF_539 (s_469, id00232);
BUF #(.TP(0)) BUF_540 (s_470, id00235);
BUF #(.TP(0)) BUF_541 (s_471, id00233);
BUF #(.TP(0)) BUF_542 (s_472, id00234);
BUF #(.TP(0)) BUF_543 (s_473, id00236);
OR5 #(.TP(0)) OR5_544 (s_479, s_484, s_485, s_486, s_487, s_488);
AND2 #(.TP(3.0)) AND2_545 (s_484, s_489, s_490);
AND2 #(.TP(3.0)) AND2_548 (s_485, s_491, s_492);
AND8 #(.TP(3.0)) AND8_551 (s_486, s_493, s_494, s_495, s_496, s_497, s_498, s_499, s_500);
AND6 #(.TP(3.0)) AND6_560 (s_487, s_501, s_502, s_503, s_504, s_505, s_506);
AND2 #(.TP(3.0)) AND2_567 (s_488, s_507, s_508);
INV #(.TP(1.5)) INV_546 (s_489, id00237);
INV #(.TP(1.5)) INV_547 (s_490, id00232);
INV #(.TP(1.5)) INV_549 (s_491, id00237);
INV #(.TP(1.5)) INV_550 (s_492, id00235);
BUF #(.TP(1.5)) BUF_552 (s_493, id00236);
INV #(.TP(1.5)) INV_553 (s_494, id00232);
INV #(.TP(1.5)) INV_554 (s_495, id00235);
BUF #(.TP(1.5)) BUF_555 (s_496, id00234);
BUF #(.TP(1.5)) BUF_556 (s_497, id00233);
BUF #(.TP(1.5)) BUF_557 (s_498, id00238);
INV #(.TP(1.5)) INV_558 (s_499, id00239);
BUF #(.TP(1.5)) BUF_559 (s_500, id00240);
BUF #(.TP(1.5)) BUF_561 (s_501, id00237);
BUF #(.TP(1.5)) BUF_562 (s_502, id00236);
BUF #(.TP(1.5)) BUF_563 (s_503, id00232);
BUF #(.TP(1.5)) BUF_564 (s_504, id00235);
BUF #(.TP(1.5)) BUF_565 (s_505, id00234);
BUF #(.TP(1.5)) BUF_566 (s_506, id00233);
INV #(.TP(1.5)) INV_568 (s_507, id00237);
INV #(.TP(1.5)) INV_569 (s_508, id00233);
DFFEARS #(.TCQ(1.0), .TAR(2.0), .TAS(2.0), .TSU(3.0), .THD(2.0)) DFFEARS_585 (.Q(id00216), .D(id00216D), .CLK(s_509), .AR(s_510), .AS(gnd), .CE(vcc));
BUF #(.TP(1.5), .ND(1)) BUF_586 (s_509, DRAM_CLK);
INV #(.TP(1.5)) INV_587 (s_510, PWR_RST_n);
XOR2 #(.TP(0)) XOR2_584 (id00216D, s_511, gnd);
OR1 #(.TP(0)) OR1_583 (s_511, s_512);
AND1 #(.TP(3.0)) AND1_582 (s_512, s_513);
BUF #(.TP(1.5)) BUF_581 (s_513, id00215);
DFFEARS #(.TCQ(1.0), .TAR(2.0), .TAS(2.0), .TSU(3.0), .THD(2.0)) DFFEARS_600 (.Q(id00241), .D(id00241D), .CLK(s_514), .AR(s_515), .AS(gnd), .CE(vcc));
BUF #(.TP(1.5), .ND(1)) BUF_601 (s_514, DRAM_CLK);
INV #(.TP(1.5)) INV_602 (s_515, PWR_RST_n);
XOR2 #(.TP(0)) XOR2_599 (id00241D, s_516, gnd);
OR1 #(.TP(0)) OR1_598 (s_516, s_517);
AND9 #(.TP(3.0)) AND9_597 (s_517, s_518, s_519, s_520, s_521, s_522, s_523, s_524, s_525, s_526);
BUF #(.TP(1.5)) BUF_588 (s_518, id00240);
INV #(.TP(1.5)) INV_589 (s_519, id00239);
BUF #(.TP(1.5)) BUF_590 (s_520, id00238);
INV #(.TP(1.5)) INV_591 (s_521, id00232);
BUF #(.TP(1.5)) BUF_592 (s_522, id00233);
BUF #(.TP(1.5)) BUF_593 (s_523, id00234);
INV #(.TP(1.5)) INV_594 (s_524, id00235);
BUF #(.TP(1.5)) BUF_595 (s_525, id00236);
BUF #(.TP(1.5)) BUF_596 (s_526, id00237);
DFFEARS #(.TCQ(1.0), .TAR(2.0), .TAS(2.0), .TSU(3.0), .THD(2.0)) DFFEARS_611 (.Q(id00230), .D(id00230D), .CLK(s_527), .AR(s_528), .AS(gnd), .CE(vcc));
BUF #(.TP(1.5), .ND(1)) BUF_612 (s_527, DRAM_CLK);
INV #(.TP(1.5)) INV_613 (s_528, PWR_RST_n);
XOR2 #(.TP(0)) XOR2_610 (id00230D, s_529, gnd);
OR2 #(.TP(0)) OR2_603 (s_529, s_530, s_531);
AND2 #(.TP(3.0)) AND2_604 (s_530, s_532, s_533);
AND2 #(.TP(3.0)) AND2_607 (s_531, s_534, s_535);
BUF #(.TP(1.5)) BUF_605 (s_532, id00230);
INV #(.TP(1.5)) INV_606 (s_533, id00221);
INV #(.TP(1.5)) INV_608 (s_534, id00230);
BUF #(.TP(1.5)) BUF_609 (s_535, id00221);
DFFEARS #(.TCQ(1.0), .TAR(2.0), .TAS(2.0), .TSU(3.0), .THD(2.0)) DFFEARS_625 (.Q(id00223), .D(id00223D), .CLK(s_536), .AR(s_537), .AS(gnd), .CE(vcc));
BUF #(.TP(1.5), .ND(1)) BUF_626 (s_536, DRAM_CLK);
INV #(.TP(1.5)) INV_627 (s_537, PWR_RST_n);
XOR2 #(.TP(0)) XOR2_624 (id00223D, s_538, gnd);
OR2 #(.TP(0)) OR2_614 (s_538, s_539, s_540);
AND1 #(.TP(3.0)) AND1_615 (s_539, s_541);
AND6 #(.TP(3.0)) AND6_617 (s_540, s_542, s_543, s_544, s_545, s_546, s_547);
BUF #(.TP(1.5)) BUF_616 (s_541, id00223);
INV #(.TP(1.5)) INV_618 (s_542, id00222);
BUF #(.TP(1.5)) BUF_619 (s_543, id00224);
BUF #(.TP(1.5)) BUF_620 (s_544, id00226);
BUF #(.TP(1.5)) BUF_621 (s_545, id00227);
BUF #(.TP(1.5)) BUF_622 (s_546, id00225);
BUF #(.TP(1.5)) BUF_623 (s_547, id00221);
BUF #(.TP(1.0)) BUF_647 (id00099Q, s_548);
XOR2 #(.TP(0)) XOR2_646 (s_548, s_549, gnd);
OR3 #(.TP(0)) OR3_628 (s_549, s_550, s_551, s_552);
AND2 #(.TP(3.0)) AND2_629 (s_550, s_553, s_554);
AND5 #(.TP(3.0)) AND5_632 (s_551, s_555, s_556, s_557, s_558, s_559);
AND7 #(.TP(3.0)) AND7_638 (s_552, s_560, s_561, s_562, s_563, s_564, s_565, s_566);
BUF #(.TP(1.5)) BUF_630 (s_553, id00215);
INV #(.TP(1.5)) INV_631 (s_554, id00230);
INV #(.TP(1.5)) INV_633 (s_555, A26);
BUF #(.TP(1.5)) BUF_634 (s_556, id00223);
BUF #(.TP(1.5)) BUF_635 (s_557, id00209);
INV #(.TP(1.5)) INV_636 (s_558, id00228);
BUF #(.TP(1.5)) BUF_637 (s_559, id00231);
INV #(.TP(1.5)) INV_639 (s_560, A26);
INV #(.TP(1.5)) INV_640 (s_561, DRAM_SEL_n);
INV #(.TP(1.5)) INV_641 (s_562, id00242);
BUF #(.TP(1.5)) BUF_642 (s_563, id00243);
BUF #(.TP(1.5)) BUF_643 (s_564, id00223);
BUF #(.TP(1.5)) BUF_644 (s_565, id00209);
INV #(.TP(1.5)) INV_645 (s_566, id00228);
BUF #(.TP(1.0)) BUF_667 (id00108Q, s_567);
XOR2 #(.TP(0)) XOR2_666 (s_567, s_568, gnd);
OR3 #(.TP(0)) OR3_648 (s_568, s_569, s_570, s_571);
AND2 #(.TP(3.0)) AND2_649 (s_569, s_572, s_573);
AND5 #(.TP(3.0)) AND5_652 (s_570, s_574, s_575, s_576, s_577, s_578);
AND7 #(.TP(3.0)) AND7_658 (s_571, s_579, s_580, s_581, s_582, s_583, s_584, s_585);
BUF #(.TP(1.5)) BUF_650 (s_572, id00215);
BUF #(.TP(1.5)) BUF_651 (s_573, id00230);
BUF #(.TP(1.5)) BUF_653 (s_574, A26);
BUF #(.TP(1.5)) BUF_654 (s_575, id00223);
BUF #(.TP(1.5)) BUF_655 (s_576, id00209);
INV #(.TP(1.5)) INV_656 (s_577, id00228);
BUF #(.TP(1.5)) BUF_657 (s_578, id00231);
BUF #(.TP(1.5)) BUF_659 (s_579, A26);
INV #(.TP(1.5)) INV_660 (s_580, DRAM_SEL_n);
INV #(.TP(1.5)) INV_661 (s_581, id00242);
BUF #(.TP(1.5)) BUF_662 (s_582, id00243);
BUF #(.TP(1.5)) BUF_663 (s_583, id00223);
BUF #(.TP(1.5)) BUF_664 (s_584, id00209);
INV #(.TP(1.5)) INV_665 (s_585, id00228);
DFFEARS #(.TCQ(1.0), .TAR(2.0), .TAS(2.0), .TSU(3.0), .THD(2.0)) DFFEARS_684 (.Q(id00235), .D(id00235D), .CLK(s_586), .AR(s_587), .AS(gnd), .CE(vcc));
BUF #(.TP(1.5), .ND(1)) BUF_685 (s_586, DRAM_CLK);
INV #(.TP(1.5)) INV_686 (s_587, PWR_RST_n);
XOR2 #(.TP(0)) XOR2_683 (id00235D, s_588, gnd);
OR4 #(.TP(0)) OR4_668 (s_588, s_589, s_590, s_591, s_592);
AND4 #(.TP(3.0)) AND4_669 (s_589, s_593, s_594, s_595, s_596);
AND2 #(.TP(3.0)) AND2_674 (s_590, s_597, s_598);
AND2 #(.TP(3.0)) AND2_677 (s_591, s_599, s_600);
AND2 #(.TP(3.0)) AND2_680 (s_592, s_601, s_602);
INV #(.TP(1.5)) INV_670 (s_593, id00235);
BUF #(.TP(1.5)) BUF_671 (s_594, id00232);
BUF #(.TP(1.5)) BUF_672 (s_595, id00234);
BUF #(.TP(1.5)) BUF_673 (s_596, id00233);
BUF #(.TP(1.5)) BUF_675 (s_597, id00235);
INV #(.TP(1.5)) INV_676 (s_598, id00233);
BUF #(.TP(1.5)) BUF_678 (s_599, id00235);
INV #(.TP(1.5)) INV_679 (s_600, id00234);
BUF #(.TP(1.5)) BUF_681 (s_601, id00235);
INV #(.TP(1.5)) INV_682 (s_602, id00232);
DFFEARS #(.TCQ(1.0), .TAR(2.0), .TAS(2.0), .TSU(3.0), .THD(2.0)) DFFEARS_691 (.Q(id00218), .D(id00218D), .CLK(s_603), .AR(s_604), .AS(gnd), .CE(vcc));
BUF #(.TP(1.5), .ND(1)) BUF_692 (s_603, DRAM_CLK);
INV #(.TP(1.5)) INV_693 (s_604, PWR_RST_n);
XOR2 #(.TP(0)) XOR2_690 (id00218D, s_605, gnd);
OR1 #(.TP(0)) OR1_689 (s_605, s_606);
AND1 #(.TP(3.0)) AND1_688 (s_606, s_607);
BUF #(.TP(1.5)) BUF_687 (s_607, id00217);
DFFEARS #(.TCQ(1.0), .TAR(2.0), .TAS(2.0), .TSU(3.0), .THD(2.0)) DFFEARS_698 (.Q(id00214), .D(id00214D), .CLK(s_608), .AR(s_609), .AS(gnd), .CE(vcc));
BUF #(.TP(1.5), .ND(1)) BUF_699 (s_608, DRAM_CLK);
INV #(.TP(1.5)) INV_700 (s_609, PWR_RST_n);
XOR2 #(.TP(0)) XOR2_697 (id00214D, s_610, gnd);
OR1 #(.TP(0)) OR1_696 (s_610, s_611);
AND1 #(.TP(3.0)) AND1_695 (s_611, s_612);
BUF #(.TP(1.5)) BUF_694 (s_612, id00213);
DFFEARS #(.TCQ(1.0), .TAR(2.0), .TAS(2.0), .TSU(3.0), .THD(2.0)) DFFEARS_705 (.Q(id00217), .D(id00217D), .CLK(s_613), .AR(s_614), .AS(gnd), .CE(vcc));
BUF #(.TP(1.5), .ND(1)) BUF_706 (s_613, DRAM_CLK);
INV #(.TP(1.5)) INV_707 (s_614, PWR_RST_n);
XOR2 #(.TP(0)) XOR2_704 (id00217D, s_615, gnd);
OR1 #(.TP(0)) OR1_703 (s_615, s_616);
AND1 #(.TP(3.0)) AND1_702 (s_616, s_617);
BUF #(.TP(1.5)) BUF_701 (s_617, id00216);
BUF #(.TP(1.0)) BUF_716 (id00101QN, s_618);
XOR2 #(.TP(0)) XOR2_715 (s_618, s_619, gnd);
OR2 #(.TP(0)) OR2_708 (s_619, s_620, s_621);
AND2 #(.TP(3.0)) AND2_709 (s_620, s_622, s_623);
AND2 #(.TP(3.0)) AND2_712 (s_621, s_624, s_625);
INV #(.TP(1.5)) INV_710 (s_622, id00219);
INV #(.TP(1.5)) INV_711 (s_623, id00243);
INV #(.TP(1.5)) INV_713 (s_624, id00219);
INV #(.TP(1.5)) INV_714 (s_625, id00212);
DFFEARS #(.TCQ(1.0), .TAR(2.0), .TAS(2.0), .TSU(3.0), .THD(2.0)) DFFEARS_725 (.Q(id00003), .D(id00003D), .CLK(s_626), .AR(s_627), .AS(gnd), .CE(vcc));
BUF #(.TP(1.5), .ND(1)) BUF_726 (s_626, DRAM_CLK);
INV #(.TP(1.5)) INV_727 (s_627, PWR_RST_n);
XOR2 #(.TP(0)) XOR2_724 (id00003D, s_628, gnd);
OR2 #(.TP(0)) OR2_717 (s_628, s_629, s_630);
AND2 #(.TP(3.0)) AND2_718 (s_629, s_631, s_632);
AND2 #(.TP(3.0)) AND2_721 (s_630, s_633, s_634);
BUF #(.TP(1.5)) BUF_719 (s_631, id00228);
BUF #(.TP(1.5)) BUF_720 (s_632, id00209);
BUF #(.TP(1.5)) BUF_722 (s_633, id00003);
INV #(.TP(1.5)) INV_723 (s_634, id00220);
BUF #(.TP(1.0)) BUF_735 (Com_Ctrl_554, s_635);
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
BUF #(.TP(1.5)) BUF_928 (s_824, id00224);
INV #(.TP(1.5)) INV_929 (s_825, id00222);
BUF #(.TP(1.5)) BUF_930 (s_826, id00223);
DFFEARS #(.TCQ(1.0), .TAR(2.0), .TAS(2.0), .TSU(3.0), .THD(2.0)) DFFEARS_939 (.Q(id00221), .D(id00221D), .CLK(s_827), .AR(s_828), .AS(gnd), .CE(vcc));
BUF #(.TP(1.5), .ND(1)) BUF_940 (s_827, DRAM_CLK);
INV #(.TP(1.5)) INV_941 (s_828, PWR_RST_n);
XOR2 #(.TP(0)) XOR2_938 (id00221D, s_829, gnd);
OR1 #(.TP(0)) OR1_937 (s_829, s_830);
AND1 #(.TP(3.0)) AND1_936 (s_830, s_831);
BUF #(.TP(1.5)) BUF_935 (s_831, id00220);
DFFEARS #(.TCQ(1.0), .TAR(2.0), .TAS(2.0), .TSU(3.0), .THD(2.0)) DFFEARS_946 (.Q(id00219), .D(id00219D), .CLK(s_832), .AR(s_833), .AS(gnd), .CE(vcc));
BUF #(.TP(1.5), .ND(1)) BUF_947 (s_832, DRAM_CLK);
INV #(.TP(1.5)) INV_948 (s_833, PWR_RST_n);
XOR2 #(.TP(0)) XOR2_945 (id00219D, s_834, gnd);
OR1 #(.TP(0)) OR1_944 (s_834, s_835);
AND1 #(.TP(3.0)) AND1_943 (s_835, s_836);
BUF #(.TP(1.5)) BUF_942 (s_836, id00218);
DFFEARS #(.TCQ(1.0), .TAR(2.0), .TAS(2.0), .TSU(3.0), .THD(2.0)) DFFEARS_953 (.Q(id00220), .D(id00220D), .CLK(s_837), .AR(s_838), .AS(gnd), .CE(vcc));
BUF #(.TP(1.5), .ND(1)) BUF_954 (s_837, DRAM_CLK);
INV #(.TP(1.5)) INV_955 (s_838, PWR_RST_n);
XOR2 #(.TP(0)) XOR2_952 (id00220D, s_839, gnd);
OR1 #(.TP(0)) OR1_951 (s_839, s_840);
AND1 #(.TP(3.0)) AND1_950 (s_840, s_841);
BUF #(.TP(1.5)) BUF_949 (s_841, id00219);
TRI #(.TA(2.0), .TEN(4.0)) TRI_995 (.Q(CAS2_n), .A(id00202Q), .EN(vcc));
DFFEARS #(.TCQ(1.0), .TAR(2.0), .TAS(2.0), .TSU(3.0), .THD(2.0)) DFFEARS_991 (.Q(id00202Q), .D(id00202D), .CLK(s_842), .AR(gnd), .AS(s_843), .CE(vcc));
BUF #(.TP(1.5), .ND(1)) BUF_992 (s_842, DRAM_CLK);
AND1 #(.TP(3.0)) AND1_993 (s_843, s_844);
BUF #(.TP(1.5)) BUF_994 (s_844, Com_Ctrl_554);
XOR2 #(.TP(0)) XOR2_990 (id00202D, s_845, gnd);
OR2 #(.TP(0)) OR2_982 (s_845, s_846, s_847);
AND6 #(.TP(3.0)) AND6_983 (s_846, s_848, s_849, s_850, s_851, s_852, s_853);
INV #(.TP(1.5)) INV_984 (s_848, id00214);
INV #(.TP(1.5)) INV_985 (s_849, R_W);
BUF #(.TP(1.5)) BUF_986 (s_850, id00202Q);
INV #(.TP(1.5)) INV_987 (s_851, SIZ1);
BUF #(.TP(1.5)) BUF_988 (s_852, SIZ0);
INV #(.TP(1.5)) INV_989 (s_853, A0);
OR5 #(.TP(0)) OR5_956 (s_847, s_854, s_855, s_856, s_857, s_858);
AND4 #(.TP(3.0)) AND4_957 (s_854, s_859, s_860, s_861, s_862);
AND6 #(.TP(3.0)) AND6_962 (s_855, s_863, s_864, s_865, s_866, s_867, s_868);
AND3 #(.TP(3.0)) AND3_969 (s_856, s_869, s_870, s_871);
AND3 #(.TP(3.0)) AND3_973 (s_857, s_872, s_873, s_874);
AND4 #(.TP(3.0)) AND4_977 (s_858, s_875, s_876, s_877, s_878);
INV #(.TP(1.5)) INV_958 (s_859, id00214);
INV #(.TP(1.5)) INV_959 (s_860, R_W);
BUF #(.TP(1.5)) BUF_960 (s_861, A1);
INV #(.TP(1.5)) INV_961 (s_862, id00101QN);
INV #(.TP(1.5)) INV_963 (s_863, id00214);
INV #(.TP(1.5)) INV_964 (s_864, R_W);
INV #(.TP(1.5)) INV_965 (s_865, SIZ1);
BUF #(.TP(1.5)) BUF_966 (s_866, SIZ0);
INV #(.TP(1.5)) INV_967 (s_867, A0);
INV #(.TP(1.5)) INV_968 (s_868, id00101QN);
INV #(.TP(1.5)) INV_970 (s_869, id00214);
BUF #(.TP(1.5)) BUF_971 (s_870, id00202Q);
INV #(.TP(1.5)) INV_972 (s_871, id00211);
INV #(.TP(1.5)) INV_974 (s_872, id00214);
INV #(.TP(1.5)) INV_975 (s_873, id00101QN);
INV #(.TP(1.5)) INV_976 (s_874, id00211);
INV #(.TP(1.5)) INV_978 (s_875, id00214);
INV #(.TP(1.5)) INV_979 (s_876, R_W);
BUF #(.TP(1.5)) BUF_980 (s_877, id00202Q);
BUF #(.TP(1.5)) BUF_981 (s_878, A1);
TRI #(.TA(2.0), .TEN(4.0)) TRI_1009 (.Q(MUX_SEL), .A(id00199Q), .EN(vcc));
DFFEARS #(.TCQ(1.0), .TAR(2.0), .TAS(2.0), .TSU(3.0), .THD(2.0)) DFFEARS_1005 (.Q(id00199Q), .D(id00199D), .CLK(s_879), .AR(s_880), .AS(gnd), .CE(vcc));
BUF #(.TP(1.5), .ND(1)) BUF_1006 (s_879, DRAM_CLK);
AND1 #(.TP(3.0)) AND1_1007 (s_880, s_881);
INV #(.TP(4.0)) INV_1008 (s_881, FB_8_Com_Ctrl_553);
XOR2 #(.TP(0)) XOR2_1004 (id00199D, s_882, vcc);
OR2 #(.TP(0)) OR2_996 (s_882, s_883, s_884);
AND2 #(.TP(3.0)) AND2_997 (s_883, s_885, s_886);
AND3 #(.TP(3.0)) AND3_1000 (s_884, s_887, s_888, s_889);
INV #(.TP(1.5)) INV_998 (s_885, id00210);
INV #(.TP(1.5)) INV_999 (s_886, id00199Q);
INV #(.TP(1.5)) INV_1001 (s_887, id00210);
BUF #(.TP(1.5)) BUF_1002 (s_888, id00212);
BUF #(.TP(1.5)) BUF_1003 (s_889, id00243);
TRI #(.TA(2.0), .TEN(4.0)) TRI_1025 (.Q(WE_n), .A(id00198Q), .EN(vcc));
DFFEARS #(.TCQ(1.0), .TAR(2.0), .TAS(2.0), .TSU(3.0), .THD(2.0)) DFFEARS_1021 (.Q(id00198Q), .D(id00198D), .CLK(s_890), .AR(gnd), .AS(s_891), .CE(vcc));
BUF #(.TP(1.5), .ND(1)) BUF_1022 (s_890, DRAM_CLK);
AND1 #(.TP(3.0)) AND1_1023 (s_891, s_892);
INV #(.TP(4.0)) INV_1024 (s_892, FB_555);
XOR2 #(.TP(0)) XOR2_1020 (id00198D, s_893, vcc);
OR3 #(.TP(0)) OR3_1010 (s_893, s_894, s_895, s_896);
AND2 #(.TP(3.0)) AND2_1011 (s_894, s_897, s_898);
AND2 #(.TP(3.0)) AND2_1014 (s_895, s_899, s_900);
AND2 #(.TP(3.0)) AND2_1017 (s_896, s_901, s_902);
INV #(.TP(1.5)) INV_1012 (s_897, id00198Q);
INV #(.TP(1.5)) INV_1013 (s_898, id00243);
INV #(.TP(1.5)) INV_1015 (s_899, R_W);
BUF #(.TP(1.5)) BUF_1016 (s_900, id00210);
INV #(.TP(1.5)) INV_1018 (s_901, id00198Q);
INV #(.TP(1.5)) INV_1019 (s_902, id00212);
TRI #(.TA(2.0), .TEN(4.0)) TRI_1038 (.Q(RAS0_n), .A(id00208Q), .EN(vcc));
DFFEARS #(.TCQ(1.0), .TAR(2.0), .TAS(2.0), .TSU(3.0), .THD(2.0)) DFFEARS_1034 (.Q(id00208Q), .D(id00208D), .CLK(s_903), .AR(gnd), .AS(s_904), .CE(vcc));
BUF #(.TP(1.5), .ND(1)) BUF_1035 (s_903, DRAM_CLK);
AND1 #(.TP(3.0)) AND1_1036 (s_904, s_905);
BUF #(.TP(1.5)) BUF_1037 (s_905, Com_Ctrl_554);
XOR2 #(.TP(0)) XOR2_1033 (id00208D, s_906, gnd);
OR2 #(.TP(0)) OR2_1026 (s_906, s_907, s_908);
AND2 #(.TP(3.0)) AND2_1027 (s_907, s_909, s_910);
AND2 #(.TP(3.0)) AND2_1030 (s_908, s_911, s_912);
INV #(.TP(1.5)) INV_1028 (s_909, id00099Q);
INV #(.TP(1.5)) INV_1029 (s_910, id00101QN);
INV #(.TP(1.5)) INV_1031 (s_911, id00099Q);
BUF #(.TP(1.5)) BUF_1032 (s_912, id00208Q);
TRI #(.TA(2.0), .TEN(4.0)) TRI_1073 (.Q(CAS1_n), .A(id00203Q), .EN(vcc));
DFFEARS #(.TCQ(1.0), .TAR(2.0), .TAS(2.0), .TSU(3.0), .THD(2.0)) DFFEARS_1069 (.Q(id00203Q), .D(id00203D), .CLK(s_913), .AR(gnd), .AS(s_914), .CE(vcc));
BUF #(.TP(1.5), .ND(1)) BUF_1070 (s_913, DRAM_CLK);
AND1 #(.TP(3.0)) AND1_1071 (s_914, s_915);
BUF #(.TP(1.5)) BUF_1072 (s_915, Com_Ctrl_554);
XOR2 #(.TP(0)) XOR2_1068 (id00203D, s_916, vcc);
OR3 #(.TP(0)) OR3_1062 (s_916, s_917, s_918, s_919);
AND2 #(.TP(3.0)) AND2_1063 (s_917, s_920, s_921);
AND1 #(.TP(3.0)) AND1_1066 (s_918, s_922);
BUF #(.TP(1.5)) BUF_1064 (s_920, id00211);
BUF #(.TP(1.5)) BUF_1065 (s_921, R_W);
BUF #(.TP(1.5)) BUF_1067 (s_922, id00214);
OR5 #(.TP(0)) OR5_1039 (s_919, s_923, s_924, s_925, s_926, s_927);
AND4 #(.TP(3.0)) AND4_1040 (s_923, s_928, s_929, s_930, s_931);
AND4 #(.TP(3.0)) AND4_1045 (s_924, s_932, s_933, s_934, s_935);
AND2 #(.TP(3.0)) AND2_1050 (s_925, s_936, s_937);
AND4 #(.TP(3.0)) AND4_1053 (s_926, s_938, s_939, s_940, s_941);
AND3 #(.TP(3.0)) AND3_1058 (s_927, s_942, s_943, s_944);
BUF #(.TP(1.5)) BUF_1041 (s_928, id00211);
BUF #(.TP(1.5)) BUF_1042 (s_929, A0);
INV #(.TP(1.5)) INV_1043 (s_930, A1);
INV #(.TP(1.5)) INV_1044 (s_931, SIZ0);
BUF #(.TP(1.5)) BUF_1046 (s_932, id00211);
INV #(.TP(1.5)) INV_1047 (s_933, A1);
INV #(.TP(1.5)) INV_1048 (s_934, SIZ0);
INV #(.TP(1.5)) INV_1049 (s_935, SIZ1);
INV #(.TP(1.5)) INV_1051 (s_936, id00203Q);
BUF #(.TP(1.5)) BUF_1052 (s_937, id00101QN);
BUF #(.TP(1.5)) BUF_1054 (s_938, id00211);
INV #(.TP(1.5)) INV_1055 (s_939, A1);
BUF #(.TP(1.5)) BUF_1056 (s_940, SIZ0);
BUF #(.TP(1.5)) BUF_1057 (s_941, SIZ1);
BUF #(.TP(1.5)) BUF_1059 (s_942, id00211);
INV #(.TP(1.5)) INV_1060 (s_943, A0);
BUF #(.TP(1.5)) BUF_1061 (s_944, A1);
TRI #(.TA(2.0), .TEN(4.0)) TRI_1092 (.Q(CAS3_n), .A(id00201Q), .EN(vcc));
DFFEARS #(.TCQ(1.0), .TAR(2.0), .TAS(2.0), .TSU(3.0), .THD(2.0)) DFFEARS_1088 (.Q(id00201Q), .D(id00201D), .CLK(s_945), .AR(gnd), .AS(s_946), .CE(vcc));
BUF #(.TP(1.5), .ND(1)) BUF_1089 (s_945, DRAM_CLK);
AND1 #(.TP(3.0)) AND1_1090 (s_946, s_947);
BUF #(.TP(1.5)) BUF_1091 (s_947, Com_Ctrl_554);
XOR2 #(.TP(0)) XOR2_1087 (id00201D, s_948, vcc);
OR4 #(.TP(0)) OR4_1074 (s_948, s_949, s_950, s_951, s_952);
AND3 #(.TP(3.0)) AND3_1075 (s_949, s_953, s_954, s_955);
AND1 #(.TP(3.0)) AND1_1079 (s_950, s_956);
AND2 #(.TP(3.0)) AND2_1081 (s_951, s_957, s_958);
AND2 #(.TP(3.0)) AND2_1084 (s_952, s_959, s_960);
BUF #(.TP(1.5)) BUF_1076 (s_953, id00211);
INV #(.TP(1.5)) INV_1077 (s_954, A0);
INV #(.TP(1.5)) INV_1078 (s_955, A1);
BUF #(.TP(1.5)) BUF_1080 (s_956, id00214);
BUF #(.TP(1.5)) BUF_1082 (s_957, id00211);
BUF #(.TP(1.5)) BUF_1083 (s_958, R_W);
INV #(.TP(1.5)) INV_1085 (s_959, id00201Q);
BUF #(.TP(1.5)) BUF_1086 (s_960, id00101QN);
AND2 #(.TP(0)) AND2_1093 (FB_555, s_961, s_962);
BUF #(.TP(0)) BUF_1094 (s_961, PWR_RST_n);
INV #(.TP(0)) INV_1095 (s_962, AS_n);
AND2 #(.TP(0)) AND2_1096 (FB_8_Com_Ctrl_553, s_963, s_964);
INV #(.TP(0)) INV_1097 (s_963, AS_n);
BUF #(.TP(0)) BUF_1098 (s_964, PWR_RST_n);

endmodule
