mattbettcher/m68030-sbc/68030-design/cpld/glue/sim/glue_timed.v

// ATF15xx verilog timing model
// Atmel ATF15xx Fitter Version 1918 created on Sat Oct 17 22:35:24 2026



`timescale 1ns / 1ps

module glue(
      A1,
      A13,
      A14,
      A15,
      A16,
      A17,
      A18,
      A19,
      A2,
      A27,
      A28,
      A29,
      A3,
      A30,
      A31,
      AS_n,
      AVEC_n,
      BERR_n,
      BUS_RD_n,
      BUS_WR_n,
      CIIN_n,
      CLK,
      DRAM_SEL_n,
      DSACK0_n,
      DSACK1_n,
      DS_n,
      DUART_CS_n,
      DUART_INT_n,
      DUART_RST,
      EXP_BUF_EN_n,
      EXP_INT_n,
      EXP_SEL_n,
      FC0,
      FC1,
      FC2,
      FPU_CS_n,
      HALT_LED_n,
      HALT_n,
      IDE_BUF_EN_n,
      IDE_CS0_n,
      IDE_CS1_n,
      IDE_DA0,
      IDE_DA1,
      IDE_DA2,
      IDE_DIOR_n,
      IDE_DIOW_n,
      IDE_INTRQ,
      IDE_IORDY,
      IPL0_n,
      IPL1_n,
      IPL2_n,
      LED_n,
      NIC_INT_n,
      NMI_BTN_n,
      PERIPH_RST_n,
      PWR_RST_n,
      RESET_n,
      ROM_CE_n,
      R_W,
      STATUS_n,
      WARM_RST_BTN_n);

input A1;
input A13;
input A14;
input A15;
input A16;
input A17;
input A18;
input A19;
input A2;
input A27;
input A28;
input A29;
input A3;
input A30;
input A31;
input AS_n;
input CLK;
input DS_n;
input DUART_INT_n;
input EXP_INT_n;
input FC0;
input FC1;
input FC2;
input IDE_INTRQ;
input IDE_IORDY;
input NIC_INT_n;
input NMI_BTN_n;
input PWR_RST_n;
input R_W;
input STATUS_n;
input WARM_RST_BTN_n;
output AVEC_n;
output BERR_n;
output BUS_RD_n;
output BUS_WR_n;
output CIIN_n;
output DRAM_SEL_n;
output DSACK0_n;
output DSACK1_n;
output DUART_CS_n;
output DUART_RST;
output EXP_BUF_EN_n;
output EXP_SEL_n;
output FPU_CS_n;
output HALT_LED_n;
output HALT_n;
output IDE_BUF_EN_n;
output IDE_CS0_n;
output IDE_CS1_n;
output IDE_DA0;
output IDE_DA1;
output IDE_DA2;
output IDE_DIOR_n;
output IDE_DIOW_n;
output IPL0_n;
output IPL1_n;
output IPL2_n;
output LED_n;
output PERIPH_RST_n;
inout RESET_n;
output ROM_CE_n;
supply0 gnd;
supply1 vcc;


wire
     id00069Q, id00352, id00352D, id00338, id00338D, id00351, id00351D, id00131QN, DSACK0_n_combQ, id00009QN, AVEC_n_combQ, id00148Q, Com_Ctrl_765, id00107Q, id00335, id00335D, id00332, id00332D, id00020Q, id00331, id00331D, id00355, id00355D, id00350, id00350D, id00356, id00356D, id00336, id00336D, id00334, id00334D, id00354, id00354D, id00353, id00353D, id00098Q, id00339, id00339D, id00303, id00303D, id00301, id00301D, id00340, id00340D, id00341, id00341D, id00342, id00342D, id00343, id00343D, id00304, id00304D, id00349, id00349D, id00195QN, id00214Q, id00038QN, id00059Q, id00320, id00320D, id00328, id00328D, id00306, id00306D, id00308, id00308D, id00319, id00319D, id00327, id00327D, id00317, id00317D, id00091QN, id00146QN, id00300, id00300D, id00299, id00299D, id00158QN, id00298, id00298D, id00310, id00310D, id00345, id00345D, id00307, id00307D, id00344, id00344D, id00100Q, id00003, id00003D, id00296, id00296D, id00305, id00305D, id00323, id00323D, id00324, id00324D, id00348Q, id00348D, id00325, id00325D, id00302, id00302D, id00347Q, id00347D, id00326, id00326D, id00346Q, id00346D, HALT_n_combQ, id00313, id00313D, BERR_n_combQ, Com_Ctrl_766, id00314, id00314D, id00337, id00337D, id00297, id00297D, id00315, id00315D, id00312, id00312D, id00311, id00311D, id00309, id00309D, id00108Q, id00321, id00321D, id00329, id00329D, id00333, id00333D, id00322, id00322D, id00330, id00330D, id00316, id00316D, id00318, id00318D, DSACK1_n_combQ, s_0, s_1, s_2, s_3, s_4, s_5, s_6, s_7, s_8, s_9, s_10, s_11, s_12, s_13, s_14, s_15, s_16, s_17, s_18, s_19, s_20, s_21, s_22, s_23, s_24, s_25, s_26, s_27, s_28, s_29, s_30, s_31, s_32, s_33, s_34, s_35, s_36, s_37, s_38, s_39, s_40, s_41, s_42, s_43, s_44, s_45, s_46, s_47, s_48, s_49, s_50, s_51, s_52, s_53, s_54, s_55, s_56, s_57, s_58, s_59, s_60, s_61, s_62, s_63, s_64, s_65, s_66, s_67, s_68, s_69, s_70, s_71, s_72, s_73, s_74, s_75, s_76, s_77, s_78, s_79, s_80, s_81, s_82, s_83, s_84, s_85, s_86, s_87, s_88, s_89, s_90, s_91, s_92, s_93, s_94, s_95, s_96, s_97, s_98, s_99, s_100, s_101, s_102, s_103, s_104, s_105, s_106, s_107, s_108, s_109, s_110, s_111, s_112, s_113, s_114, s_115, s_116, s_117, s_118, s_119, s_120, s_121, s_122, s_123, s_124, s_125, s_126, s_127, s_128, s_129, s_130, s_131, s_132, s_133, s_134, s_135, s_136, s_137, s_138, s_139, s_140, s_141, s_142, s_143, s_144, s_145, s_146, s_147, s_148, s_149, s_150, s_151, s_152, s_153, s_154, s_155, s_156, s_157, s_158, s_159, s_160, s_161, s_162, s_163, s_164, s_165, s_166, s_167, s_168, s_169, s_170, s_171, s_172, s_173, s_174, s_175, s_176, s_177, s_178, s_179, s_180, s_181, s_182, s_183, s_184, s_185, s_186, s_187, s_188, s_189, s_190, s_191, s_192, s_193, s_194, s_195, s_196, s_197, s_198, s_199, s_200, s_201, s_202, s_203, s_204, s_205, s_206, s_207, s_208, s_209, s_210, s_211, s_212, s_213, s_214, s_215, s_216, s_217, s_218, s_219, s_220, s_221, s_222, s_223, s_224, s_225, s_226, s_227, s_228, s_229, s_230, s_231, s_232, s_233, s_234, s_235, s_236, s_237, s_238, s_239, s_240, s_241, s_242, s_243, s_244, s_245, s_246, s_247, s_248, s_249, s_250, s_251, s_252, s_253, s_254, s_255, s_256, s_257, s_258, s_259, s_260, s_261, s_262, s_263, s_264, s_265, s_266, s_267, s_268, s_269, s_270, s_271, s_272, s_273, s_274, s_275, s_276, s_277, s_278, s_279, s_280, s_281, s_282, s_283, s_284, s_285, s_286, s_287, s_288, s_289, s_290, s_291, s_292, s_293, s_294, s_295, s_296, s_297, s_298, s_299, s_300, s_301, s_302, s_303, s_304, s_305, s_306, s_307, s_308, s_309, s_310, s_311, s_312, s_313, s_314, s_315, s_316, s_317, s_318, s_319, s_320, s_321, s_322, s_323, s_324, s_325, s_326, s_327, s_328, s_329, s_330, s_331, s_332, s_333, s_334, s_335, s_336, s_337, s_338, s_339, s_340, s_341, s_342, s_343, s_344, s_345, s_346, s_347, s_348, s_349, s_350, s_351, s_352, s_353, s_354, s_355, s_356, s_357, s_358, s_359, s_360, s_361, s_362, s_363, s_364, s_365, s_366, s_367, s_368, s_369, s_370, s_371, s_372, s_373, s_374, s_375, s_376, s_377, s_378, s_379, s_380, s_381, s_382, s_383, s_384, s_385, s_386, s_387, s_388, s_389, s_390, s_391, s_392, s_393, s_394, s_395, s_396, s_397, s_398, s_399, s_400, s_401, s_402, s_403, s_404, s_405, s_406, s_407, s_408, s_409, s_410, s_411, s_412, s_413, s_414, s_415, s_416, s_417, s_418, s_419, s_420, s_421, s_422, s_423, s_424, s_425, s_426, s_427, s_428, s_429, s_430, s_431, s_432, s_433, s_434, s_435, s_436, s_437, s_438, s_439, s_440, s_441, s_442, s_443, s_444, s_445, s_446, s_447, s_448, s_449, s_450, s_451, s_452, s_453, s_454, s_455, s_456, s_457, s_458, s_459, s_460, s_461, s_462, s_463, s_464, s_465, s_466, s_467, s_468, s_469, s_470, s_471, s_472, s_473, s_474, s_475, s_476, s_477, s_478, s_479, s_480, s_481, s_482, s_483, s_484, s_485, s_486, s_487, s_488, s_489, s_490, s_491, s_492, s_493, s_494, s_495, s_496, s_497, s_498, s_499, s_500, s_501, s_502, s_503, s_504, s_505, s_506, s_507, s_508, s_509, s_510, s_511, s_512, s_513, s_514, s_515, s_516, s_517, s_518, s_519, s_520, s_521, s_522, s_523, s_524, s_525, s_526, s_527, s_528, s_529, s_530, s_531, s_532, s_533, s_534, s_535, s_536, s_537, s_538, s_539, s_540, s_541, s_542, s_543, s_544, s_545, s_546, s_547, s_548, s_549, s_550, s_551, s_552, s_553, s_554, s_555, s_556, s_557, s_558, s_559, s_560, s_561, s_562, s_563, s_564, s_565, s_566, s_567, s_568, s_569, s_570, s_571, s_572, s_573, s_574, s_575, s_576, s_577, s_578, s_579, s_580, s_581, s_582, s_583, s_584, s_585, s_586, s_587, s_588, s_589, s_590, s_591, s_592, s_593, s_594, s_595, s_596, s_597, s_598, s_599, s_600, s_601, s_602, s_603, s_604, s_605, s_606, s_607, s_608, s_609, s_610, s_611, s_612, s_613, s_614, s_615, s_616, s_617, s_618, s_619, s_620, s_621, s_622, s_623, s_624, s_625, s_626, s_627, s_628, s_629, s_630, s_631, s_632, s_633, s_634, s_635, s_636, s_637, s_638, s_639, s_640, s_641, s_642, s_643, s_644, s_645, s_646, s_647, s_648, s_649, s_650, s_651, s_652, s_653, s_654, s_655, s_656, s_657, s_658, s_659, s_660, s_661, s_662, s_663, s_664, s_665, s_666, s_667, s_668, s_669, s_670, s_671, s_672, s_673, s_674, s_675, s_676, s_677, s_678, s_679, s_680, s_681, s_682, s_683, s_684, s_685, s_686, s_687, s_688, s_689, s_690, s_691, s_692, s_693, s_694, s_695, s_696, s_697, s_698, s_699, s_700, s_701, s_702, s_703, s_704, s_705, s_706, s_707, s_708, s_709, s_710, s_711, s_712, s_713, s_714, s_715, s_716, s_717, s_718, s_719, s_720, s_721, s_722, s_723, s_724, s_725, s_726, s_727, s_728, s_729, s_730, s_731, s_732, s_733, s_734, s_735, s_736, s_737, s_738, s_739, s_740, s_741, s_742, s_743, s_744, s_745, s_746, s_747, s_748, s_749, s_750, s_751, s_752, s_753, s_754, s_755, s_756, s_757, s_758, s_759, s_760, s_761, s_762, s_763, s_764, s_765, s_766, s_767, s_768, s_769, s_770, s_771, s_772, s_773, s_774, s_775, s_776, s_777, s_778, s_779, s_780, s_781, s_782, s_783, s_784, s_785, s_786, s_787, s_788, s_789, s_790, s_791, s_792, s_793, s_794, s_795, s_796, s_797, s_798, s_799, s_800, s_801, s_802, s_803, s_804, s_805, s_806, s_807, s_808, s_809, s_810, s_811, s_812, s_813, s_814, s_815, s_816, s_817, s_818, s_819, s_820, s_821, s_822, s_823, s_824, s_825, s_826, s_827, s_828, s_829, s_830, s_831, s_832, s_833, s_834, s_835, s_836, s_837, s_838, s_839, s_840, s_841, s_842, s_843, s_844, s_845, s_846, s_847, s_848, s_849, s_850, s_851, s_852, s_853, s_854, s_855, s_856, s_857, s_858, s_859, s_860, s_861, s_862, s_863, s_864, s_865, s_866, s_867, s_868, s_869, s_870, s_871, s_872, s_873, s_874, s_875, s_876, s_877, s_878, s_879, s_880, s_881, s_882, s_883, s_884, s_885, s_886, s_887, s_888, s_889, s_890, s_891, s_892, s_893, s_894, s_895, s_896, s_897, s_898, s_899, s_900, s_901, s_902, s_903, s_904, s_905, s_906, s_907, s_908, s_909, s_910, s_911, s_912, s_913, s_914, s_915, s_916, s_917, s_918, s_919, s_920, s_921, s_922, s_923, s_924, s_925, s_926, s_927, s_928, s_929, s_930, s_931, s_932, s_933, s_934, s_935, s_936, s_937, s_938, s_939, s_940, s_941, s_942, s_943, s_944, s_945, s_946, s_947, s_948, s_949, s_950, s_951, s_952, s_953, s_954, s_955, s_956, s_957, s_958, s_959, s_960, s_961, s_962, s_963, s_964, s_965, s_966, s_967, s_968, s_969, s_970, s_971, s_972, s_973, s_974, s_975, s_976, s_977, s_978, s_979, s_980, s_981, s_982, s_983, s_984, s_985, s_986, s_987, s_988, s_989, s_990, s_991, s_992, s_993, s_994, s_995, s_996, s_997, s_998, s_999, s_1000, s_1001, s_1002, s_1003, s_1004, s_1005, s_1006, s_1007, s_1008, s_1009, s_1010, s_1011, s_1012, s_1013, s_1014, s_1015, s_1016, s_1017, s_1018, s_1019, s_1020, s_1021, s_1022, s_1023, s_1024, s_1025, s_1026, s_1027, s_1028, s_1029, s_1030, s_1031, s_1032, s_1033, s_1034, s_1035, s_1036, s_1037, s_1038, s_1039, s_1040, s_1041, s_1042, s_1043, s_1044, s_1045, s_1046, s_1047, s_1048, s_1049, s_1050, s_1051, s_1052, s_1053, s_1054, s_1055, s_1056, s_1057, s_1058, s_1059, s_1060, s_1061, s_1062, s_1063, s_1064, s_1065, s_1066, s_1067, s_1068, s_1069, s_1070, s_1071, s_1072, s_1073, s_1074, s_1075, s_1076, s_1077, s_1078, s_1079, s_1080, s_1081, s_1082, s_1083, s_1084, s_1085, s_1086, s_1087, s_1088, s_1089, s_1090, s_1091, s_1092, s_1093, s_1094, s_1095, s_1096, s_1097, s_1098, s_1099, s_1100, s_1101, s_1102, s_1103, s_1104, s_1105, s_1106, s_1107, s_1108, s_1109, s_1110, s_1111, s_1112, s_1113, s_1114, s_1115, s_1116, s_1117, s_1118, s_1119, s_1120, s_1121, s_1122, s_1123, s_1124, s_1125, s_1126, s_1127, s_1128, s_1129, s_1130, s_1131, s_1132, s_1133, s_1134, s_1135, s_1136, s_1137, s_1138, s_1139, s_1140, s_1141, s_1142, s_1143, s_1144, s_1145, s_1146, s_1147, s_1148, s_1149, s_1150, s_1151, s_1152, s_1153, s_1154, s_1155, s_1156, s_1157, s_1158, s_1159, s_1160, s_1161, s_1162, s_1163, s_1164, s_1165, s_1166, s_1167, s_1168, s_1169, s_1170, s_1171, s_1172, s_1173, s_1174, s_1175, s_1176, s_1177, s_1178, s_1179, s_1180, s_1181, s_1182, s_1183, s_1184, s_1185, s_1186, s_1187, s_1188, s_1189, s_1190, s_1191, s_1192, s_1193, s_1194, s_1195, s_1196, s_1197, s_1198, s_1199, s_1200, s_1201, s_1202, s_1203, s_1204, s_1205, s_1206, s_1207, s_1208, s_1209, s_1210, s_1211, s_1212, s_1213, s_1214, s_1215, s_1216, s_1217, s_1218, s_1219, s_1220, s_1221, s_1222, s_1223, s_1224, s_1225, s_1226, s_1227, s_1228, s_1229, s_1230, s_1231, s_1232, s_1233, s_1234, s_1235, s_1236, s_1237, s_1238, s_1239, s_1240, s_1241, s_1242, s_1243, s_1244, s_1245, s_1246, s_1247, s_1248, s_1249, s_1250, s_1251, s_1252, s_1253, s_1254, s_1255, s_1256, s_1257, s_1258, s_1259, s_1260, s_1261, s_1262, s_1263, s_1264, s_1265, s_1266, s_1267, s_1268, s_1269, s_1270, s_1271, s_1272, s_1273, s_1274, s_1275, s_1276, s_1277, s_1278, s_1279, s_1280, s_1281, s_1282, s_1283, s_1284, s_1285, s_1286, s_1287, s_1288, s_1289, s_1290, s_1291, s_1292, s_1293, s_1294, s_1295, s_1296, s_1297, s_1298, s_1299, s_1300, s_1301, s_1302, s_1303, s_1304, s_1305, s_1306, s_1307, s_1308, s_1309, s_1310, s_1311, s_1312, s_1313, s_1314, s_1315, s_1316, s_1317, s_1318, s_1319, s_1320, s_1321, s_1322, s_1323, s_1324, s_1325, s_1326, s_1327, s_1328, s_1329, s_1330, s_1331, s_1332, s_1333, s_1334, s_1335, s_1336, s_1337, s_1338, s_1339, s_1340, s_1341, s_1342, s_1343, s_1344, s_1345, s_1346, s_1347, s_1348, s_1349, s_1350, s_1351, s_1352, s_1353, s_1354, s_1355, s_1356, s_1357, s_1358, s_1359, s_1360, s_1361, s_1362, s_1363, s_1364, s_1365, s_1366, s_1367, s_1368, s_1369, s_1370, s_1371, s_1372, s_1373, s_1374, s_1375, s_1376, s_1377, s_1378, s_1379, s_1380, s_1381, s_1382, s_1383, s_1384, s_1385, s_1386, s_1387, s_1388, s_1389, s_1390, s_1391, s_1392, s_1393, s_1394, s_1395, s_1396, s_1397, s_1398, s_1399, s_1400, s_1401, s_1402, s_1403, s_1404, s_1405, s_1406, s_1407, s_1408, s_1409, s_1410, s_1411, s_1412, s_1413, s_1414, s_1415, s_1416, s_1417, s_1418, s_1419, s_1420, s_1421, s_1422, s_1423, s_1424, s_1425, s_1426, s_1427, s_1428, s_1429, s_1430, s_1431, s_1432, s_1433, s_1434, s_1435, s_1436, s_1437, s_1438, s_1439, s_1440, s_1441, s_1442, s_1443, s_1444, s_1445, s_1446, s_1447, s_1448, s_1449, s_1450, s_1451, s_1452, s_1453, s_1454, s_1455, s_1456, s_1457, s_1458, s_1459, s_1460, s_1461, s_1462, s_1463, s_1464, s_1465, s_1466, s_1467, s_1468, s_1469, s_1470, s_1471, s_1472, s_1473, s_1474, s_1475, s_1476, s_1477, s_1478, s_1479, s_1480, s_1481, s_1482, s_1483, s_1484, s_1485, s_1486, s_1487, s_1488, s_1489, s_1490, s_1491, s_1492, s_1493, s_1494, s_1495, s_1496, s_1497, s_1498, s_1499, s_1500, s_1501, s_1502, s_1503, s_1504, s_1505, s_1506, s_1507, s_1508, s_1509, s_1510, s_1511, s_1512, s_1513, s_1514, s_1515, s_1516, s_1517, s_1518, s_1519, s_1520, s_1521, s_1522, s_1523, s_1524, s_1525, s_1526, s_1527, s_1528, s_1529, s_1530, s_1531, s_1532, s_1533, s_1534, s_1535, s_1536, s_1537, s_1538, s_1539, s_1540, s_1541, s_1542, s_1543, s_1544, s_1545, s_1546, s_1547, s_1548, s_1549, s_1550, s_1551, s_1552, s_1553, s_1554, s_1555, s_1556, s_1557, s_1558, s_1559, s_1560, s_1561, s_1562, s_1563, s_1564, s_1565, s_1566, s_1567, s_1568, s_1569, s_1570, s_1571, s_1572, s_1573, s_1574, s_1575, s_1576, s_1577, s_1578, s_1579, s_1580, s_1581, s_1582, s_1583, s_1584, s_1585, s_1586, s_1587, s_1588, s_1589, s_1590, s_1591, s_1592, s_1593, s_1594, s_1595, s_1596, s_1597, s_1598, s_1599, s_1600, s_1601, s_1602, s_1603, s_1604, s_1605, s_1606, s_1607, s_1608, s_1609, s_1610, s_1611, s_1612, s_1613, s_1614, s_1615, s_1616, s_1617, s_1618, s_1619, s_1620, s_1621, s_1622, s_1623, s_1624, s_1625, s_1626, s_1627, s_1628, s_1629, s_1630, s_1631, s_1632, s_1633, s_1634, s_1635, s_1636, s_1637, s_1638, s_1639, s_1640, s_1641, s_1642, s_1643, s_1644, s_1645, s_1646, s_1647, s_1648, s_1649, s_1650, s_1651, s_1652, s_1653, s_1654, s_1655, s_1656, s_1657, s_1658, s_1659, s_1660, s_1661, s_1662, s_1663, s_1664, s_1665, s_1666, s_1667, s_1668, s_1669, s_1670, s_1671, s_1672, s_1673, s_1674, s_1675, s_1676, s_1677, s_1678, s_1679, s_1680, s_1681, s_1682, s_1683, s_1684, s_1685, s_1686, s_1687, s_1688, s_1689, s_1690, s_1691, s_1692, s_1693, s_1694, s_1695, s_1696, s_1697, s_1698, s_1699, s_1700, s_1701, s_1702, s_1703, s_1704, s_1705, s_1706, s_1707, s_1708, s_1709, s_1710, s_1711, s_1712, s_1713, s_1714, s_1715, s_1716, s_1717, s_1718, s_1719, s_1720, s_1721, s_1722, s_1723, s_1724, s_1725, s_1726, s_1727, s_1728, s_1729, s_1730, s_1731, s_1732, s_1733, s_1734, s_1735, s_1736, s_1737, s_1738, s_1739, s_1740, s_1741, s_1742, s_1743, s_1744, s_1745, s_1746, s_1747, s_1748, s_1749, s_1750, s_1751, s_1752, s_1753, s_1754, s_1755, s_1756, s_1757, s_1758, s_1759, s_1760, s_1761, s_1762, s_1763, s_1764;

BUF BUF_1937 (DSACK0_n, DSACK0_n_combQ);
BUF BUF_1938 (AVEC_n, AVEC_n_combQ);
BUF BUF_1939 (HALT_n, HALT_n_combQ);
BUF BUF_1940 (BERR_n, BERR_n_combQ);
BUF BUF_1941 (DSACK1_n, DSACK1_n_combQ);
TRI #(.TA(2.0), .TEN(4.0)) TRI_27 (.Q(EXP_SEL_n), .A(s_0), .EN(vcc));
BUF #(.TP(1.0)) BUF_26 (s_0, s_1);
XOR2 #(.TP(0)) XOR2_25 (s_1, s_2, vcc);
OR3 #(.TP(0)) OR3_0 (s_2, s_3, s_4, s_5);
AND7 #(.TP(3.0)) AND7_1 (s_3, s_6, s_7, s_8, s_9, s_10, s_11, s_12);
AND7 #(.TP(3.0)) AND7_9 (s_4, s_13, s_14, s_15, s_16, s_17, s_18, s_19);
AND7 #(.TP(3.0)) AND7_17 (s_5, s_20, s_21, s_22, s_23, s_24, s_25, s_26);
BUF #(.TP(1.5)) BUF_2 (s_6, A27);
BUF #(.TP(1.5)) BUF_3 (s_7, A28);
BUF #(.TP(1.5)) BUF_4 (s_8, A29);
BUF #(.TP(1.5)) BUF_5 (s_9, A30);
BUF #(.TP(1.5)) BUF_6 (s_10, A31);
INV #(.TP(1.5)) INV_7 (s_11, AS_n);
INV #(.TP(1.5)) INV_8 (s_12, FC2);
BUF #(.TP(1.5)) BUF_10 (s_13, A27);
BUF #(.TP(1.5)) BUF_11 (s_14, A28);
BUF #(.TP(1.5)) BUF_12 (s_15, A29);
BUF #(.TP(1.5)) BUF_13 (s_16, A30);
BUF #(.TP(1.5)) BUF_14 (s_17, A31);
INV #(.TP(1.5)) INV_15 (s_18, AS_n);
INV #(.TP(1.5)) INV_16 (s_19, FC0);
BUF #(.TP(1.5)) BUF_18 (s_20, A27);
BUF #(.TP(1.5)) BUF_19 (s_21, A28);
BUF #(.TP(1.5)) BUF_20 (s_22, A29);
BUF #(.TP(1.5)) BUF_21 (s_23, A30);
BUF #(.TP(1.5)) BUF_22 (s_24, A31);
INV #(.TP(1.5)) INV_23 (s_25, AS_n);
INV #(.TP(1.5)) INV_24 (s_26, FC1);
BUF #(.TP(1.0)) BUF_38 (id00069Q, s_27);
XOR2 #(.TP(0)) XOR2_37 (s_27, s_28, gnd);
OR1 #(.TP(0)) OR1_36 (s_28, s_29);
AND7 #(.TP(3.0)) AND7_35 (s_29, s_30, s_31, s_32, s_33, s_34, s_35, s_36);
BUF #(.TP(1.5)) BUF_28 (s_30, A18);
BUF #(.TP(1.5)) BUF_29 (s_31, A19);
BUF #(.TP(1.5)) BUF_30 (s_32, FC0);
BUF #(.TP(1.5)) BUF_31 (s_33, FC2);
BUF #(.TP(1.5)) BUF_32 (s_34, FC1);
BUF #(.TP(1.5)) BUF_33 (s_35, A16);
BUF #(.TP(1.5)) BUF_34 (s_36, A17);
DFFEARS #(.TCQ(1.0), .TAR(2.0), .TAS(2.0), .TSU(3.0), .THD(2.0)) DFFEARS_133 (.Q(id00352), .D(id00352D), .CLK(s_37), .AR(s_38), .AS(gnd), .CE(vcc));
BUF #(.TP(1.5), .ND(1)) BUF_134 (s_37, CLK);
AND1 #(.TP(3.0)) AND1_135 (s_38, s_39);
INV #(.TP(1.5)) INV_136 (s_39, Com_Ctrl_765);
XOR2 #(.TP(0)) XOR2_132 (id00352D, s_40, gnd);
OR5 #(.TP(0)) OR5_109 (s_40, s_41, s_42, s_43, s_44, s_45);
AND6 #(.TP(3.0)) AND6_110 (s_41, s_46, s_47, s_48, s_49, s_50, s_51);
AND1 #(.TP(3.0)) AND1_117 (s_42, s_52);
AND7 #(.TP(3.0)) AND7_119 (s_43, s_53, s_54, s_55, s_56, s_57, s_58, s_59);
AND4 #(.TP(3.0)) AND4_127 (s_44, s_60, s_61, s_62, s_63);
INV #(.TP(1.5)) INV_111 (s_46, id00009QN);
BUF #(.TP(1.5)) BUF_112 (s_47, id00146QN);
INV #(.TP(1.5)) INV_113 (s_48, id00069Q);
INV #(.TP(1.5)) INV_114 (s_49, id00131QN);
INV #(.TP(1.5)) INV_115 (s_50, id00148Q);
INV #(.TP(1.5)) INV_116 (s_51, FC1);
BUF #(.TP(1.5)) BUF_118 (s_52, id00352);
BUF #(.TP(1.5)) BUF_120 (s_53, id00339);
BUF #(.TP(1.5)) BUF_121 (s_54, id00340);
BUF #(.TP(1.5)) BUF_122 (s_55, id00341);
BUF #(.TP(1.5)) BUF_123 (s_56, id00342);
BUF #(.TP(1.5)) BUF_124 (s_57, id00343);
BUF #(.TP(1.5)) BUF_125 (s_58, id00344);
BUF #(.TP(1.5)) BUF_126 (s_59, id00345);
BUF #(.TP(1.5)) BUF_128 (s_60, A18);
INV #(.TP(1.5)) INV_129 (s_61, A27);
BUF #(.TP(1.5)) BUF_130 (s_62, id00009QN);
BUF #(.TP(1.5)) BUF_131 (s_63, id00146QN);
OR6 #(.TP(0)) OR6_39 (s_45, s_64, s_65, s_66, s_67, s_68, s_69);
AND4 #(.TP(3.0)) AND4_40 (s_64, s_70, s_71, s_72, s_73);
AND6 #(.TP(3.0)) AND6_45 (s_65, s_74, s_75, s_76, s_77, s_78, s_79);
AND6 #(.TP(3.0)) AND6_52 (s_66, s_80, s_81, s_82, s_83, s_84, s_85);
AND6 #(.TP(3.0)) AND6_59 (s_67, s_86, s_87, s_88, s_89, s_90, s_91);
AND6 #(.TP(3.0)) AND6_66 (s_68, s_92, s_93, s_94, s_95, s_96, s_97);
INV #(.TP(1.5)) INV_41 (s_70, A27);
BUF #(.TP(1.5)) BUF_42 (s_71, id00009QN);
BUF #(.TP(1.5)) BUF_43 (s_72, id00146QN);
BUF #(.TP(1.5)) BUF_44 (s_73, A19);
INV #(.TP(1.5)) INV_46 (s_74, id00009QN);
BUF #(.TP(1.5)) BUF_47 (s_75, id00146QN);
INV #(.TP(1.5)) INV_48 (s_76, A17);
INV #(.TP(1.5)) INV_49 (s_77, id00069Q);
INV #(.TP(1.5)) INV_50 (s_78, id00131QN);
INV #(.TP(1.5)) INV_51 (s_79, id00148Q);
BUF #(.TP(1.5)) BUF_53 (s_80, A18);
INV #(.TP(1.5)) INV_54 (s_81, id00009QN);
BUF #(.TP(1.5)) BUF_55 (s_82, id00146QN);
INV #(.TP(1.5)) INV_56 (s_83, id00069Q);
INV #(.TP(1.5)) INV_57 (s_84, id00131QN);
INV #(.TP(1.5)) INV_58 (s_85, id00148Q);
INV #(.TP(1.5)) INV_60 (s_86, id00009QN);
BUF #(.TP(1.5)) BUF_61 (s_87, id00146QN);
BUF #(.TP(1.5)) BUF_62 (s_88, A19);
INV #(.TP(1.5)) INV_63 (s_89, id00069Q);
INV #(.TP(1.5)) INV_64 (s_90, id00131QN);
INV #(.TP(1.5)) INV_65 (s_91, id00148Q);
INV #(.TP(1.5)) INV_67 (s_92, id00009QN);
BUF #(.TP(1.5)) BUF_68 (s_93, id00146QN);
INV #(.TP(1.5)) INV_69 (s_94, id00069Q);
INV #(.TP(1.5)) INV_70 (s_95, id00131QN);
INV #(.TP(1.5)) INV_71 (s_96, id00148Q);
BUF #(.TP(1.5)) BUF_72 (s_97, A16);
OR5 #(.TP(0)) OR5_73 (s_69, s_98, s_99, s_100, s_101, s_102);
AND6 #(.TP(3.0)) AND6_74 (s_98, s_103, s_104, s_105, s_106, s_107, s_108);
AND6 #(.TP(3.0)) AND6_81 (s_99, s_109, s_110, s_111, s_112, s_113, s_114);
AND6 #(.TP(3.0)) AND6_88 (s_100, s_115, s_116, s_117, s_118, s_119, s_120);
AND6 #(.TP(3.0)) AND6_95 (s_101, s_121, s_122, s_123, s_124, s_125, s_126);
AND6 #(.TP(3.0)) AND6_102 (s_102, s_127, s_128, s_129, s_130, s_131, s_132);
INV #(.TP(1.5)) INV_75 (s_103, id00009QN);
BUF #(.TP(1.5)) BUF_76 (s_104, id00146QN);
INV #(.TP(1.5)) INV_77 (s_105, id00069Q);
INV #(.TP(1.5)) INV_78 (s_106, id00131QN);
INV #(.TP(1.5)) INV_79 (s_107, id00148Q);
INV #(.TP(1.5)) INV_80 (s_108, A13);
INV #(.TP(1.5)) INV_82 (s_109, id00009QN);
BUF #(.TP(1.5)) BUF_83 (s_110, id00146QN);
INV #(.TP(1.5)) INV_84 (s_111, id00069Q);
INV #(.TP(1.5)) INV_85 (s_112, id00131QN);
INV #(.TP(1.5)) INV_86 (s_113, id00148Q);
BUF #(.TP(1.5)) BUF_87 (s_114, A14);
INV #(.TP(1.5)) INV_89 (s_115, id00009QN);
BUF #(.TP(1.5)) BUF_90 (s_116, id00146QN);
INV #(.TP(1.5)) INV_91 (s_117, id00069Q);
INV #(.TP(1.5)) INV_92 (s_118, id00131QN);
INV #(.TP(1.5)) INV_93 (s_119, id00148Q);
BUF #(.TP(1.5)) BUF_94 (s_120, A15);
INV #(.TP(1.5)) INV_96 (s_121, id00009QN);
BUF #(.TP(1.5)) BUF_97 (s_122, id00146QN);
INV #(.TP(1.5)) INV_98 (s_123, id00069Q);
INV #(.TP(1.5)) INV_99 (s_124, id00131QN);
INV #(.TP(1.5)) INV_100 (s_125, id00148Q);
INV #(.TP(1.5)) INV_101 (s_126, FC0);
INV #(.TP(1.5)) INV_103 (s_127, id00009QN);
BUF #(.TP(1.5)) BUF_104 (s_128, id00146QN);
INV #(.TP(1.5)) INV_105 (s_129, id00069Q);
INV #(.TP(1.5)) INV_106 (s_130, id00131QN);
INV #(.TP(1.5)) INV_107 (s_131, id00148Q);
INV #(.TP(1.5)) INV_108 (s_132, FC2);
DFFEARS #(.TCQ(1.0), .TAR(2.0), .TAS(2.0), .TSU(3.0), .THD(2.0)) DFFEARS_141 (.Q(id00338), .D(id00338D), .CLK(s_133), .AR(s_134), .AS(gnd), .CE(vcc));
BUF #(.TP(1.5), .ND(1)) BUF_142 (s_133, CLK);
AND1 #(.TP(3.0)) AND1_143 (s_134, s_135);
INV #(.TP(1.5)) INV_144 (s_135, Com_Ctrl_765);
XOR2 #(.TP(0)) XOR2_140 (id00338D, s_136, gnd);
OR1 #(.TP(0)) OR1_139 (s_136, s_137);
AND1 #(.TP(3.0)) AND1_138 (s_137, s_138);
INV #(.TP(1.5)) INV_137 (s_138, AS_n);
DFFEARS #(.TCQ(1.0), .TAR(2.0), .TAS(2.0), .TSU(3.0), .THD(2.0)) DFFEARS_152 (.Q(id00351), .D(id00351D), .CLK(s_139), .AR(s_140), .AS(gnd), .CE(vcc));
BUF #(.TP(1.5), .ND(1)) BUF_153 (s_139, CLK);
AND1 #(.TP(3.0)) AND1_154 (s_140, s_141);
INV #(.TP(1.5)) INV_155 (s_141, Com_Ctrl_765);
XOR2 #(.TP(0)) XOR2_151 (id00351D, s_142, gnd);
OR2 #(.TP(0)) OR2_145 (s_142, s_143, s_144);
AND2 #(.TP(3.0)) AND2_146 (s_143, s_145, s_146);
AND1 #(.TP(3.0)) AND1_149 (s_144, s_147);
BUF #(.TP(1.5)) BUF_147 (s_145, id00069Q);
BUF #(.TP(1.5)) BUF_148 (s_146, id00146QN);
BUF #(.TP(1.5)) BUF_150 (s_147, id00351);
BUF #(.TP(1.0)) BUF_176 (id00131QN, s_148);
XOR2 #(.TP(0)) XOR2_175 (s_148, s_149, gnd);
OR3 #(.TP(0)) OR3_156 (s_149, s_150, s_151, s_152);
AND5 #(.TP(3.0)) AND5_157 (s_150, s_153, s_154, s_155, s_156, s_157);
AND5 #(.TP(3.0)) AND5_163 (s_151, s_158, s_159, s_160, s_161, s_162);
AND5 #(.TP(3.0)) AND5_169 (s_152, s_163, s_164, s_165, s_166, s_167);
INV #(.TP(1.5)) INV_158 (s_153, A28);
BUF #(.TP(1.5)) BUF_159 (s_154, A29);
BUF #(.TP(1.5)) BUF_160 (s_155, A30);
BUF #(.TP(1.5)) BUF_161 (s_156, A31);
INV #(.TP(1.5)) INV_162 (s_157, FC2);
INV #(.TP(1.5)) INV_164 (s_158, A28);
BUF #(.TP(1.5)) BUF_165 (s_159, A29);
BUF #(.TP(1.5)) BUF_166 (s_160, A30);
BUF #(.TP(1.5)) BUF_167 (s_161, A31);
INV #(.TP(1.5)) INV_168 (s_162, FC0);
INV #(.TP(1.5)) INV_170 (s_163, A28);
BUF #(.TP(1.5)) BUF_171 (s_164, A29);
BUF #(.TP(1.5)) BUF_172 (s_165, A30);
BUF #(.TP(1.5)) BUF_173 (s_166, A31);
INV #(.TP(1.5)) INV_174 (s_167, FC1);
TRI #(.TA(2.0), .TEN(4.0)) TRI_183 (.Q(DSACK0_n_combQ), .A(s_168), .EN(s_169));
AND1 #(.TP(3.0)) AND1_184 (s_169, s_170);
BUF #(.TP(1.5)) BUF_185 (s_170, id00349);
BUF #(.TP(1.0)) BUF_182 (s_168, s_171);
XOR2 #(.TP(0)) XOR2_181 (s_171, s_172, vcc);
OR1 #(.TP(0)) OR1_180 (s_172, s_173);
AND2 #(.TP(3.0)) AND2_179 (s_173, s_174, s_175);
INV #(.TP(1.5)) INV_177 (s_174, AS_n);
BUF #(.TP(1.5)) BUF_178 (s_175, id00349);
BUF #(.TP(1.0)) BUF_206 (id00009QN, s_176);
XOR2 #(.TP(0)) XOR2_205 (s_176, s_177, gnd);
OR3 #(.TP(0)) OR3_186 (s_177, s_178, s_179, s_180);
AND5 #(.TP(3.0)) AND5_187 (s_178, s_181, s_182, s_183, s_184, s_185);
AND5 #(.TP(3.0)) AND5_193 (s_179, s_186, s_187, s_188, s_189, s_190);
AND5 #(.TP(3.0)) AND5_199 (s_180, s_191, s_192, s_193, s_194, s_195);
BUF #(.TP(1.5)) BUF_188 (s_181, A28);
BUF #(.TP(1.5)) BUF_189 (s_182, A29);
BUF #(.TP(1.5)) BUF_190 (s_183, A30);
BUF #(.TP(1.5)) BUF_191 (s_184, A31);
INV #(.TP(1.5)) INV_192 (s_185, FC2);
BUF #(.TP(1.5)) BUF_194 (s_186, A28);
BUF #(.TP(1.5)) BUF_195 (s_187, A29);
BUF #(.TP(1.5)) BUF_196 (s_188, A30);
BUF #(.TP(1.5)) BUF_197 (s_189, A31);
INV #(.TP(1.5)) INV_198 (s_190, FC0);
BUF #(.TP(1.5)) BUF_200 (s_191, A28);
BUF #(.TP(1.5)) BUF_201 (s_192, A29);
BUF #(.TP(1.5)) BUF_202 (s_193, A30);
BUF #(.TP(1.5)) BUF_203 (s_194, A31);
INV #(.TP(1.5)) INV_204 (s_195, FC1);
TRI #(.TA(2.0), .TEN(4.0)) TRI_213 (.Q(AVEC_n_combQ), .A(s_196), .EN(s_197));
AND1 #(.TP(3.0)) AND1_214 (s_197, s_198);
BUF #(.TP(1.5)) BUF_215 (s_198, id00351);
BUF #(.TP(1.0)) BUF_212 (s_196, s_199);
XOR2 #(.TP(0)) XOR2_211 (s_199, s_200, vcc);
OR1 #(.TP(0)) OR1_210 (s_200, s_201);
AND2 #(.TP(3.0)) AND2_209 (s_201, s_202, s_203);
INV #(.TP(1.5)) INV_207 (s_202, AS_n);
BUF #(.TP(1.5)) BUF_208 (s_203, id00351);
TRI #(.TA(2.0), .TEN(4.0)) TRI_223 (.Q(DRAM_SEL_n), .A(s_204), .EN(vcc));
BUF #(.TP(1.0)) BUF_222 (s_204, s_205);
XOR2 #(.TP(0)) XOR2_221 (s_205, s_206, vcc);
OR1 #(.TP(0)) OR1_220 (s_206, s_207);
AND3 #(.TP(3.0)) AND3_219 (s_207, s_208, s_209, s_210);
INV #(.TP(1.5)) INV_216 (s_208, AS_n);
INV #(.TP(1.5)) INV_217 (s_209, id00301);
BUF #(.TP(1.5)) BUF_218 (s_210, id00148Q);
BUF #(.TP(1.0)) BUF_247 (id00148Q, s_211);
XOR2 #(.TP(0)) XOR2_246 (s_211, s_212, gnd);
OR3 #(.TP(0)) OR3_224 (s_212, s_213, s_214, s_215);
AND6 #(.TP(3.0)) AND6_225 (s_213, s_216, s_217, s_218, s_219, s_220, s_221);
AND6 #(.TP(3.0)) AND6_232 (s_214, s_222, s_223, s_224, s_225, s_226, s_227);
AND6 #(.TP(3.0)) AND6_239 (s_215, s_228, s_229, s_230, s_231, s_232, s_233);
INV #(.TP(1.5)) INV_226 (s_216, A30);
INV #(.TP(1.5)) INV_227 (s_217, A29);
INV #(.TP(1.5)) INV_228 (s_218, A28);
INV #(.TP(1.5)) INV_229 (s_219, A27);
INV #(.TP(1.5)) INV_230 (s_220, A31);
INV #(.TP(1.5)) INV_231 (s_221, FC0);
INV #(.TP(1.5)) INV_233 (s_222, A30);
INV #(.TP(1.5)) INV_234 (s_223, A29);
INV #(.TP(1.5)) INV_235 (s_224, A28);
INV #(.TP(1.5)) INV_236 (s_225, A27);
INV #(.TP(1.5)) INV_237 (s_226, A31);
INV #(.TP(1.5)) INV_238 (s_227, FC2);
INV #(.TP(1.5)) INV_240 (s_228, A30);
INV #(.TP(1.5)) INV_241 (s_229, A29);
INV #(.TP(1.5)) INV_242 (s_230, A28);
INV #(.TP(1.5)) INV_243 (s_231, A27);
INV #(.TP(1.5)) INV_244 (s_232, A31);
INV #(.TP(1.5)) INV_245 (s_233, FC1);
TRI #(.TA(2.0), .TEN(4.0)) TRI_253 (.Q(IPL1_n), .A(s_234), .EN(vcc));
BUF #(.TP(1.0)) BUF_252 (s_234, s_235);
XOR2 #(.TP(0)) XOR2_251 (s_235, s_236, gnd);
OR1 #(.TP(0)) OR1_250 (s_236, s_237);
AND1 #(.TP(3.0)) AND1_249 (s_237, s_238);
INV #(.TP(1.5)) INV_248 (s_238, id00296);
BUF #(.TP(1.0)) BUF_259 (Com_Ctrl_765, s_239);
XOR2 #(.TP(0)) XOR2_258 (s_239, s_240, gnd);
OR1 #(.TP(0)) OR1_257 (s_240, s_241);
AND2 #(.TP(3.0)) AND2_256 (s_241, s_242, s_243);
INV #(.TP(1.5)) INV_254 (s_242, AS_n);
BUF #(.TP(1.5)) BUF_255 (s_243, PWR_RST_n);
BUF #(.TP(1.0)) BUF_270 (id00107Q, s_244);
XOR2 #(.TP(0)) XOR2_269 (s_244, s_245, gnd);
OR1 #(.TP(0)) OR1_268 (s_245, s_246);
AND7 #(.TP(3.0)) AND7_267 (s_246, s_247, s_248, s_249, s_250, s_251, s_252, s_253);
INV #(.TP(1.5)) INV_260 (s_247, A27);
BUF #(.TP(1.5)) BUF_261 (s_248, id00009QN);
INV #(.TP(1.5)) INV_262 (s_249, A18);
INV #(.TP(1.5)) INV_263 (s_250, A19);
BUF #(.TP(1.5)) BUF_264 (s_251, A16);
BUF #(.TP(1.5)) BUF_265 (s_252, A17);
INV #(.TP(1.5)) INV_266 (s_253, R_W);
TRI #(.TA(2.0), .TEN(4.0)) TRI_277 (.Q(IDE_DIOR_n), .A(s_254), .EN(vcc));
BUF #(.TP(1.0)) BUF_276 (s_254, s_255);
XOR2 #(.TP(0)) XOR2_275 (s_255, s_256, vcc);
OR1 #(.TP(0)) OR1_274 (s_256, s_257);
AND2 #(.TP(3.0)) AND2_273 (s_257, s_258, s_259);
INV #(.TP(1.5)) INV_271 (s_258, AS_n);
BUF #(.TP(1.5)) BUF_272 (s_259, id00356);
DFFEARS #(.TCQ(1.0), .TAR(2.0), .TAS(2.0), .TSU(3.0), .THD(2.0)) DFFEARS_282 (.Q(id00335), .D(id00335D), .CLK(s_260), .AR(gnd), .AS(s_261), .CE(vcc));
BUF #(.TP(1.5), .ND(1)) BUF_283 (s_260, CLK);
INV #(.TP(1.5)) INV_284 (s_261, PWR_RST_n);
XOR2 #(.TP(0)) XOR2_281 (id00335D, s_262, gnd);
OR1 #(.TP(0)) OR1_280 (s_262, s_263);
AND1 #(.TP(3.0)) AND1_279 (s_263, s_264);
BUF #(.TP(1.5)) BUF_278 (s_264, AS_n);
TRI #(.TA(2.0), .TEN(4.0)) TRI_312 (.Q(EXP_BUF_EN_n), .A(s_265), .EN(vcc));
BUF #(.TP(1.0)) BUF_311 (s_265, s_266);
XOR2 #(.TP(0)) XOR2_310 (s_266, s_267, vcc);
OR3 #(.TP(0)) OR3_285 (s_267, s_268, s_269, s_270);
AND7 #(.TP(3.0)) AND7_286 (s_268, s_271, s_272, s_273, s_274, s_275, s_276, s_277);
AND7 #(.TP(3.0)) AND7_294 (s_269, s_278, s_279, s_280, s_281, s_282, s_283, s_284);
AND7 #(.TP(3.0)) AND7_302 (s_270, s_285, s_286, s_287, s_288, s_289, s_290, s_291);
BUF #(.TP(1.5)) BUF_287 (s_271, A27);
BUF #(.TP(1.5)) BUF_288 (s_272, A28);
BUF #(.TP(1.5)) BUF_289 (s_273, A29);
BUF #(.TP(1.5)) BUF_290 (s_274, A30);
BUF #(.TP(1.5)) BUF_291 (s_275, A31);
INV #(.TP(1.5)) INV_292 (s_276, AS_n);
INV #(.TP(1.5)) INV_293 (s_277, FC2);
BUF #(.TP(1.5)) BUF_295 (s_278, A27);
BUF #(.TP(1.5)) BUF_296 (s_279, A28);
BUF #(.TP(1.5)) BUF_297 (s_280, A29);
BUF #(.TP(1.5)) BUF_298 (s_281, A30);
BUF #(.TP(1.5)) BUF_299 (s_282, A31);
INV #(.TP(1.5)) INV_300 (s_283, AS_n);
INV #(.TP(1.5)) INV_301 (s_284, FC0);
BUF #(.TP(1.5)) BUF_303 (s_285, A27);
BUF #(.TP(1.5)) BUF_304 (s_286, A28);
BUF #(.TP(1.5)) BUF_305 (s_287, A29);
BUF #(.TP(1.5)) BUF_306 (s_288, A30);
BUF #(.TP(1.5)) BUF_307 (s_289, A31);
INV #(.TP(1.5)) INV_308 (s_290, AS_n);
INV #(.TP(1.5)) INV_309 (s_291, FC1);
DFFEARS #(.TCQ(1.0), .TAR(2.0), .TAS(2.0), .TSU(3.0), .THD(2.0)) DFFEARS_317 (.Q(id00332), .D(id00332D), .CLK(s_292), .AR(s_293), .AS(gnd), .CE(vcc));
BUF #(.TP(1.5), .ND(1)) BUF_318 (s_292, CLK);
AND1 #(.TP(3.0)) AND1_319 (s_293, s_294);
INV #(.TP(1.5)) INV_320 (s_294, Com_Ctrl_765);
XOR2 #(.TP(0)) XOR2_316 (id00332D, s_295, gnd);
OR1 #(.TP(0)) OR1_315 (s_295, s_296);
AND1 #(.TP(3.0)) AND1_314 (s_296, s_297);
BUF #(.TP(1.5)) BUF_313 (s_297, id00338);
BUF #(.TP(1.0)) BUF_343 (id00020Q, s_298);
XOR2 #(.TP(0)) XOR2_342 (s_298, s_299, gnd);
OR2 #(.TP(0)) OR2_321 (s_299, s_300, s_301);
AND9 #(.TP(3.0)) AND9_322 (s_300, s_302, s_303, s_304, s_305, s_306, s_307, s_308, s_309, s_310);
AND9 #(.TP(3.0)) AND9_332 (s_301, s_311, s_312, s_313, s_314, s_315, s_316, s_317, s_318, s_319);
INV #(.TP(1.5)) INV_323 (s_302, A16);
BUF #(.TP(1.5)) BUF_324 (s_303, A17);
INV #(.TP(1.5)) INV_325 (s_304, A18);
INV #(.TP(1.5)) INV_326 (s_305, A19);
INV #(.TP(1.5)) INV_327 (s_306, A27);
INV #(.TP(1.5)) INV_328 (s_307, AS_n);
BUF #(.TP(1.5)) BUF_329 (s_308, id00338);
INV #(.TP(1.5)) INV_330 (s_309, id00332);
BUF #(.TP(1.5)) BUF_331 (s_310, id00009QN);
BUF #(.TP(1.5)) BUF_333 (s_311, A16);
INV #(.TP(1.5)) INV_334 (s_312, A17);
INV #(.TP(1.5)) INV_335 (s_313, A18);
INV #(.TP(1.5)) INV_336 (s_314, A19);
INV #(.TP(1.5)) INV_337 (s_315, A27);
INV #(.TP(1.5)) INV_338 (s_316, AS_n);
BUF #(.TP(1.5)) BUF_339 (s_317, id00338);
INV #(.TP(1.5)) INV_340 (s_318, id00332);
BUF #(.TP(1.5)) BUF_341 (s_319, id00009QN);
DFFEARS #(.TCQ(1.0), .TAR(2.0), .TAS(2.0), .TSU(3.0), .THD(2.0)) DFFEARS_362 (.Q(id00331), .D(id00331D), .CLK(s_320), .AR(s_321), .AS(gnd), .CE(vcc));
BUF #(.TP(1.5), .ND(1)) BUF_363 (s_320, CLK);
AND1 #(.TP(3.0)) AND1_364 (s_321, s_322);
INV #(.TP(1.5)) INV_365 (s_322, Com_Ctrl_765);
XOR2 #(.TP(0)) XOR2_361 (id00331D, s_323, gnd);
OR2 #(.TP(0)) OR2_344 (s_323, s_324, s_325);
AND7 #(.TP(3.0)) AND7_345 (s_324, s_326, s_327, s_328, s_329, s_330, s_331, s_332);
AND7 #(.TP(3.0)) AND7_353 (s_325, s_333, s_334, s_335, s_336, s_337, s_338, s_339);
BUF #(.TP(1.5)) BUF_346 (s_326, id00338);
BUF #(.TP(1.5)) BUF_347 (s_327, id00009QN);
INV #(.TP(1.5)) INV_348 (s_328, A18);
INV #(.TP(1.5)) INV_349 (s_329, A19);
BUF #(.TP(1.5)) BUF_350 (s_330, A16);
INV #(.TP(1.5)) INV_351 (s_331, A17);
INV #(.TP(1.5)) INV_352 (s_332, A27);
BUF #(.TP(1.5)) BUF_354 (s_333, id00338);
BUF #(.TP(1.5)) BUF_355 (s_334, id00009QN);
INV #(.TP(1.5)) INV_356 (s_335, A18);
INV #(.TP(1.5)) INV_357 (s_336, A19);
INV #(.TP(1.5)) INV_358 (s_337, A16);
BUF #(.TP(1.5)) BUF_359 (s_338, A17);
INV #(.TP(1.5)) INV_360 (s_339, A27);
DFFEARS #(.TCQ(1.0), .TAR(2.0), .TAS(2.0), .TSU(3.0), .THD(2.0)) DFFEARS_390 (.Q(id00355), .D(id00355D), .CLK(s_340), .AR(s_341), .AS(gnd), .CE(vcc));
BUF #(.TP(1.5), .ND(1)) BUF_391 (s_340, CLK);
AND1 #(.TP(3.0)) AND1_392 (s_341, s_342);
INV #(.TP(1.5)) INV_393 (s_342, Com_Ctrl_765);
XOR2 #(.TP(0)) XOR2_389 (id00355D, s_343, gnd);
OR2 #(.TP(0)) OR2_366 (s_343, s_344, s_345);
AND10 #(.TP(3.0)) AND10_367 (s_344, s_346, s_347, s_348, s_349, s_350, s_351, s_352, s_353, s_354, s_355);
AND10 #(.TP(3.0)) AND10_378 (s_345, s_356, s_357, s_358, s_359, s_360, s_361, s_362, s_363, s_364, s_365);
BUF #(.TP(1.5)) BUF_368 (s_346, id00158QN);
INV #(.TP(1.5)) INV_369 (s_347, id00350);
BUF #(.TP(1.5)) BUF_370 (s_348, id00009QN);
INV #(.TP(1.5)) INV_371 (s_349, A18);
INV #(.TP(1.5)) INV_372 (s_350, A19);
BUF #(.TP(1.5)) BUF_373 (s_351, A16);
INV #(.TP(1.5)) INV_374 (s_352, A17);
INV #(.TP(1.5)) INV_375 (s_353, A27);
INV #(.TP(1.5)) INV_376 (s_354, id00091QN);
INV #(.TP(1.5)) INV_377 (s_355, R_W);
BUF #(.TP(1.5)) BUF_379 (s_356, id00158QN);
INV #(.TP(1.5)) INV_380 (s_357, id00350);
BUF #(.TP(1.5)) BUF_381 (s_358, id00009QN);
INV #(.TP(1.5)) INV_382 (s_359, A18);
INV #(.TP(1.5)) INV_383 (s_360, A19);
INV #(.TP(1.5)) INV_384 (s_361, A16);
BUF #(.TP(1.5)) BUF_385 (s_362, A17);
INV #(.TP(1.5)) INV_386 (s_363, A27);
INV #(.TP(1.5)) INV_387 (s_364, id00091QN);
INV #(.TP(1.5)) INV_388 (s_365, R_W);
DFFEARS #(.TCQ(1.0), .TAR(2.0), .TAS(2.0), .TSU(3.0), .THD(2.0)) DFFEARS_414 (.Q(id00350), .D(id00350D), .CLK(s_366), .AR(s_367), .AS(gnd), .CE(vcc));
BUF #(.TP(1.5), .ND(1)) BUF_415 (s_366, CLK);
AND1 #(.TP(3.0)) AND1_416 (s_367, s_368);
INV #(.TP(1.5)) INV_417 (s_368, Com_Ctrl_765);
XOR2 #(.TP(0)) XOR2_413 (id00350D, s_369, gnd);
OR3 #(.TP(0)) OR3_394 (s_369, s_370, s_371, s_372);
AND7 #(.TP(3.0)) AND7_395 (s_370, s_373, s_374, s_375, s_376, s_377, s_378, s_379);
AND7 #(.TP(3.0)) AND7_403 (s_371, s_380, s_381, s_382, s_383, s_384, s_385, s_386);
AND1 #(.TP(3.0)) AND1_411 (s_372, s_387);
BUF #(.TP(1.5)) BUF_396 (s_373, id00009QN);
INV #(.TP(1.5)) INV_397 (s_374, A18);
INV #(.TP(1.5)) INV_398 (s_375, A19);
INV #(.TP(1.5)) INV_399 (s_376, A16);
BUF #(.TP(1.5)) BUF_400 (s_377, A17);
INV #(.TP(1.5)) INV_401 (s_378, A27);
INV #(.TP(1.5)) INV_402 (s_379, id00158QN);
BUF #(.TP(1.5)) BUF_404 (s_380, id00009QN);
INV #(.TP(1.5)) INV_405 (s_381, A18);
INV #(.TP(1.5)) INV_406 (s_382, A19);
BUF #(.TP(1.5)) BUF_407 (s_383, A16);
INV #(.TP(1.5)) INV_408 (s_384, A17);
INV #(.TP(1.5)) INV_409 (s_385, A27);
INV #(.TP(1.5)) INV_410 (s_386, id00158QN);
BUF #(.TP(1.5)) BUF_412 (s_387, id00350);
DFFEARS #(.TCQ(1.0), .TAR(2.0), .TAS(2.0), .TSU(3.0), .THD(2.0)) DFFEARS_440 (.Q(id00356), .D(id00356D), .CLK(s_388), .AR(s_389), .AS(gnd), .CE(vcc));
BUF #(.TP(1.5), .ND(1)) BUF_441 (s_388, CLK);
AND1 #(.TP(3.0)) AND1_442 (s_389, s_390);
INV #(.TP(1.5)) INV_443 (s_390, Com_Ctrl_765);
XOR2 #(.TP(0)) XOR2_439 (id00356D, s_391, gnd);
OR3 #(.TP(0)) OR3_418 (s_391, s_392, s_393, s_394);
AND8 #(.TP(3.0)) AND8_419 (s_392, s_395, s_396, s_397, s_398, s_399, s_400, s_401, s_402);
AND8 #(.TP(3.0)) AND8_428 (s_393, s_403, s_404, s_405, s_406, s_407, s_408, s_409, s_410);
AND1 #(.TP(3.0)) AND1_437 (s_394, s_411);
BUF #(.TP(1.5)) BUF_420 (s_395, R_W);
BUF #(.TP(1.5)) BUF_421 (s_396, id00009QN);
INV #(.TP(1.5)) INV_422 (s_397, A18);
INV #(.TP(1.5)) INV_423 (s_398, A19);
INV #(.TP(1.5)) INV_424 (s_399, A16);
BUF #(.TP(1.5)) BUF_425 (s_400, A17);
INV #(.TP(1.5)) INV_426 (s_401, A27);
INV #(.TP(1.5)) INV_427 (s_402, id00091QN);
BUF #(.TP(1.5)) BUF_429 (s_403, R_W);
BUF #(.TP(1.5)) BUF_430 (s_404, id00009QN);
INV #(.TP(1.5)) INV_431 (s_405, A18);
INV #(.TP(1.5)) INV_432 (s_406, A19);
BUF #(.TP(1.5)) BUF_433 (s_407, A16);
INV #(.TP(1.5)) INV_434 (s_408, A17);
INV #(.TP(1.5)) INV_435 (s_409, A27);
INV #(.TP(1.5)) INV_436 (s_410, id00091QN);
BUF #(.TP(1.5)) BUF_438 (s_411, id00356);
DFFEARS #(.TCQ(1.0), .TAR(2.0), .TAS(2.0), .TSU(3.0), .THD(2.0)) DFFEARS_468 (.Q(id00336), .D(id00336D), .CLK(s_412), .AR(s_413), .AS(gnd), .CE(vcc));
BUF #(.TP(1.5), .ND(1)) BUF_469 (s_412, CLK);
INV #(.TP(1.5)) INV_470 (s_413, PWR_RST_n);
XOR2 #(.TP(0)) XOR2_467 (id00336D, s_414, gnd);
OR4 #(.TP(0)) OR4_444 (s_414, s_415, s_416, s_417, s_418);
AND9 #(.TP(3.0)) AND9_445 (s_415, s_419, s_420, s_421, s_422, s_423, s_424, s_425, s_426, s_427);
AND3 #(.TP(3.0)) AND3_455 (s_416, s_428, s_429, s_430);
AND3 #(.TP(3.0)) AND3_459 (s_417, s_431, s_432, s_433);
AND3 #(.TP(3.0)) AND3_463 (s_418, s_434, s_435, s_436);
BUF #(.TP(1.5)) BUF_446 (s_419, id00338);
INV #(.TP(1.5)) INV_447 (s_420, AS_n);
INV #(.TP(1.5)) INV_448 (s_421, id00332);
INV #(.TP(1.5)) INV_449 (s_422, A18);
INV #(.TP(1.5)) INV_450 (s_423, A19);
INV #(.TP(1.5)) INV_451 (s_424, A16);
INV #(.TP(1.5)) INV_452 (s_425, A27);
BUF #(.TP(1.5)) BUF_453 (s_426, id00009QN);
BUF #(.TP(1.5)) BUF_454 (s_427, A17);
BUF #(.TP(1.5)) BUF_456 (s_428, id00336);
INV #(.TP(1.5)) INV_457 (s_429, id00335);
BUF #(.TP(1.5)) BUF_458 (s_430, id00332);
BUF #(.TP(1.5)) BUF_460 (s_431, id00336);
INV #(.TP(1.5)) INV_461 (s_432, id00335);
BUF #(.TP(1.5)) BUF_462 (s_433, AS_n);
BUF #(.TP(1.5)) BUF_464 (s_434, id00336);
INV #(.TP(1.5)) INV_465 (s_435, id00335);
INV #(.TP(1.5)) INV_466 (s_436, id00338);
TRI #(.TA(2.0), .TEN(4.0)) TRI_476 (.Q(PERIPH_RST_n), .A(s_437), .EN(vcc));
BUF #(.TP(1.0)) BUF_475 (s_437, s_438);
XOR2 #(.TP(0)) XOR2_474 (s_438, s_439, gnd);
OR1 #(.TP(0)) OR1_473 (s_439, s_440);
AND1 #(.TP(3.0)) AND1_472 (s_440, s_441);
BUF #(.TP(1.5)) BUF_471 (s_441, RESET_n);
DFFEARS #(.TCQ(1.0), .TAR(2.0), .TAS(2.0), .TSU(3.0), .THD(2.0)) DFFEARS_501 (.Q(id00334), .D(id00334D), .CLK(s_442), .AR(s_443), .AS(gnd), .CE(vcc));
BUF #(.TP(1.5), .ND(1)) BUF_502 (s_442, CLK);
INV #(.TP(1.5)) INV_503 (s_443, PWR_RST_n);
XOR2 #(.TP(0)) XOR2_500 (id00334D, s_444, gnd);
OR4 #(.TP(0)) OR4_477 (s_444, s_445, s_446, s_447, s_448);
AND9 #(.TP(3.0)) AND9_478 (s_445, s_449, s_450, s_451, s_452, s_453, s_454, s_455, s_456, s_457);
AND3 #(.TP(3.0)) AND3_488 (s_446, s_458, s_459, s_460);
AND3 #(.TP(3.0)) AND3_492 (s_447, s_461, s_462, s_463);
AND3 #(.TP(3.0)) AND3_496 (s_448, s_464, s_465, s_466);
BUF #(.TP(1.5)) BUF_479 (s_449, id00338);
INV #(.TP(1.5)) INV_480 (s_450, AS_n);
INV #(.TP(1.5)) INV_481 (s_451, id00332);
BUF #(.TP(1.5)) BUF_482 (s_452, id00009QN);
INV #(.TP(1.5)) INV_483 (s_453, A18);
INV #(.TP(1.5)) INV_484 (s_454, A19);
BUF #(.TP(1.5)) BUF_485 (s_455, A16);
INV #(.TP(1.5)) INV_486 (s_456, A17);
INV #(.TP(1.5)) INV_487 (s_457, A27);
BUF #(.TP(1.5)) BUF_489 (s_458, id00334);
INV #(.TP(1.5)) INV_490 (s_459, id00335);
BUF #(.TP(1.5)) BUF_491 (s_460, id00332);
BUF #(.TP(1.5)) BUF_493 (s_461, id00334);
INV #(.TP(1.5)) INV_494 (s_462, id00335);
BUF #(.TP(1.5)) BUF_495 (s_463, AS_n);
BUF #(.TP(1.5)) BUF_497 (s_464, id00334);
INV #(.TP(1.5)) INV_498 (s_465, id00335);
INV #(.TP(1.5)) INV_499 (s_466, id00338);
DFFEARS #(.TCQ(1.0), .TAR(2.0), .TAS(2.0), .TSU(3.0), .THD(2.0)) DFFEARS_528 (.Q(id00354), .D(id00354D), .CLK(s_467), .AR(s_468), .AS(gnd), .CE(vcc));
BUF #(.TP(1.5), .ND(1)) BUF_529 (s_467, CLK);
AND1 #(.TP(3.0)) AND1_530 (s_468, s_469);
INV #(.TP(1.5)) INV_531 (s_469, Com_Ctrl_765);
XOR2 #(.TP(0)) XOR2_527 (id00354D, s_470, gnd);
OR4 #(.TP(0)) OR4_504 (s_470, s_471, s_472, s_473, s_474);
AND1 #(.TP(3.0)) AND1_505 (s_471, s_475);
AND4 #(.TP(3.0)) AND4_507 (s_472, s_476, s_477, s_478, s_479);
AND5 #(.TP(3.0)) AND5_512 (s_473, s_480, s_481, s_482, s_483, s_484);
AND8 #(.TP(3.0)) AND8_518 (s_474, s_485, s_486, s_487, s_488, s_489, s_490, s_491, s_492);
BUF #(.TP(1.5)) BUF_506 (s_475, id00354);
INV #(.TP(1.5)) INV_508 (s_476, R_W);
BUF #(.TP(1.5)) BUF_509 (s_477, id00338);
BUF #(.TP(1.5)) BUF_510 (s_478, id00305);
BUF #(.TP(1.5)) BUF_511 (s_479, id00131QN);
INV #(.TP(1.5)) INV_513 (s_480, R_W);
BUF #(.TP(1.5)) BUF_514 (s_481, id00338);
BUF #(.TP(1.5)) BUF_515 (s_482, id00305);
BUF #(.TP(1.5)) BUF_516 (s_483, id00301);
BUF #(.TP(1.5)) BUF_517 (s_484, id00148Q);
INV #(.TP(1.5)) INV_519 (s_485, R_W);
BUF #(.TP(1.5)) BUF_520 (s_486, id00338);
INV #(.TP(1.5)) INV_521 (s_487, A16);
INV #(.TP(1.5)) INV_522 (s_488, A17);
INV #(.TP(1.5)) INV_523 (s_489, A18);
INV #(.TP(1.5)) INV_524 (s_490, A19);
INV #(.TP(1.5)) INV_525 (s_491, A27);
BUF #(.TP(1.5)) BUF_526 (s_492, id00009QN);
DFFEARS #(.TCQ(1.0), .TAR(2.0), .TAS(2.0), .TSU(3.0), .THD(2.0)) DFFEARS_554 (.Q(id00353), .D(id00353D), .CLK(s_493), .AR(s_494), .AS(gnd), .CE(vcc));
BUF #(.TP(1.5), .ND(1)) BUF_555 (s_493, CLK);
AND1 #(.TP(3.0)) AND1_556 (s_494, s_495);
INV #(.TP(1.5)) INV_557 (s_495, Com_Ctrl_765);
XOR2 #(.TP(0)) XOR2_553 (id00353D, s_496, gnd);
OR4 #(.TP(0)) OR4_532 (s_496, s_497, s_498, s_499, s_500);
AND3 #(.TP(3.0)) AND3_533 (s_497, s_501, s_502, s_503);
AND4 #(.TP(3.0)) AND4_537 (s_498, s_504, s_505, s_506, s_507);
AND8 #(.TP(3.0)) AND8_542 (s_499, s_508, s_509, s_510, s_511, s_512, s_513, s_514, s_515);
AND1 #(.TP(3.0)) AND1_551 (s_500, s_516);
BUF #(.TP(1.5)) BUF_534 (s_501, id00338);
BUF #(.TP(1.5)) BUF_535 (s_502, R_W);
BUF #(.TP(1.5)) BUF_536 (s_503, id00131QN);
BUF #(.TP(1.5)) BUF_538 (s_504, id00338);
BUF #(.TP(1.5)) BUF_539 (s_505, R_W);
BUF #(.TP(1.5)) BUF_540 (s_506, id00148Q);
BUF #(.TP(1.5)) BUF_541 (s_507, id00301);
BUF #(.TP(1.5)) BUF_543 (s_508, id00338);
BUF #(.TP(1.5)) BUF_544 (s_509, R_W);
INV #(.TP(1.5)) INV_545 (s_510, A27);
BUF #(.TP(1.5)) BUF_546 (s_511, id00009QN);
INV #(.TP(1.5)) INV_547 (s_512, A17);
INV #(.TP(1.5)) INV_548 (s_513, A18);
INV #(.TP(1.5)) INV_549 (s_514, A19);
INV #(.TP(1.5)) INV_550 (s_515, A16);
BUF #(.TP(1.5)) BUF_552 (s_516, id00353);
BUF #(.TP(1.0)) BUF_570 (id00098Q, s_517);
XOR2 #(.TP(0)) XOR2_569 (s_517, s_518, gnd);
OR1 #(.TP(0)) OR1_568 (s_518, s_519);
AND9 #(.TP(3.0)) AND9_567 (s_519, s_520, s_521, s_522, s_523, s_524, s_525, s_526, s_527, s_528);
INV #(.TP(1.5)) INV_558 (s_520, AS_n);
BUF #(.TP(1.5)) BUF_559 (s_521, id00338);
INV #(.TP(1.5)) INV_560 (s_522, id00345);
INV #(.TP(1.5)) INV_561 (s_523, id00344);
INV #(.TP(1.5)) INV_562 (s_524, id00339);
INV #(.TP(1.5)) INV_563 (s_525, id00340);
INV #(.TP(1.5)) INV_564 (s_526, id00341);
INV #(.TP(1.5)) INV_565 (s_527, id00342);
INV #(.TP(1.5)) INV_566 (s_528, id00343);
DFFEARS #(.TCQ(1.0), .TAR(2.0), .TAS(2.0), .TSU(3.0), .THD(2.0)) DFFEARS_584 (.Q(id00339), .D(id00339D), .CLK(s_529), .AR(s_530), .AS(gnd), .CE(vcc));
BUF #(.TP(1.5), .ND(1)) BUF_585 (s_529, CLK);
AND1 #(.TP(3.0)) AND1_586 (s_530, s_531);
INV #(.TP(1.5)) INV_587 (s_531, Com_Ctrl_765);
XOR2 #(.TP(0)) XOR2_583 (id00339D, s_532, gnd);
OR2 #(.TP(0)) OR2_571 (s_532, s_533, s_534);
AND2 #(.TP(3.0)) AND2_572 (s_533, s_535, s_536);
AND7 #(.TP(3.0)) AND7_575 (s_534, s_537, s_538, s_539, s_540, s_541, s_542, s_543);
BUF #(.TP(1.5)) BUF_573 (s_535, id00338);
INV #(.TP(1.5)) INV_574 (s_536, id00339);
BUF #(.TP(1.5)) BUF_576 (s_537, id00338);
BUF #(.TP(1.5)) BUF_577 (s_538, id00343);
BUF #(.TP(1.5)) BUF_578 (s_539, id00341);
BUF #(.TP(1.5)) BUF_579 (s_540, id00340);
BUF #(.TP(1.5)) BUF_580 (s_541, id00342);
BUF #(.TP(1.5)) BUF_581 (s_542, id00344);
BUF #(.TP(1.5)) BUF_582 (s_543, id00345);
DFFEARS #(.TCQ(1.0), .TAR(2.0), .TAS(2.0), .TSU(3.0), .THD(2.0)) DFFEARS_617 (.Q(id00303), .D(id00303D), .CLK(s_544), .AR(s_545), .AS(gnd), .CE(vcc));
BUF #(.TP(1.5), .ND(1)) BUF_618 (s_544, CLK);
INV #(.TP(1.5)) INV_619 (s_545, PWR_RST_n);
XOR2 #(.TP(0)) XOR2_616 (id00303D, s_546, gnd);
OR2 #(.TP(0)) OR2_611 (s_546, s_547, s_548);
AND3 #(.TP(3.0)) AND3_612 (s_547, s_549, s_550, s_551);
INV #(.TP(1.5)) INV_613 (s_549, id00306);
BUF #(.TP(1.5)) BUF_614 (s_550, id00303);
INV #(.TP(1.5)) INV_615 (s_551, A2);
OR5 #(.TP(0)) OR5_588 (s_548, s_552, s_553, s_554, s_555, s_556);
AND3 #(.TP(3.0)) AND3_589 (s_552, s_557, s_558, s_559);
AND3 #(.TP(3.0)) AND3_593 (s_553, s_560, s_561, s_562);
AND4 #(.TP(3.0)) AND4_597 (s_554, s_563, s_564, s_565, s_566);
AND4 #(.TP(3.0)) AND4_602 (s_555, s_567, s_568, s_569, s_570);
AND3 #(.TP(3.0)) AND3_607 (s_556, s_571, s_572, s_573);
INV #(.TP(1.5)) INV_590 (s_557, id00306);
BUF #(.TP(1.5)) BUF_591 (s_558, id00303);
BUF #(.TP(1.5)) BUF_592 (s_559, A1);
INV #(.TP(1.5)) INV_594 (s_560, id00306);
BUF #(.TP(1.5)) BUF_595 (s_561, id00302);
BUF #(.TP(1.5)) BUF_596 (s_562, id00038QN);
INV #(.TP(1.5)) INV_598 (s_563, id00306);
BUF #(.TP(1.5)) BUF_599 (s_564, id00303);
INV #(.TP(1.5)) INV_600 (s_565, A3);
INV #(.TP(1.5)) INV_601 (s_566, id00107Q);
INV #(.TP(1.5)) INV_603 (s_567, id00306);
BUF #(.TP(1.5)) BUF_604 (s_568, id00303);
BUF #(.TP(1.5)) BUF_605 (s_569, A3);
INV #(.TP(1.5)) INV_606 (s_570, id00069Q);
INV #(.TP(1.5)) INV_608 (s_571, id00306);
BUF #(.TP(1.5)) BUF_609 (s_572, id00303);
INV #(.TP(1.5)) INV_610 (s_573, id00098Q);
DFFEARS #(.TCQ(1.0), .TAR(2.0), .TAS(2.0), .TSU(3.0), .THD(2.0)) DFFEARS_635 (.Q(id00301), .D(id00301D), .CLK(s_574), .AR(gnd), .AS(s_575), .CE(vcc));
BUF #(.TP(1.5), .ND(1)) BUF_636 (s_574, CLK);
INV #(.TP(1.5)) INV_637 (s_575, PWR_RST_n);
XOR2 #(.TP(0)) XOR2_634 (id00301D, s_576, vcc);
OR3 #(.TP(0)) OR3_620 (s_576, s_577, s_578, s_579);
AND5 #(.TP(3.0)) AND5_621 (s_577, s_580, s_581, s_582, s_583, s_584);
AND2 #(.TP(3.0)) AND2_627 (s_578, s_585, s_586);
AND3 #(.TP(3.0)) AND3_630 (s_579, s_587, s_588, s_589);
INV #(.TP(1.5)) INV_622 (s_580, id00306);
BUF #(.TP(1.5)) BUF_623 (s_581, A1);
INV #(.TP(1.5)) INV_624 (s_582, A2);
BUF #(.TP(1.5)) BUF_625 (s_583, A3);
BUF #(.TP(1.5)) BUF_626 (s_584, id00108Q);
INV #(.TP(1.5)) INV_628 (s_585, id00306);
INV #(.TP(1.5)) INV_629 (s_586, id00301);
INV #(.TP(1.5)) INV_631 (s_587, id00306);
INV #(.TP(1.5)) INV_632 (s_588, AS_n);
BUF #(.TP(1.5)) BUF_633 (s_589, id00131QN);
TRI #(.TA(2.0), .TEN(4.0)) TRI_643 (.Q(LED_n), .A(s_590), .EN(vcc));
BUF #(.TP(1.0)) BUF_642 (s_590, s_591);
XOR2 #(.TP(0)) XOR2_641 (s_591, s_592, gnd);
OR1 #(.TP(0)) OR1_640 (s_592, s_593);
AND1 #(.TP(3.0)) AND1_639 (s_593, s_594);
INV #(.TP(1.5)) INV_638 (s_594, id00304);
DFFEARS #(.TCQ(1.0), .TAR(2.0), .TAS(2.0), .TSU(3.0), .THD(2.0)) DFFEARS_662 (.Q(id00340), .D(id00340D), .CLK(s_595), .AR(s_596), .AS(gnd), .CE(vcc));
BUF #(.TP(1.5), .ND(1)) BUF_663 (s_595, CLK);
AND1 #(.TP(3.0)) AND1_664 (s_596, s_597);
INV #(.TP(1.5)) INV_665 (s_597, Com_Ctrl_765);
XOR2 #(.TP(0)) XOR2_661 (id00340D, s_598, gnd);
OR3 #(.TP(0)) OR3_644 (s_598, s_599, s_600, s_601);
AND3 #(.TP(3.0)) AND3_645 (s_599, s_602, s_603, s_604);
AND3 #(.TP(3.0)) AND3_649 (s_600, s_605, s_606, s_607);
AND7 #(.TP(3.0)) AND7_653 (s_601, s_608, s_609, s_610, s_611, s_612, s_613, s_614);
INV #(.TP(1.5)) INV_646 (s_602, id00340);
BUF #(.TP(1.5)) BUF_647 (s_603, id00338);
BUF #(.TP(1.5)) BUF_648 (s_604, id00339);
BUF #(.TP(1.5)) BUF_650 (s_605, id00340);
BUF #(.TP(1.5)) BUF_651 (s_606, id00338);
INV #(.TP(1.5)) INV_652 (s_607, id00339);
BUF #(.TP(1.5)) BUF_654 (s_608, id00340);
BUF #(.TP(1.5)) BUF_655 (s_609, id00338);
BUF #(.TP(1.5)) BUF_656 (s_610, id00343);
BUF #(.TP(1.5)) BUF_657 (s_611, id00341);
BUF #(.TP(1.5)) BUF_658 (s_612, id00342);
BUF #(.TP(1.5)) BUF_659 (s_613, id00344);
BUF #(.TP(1.5)) BUF_660 (s_614, id00345);
DFFEARS #(.TCQ(1.0), .TAR(2.0), .TAS(2.0), .TSU(3.0), .THD(2.0)) DFFEARS_688 (.Q(id00341), .D(id00341D), .CLK(s_615), .AR(s_616), .AS(gnd), .CE(vcc));
BUF #(.TP(1.5), .ND(1)) BUF_689 (s_615, CLK);
AND1 #(.TP(3.0)) AND1_690 (s_616, s_617);
INV #(.TP(1.5)) INV_691 (s_617, Com_Ctrl_765);
XOR2 #(.TP(0)) XOR2_687 (id00341D, s_618, gnd);
OR4 #(.TP(0)) OR4_666 (s_618, s_619, s_620, s_621, s_622);
AND6 #(.TP(3.0)) AND6_667 (s_619, s_623, s_624, s_625, s_626, s_627, s_628);
AND4 #(.TP(3.0)) AND4_674 (s_620, s_629, s_630, s_631, s_632);
AND3 #(.TP(3.0)) AND3_679 (s_621, s_633, s_634, s_635);
AND3 #(.TP(3.0)) AND3_683 (s_622, s_636, s_637, s_638);
BUF #(.TP(1.5)) BUF_668 (s_623, id00341);
BUF #(.TP(1.5)) BUF_669 (s_624, id00338);
BUF #(.TP(1.5)) BUF_670 (s_625, id00342);
BUF #(.TP(1.5)) BUF_671 (s_626, id00344);
BUF #(.TP(1.5)) BUF_672 (s_627, id00345);
BUF #(.TP(1.5)) BUF_673 (s_628, id00343);
INV #(.TP(1.5)) INV_675 (s_629, id00341);
BUF #(.TP(1.5)) BUF_676 (s_630, id00338);
BUF #(.TP(1.5)) BUF_677 (s_631, id00340);
BUF #(.TP(1.5)) BUF_678 (s_632, id00339);
BUF #(.TP(1.5)) BUF_680 (s_633, id00341);
BUF #(.TP(1.5)) BUF_681 (s_634, id00338);
INV #(.TP(1.5)) INV_682 (s_635, id00339);
BUF #(.TP(1.5)) BUF_684 (s_636, id00341);
BUF #(.TP(1.5)) BUF_685 (s_637, id00338);
INV #(.TP(1.5)) INV_686 (s_638, id00340);
DFFEARS #(.TCQ(1.0), .TAR(2.0), .TAS(2.0), .TSU(3.0), .THD(2.0)) DFFEARS_719 (.Q(id00342), .D(id00342D), .CLK(s_639), .AR(s_640), .AS(gnd), .CE(vcc));
BUF #(.TP(1.5), .ND(1)) BUF_720 (s_639, CLK);
AND1 #(.TP(3.0)) AND1_721 (s_640, s_641);
INV #(.TP(1.5)) INV_722 (s_641, Com_Ctrl_765);
XOR2 #(.TP(0)) XOR2_718 (id00342D, s_642, gnd);
OR1 #(.TP(0)) OR1_717 (s_642, s_643);
OR5 #(.TP(0)) OR5_692 (s_643, s_644, s_645, s_646, s_647, s_648);
AND5 #(.TP(3.0)) AND5_693 (s_644, s_649, s_650, s_651, s_652, s_653);
AND3 #(.TP(3.0)) AND3_699 (s_645, s_654, s_655, s_656);
AND3 #(.TP(3.0)) AND3_703 (s_646, s_657, s_658, s_659);
AND3 #(.TP(3.0)) AND3_707 (s_647, s_660, s_661, s_662);
AND5 #(.TP(3.0)) AND5_711 (s_648, s_663, s_664, s_665, s_666, s_667);
BUF #(.TP(1.5)) BUF_694 (s_649, id00338);
BUF #(.TP(1.5)) BUF_695 (s_650, id00342);
BUF #(.TP(1.5)) BUF_696 (s_651, id00344);
BUF #(.TP(1.5)) BUF_697 (s_652, id00345);
BUF #(.TP(1.5)) BUF_698 (s_653, id00343);
BUF #(.TP(1.5)) BUF_700 (s_654, id00338);
BUF #(.TP(1.5)) BUF_701 (s_655, id00342);
INV #(.TP(1.5)) INV_702 (s_656, id00339);
BUF #(.TP(1.5)) BUF_704 (s_657, id00338);
BUF #(.TP(1.5)) BUF_705 (s_658, id00342);
INV #(.TP(1.5)) INV_706 (s_659, id00340);
BUF #(.TP(1.5)) BUF_708 (s_660, id00338);
BUF #(.TP(1.5)) BUF_709 (s_661, id00342);
INV #(.TP(1.5)) INV_710 (s_662, id00341);
BUF #(.TP(1.5)) BUF_712 (s_663, id00338);
INV #(.TP(1.5)) INV_713 (s_664, id00342);
BUF #(.TP(1.5)) BUF_714 (s_665, id00341);
BUF #(.TP(1.5)) BUF_715 (s_666, id00340);
BUF #(.TP(1.5)) BUF_716 (s_667, id00339);
DFFEARS #(.TCQ(1.0), .TAR(2.0), .TAS(2.0), .TSU(3.0), .THD(2.0)) DFFEARS_754 (.Q(id00343), .D(id00343D), .CLK(s_668), .AR(s_669), .AS(gnd), .CE(vcc));
BUF #(.TP(1.5), .ND(1)) BUF_755 (s_668, CLK);
AND1 #(.TP(3.0)) AND1_756 (s_669, s_670);
INV #(.TP(1.5)) INV_757 (s_670, Com_Ctrl_765);
XOR2 #(.TP(0)) XOR2_753 (id00343D, s_671, gnd);
OR2 #(.TP(0)) OR2_748 (s_671, s_672, s_673);
AND3 #(.TP(3.0)) AND3_749 (s_672, s_674, s_675, s_676);
BUF #(.TP(1.5)) BUF_750 (s_674, id00343);
BUF #(.TP(1.5)) BUF_751 (s_675, id00338);
INV #(.TP(1.5)) INV_752 (s_676, id00341);
OR5 #(.TP(0)) OR5_723 (s_673, s_677, s_678, s_679, s_680, s_681);
AND3 #(.TP(3.0)) AND3_724 (s_677, s_682, s_683, s_684);
AND4 #(.TP(3.0)) AND4_728 (s_678, s_685, s_686, s_687, s_688);
AND6 #(.TP(3.0)) AND6_733 (s_679, s_689, s_690, s_691, s_692, s_693, s_694);
AND3 #(.TP(3.0)) AND3_740 (s_680, s_695, s_696, s_697);
AND3 #(.TP(3.0)) AND3_744 (s_681, s_698, s_699, s_700);
BUF #(.TP(1.5)) BUF_725 (s_682, id00343);
BUF #(.TP(1.5)) BUF_726 (s_683, id00338);
INV #(.TP(1.5)) INV_727 (s_684, id00342);
BUF #(.TP(1.5)) BUF_729 (s_685, id00343);
BUF #(.TP(1.5)) BUF_730 (s_686, id00338);
BUF #(.TP(1.5)) BUF_731 (s_687, id00345);
BUF #(.TP(1.5)) BUF_732 (s_688, id00344);
INV #(.TP(1.5)) INV_734 (s_689, id00343);
BUF #(.TP(1.5)) BUF_735 (s_690, id00338);
BUF #(.TP(1.5)) BUF_736 (s_691, id00341);
BUF #(.TP(1.5)) BUF_737 (s_692, id00342);
BUF #(.TP(1.5)) BUF_738 (s_693, id00340);
BUF #(.TP(1.5)) BUF_739 (s_694, id00339);
BUF #(.TP(1.5)) BUF_741 (s_695, id00343);
BUF #(.TP(1.5)) BUF_742 (s_696, id00338);
INV #(.TP(1.5)) INV_743 (s_697, id00339);
BUF #(.TP(1.5)) BUF_745 (s_698, id00343);
BUF #(.TP(1.5)) BUF_746 (s_699, id00338);
INV #(.TP(1.5)) INV_747 (s_700, id00340);
DFFEARS #(.TCQ(1.0), .TAR(2.0), .TAS(2.0), .TSU(3.0), .THD(2.0)) DFFEARS_778 (.Q(id00304), .D(id00304D), .CLK(s_701), .AR(s_702), .AS(gnd), .CE(vcc));
BUF #(.TP(1.5), .ND(1)) BUF_779 (s_701, CLK);
INV #(.TP(1.5)) INV_780 (s_702, PWR_RST_n);
XOR2 #(.TP(0)) XOR2_777 (id00304D, s_703, gnd);
OR5 #(.TP(0)) OR5_758 (s_703, s_704, s_705, s_706, s_707, s_708);
AND5 #(.TP(3.0)) AND5_759 (s_704, s_709, s_710, s_711, s_712, s_713);
AND2 #(.TP(3.0)) AND2_765 (s_705, s_714, s_715);
AND2 #(.TP(3.0)) AND2_768 (s_706, s_716, s_717);
AND2 #(.TP(3.0)) AND2_771 (s_707, s_718, s_719);
AND2 #(.TP(3.0)) AND2_774 (s_708, s_720, s_721);
BUF #(.TP(1.5)) BUF_760 (s_709, A1);
BUF #(.TP(1.5)) BUF_761 (s_710, A2);
INV #(.TP(1.5)) INV_762 (s_711, A3);
BUF #(.TP(1.5)) BUF_763 (s_712, id00098Q);
BUF #(.TP(1.5)) BUF_764 (s_713, id00107Q);
BUF #(.TP(1.5)) BUF_766 (s_714, id00304);
INV #(.TP(1.5)) INV_767 (s_715, A3);
BUF #(.TP(1.5)) BUF_769 (s_716, id00304);
INV #(.TP(1.5)) INV_770 (s_717, id00108Q);
BUF #(.TP(1.5)) BUF_772 (s_718, id00304);
BUF #(.TP(1.5)) BUF_773 (s_719, A2);
BUF #(.TP(1.5)) BUF_775 (s_720, id00304);
BUF #(.TP(1.5)) BUF_776 (s_721, A1);
DFFEARS #(.TCQ(1.0), .TAR(2.0), .TAS(2.0), .TSU(3.0), .THD(2.0)) DFFEARS_874 (.Q(id00349), .D(id00349D), .CLK(s_722), .AR(s_723), .AS(gnd), .CE(vcc));
BUF #(.TP(1.5), .ND(1)) BUF_875 (s_722, CLK);
AND1 #(.TP(3.0)) AND1_876 (s_723, s_724);
INV #(.TP(1.5)) INV_877 (s_724, Com_Ctrl_765);
XOR2 #(.TP(0)) XOR2_873 (id00349D, s_725, gnd);
OR3 #(.TP(0)) OR3_859 (s_725, s_726, s_727, s_728);
AND3 #(.TP(3.0)) AND3_860 (s_726, s_729, s_730, s_731);
AND8 #(.TP(3.0)) AND8_864 (s_727, s_732, s_733, s_734, s_735, s_736, s_737, s_738, s_739);
BUF #(.TP(1.5)) BUF_861 (s_729, id00146QN);
BUF #(.TP(1.5)) BUF_862 (s_730, id00301);
BUF #(.TP(1.5)) BUF_863 (s_731, id00148Q);
BUF #(.TP(1.5)) BUF_865 (s_732, id00146QN);
INV #(.TP(1.5)) INV_866 (s_733, A16);
INV #(.TP(1.5)) INV_867 (s_734, A17);
INV #(.TP(1.5)) INV_868 (s_735, A18);
INV #(.TP(1.5)) INV_869 (s_736, A19);
INV #(.TP(1.5)) INV_870 (s_737, A27);
BUF #(.TP(1.5)) BUF_871 (s_738, id00344);
BUF #(.TP(1.5)) BUF_872 (s_739, id00009QN);
OR6 #(.TP(0)) OR6_781 (s_728, s_740, s_741, s_742, s_743, s_744, s_745);
AND8 #(.TP(3.0)) AND8_782 (s_740, s_746, s_747, s_748, s_749, s_750, s_751, s_752, s_753);
AND8 #(.TP(3.0)) AND8_791 (s_741, s_754, s_755, s_756, s_757, s_758, s_759, s_760, s_761);
AND8 #(.TP(3.0)) AND8_800 (s_742, s_762, s_763, s_764, s_765, s_766, s_767, s_768, s_769);
AND8 #(.TP(3.0)) AND8_809 (s_743, s_770, s_771, s_772, s_773, s_774, s_775, s_776, s_777);
AND8 #(.TP(3.0)) AND8_818 (s_744, s_778, s_779, s_780, s_781, s_782, s_783, s_784, s_785);
BUF #(.TP(1.5)) BUF_783 (s_746, id00146QN);
INV #(.TP(1.5)) INV_784 (s_747, A16);
INV #(.TP(1.5)) INV_785 (s_748, A17);
INV #(.TP(1.5)) INV_786 (s_749, A18);
INV #(.TP(1.5)) INV_787 (s_750, A19);
INV #(.TP(1.5)) INV_788 (s_751, A27);
BUF #(.TP(1.5)) BUF_789 (s_752, id00009QN);
BUF #(.TP(1.5)) BUF_790 (s_753, id00345);
BUF #(.TP(1.5)) BUF_792 (s_754, id00146QN);
INV #(.TP(1.5)) INV_793 (s_755, A16);
INV #(.TP(1.5)) INV_794 (s_756, A17);
INV #(.TP(1.5)) INV_795 (s_757, A18);
INV #(.TP(1.5)) INV_796 (s_758, A19);
INV #(.TP(1.5)) INV_797 (s_759, A27);
BUF #(.TP(1.5)) BUF_798 (s_760, id00009QN);
BUF #(.TP(1.5)) BUF_799 (s_761, id00343);
BUF #(.TP(1.5)) BUF_801 (s_762, id00146QN);
INV #(.TP(1.5)) INV_802 (s_763, A16);
INV #(.TP(1.5)) INV_803 (s_764, A17);
INV #(.TP(1.5)) INV_804 (s_765, A18);
INV #(.TP(1.5)) INV_805 (s_766, A19);
INV #(.TP(1.5)) INV_806 (s_767, A27);
BUF #(.TP(1.5)) BUF_807 (s_768, id00009QN);
BUF #(.TP(1.5)) BUF_808 (s_769, id00342);
BUF #(.TP(1.5)) BUF_810 (s_770, id00146QN);
INV #(.TP(1.5)) INV_811 (s_771, A16);
INV #(.TP(1.5)) INV_812 (s_772, A17);
INV #(.TP(1.5)) INV_813 (s_773, A18);
INV #(.TP(1.5)) INV_814 (s_774, A19);
INV #(.TP(1.5)) INV_815 (s_775, A27);
BUF #(.TP(1.5)) BUF_816 (s_776, id00009QN);
BUF #(.TP(1.5)) BUF_817 (s_777, id00341);
BUF #(.TP(1.5)) BUF_819 (s_778, id00146QN);
INV #(.TP(1.5)) INV_820 (s_779, A16);
INV #(.TP(1.5)) INV_821 (s_780, A17);
INV #(.TP(1.5)) INV_822 (s_781, A18);
INV #(.TP(1.5)) INV_823 (s_782, A19);
INV #(.TP(1.5)) INV_824 (s_783, A27);
BUF #(.TP(1.5)) BUF_825 (s_784, id00009QN);
BUF #(.TP(1.5)) BUF_826 (s_785, id00340);
OR5 #(.TP(0)) OR5_827 (s_745, s_786, s_787, s_788, s_789, s_790);
AND8 #(.TP(3.0)) AND8_828 (s_786, s_791, s_792, s_793, s_794, s_795, s_796, s_797, s_798);
AND8 #(.TP(3.0)) AND8_837 (s_787, s_799, s_800, s_801, s_802, s_803, s_804, s_805, s_806);
AND7 #(.TP(3.0)) AND7_846 (s_788, s_807, s_808, s_809, s_810, s_811, s_812, s_813);
AND1 #(.TP(3.0)) AND1_854 (s_789, s_814);
AND2 #(.TP(3.0)) AND2_856 (s_790, s_815, s_816);
BUF #(.TP(1.5)) BUF_829 (s_791, id00146QN);
INV #(.TP(1.5)) INV_830 (s_792, A16);
INV #(.TP(1.5)) INV_831 (s_793, A17);
INV #(.TP(1.5)) INV_832 (s_794, A18);
INV #(.TP(1.5)) INV_833 (s_795, A19);
INV #(.TP(1.5)) INV_834 (s_796, A27);
BUF #(.TP(1.5)) BUF_835 (s_797, id00009QN);
INV #(.TP(1.5)) INV_836 (s_798, id00338);
BUF #(.TP(1.5)) BUF_838 (s_799, id00146QN);
INV #(.TP(1.5)) INV_839 (s_800, A16);
INV #(.TP(1.5)) INV_840 (s_801, A17);
INV #(.TP(1.5)) INV_841 (s_802, A18);
INV #(.TP(1.5)) INV_842 (s_803, A19);
INV #(.TP(1.5)) INV_843 (s_804, A27);
BUF #(.TP(1.5)) BUF_844 (s_805, id00009QN);
BUF #(.TP(1.5)) BUF_845 (s_806, id00339);
BUF #(.TP(1.5)) BUF_847 (s_807, id00146QN);
BUF #(.TP(1.5)) BUF_848 (s_808, A16);
BUF #(.TP(1.5)) BUF_849 (s_809, A17);
INV #(.TP(1.5)) INV_850 (s_810, A18);
INV #(.TP(1.5)) INV_851 (s_811, A19);
INV #(.TP(1.5)) INV_852 (s_812, A27);
BUF #(.TP(1.5)) BUF_853 (s_813, id00009QN);
BUF #(.TP(1.5)) BUF_855 (s_814, id00349);
BUF #(.TP(1.5)) BUF_857 (s_815, id00146QN);
BUF #(.TP(1.5)) BUF_858 (s_816, id00131QN);
BUF #(.TP(1.0)) BUF_889 (id00195QN, s_817);
XOR2 #(.TP(0)) XOR2_888 (s_817, s_818, gnd);
OR1 #(.TP(0)) OR1_887 (s_818, s_819);
AND8 #(.TP(3.0)) AND8_886 (s_819, s_820, s_821, s_822, s_823, s_824, s_825, s_826, s_827);
BUF #(.TP(1.5)) BUF_878 (s_820, id00313);
BUF #(.TP(1.5)) BUF_879 (s_821, id00314);
BUF #(.TP(1.5)) BUF_880 (s_822, id00315);
BUF #(.TP(1.5)) BUF_881 (s_823, id00316);
BUF #(.TP(1.5)) BUF_882 (s_824, id00317);
BUF #(.TP(1.5)) BUF_883 (s_825, id00318);
BUF #(.TP(1.5)) BUF_884 (s_826, id00319);
BUF #(.TP(1.5)) BUF_885 (s_827, id00320);
BUF #(.TP(1.0)) BUF_902 (id00214Q, s_828);
XOR2 #(.TP(0)) XOR2_901 (s_828, s_829, gnd);
OR1 #(.TP(0)) OR1_900 (s_829, s_830);
AND9 #(.TP(3.0)) AND9_899 (s_830, s_831, s_832, s_833, s_834, s_835, s_836, s_837, s_838, s_839);
BUF #(.TP(1.5)) BUF_890 (s_831, id00328);
BUF #(.TP(1.5)) BUF_891 (s_832, id00327);
BUF #(.TP(1.5)) BUF_892 (s_833, id00326);
BUF #(.TP(1.5)) BUF_893 (s_834, id00324);
BUF #(.TP(1.5)) BUF_894 (s_835, id00321);
BUF #(.TP(1.5)) BUF_895 (s_836, id00195QN);
BUF #(.TP(1.5)) BUF_896 (s_837, id00322);
BUF #(.TP(1.5)) BUF_897 (s_838, id00325);
BUF #(.TP(1.5)) BUF_898 (s_839, id00323);
TRI #(.TA(2.0), .TEN(4.0)) TRI_913 (.Q(ROM_CE_n), .A(s_840), .EN(vcc));
BUF #(.TP(1.0)) BUF_912 (s_840, s_841);
XOR2 #(.TP(0)) XOR2_911 (s_841, s_842, vcc);
OR2 #(.TP(0)) OR2_903 (s_842, s_843, s_844);
AND2 #(.TP(3.0)) AND2_904 (s_843, s_845, s_846);
AND3 #(.TP(3.0)) AND3_907 (s_844, s_847, s_848, s_849);
INV #(.TP(1.5)) INV_905 (s_845, AS_n);
BUF #(.TP(1.5)) BUF_906 (s_846, id00131QN);
INV #(.TP(1.5)) INV_908 (s_847, AS_n);
BUF #(.TP(1.5)) BUF_909 (s_848, id00301);
BUF #(.TP(1.5)) BUF_910 (s_849, id00148Q);
BUF #(.TP(1.0)) BUF_935 (id00038QN, s_850);
XOR2 #(.TP(0)) XOR2_934 (s_850, s_851, gnd);
OR1 #(.TP(0)) OR1_933 (s_851, s_852);
AND18 #(.TP(3.0)) AND18_932 (s_852, s_853, s_854, s_855, s_856, s_857, s_858, s_859, s_860, s_861, s_862, s_863, s_864, s_865, s_866, s_867, s_868, s_869, s_870);
BUF #(.TP(1.5)) BUF_914 (s_853, id00313);
BUF #(.TP(1.5)) BUF_915 (s_854, id00314);
BUF #(.TP(1.5)) BUF_916 (s_855, id00315);
BUF #(.TP(1.5)) BUF_917 (s_856, id00316);
INV #(.TP(1.5)) INV_918 (s_857, id00317);
INV #(.TP(1.5)) INV_919 (s_858, id00318);
INV #(.TP(1.5)) INV_920 (s_859, id00319);
BUF #(.TP(1.5)) BUF_921 (s_860, id00320);
INV #(.TP(1.5)) INV_922 (s_861, id00321);
INV #(.TP(1.5)) INV_923 (s_862, id00322);
INV #(.TP(1.5)) INV_924 (s_863, id00323);
INV #(.TP(1.5)) INV_925 (s_864, id00324);
BUF #(.TP(1.5)) BUF_926 (s_865, id00325);
INV #(.TP(1.5)) INV_927 (s_866, id00326);
BUF #(.TP(1.5)) BUF_928 (s_867, id00327);
BUF #(.TP(1.5)) BUF_929 (s_868, id00328);
BUF #(.TP(1.5)) BUF_930 (s_869, id00329);
BUF #(.TP(1.5)) BUF_931 (s_870, id00330);
TRI #(.TA(2.0), .TEN(4.0)) TRI_942 (.Q(BUS_WR_n), .A(s_871), .EN(vcc));
BUF #(.TP(1.0)) BUF_941 (s_871, s_872);
XOR2 #(.TP(0)) XOR2_940 (s_872, s_873, vcc);
OR1 #(.TP(0)) OR1_939 (s_873, s_874);
AND2 #(.TP(3.0)) AND2_938 (s_874, s_875, s_876);
INV #(.TP(1.5)) INV_936 (s_875, DS_n);
BUF #(.TP(1.5)) BUF_937 (s_876, id00354);
BUF #(.TP(1.0)) BUF_971 (id00059Q, s_877);
XOR2 #(.TP(0)) XOR2_970 (s_877, s_878, gnd);
OR2 #(.TP(0)) OR2_943 (s_878, s_879, s_880);
AND12 #(.TP(3.0)) AND12_944 (s_879, s_881, s_882, s_883, s_884, s_885, s_886, s_887, s_888, s_889, s_890, s_891, s_892);
AND12 #(.TP(3.0)) AND12_957 (s_880, s_893, s_894, s_895, s_896, s_897, s_898, s_899, s_900, s_901, s_902, s_903, s_904);
BUF #(.TP(1.5)) BUF_945 (s_881, id00308);
BUF #(.TP(1.5)) BUF_946 (s_882, id00313);
BUF #(.TP(1.5)) BUF_947 (s_883, id00314);
BUF #(.TP(1.5)) BUF_948 (s_884, id00315);
BUF #(.TP(1.5)) BUF_949 (s_885, id00316);
BUF #(.TP(1.5)) BUF_950 (s_886, id00317);
BUF #(.TP(1.5)) BUF_951 (s_887, id00318);
BUF #(.TP(1.5)) BUF_952 (s_888, id00319);
BUF #(.TP(1.5)) BUF_953 (s_889, id00320);
BUF #(.TP(1.5)) BUF_954 (s_890, id00321);
BUF #(.TP(1.5)) BUF_955 (s_891, id00322);
BUF #(.TP(1.5)) BUF_956 (s_892, id00312);
BUF #(.TP(1.5)) BUF_958 (s_893, id00308);
BUF #(.TP(1.5)) BUF_959 (s_894, id00313);
BUF #(.TP(1.5)) BUF_960 (s_895, id00314);
BUF #(.TP(1.5)) BUF_961 (s_896, id00315);
BUF #(.TP(1.5)) BUF_962 (s_897, id00316);
BUF #(.TP(1.5)) BUF_963 (s_898, id00317);
BUF #(.TP(1.5)) BUF_964 (s_899, id00318);
BUF #(.TP(1.5)) BUF_965 (s_900, id00319);
BUF #(.TP(1.5)) BUF_966 (s_901, id00320);
BUF #(.TP(1.5)) BUF_967 (s_902, id00321);
BUF #(.TP(1.5)) BUF_968 (s_903, id00322);
BUF #(.TP(1.5)) BUF_969 (s_904, id00311);
DFFEARS #(.TCQ(1.0), .TAR(2.0), .TAS(2.0), .TSU(3.0), .THD(2.0)) DFFEARS_988 (.Q(id00320), .D(id00320D), .CLK(s_905), .AR(s_906), .AS(gnd), .CE(vcc));
BUF #(.TP(1.5), .ND(1)) BUF_989 (s_905, CLK);
INV #(.TP(1.5)) INV_990 (s_906, PWR_RST_n);
XOR2 #(.TP(0)) XOR2_987 (id00320D, s_907, gnd);
OR2 #(.TP(0)) OR2_972 (s_907, s_908, s_909);
AND3 #(.TP(3.0)) AND3_973 (s_908, s_910, s_911, s_912);
AND9 #(.TP(3.0)) AND9_977 (s_909, s_913, s_914, s_915, s_916, s_917, s_918, s_919, s_920, s_921);
INV #(.TP(1.5)) INV_974 (s_910, id00038QN);
INV #(.TP(1.5)) INV_975 (s_911, id00195QN);
BUF #(.TP(1.5)) BUF_976 (s_912, id00320);
INV #(.TP(1.5)) INV_978 (s_913, id00038QN);
INV #(.TP(1.5)) INV_979 (s_914, id00195QN);
BUF #(.TP(1.5)) BUF_980 (s_915, id00319);
BUF #(.TP(1.5)) BUF_981 (s_916, id00313);
BUF #(.TP(1.5)) BUF_982 (s_917, id00314);
BUF #(.TP(1.5)) BUF_983 (s_918, id00315);
BUF #(.TP(1.5)) BUF_984 (s_919, id00316);
BUF #(.TP(1.5)) BUF_985 (s_920, id00317);
BUF #(.TP(1.5)) BUF_986 (s_921, id00318);
DFFEARS #(.TCQ(1.0), .TAR(2.0), .TAS(2.0), .TSU(3.0), .THD(2.0)) DFFEARS_1008 (.Q(id00328), .D(id00328D), .CLK(s_922), .AR(s_923), .AS(gnd), .CE(vcc));
BUF #(.TP(1.5), .ND(1)) BUF_1009 (s_922, CLK);
INV #(.TP(1.5)) INV_1010 (s_923, PWR_RST_n);
XOR2 #(.TP(0)) XOR2_1007 (id00328D, s_924, gnd);
OR2 #(.TP(0)) OR2_991 (s_924, s_925, s_926);
AND3 #(.TP(3.0)) AND3_992 (s_925, s_927, s_928, s_929);
AND10 #(.TP(3.0)) AND10_996 (s_926, s_930, s_931, s_932, s_933, s_934, s_935, s_936, s_937, s_938, s_939);
INV #(.TP(1.5)) INV_993 (s_927, id00038QN);
INV #(.TP(1.5)) INV_994 (s_928, id00214Q);
BUF #(.TP(1.5)) BUF_995 (s_929, id00328);
INV #(.TP(1.5)) INV_997 (s_930, id00038QN);
INV #(.TP(1.5)) INV_998 (s_931, id00214Q);
BUF #(.TP(1.5)) BUF_999 (s_932, id00327);
BUF #(.TP(1.5)) BUF_1000 (s_933, id00326);
BUF #(.TP(1.5)) BUF_1001 (s_934, id00324);
BUF #(.TP(1.5)) BUF_1002 (s_935, id00321);
BUF #(.TP(1.5)) BUF_1003 (s_936, id00195QN);
BUF #(.TP(1.5)) BUF_1004 (s_937, id00322);
BUF #(.TP(1.5)) BUF_1005 (s_938, id00325);
BUF #(.TP(1.5)) BUF_1006 (s_939, id00323);
DFFEARS #(.TCQ(1.0), .TAR(2.0), .TAS(2.0), .TSU(3.0), .THD(2.0)) DFFEARS_1032 (.Q(id00306), .D(id00306D), .CLK(s_940), .AR(s_941), .AS(gnd), .CE(vcc));
BUF #(.TP(1.5), .ND(1)) BUF_1033 (s_940, CLK);
INV #(.TP(1.5)) INV_1034 (s_941, PWR_RST_n);
XOR2 #(.TP(0)) XOR2_1031 (id00306D, s_942, gnd);
OR3 #(.TP(0)) OR3_1011 (s_942, s_943, s_944, s_945);
AND2 #(.TP(3.0)) AND2_1012 (s_943, s_946, s_947);
AND11 #(.TP(3.0)) AND11_1015 (s_944, s_948, s_949, s_950, s_951, s_952, s_953, s_954, s_955, s_956, s_957, s_958);
AND3 #(.TP(3.0)) AND3_1027 (s_945, s_959, s_960, s_961);
BUF #(.TP(1.5)) BUF_1013 (s_946, id00306);
INV #(.TP(1.5)) INV_1014 (s_947, id00059Q);
BUF #(.TP(1.5)) BUF_1016 (s_948, id00306);
INV #(.TP(1.5)) INV_1017 (s_949, id00313);
INV #(.TP(1.5)) INV_1018 (s_950, id00314);
INV #(.TP(1.5)) INV_1019 (s_951, id00315);
INV #(.TP(1.5)) INV_1020 (s_952, id00316);
INV #(.TP(1.5)) INV_1021 (s_953, id00317);
INV #(.TP(1.5)) INV_1022 (s_954, id00318);
INV #(.TP(1.5)) INV_1023 (s_955, id00319);
INV #(.TP(1.5)) INV_1024 (s_956, id00320);
INV #(.TP(1.5)) INV_1025 (s_957, id00321);
INV #(.TP(1.5)) INV_1026 (s_958, id00322);
INV #(.TP(1.5)) INV_1028 (s_959, id00306);
INV #(.TP(1.5)) INV_1029 (s_960, id00311);
INV #(.TP(1.5)) INV_1030 (s_961, id00312);
DFFEARS #(.TCQ(1.0), .TAR(2.0), .TAS(2.0), .TSU(3.0), .THD(2.0)) DFFEARS_1061 (.Q(id00308), .D(id00308D), .CLK(s_962), .AR(s_963), .AS(gnd), .CE(vcc));
BUF #(.TP(1.5), .ND(1)) BUF_1062 (s_962, CLK);
INV #(.TP(1.5)) INV_1063 (s_963, PWR_RST_n);
XOR2 #(.TP(0)) XOR2_1060 (id00308D, s_964, gnd);
OR4 #(.TP(0)) OR4_1035 (s_964, s_965, s_966, s_967, s_968);
AND3 #(.TP(3.0)) AND3_1036 (s_965, s_969, s_970, s_971);
AND3 #(.TP(3.0)) AND3_1040 (s_966, s_972, s_973, s_974);
AND11 #(.TP(3.0)) AND11_1044 (s_967, s_975, s_976, s_977, s_978, s_979, s_980, s_981, s_982, s_983, s_984, s_985);
AND3 #(.TP(3.0)) AND3_1056 (s_968, s_986, s_987, s_988);
INV #(.TP(1.5)) INV_1037 (s_969, id00306);
BUF #(.TP(1.5)) BUF_1038 (s_970, id00308);
BUF #(.TP(1.5)) BUF_1039 (s_971, id00312);
BUF #(.TP(1.5)) BUF_1041 (s_972, id00306);
BUF #(.TP(1.5)) BUF_1042 (s_973, id00308);
INV #(.TP(1.5)) INV_1043 (s_974, id00059Q);
BUF #(.TP(1.5)) BUF_1045 (s_975, id00306);
INV #(.TP(1.5)) INV_1046 (s_976, id00313);
INV #(.TP(1.5)) INV_1047 (s_977, id00314);
INV #(.TP(1.5)) INV_1048 (s_978, id00315);
INV #(.TP(1.5)) INV_1049 (s_979, id00316);
INV #(.TP(1.5)) INV_1050 (s_980, id00317);
INV #(.TP(1.5)) INV_1051 (s_981, id00318);
INV #(.TP(1.5)) INV_1052 (s_982, id00319);
INV #(.TP(1.5)) INV_1053 (s_983, id00320);
INV #(.TP(1.5)) INV_1054 (s_984, id00321);
INV #(.TP(1.5)) INV_1055 (s_985, id00322);
INV #(.TP(1.5)) INV_1057 (s_986, id00306);
BUF #(.TP(1.5)) BUF_1058 (s_987, id00308);
BUF #(.TP(1.5)) BUF_1059 (s_988, id00311);
DFFEARS #(.TCQ(1.0), .TAR(2.0), .TAS(2.0), .TSU(3.0), .THD(2.0)) DFFEARS_1093 (.Q(id00319), .D(id00319D), .CLK(s_989), .AR(s_990), .AS(gnd), .CE(vcc));
BUF #(.TP(1.5), .ND(1)) BUF_1094 (s_989, CLK);
INV #(.TP(1.5)) INV_1095 (s_990, PWR_RST_n);
XOR2 #(.TP(0)) XOR2_1092 (id00319D, s_991, gnd);
OR3 #(.TP(0)) OR3_1085 (s_991, s_992, s_993, s_994);
AND2 #(.TP(3.0)) AND2_1086 (s_992, s_995, s_996);
AND2 #(.TP(3.0)) AND2_1089 (s_993, s_997, s_998);
BUF #(.TP(1.5)) BUF_1087 (s_995, id00319);
INV #(.TP(1.5)) INV_1088 (s_996, id00314);
BUF #(.TP(1.5)) BUF_1090 (s_997, id00319);
INV #(.TP(1.5)) INV_1091 (s_998, id00315);
OR5 #(.TP(0)) OR5_1064 (s_994, s_999, s_1000, s_1001, s_1002, s_1003);
AND2 #(.TP(3.0)) AND2_1065 (s_999, s_1004, s_1005);
AND2 #(.TP(3.0)) AND2_1068 (s_1000, s_1006, s_1007);
AND2 #(.TP(3.0)) AND2_1071 (s_1001, s_1008, s_1009);
AND7 #(.TP(3.0)) AND7_1074 (s_1002, s_1010, s_1011, s_1012, s_1013, s_1014, s_1015, s_1016);
AND2 #(.TP(3.0)) AND2_1082 (s_1003, s_1017, s_1018);
BUF #(.TP(1.5)) BUF_1066 (s_1004, id00319);
INV #(.TP(1.5)) INV_1067 (s_1005, id00316);
BUF #(.TP(1.5)) BUF_1069 (s_1006, id00319);
INV #(.TP(1.5)) INV_1070 (s_1007, id00317);
BUF #(.TP(1.5)) BUF_1072 (s_1008, id00319);
INV #(.TP(1.5)) INV_1073 (s_1009, id00318);
INV #(.TP(1.5)) INV_1075 (s_1010, id00319);
BUF #(.TP(1.5)) BUF_1076 (s_1011, id00315);
BUF #(.TP(1.5)) BUF_1077 (s_1012, id00316);
BUF #(.TP(1.5)) BUF_1078 (s_1013, id00317);
BUF #(.TP(1.5)) BUF_1079 (s_1014, id00318);
BUF #(.TP(1.5)) BUF_1080 (s_1015, id00314);
BUF #(.TP(1.5)) BUF_1081 (s_1016, id00313);
BUF #(.TP(1.5)) BUF_1083 (s_1017, id00319);
INV #(.TP(1.5)) INV_1084 (s_1018, id00313);
TRI #(.TA(2.0), .TEN(4.0)) TRI_1102 (.Q(BUS_RD_n), .A(s_1019), .EN(vcc));
BUF #(.TP(1.0)) BUF_1101 (s_1019, s_1020);
XOR2 #(.TP(0)) XOR2_1100 (s_1020, s_1021, vcc);
OR1 #(.TP(0)) OR1_1099 (s_1021, s_1022);
AND2 #(.TP(3.0)) AND2_1098 (s_1022, s_1023, s_1024);
INV #(.TP(1.5)) INV_1096 (s_1023, AS_n);
BUF #(.TP(1.5)) BUF_1097 (s_1024, id00353);
DFFEARS #(.TCQ(1.0), .TAR(2.0), .TAS(2.0), .TSU(3.0), .THD(2.0)) DFFEARS_1144 (.Q(id00327), .D(id00327D), .CLK(s_1025), .AR(s_1026), .AS(gnd), .CE(vcc));
BUF #(.TP(1.5), .ND(1)) BUF_1145 (s_1025, CLK);
INV #(.TP(1.5)) INV_1146 (s_1026, PWR_RST_n);
XOR2 #(.TP(0)) XOR2_1143 (id00327D, s_1027, gnd);
OR4 #(.TP(0)) OR4_1130 (s_1027, s_1028, s_1029, s_1030, s_1031);
AND3 #(.TP(3.0)) AND3_1131 (s_1028, s_1032, s_1033, s_1034);
AND3 #(.TP(3.0)) AND3_1135 (s_1029, s_1035, s_1036, s_1037);
AND3 #(.TP(3.0)) AND3_1139 (s_1030, s_1038, s_1039, s_1040);
INV #(.TP(1.5)) INV_1132 (s_1032, id00038QN);
BUF #(.TP(1.5)) BUF_1133 (s_1033, id00327);
INV #(.TP(1.5)) INV_1134 (s_1034, id00326);
INV #(.TP(1.5)) INV_1136 (s_1035, id00038QN);
BUF #(.TP(1.5)) BUF_1137 (s_1036, id00327);
INV #(.TP(1.5)) INV_1138 (s_1037, id00324);
INV #(.TP(1.5)) INV_1140 (s_1038, id00038QN);
BUF #(.TP(1.5)) BUF_1141 (s_1039, id00327);
INV #(.TP(1.5)) INV_1142 (s_1040, id00321);
OR5 #(.TP(0)) OR5_1103 (s_1031, s_1041, s_1042, s_1043, s_1044, s_1045);
AND3 #(.TP(3.0)) AND3_1104 (s_1041, s_1046, s_1047, s_1048);
AND3 #(.TP(3.0)) AND3_1108 (s_1042, s_1049, s_1050, s_1051);
AND3 #(.TP(3.0)) AND3_1112 (s_1043, s_1052, s_1053, s_1054);
AND3 #(.TP(3.0)) AND3_1116 (s_1044, s_1055, s_1056, s_1057);
AND9 #(.TP(3.0)) AND9_1120 (s_1045, s_1058, s_1059, s_1060, s_1061, s_1062, s_1063, s_1064, s_1065, s_1066);
INV #(.TP(1.5)) INV_1105 (s_1046, id00038QN);
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
AND1 #(.TP(3.0)) AND1_1212 (s_1126, s_1131);
AND2 #(.TP(3.0)) AND2_1214 (s_1127, s_1132, s_1133);
AND6 #(.TP(3.0)) AND6_1217 (s_1128, s_1134, s_1135, s_1136, s_1137, s_1138, s_1139);
BUF #(.TP(1.5)) BUF_1210 (s_1129, id00338);
INV #(.TP(1.5)) INV_1211 (s_1130, id00340);
INV #(.TP(1.5)) INV_1213 (s_1131, id00091QN);
BUF #(.TP(1.5)) BUF_1215 (s_1132, id00338);
INV #(.TP(1.5)) INV_1216 (s_1133, id00339);
BUF #(.TP(1.5)) BUF_1218 (s_1134, id00338);
BUF #(.TP(1.5)) BUF_1219 (s_1135, id00343);
BUF #(.TP(1.5)) BUF_1220 (s_1136, id00341);
BUF #(.TP(1.5)) BUF_1221 (s_1137, id00342);
BUF #(.TP(1.5)) BUF_1222 (s_1138, id00344);
BUF #(.TP(1.5)) BUF_1223 (s_1139, id00345);
DFFEARS #(.TCQ(1.0), .TAR(2.0), .TAS(2.0), .TSU(3.0), .THD(2.0)) DFFEARS_1235 (.Q(id00300), .D(id00300D), .CLK(s_1140), .AR(s_1141), .AS(gnd), .CE(vcc));
BUF #(.TP(1.5), .ND(1)) BUF_1236 (s_1140, CLK);
INV #(.TP(1.5)) INV_1237 (s_1141, PWR_RST_n);
XOR2 #(.TP(0)) XOR2_1234 (id00300D, s_1142, gnd);
OR2 #(.TP(0)) OR2_1226 (s_1142, s_1143, s_1144);
AND2 #(.TP(3.0)) AND2_1227 (s_1143, s_1145, s_1146);
AND3 #(.TP(3.0)) AND3_1230 (s_1144, s_1147, s_1148, s_1149);
INV #(.TP(1.5)) INV_1228 (s_1145, STATUS_n);
BUF #(.TP(1.5)) BUF_1229 (s_1146, id00300);
INV #(.TP(1.5)) INV_1231 (s_1147, STATUS_n);
BUF #(.TP(1.5)) BUF_1232 (s_1148, id00299);
BUF #(.TP(1.5)) BUF_1233 (s_1149, id00298);
DFFEARS #(.TCQ(1.0), .TAR(2.0), .TAS(2.0), .TSU(3.0), .THD(2.0)) DFFEARS_1252 (.Q(id00299), .D(id00299D), .CLK(s_1150), .AR(s_1151), .AS(gnd), .CE(vcc));
BUF #(.TP(1.5), .ND(1)) BUF_1253 (s_1150, CLK);
INV #(.TP(1.5)) INV_1254 (s_1151, PWR_RST_n);
XOR2 #(.TP(0)) XOR2_1251 (id00299D, s_1152, gnd);
OR3 #(.TP(0)) OR3_1238 (s_1152, s_1153, s_1154, s_1155);
AND3 #(.TP(3.0)) AND3_1239 (s_1153, s_1156, s_1157, s_1158);
AND3 #(.TP(3.0)) AND3_1243 (s_1154, s_1159, s_1160, s_1161);
AND3 #(.TP(3.0)) AND3_1247 (s_1155, s_1162, s_1163, s_1164);
INV #(.TP(1.5)) INV_1240 (s_1156, STATUS_n);
INV #(.TP(1.5)) INV_1241 (s_1157, id00299);
BUF #(.TP(1.5)) BUF_1242 (s_1158, id00298);
INV #(.TP(1.5)) INV_1244 (s_1159, STATUS_n);
BUF #(.TP(1.5)) BUF_1245 (s_1160, id00299);
INV #(.TP(1.5)) INV_1246 (s_1161, id00298);
INV #(.TP(1.5)) INV_1248 (s_1162, STATUS_n);
BUF #(.TP(1.5)) BUF_1249 (s_1163, id00299);
BUF #(.TP(1.5)) BUF_1250 (s_1164, id00300);
BUF #(.TP(1.0)) BUF_1271 (id00158QN, s_1165);
XOR2 #(.TP(0)) XOR2_1270 (s_1165, s_1166, gnd);
OR4 #(.TP(0)) OR4_1255 (s_1166, s_1167, s_1168, s_1169, s_1170);
AND1 #(.TP(3.0)) AND1_1256 (s_1167, s_1171);
AND4 #(.TP(3.0)) AND4_1258 (s_1168, s_1172, s_1173, s_1174, s_1175);
AND4 #(.TP(3.0)) AND4_1263 (s_1169, s_1176, s_1177, s_1178, s_1179);
AND1 #(.TP(3.0)) AND1_1268 (s_1170, s_1180);
INV #(.TP(1.5)) INV_1257 (s_1171, id00338);
INV #(.TP(1.5)) INV_1259 (s_1172, id00345);
INV #(.TP(1.5)) INV_1260 (s_1173, id00344);
INV #(.TP(1.5)) INV_1261 (s_1174, id00343);
INV #(.TP(1.5)) INV_1262 (s_1175, id00342);
INV #(.TP(1.5)) INV_1264 (s_1176, id00345);
INV #(.TP(1.5)) INV_1265 (s_1177, id00344);
INV #(.TP(1.5)) INV_1266 (s_1178, id00343);
INV #(.TP(1.5)) INV_1267 (s_1179, id00341);
INV #(.TP(1.5)) INV_1269 (s_1180, id00337);
DFFEARS #(.TCQ(1.0), .TAR(2.0), .TAS(2.0), .TSU(3.0), .THD(2.0)) DFFEARS_1281 (.Q(id00298), .D(id00298D), .CLK(s_1181), .AR(s_1182), .AS(gnd), .CE(vcc));
BUF #(.TP(1.5), .ND(1)) BUF_1282 (s_1181, CLK);
INV #(.TP(1.5)) INV_1283 (s_1182, PWR_RST_n);
XOR2 #(.TP(0)) XOR2_1280 (id00298D, s_1183, gnd);
OR2 #(.TP(0)) OR2_1272 (s_1183, s_1184, s_1185);
AND2 #(.TP(3.0)) AND2_1273 (s_1184, s_1186, s_1187);
AND3 #(.TP(3.0)) AND3_1276 (s_1185, s_1188, s_1189, s_1190);
INV #(.TP(1.5)) INV_1274 (s_1186, STATUS_n);
INV #(.TP(1.5)) INV_1275 (s_1187, id00298);
INV #(.TP(1.5)) INV_1277 (s_1188, STATUS_n);
BUF #(.TP(1.5)) BUF_1278 (s_1189, id00299);
BUF #(.TP(1.5)) BUF_1279 (s_1190, id00300);
DFFEARS #(.TCQ(1.0), .TAR(2.0), .TAS(2.0), .TSU(3.0), .THD(2.0)) DFFEARS_1292 (.Q(id00310), .D(id00310D), .CLK(s_1191), .AR(gnd), .AS(s_1192), .CE(vcc));
BUF #(.TP(1.5), .ND(1)) BUF_1293 (s_1191, CLK);
INV #(.TP(1.5)) INV_1294 (s_1192, PWR_RST_n);
XOR2 #(.TP(0)) XOR2_1291 (id00310D, s_1193, gnd);
OR2 #(.TP(0)) OR2_1284 (s_1193, s_1194, s_1195);
AND2 #(.TP(3.0)) AND2_1285 (s_1194, s_1196, s_1197);
AND2 #(.TP(3.0)) AND2_1288 (s_1195, s_1198, s_1199);
BUF #(.TP(1.5)) BUF_1286 (s_1196, id00038QN);
BUF #(.TP(1.5)) BUF_1287 (s_1197, id00309);
INV #(.TP(1.5)) INV_1289 (s_1198, id00038QN);
BUF #(.TP(1.5)) BUF_1290 (s_1199, id00310);
DFFEARS #(.TCQ(1.0), .TAR(2.0), .TAS(2.0), .TSU(3.0), .THD(2.0)) DFFEARS_1308 (.Q(id00345), .D(id00345D), .CLK(s_1200), .AR(s_1201), .AS(gnd), .CE(vcc));
BUF #(.TP(1.5), .ND(1)) BUF_1309 (s_1200, CLK);
AND1 #(.TP(3.0)) AND1_1310 (s_1201, s_1202);
INV #(.TP(1.5)) INV_1311 (s_1202, Com_Ctrl_765);
XOR2 #(.TP(0)) XOR2_1307 (id00345D, s_1203, gnd);
OR2 #(.TP(0)) OR2_1295 (s_1203, s_1204, s_1205);
AND2 #(.TP(3.0)) AND2_1296 (s_1204, s_1206, s_1207);
AND7 #(.TP(3.0)) AND7_1299 (s_1205, s_1208, s_1209, s_1210, s_1211, s_1212, s_1213, s_1214);
BUF #(.TP(1.5)) BUF_1297 (s_1206, id00338);
BUF #(.TP(1.5)) BUF_1298 (s_1207, id00345);
BUF #(.TP(1.5)) BUF_1300 (s_1208, id00338);
BUF #(.TP(1.5)) BUF_1301 (s_1209, id00344);
BUF #(.TP(1.5)) BUF_1302 (s_1210, id00339);
BUF #(.TP(1.5)) BUF_1303 (s_1211, id00340);
BUF #(.TP(1.5)) BUF_1304 (s_1212, id00341);
BUF #(.TP(1.5)) BUF_1305 (s_1213, id00342);
BUF #(.TP(1.5)) BUF_1306 (s_1214, id00343);
TRI #(.TA(2.0), .TEN(4.0)) TRI_1318 (.Q(IDE_BUF_EN_n), .A(s_1215), .EN(vcc));
BUF #(.TP(1.0)) BUF_1317 (s_1215, s_1216);
XOR2 #(.TP(0)) XOR2_1316 (s_1216, s_1217, vcc);
OR1 #(.TP(0)) OR1_1315 (s_1217, s_1218);
AND2 #(.TP(3.0)) AND2_1314 (s_1218, s_1219, s_1220);
INV #(.TP(1.5)) INV_1312 (s_1219, AS_n);
BUF #(.TP(1.5)) BUF_1313 (s_1220, id00331);
DFFEARS #(.TCQ(1.0), .TAR(2.0), .TAS(2.0), .TSU(3.0), .THD(2.0)) DFFEARS_1335 (.Q(id00307), .D(id00307D), .CLK(s_1221), .AR(s_1222), .AS(gnd), .CE(vcc));
BUF #(.TP(1.5), .ND(1)) BUF_1336 (s_1221, CLK);
INV #(.TP(1.5)) INV_1337 (s_1222, PWR_RST_n);
XOR2 #(.TP(0)) XOR2_1334 (id00307D, s_1223, gnd);
OR4 #(.TP(0)) OR4_1319 (s_1223, s_1224, s_1225, s_1226, s_1227);
AND4 #(.TP(3.0)) AND4_1320 (s_1224, s_1228, s_1229, s_1230, s_1231);
AND2 #(.TP(3.0)) AND2_1325 (s_1225, s_1232, s_1233);
AND2 #(.TP(3.0)) AND2_1328 (s_1226, s_1234, s_1235);
AND2 #(.TP(3.0)) AND2_1331 (s_1227, s_1236, s_1237);
INV #(.TP(1.5)) INV_1321 (s_1228, id00333);
INV #(.TP(1.5)) INV_1322 (s_1229, id00309);
BUF #(.TP(1.5)) BUF_1323 (s_1230, id00038QN);
INV #(.TP(1.5)) INV_1324 (s_1231, id00310);
BUF #(.TP(1.5)) BUF_1326 (s_1232, id00307);
INV #(.TP(1.5)) INV_1327 (s_1233, id00069Q);
BUF #(.TP(1.5)) BUF_1329 (s_1234, id00307);
INV #(.TP(1.5)) INV_1330 (s_1235, id00098Q);
BUF #(.TP(1.5)) BUF_1332 (s_1236, id00307);
INV #(.TP(1.5)) INV_1333 (s_1237, id00100Q);
TRI #(.TA(2.0), .TEN(4.0)) TRI_1349 (.Q(DUART_CS_n), .A(s_1238), .EN(vcc));
BUF #(.TP(1.0)) BUF_1348 (s_1238, s_1239);
XOR2 #(.TP(0)) XOR2_1347 (s_1239, s_1240, vcc);
OR1 #(.TP(0)) OR1_1346 (s_1240, s_1241);
AND7 #(.TP(3.0)) AND7_1345 (s_1241, s_1242, s_1243, s_1244, s_1245, s_1246, s_1247, s_1248);
INV #(.TP(1.5)) INV_1338 (s_1242, A16);
INV #(.TP(1.5)) INV_1339 (s_1243, A17);
INV #(.TP(1.5)) INV_1340 (s_1244, A18);
INV #(.TP(1.5)) INV_1341 (s_1245, A19);
INV #(.TP(1.5)) INV_1342 (s_1246, A27);
INV #(.TP(1.5)) INV_1343 (s_1247, AS_n);
BUF #(.TP(1.5)) BUF_1344 (s_1248, id00009QN);
DFFEARS #(.TCQ(1.0), .TAR(2.0), .TAS(2.0), .TSU(3.0), .THD(2.0)) DFFEARS_1385 (.Q(id00344), .D(id00344D), .CLK(s_1249), .AR(s_1250), .AS(gnd), .CE(vcc));
BUF #(.TP(1.5), .ND(1)) BUF_1386 (s_1249, CLK);
AND1 #(.TP(3.0)) AND1_1387 (s_1250, s_1251);
INV #(.TP(1.5)) INV_1388 (s_1251, Com_Ctrl_765);
XOR2 #(.TP(0)) XOR2_1384 (id00344D, s_1252, gnd);
OR3 #(.TP(0)) OR3_1375 (s_1252, s_1253, s_1254, s_1255);
AND3 #(.TP(3.0)) AND3_1376 (s_1253, s_1256, s_1257, s_1258);
AND3 #(.TP(3.0)) AND3_1380 (s_1254, s_1259, s_1260, s_1261);
BUF #(.TP(1.5)) BUF_1377 (s_1256, id00344);
BUF #(.TP(1.5)) BUF_1378 (s_1257, id00338);
INV #(.TP(1.5)) INV_1379 (s_1258, id00340);
BUF #(.TP(1.5)) BUF_1381 (s_1259, id00344);
BUF #(.TP(1.5)) BUF_1382 (s_1260, id00338);
INV #(.TP(1.5)) INV_1383 (s_1261, id00341);
OR5 #(.TP(0)) OR5_1350 (s_1255, s_1262, s_1263, s_1264, s_1265, s_1266);
AND3 #(.TP(3.0)) AND3_1351 (s_1262, s_1267, s_1268, s_1269);
AND3 #(.TP(3.0)) AND3_1355 (s_1263, s_1270, s_1271, s_1272);
AND3 #(.TP(3.0)) AND3_1359 (s_1264, s_1273, s_1274, s_1275);
AND7 #(.TP(3.0)) AND7_1363 (s_1265, s_1276, s_1277, s_1278, s_1279, s_1280, s_1281, s_1282);
AND3 #(.TP(3.0)) AND3_1371 (s_1266, s_1283, s_1284, s_1285);
BUF #(.TP(1.5)) BUF_1352 (s_1267, id00344);
BUF #(.TP(1.5)) BUF_1353 (s_1268, id00338);
INV #(.TP(1.5)) INV_1354 (s_1269, id00342);
BUF #(.TP(1.5)) BUF_1356 (s_1270, id00344);
BUF #(.TP(1.5)) BUF_1357 (s_1271, id00338);
INV #(.TP(1.5)) INV_1358 (s_1272, id00343);
BUF #(.TP(1.5)) BUF_1360 (s_1273, id00344);
BUF #(.TP(1.5)) BUF_1361 (s_1274, id00338);
BUF #(.TP(1.5)) BUF_1362 (s_1275, id00345);
INV #(.TP(1.5)) INV_1364 (s_1276, id00344);
BUF #(.TP(1.5)) BUF_1365 (s_1277, id00338);
BUF #(.TP(1.5)) BUF_1366 (s_1278, id00341);
BUF #(.TP(1.5)) BUF_1367 (s_1279, id00342);
BUF #(.TP(1.5)) BUF_1368 (s_1280, id00343);
BUF #(.TP(1.5)) BUF_1369 (s_1281, id00340);
BUF #(.TP(1.5)) BUF_1370 (s_1282, id00339);
BUF #(.TP(1.5)) BUF_1372 (s_1283, id00344);
BUF #(.TP(1.5)) BUF_1373 (s_1284, id00338);
INV #(.TP(1.5)) INV_1374 (s_1285, id00339);
TRI #(.TA(2.0), .TEN(4.0)) TRI_1394 (.Q(IDE_CS1_n), .A(s_1286), .EN(vcc));
BUF #(.TP(1.0)) BUF_1393 (s_1286, s_1287);
XOR2 #(.TP(0)) XOR2_1392 (s_1287, s_1288, gnd);
OR1 #(.TP(0)) OR1_1391 (s_1288, s_1289);
AND1 #(.TP(3.0)) AND1_1390 (s_1289, s_1290);
INV #(.TP(1.5)) INV_1389 (s_1290, id00336);
BUF #(.TP(1.0)) BUF_1401 (id00100Q, s_1291);
XOR2 #(.TP(0)) XOR2_1400 (s_1291, s_1292, gnd);
OR1 #(.TP(0)) OR1_1399 (s_1292, s_1293);
AND3 #(.TP(3.0)) AND3_1398 (s_1293, s_1294, s_1295, s_1296);
BUF #(.TP(1.5)) BUF_1395 (s_1294, A3);
BUF #(.TP(1.5)) BUF_1396 (s_1295, A2);
BUF #(.TP(1.5)) BUF_1397 (s_1296, A1);
DFFEARS #(.TCQ(1.0), .TAR(2.0), .TAS(2.0), .TSU(3.0), .THD(2.0)) DFFEARS_1413 (.Q(id00003), .D(id00003D), .CLK(s_1297), .AR(s_1298), .AS(gnd), .CE(vcc));
BUF #(.TP(1.5), .ND(1)) BUF_1414 (s_1297, CLK);
INV #(.TP(1.5)) INV_1415 (s_1298, PWR_RST_n);
XOR2 #(.TP(0)) XOR2_1412 (id00003D, s_1299, gnd);
OR3 #(.TP(0)) OR3_1402 (s_1299, s_1300, s_1301, s_1302);
AND1 #(.TP(3.0)) AND1_1403 (s_1300, s_1303);
AND2 #(.TP(3.0)) AND2_1405 (s_1301, s_1304, s_1305);
AND3 #(.TP(3.0)) AND3_1408 (s_1302, s_1306, s_1307, s_1308);
BUF #(.TP(1.5)) BUF_1404 (s_1303, id00307);
INV #(.TP(1.5)) INV_1406 (s_1304, id00303);
INV #(.TP(1.5)) INV_1407 (s_1305, DUART_INT_n);
INV #(.TP(1.5)) INV_1409 (s_1306, id00303);
BUF #(.TP(1.5)) BUF_1410 (s_1307, IDE_INTRQ);
BUF #(.TP(1.5)) BUF_1411 (s_1308, NIC_INT_n);
DFFEARS #(.TCQ(1.0), .TAR(2.0), .TAS(2.0), .TSU(3.0), .THD(2.0)) DFFEARS_1431 (.Q(id00296), .D(id00296D), .CLK(s_1309), .AR(s_1310), .AS(gnd), .CE(vcc));
BUF #(.TP(1.5), .ND(1)) BUF_1432 (s_1309, CLK);
INV #(.TP(1.5)) INV_1433 (s_1310, PWR_RST_n);
XOR2 #(.TP(0)) XOR2_1430 (id00296D, s_1311, vcc);
OR3 #(.TP(0)) OR3_1416 (s_1311, s_1312, s_1313, s_1314);
AND4 #(.TP(3.0)) AND4_1417 (s_1312, s_1315, s_1316, s_1317, s_1318);
AND3 #(.TP(3.0)) AND3_1422 (s_1313, s_1319, s_1320, s_1321);
AND3 #(.TP(3.0)) AND3_1426 (s_1314, s_1322, s_1323, s_1324);
INV #(.TP(1.5)) INV_1418 (s_1315, id00303);
INV #(.TP(1.5)) INV_1419 (s_1316, id00307);
BUF #(.TP(1.5)) BUF_1420 (s_1317, EXP_INT_n);
INV #(.TP(1.5)) INV_1421 (s_1318, IDE_INTRQ);
INV #(.TP(1.5)) INV_1423 (s_1319, id00303);
INV #(.TP(1.5)) INV_1424 (s_1320, id00307);
INV #(.TP(1.5)) INV_1425 (s_1321, DUART_INT_n);
INV #(.TP(1.5)) INV_1427 (s_1322, id00303);
INV #(.TP(1.5)) INV_1428 (s_1323, id00307);
INV #(.TP(1.5)) INV_1429 (s_1324, NIC_INT_n);
DFFEARS #(.TCQ(1.0), .TAR(2.0), .TAS(2.0), .TSU(3.0), .THD(2.0)) DFFEARS_1451 (.Q(id00305), .D(id00305D), .CLK(s_1325), .AR(s_1326), .AS(gnd), .CE(vcc));
BUF #(.TP(1.5), .ND(1)) BUF_1452 (s_1325, CLK);
INV #(.TP(1.5)) INV_1453 (s_1326, PWR_RST_n);
XOR2 #(.TP(0)) XOR2_1450 (id00305D, s_1327, gnd);
OR3 #(.TP(0)) OR3_1434 (s_1327, s_1328, s_1329, s_1330);
AND3 #(.TP(3.0)) AND3_1435 (s_1328, s_1331, s_1332, s_1333);
AND6 #(.TP(3.0)) AND6_1439 (s_1329, s_1334, s_1335, s_1336, s_1337, s_1338, s_1339);
AND3 #(.TP(3.0)) AND3_1446 (s_1330, s_1340, s_1341, s_1342);
INV #(.TP(1.5)) INV_1436 (s_1331, id00306);
BUF #(.TP(1.5)) BUF_1437 (s_1332, id00305);
INV #(.TP(1.5)) INV_1438 (s_1333, id00108Q);
INV #(.TP(1.5)) INV_1440 (s_1334, id00306);
INV #(.TP(1.5)) INV_1441 (s_1335, id00100Q);
BUF #(.TP(1.5)) BUF_1442 (s_1336, id00108Q);
BUF #(.TP(1.5)) BUF_1443 (s_1337, A3);
BUF #(.TP(1.5)) BUF_1444 (s_1338, A2);
INV #(.TP(1.5)) INV_1445 (s_1339, A1);
INV #(.TP(1.5)) INV_1447 (s_1340, id00306);
INV #(.TP(1.5)) INV_1448 (s_1341, id00100Q);
BUF #(.TP(1.5)) BUF_1449 (s_1342, id00305);
TRI #(.TA(2.0), .TEN(4.0)) TRI_1459 (.Q(IDE_CS0_n), .A(s_1343), .EN(vcc));
BUF #(.TP(1.0)) BUF_1458 (s_1343, s_1344);
XOR2 #(.TP(0)) XOR2_1457 (s_1344, s_1345, gnd);
OR1 #(.TP(0)) OR1_1456 (s_1345, s_1346);
AND1 #(.TP(3.0)) AND1_1455 (s_1346, s_1347);
INV #(.TP(1.5)) INV_1454 (s_1347, id00334);
DFFEARS #(.TCQ(1.0), .TAR(2.0), .TAS(2.0), .TSU(3.0), .THD(2.0)) DFFEARS_1476 (.Q(id00323), .D(id00323D), .CLK(s_1348), .AR(s_1349), .AS(gnd), .CE(vcc));
BUF #(.TP(1.5), .ND(1)) BUF_1477 (s_1348, CLK);
INV #(.TP(1.5)) INV_1478 (s_1349, PWR_RST_n);
XOR2 #(.TP(0)) XOR2_1475 (id00323D, s_1350, gnd);
OR4 #(.TP(0)) OR4_1460 (s_1350, s_1351, s_1352, s_1353, s_1354);
AND4 #(.TP(3.0)) AND4_1461 (s_1351, s_1355, s_1356, s_1357, s_1358);
AND2 #(.TP(3.0)) AND2_1466 (s_1352, s_1359, s_1360);
AND2 #(.TP(3.0)) AND2_1469 (s_1353, s_1361, s_1362);
AND2 #(.TP(3.0)) AND2_1472 (s_1354, s_1363, s_1364);
INV #(.TP(1.5)) INV_1462 (s_1355, id00323);
BUF #(.TP(1.5)) BUF_1463 (s_1356, id00322);
BUF #(.TP(1.5)) BUF_1464 (s_1357, id00195QN);
BUF #(.TP(1.5)) BUF_1465 (s_1358, id00321);
BUF #(.TP(1.5)) BUF_1467 (s_1359, id00323);
INV #(.TP(1.5)) INV_1468 (s_1360, id00321);
BUF #(.TP(1.5)) BUF_1470 (s_1361, id00323);
INV #(.TP(1.5)) INV_1471 (s_1362, id00195QN);
BUF #(.TP(1.5)) BUF_1473 (s_1363, id00323);
INV #(.TP(1.5)) INV_1474 (s_1364, id00322);
DFFEARS #(.TCQ(1.0), .TAR(2.0), .TAS(2.0), .TSU(3.0), .THD(2.0)) DFFEARS_1499 (.Q(id00324), .D(id00324D), .CLK(s_1365), .AR(s_1366), .AS(gnd), .CE(vcc));
BUF #(.TP(1.5), .ND(1)) BUF_1500 (s_1365, CLK);
INV #(.TP(1.5)) INV_1501 (s_1366, PWR_RST_n);
XOR2 #(.TP(0)) XOR2_1498 (id00324D, s_1367, gnd);
OR5 #(.TP(0)) OR5_1479 (s_1367, s_1368, s_1369, s_1370, s_1371, s_1372);
AND2 #(.TP(3.0)) AND2_1480 (s_1368, s_1373, s_1374);
AND5 #(.TP(3.0)) AND5_1483 (s_1369, s_1375, s_1376, s_1377, s_1378, s_1379);
AND2 #(.TP(3.0)) AND2_1489 (s_1370, s_1380, s_1381);
AND2 #(.TP(3.0)) AND2_1492 (s_1371, s_1382, s_1383);
AND2 #(.TP(3.0)) AND2_1495 (s_1372, s_1384, s_1385);
BUF #(.TP(1.5)) BUF_1481 (s_1373, id00324);
INV #(.TP(1.5)) INV_1482 (s_1374, id00322);
INV #(.TP(1.5)) INV_1484 (s_1375, id00324);
BUF #(.TP(1.5)) BUF_1485 (s_1376, id00195QN);
BUF #(.TP(1.5)) BUF_1486 (s_1377, id00322);
BUF #(.TP(1.5)) BUF_1487 (s_1378, id00321);
BUF #(.TP(1.5)) BUF_1488 (s_1379, id00323);
BUF #(.TP(1.5)) BUF_1490 (s_1380, id00324);
INV #(.TP(1.5)) INV_1491 (s_1381, id00323);
BUF #(.TP(1.5)) BUF_1493 (s_1382, id00324);
INV #(.TP(1.5)) INV_1494 (s_1383, id00321);
BUF #(.TP(1.5)) BUF_1496 (s_1384, id00324);
INV #(.TP(1.5)) INV_1497 (s_1385, id00195QN);
TRI #(.TA(2.0), .TEN(4.0)) TRI_1513 (.Q(IDE_DA2), .A(id00348Q), .EN(vcc));
DFFEARS #(.TCQ(1.0), .TAR(2.0), .TAS(2.0), .TSU(3.0), .THD(2.0)) DFFEARS_1510 (.Q(id00348Q), .D(id00348D), .CLK(s_1386), .AR(s_1387), .AS(gnd), .CE(vcc));
BUF #(.TP(1.5), .ND(1)) BUF_1511 (s_1386, CLK);
INV #(.TP(1.5)) INV_1512 (s_1387, PWR_RST_n);
XOR2 #(.TP(0)) XOR2_1509 (id00348D, s_1388, gnd);
OR2 #(.TP(0)) OR2_1502 (s_1388, s_1389, s_1390);
AND2 #(.TP(3.0)) AND2_1503 (s_1389, s_1391, s_1392);
AND2 #(.TP(3.0)) AND2_1506 (s_1390, s_1393, s_1394);
BUF #(.TP(1.5)) BUF_1504 (s_1391, id00020Q);
BUF #(.TP(1.5)) BUF_1505 (s_1392, A3);
INV #(.TP(1.5)) INV_1507 (s_1393, id00020Q);
BUF #(.TP(1.5)) BUF_1508 (s_1394, id00348Q);
DFFEARS #(.TCQ(1.0), .TAR(2.0), .TAS(2.0), .TSU(3.0), .THD(2.0)) DFFEARS_1545 (.Q(id00325), .D(id00325D), .CLK(s_1395), .AR(s_1396), .AS(gnd), .CE(vcc));
BUF #(.TP(1.5), .ND(1)) BUF_1546 (s_1395, CLK);
INV #(.TP(1.5)) INV_1547 (s_1396, PWR_RST_n);
XOR2 #(.TP(0)) XOR2_1544 (id00325D, s_1397, gnd);
OR2 #(.TP(0)) OR2_1539 (s_1397, s_1398, s_1399);
AND3 #(.TP(3.0)) AND3_1540 (s_1398, s_1400, s_1401, s_1402);
INV #(.TP(1.5)) INV_1541 (s_1400, id00038QN);
BUF #(.TP(1.5)) BUF_1542 (s_1401, id00325);
INV #(.TP(1.5)) INV_1543 (s_1402, id00195QN);
OR5 #(.TP(0)) OR5_1514 (s_1399, s_1403, s_1404, s_1405, s_1406, s_1407);
AND3 #(.TP(3.0)) AND3_1515 (s_1403, s_1408, s_1409, s_1410);
AND3 #(.TP(3.0)) AND3_1519 (s_1404, s_1411, s_1412, s_1413);
AND7 #(.TP(3.0)) AND7_1523 (s_1405, s_1414, s_1415, s_1416, s_1417, s_1418, s_1419, s_1420);
AND3 #(.TP(3.0)) AND3_1531 (s_1406, s_1421, s_1422, s_1423);
AND3 #(.TP(3.0)) AND3_1535 (s_1407, s_1424, s_1425, s_1426);
INV #(.TP(1.5)) INV_1516 (s_1408, id00038QN);
BUF #(.TP(1.5)) BUF_1517 (s_1409, id00325);
INV #(.TP(1.5)) INV_1518 (s_1410, id00322);
INV #(.TP(1.5)) INV_1520 (s_1411, id00038QN);
BUF #(.TP(1.5)) BUF_1521 (s_1412, id00325);
INV #(.TP(1.5)) INV_1522 (s_1413, id00323);
INV #(.TP(1.5)) INV_1524 (s_1414, id00038QN);
INV #(.TP(1.5)) INV_1525 (s_1415, id00325);
BUF #(.TP(1.5)) BUF_1526 (s_1416, id00195QN);
BUF #(.TP(1.5)) BUF_1527 (s_1417, id00322);
BUF #(.TP(1.5)) BUF_1528 (s_1418, id00323);
BUF #(.TP(1.5)) BUF_1529 (s_1419, id00321);
BUF #(.TP(1.5)) BUF_1530 (s_1420, id00324);
INV #(.TP(1.5)) INV_1532 (s_1421, id00038QN);
BUF #(.TP(1.5)) BUF_1533 (s_1422, id00325);
INV #(.TP(1.5)) INV_1534 (s_1423, id00324);
INV #(.TP(1.5)) INV_1536 (s_1424, id00038QN);
BUF #(.TP(1.5)) BUF_1537 (s_1425, id00325);
INV #(.TP(1.5)) INV_1538 (s_1426, id00321);
TRI #(.TA(2.0), .TEN(4.0)) TRI_1554 (.Q(IDE_DIOW_n), .A(s_1427), .EN(vcc));
BUF #(.TP(1.0)) BUF_1553 (s_1427, s_1428);
XOR2 #(.TP(0)) XOR2_1552 (s_1428, s_1429, vcc);
OR1 #(.TP(0)) OR1_1551 (s_1429, s_1430);
AND2 #(.TP(3.0)) AND2_1550 (s_1430, s_1431, s_1432);
INV #(.TP(1.5)) INV_1548 (s_1431, AS_n);
BUF #(.TP(1.5)) BUF_1549 (s_1432, id00355);
DFFEARS #(.TCQ(1.0), .TAR(2.0), .TAS(2.0), .TSU(3.0), .THD(2.0)) DFFEARS_1580 (.Q(id00302), .D(id00302D), .CLK(s_1433), .AR(s_1434), .AS(gnd), .CE(vcc));
BUF #(.TP(1.5), .ND(1)) BUF_1581 (s_1433, CLK);
INV #(.TP(1.5)) INV_1582 (s_1434, PWR_RST_n);
XOR2 #(.TP(0)) XOR2_1579 (id00302D, s_1435, gnd);
OR5 #(.TP(0)) OR5_1555 (s_1435, s_1436, s_1437, s_1438, s_1439, s_1440);
AND3 #(.TP(3.0)) AND3_1556 (s_1436, s_1441, s_1442, s_1443);
AND3 #(.TP(3.0)) AND3_1560 (s_1437, s_1444, s_1445, s_1446);
AND6 #(.TP(3.0)) AND6_1564 (s_1438, s_1447, s_1448, s_1449, s_1450, s_1451, s_1452);
AND3 #(.TP(3.0)) AND3_1571 (s_1439, s_1453, s_1454, s_1455);
AND3 #(.TP(3.0)) AND3_1575 (s_1440, s_1456, s_1457, s_1458);
INV #(.TP(1.5)) INV_1557 (s_1441, id00306);
BUF #(.TP(1.5)) BUF_1558 (s_1442, id00302);
INV #(.TP(1.5)) INV_1559 (s_1443, id00098Q);
INV #(.TP(1.5)) INV_1561 (s_1444, id00306);
BUF #(.TP(1.5)) BUF_1562 (s_1445, id00302);
INV #(.TP(1.5)) INV_1563 (s_1446, id00107Q);
INV #(.TP(1.5)) INV_1565 (s_1447, id00306);
INV #(.TP(1.5)) INV_1566 (s_1448, A3);
BUF #(.TP(1.5)) BUF_1567 (s_1449, id00098Q);
BUF #(.TP(1.5)) BUF_1568 (s_1450, id00107Q);
INV #(.TP(1.5)) INV_1569 (s_1451, A2);
INV #(.TP(1.5)) INV_1570 (s_1452, A1);
INV #(.TP(1.5)) INV_1572 (s_1453, id00306);
BUF #(.TP(1.5)) BUF_1573 (s_1454, id00302);
BUF #(.TP(1.5)) BUF_1574 (s_1455, A2);
INV #(.TP(1.5)) INV_1576 (s_1456, id00306);
BUF #(.TP(1.5)) BUF_1577 (s_1457, id00302);
BUF #(.TP(1.5)) BUF_1578 (s_1458, A3);
TRI #(.TA(2.0), .TEN(4.0)) TRI_1594 (.Q(IDE_DA1), .A(id00347Q), .EN(vcc));
DFFEARS #(.TCQ(1.0), .TAR(2.0), .TAS(2.0), .TSU(3.0), .THD(2.0)) DFFEARS_1591 (.Q(id00347Q), .D(id00347D), .CLK(s_1459), .AR(s_1460), .AS(gnd), .CE(vcc));
BUF #(.TP(1.5), .ND(1)) BUF_1592 (s_1459, CLK);
INV #(.TP(1.5)) INV_1593 (s_1460, PWR_RST_n);
XOR2 #(.TP(0)) XOR2_1590 (id00347D, s_1461, gnd);
OR2 #(.TP(0)) OR2_1583 (s_1461, s_1462, s_1463);
AND2 #(.TP(3.0)) AND2_1584 (s_1462, s_1464, s_1465);
AND2 #(.TP(3.0)) AND2_1587 (s_1463, s_1466, s_1467);
BUF #(.TP(1.5)) BUF_1585 (s_1464, id00020Q);
BUF #(.TP(1.5)) BUF_1586 (s_1465, A2);
INV #(.TP(1.5)) INV_1588 (s_1466, id00020Q);
BUF #(.TP(1.5)) BUF_1589 (s_1467, id00347Q);
TRI #(.TA(2.0), .TEN(4.0)) TRI_1608 (.Q(CIIN_n), .A(s_1468), .EN(vcc));
BUF #(.TP(1.0)) BUF_1607 (s_1468, s_1469);
XOR2 #(.TP(0)) XOR2_1606 (s_1469, s_1470, gnd);
OR3 #(.TP(0)) OR3_1595 (s_1470, s_1471, s_1472, s_1473);
AND3 #(.TP(3.0)) AND3_1596 (s_1471, s_1474, s_1475, s_1476);
AND3 #(.TP(3.0)) AND3_1600 (s_1472, s_1477, s_1478, s_1479);
AND1 #(.TP(3.0)) AND1_1604 (s_1473, s_1480);
INV #(.TP(1.5)) INV_1597 (s_1474, id00009QN);
INV #(.TP(1.5)) INV_1598 (s_1475, id00131QN);
INV #(.TP(1.5)) INV_1599 (s_1476, id00148Q);
INV #(.TP(1.5)) INV_1601 (s_1477, id00009QN);
INV #(.TP(1.5)) INV_1602 (s_1478, id00131QN);
INV #(.TP(1.5)) INV_1603 (s_1479, id00301);
BUF #(.TP(1.5)) BUF_1605 (s_1480, AS_n);
DFFEARS #(.TCQ(1.0), .TAR(2.0), .TAS(2.0), .TSU(3.0), .THD(2.0)) DFFEARS_1638 (.Q(id00326), .D(id00326D), .CLK(s_1481), .AR(s_1482), .AS(gnd), .CE(vcc));
BUF #(.TP(1.5), .ND(1)) BUF_1639 (s_1481, CLK);
INV #(.TP(1.5)) INV_1640 (s_1482, PWR_RST_n);
XOR2 #(.TP(0)) XOR2_1637 (id00326D, s_1483, gnd);
OR3 #(.TP(0)) OR3_1630 (s_1483, s_1484, s_1485, s_1486);
AND2 #(.TP(3.0)) AND2_1631 (s_1484, s_1487, s_1488);
AND2 #(.TP(3.0)) AND2_1634 (s_1485, s_1489, s_1490);
BUF #(.TP(1.5)) BUF_1632 (s_1487, id00326);
INV #(.TP(1.5)) INV_1633 (s_1488, id00321);
BUF #(.TP(1.5)) BUF_1635 (s_1489, id00326);
INV #(.TP(1.5)) INV_1636 (s_1490, id00195QN);
OR5 #(.TP(0)) OR5_1609 (s_1486, s_1491, s_1492, s_1493, s_1494, s_1495);
AND2 #(.TP(3.0)) AND2_1610 (s_1491, s_1496, s_1497);
AND2 #(.TP(3.0)) AND2_1613 (s_1492, s_1498, s_1499);
AND2 #(.TP(3.0)) AND2_1616 (s_1493, s_1500, s_1501);
AND7 #(.TP(3.0)) AND7_1619 (s_1494, s_1502, s_1503, s_1504, s_1505, s_1506, s_1507, s_1508);
AND2 #(.TP(3.0)) AND2_1627 (s_1495, s_1509, s_1510);
BUF #(.TP(1.5)) BUF_1611 (s_1496, id00326);
INV #(.TP(1.5)) INV_1612 (s_1497, id00322);
BUF #(.TP(1.5)) BUF_1614 (s_1498, id00326);
INV #(.TP(1.5)) INV_1615 (s_1499, id00325);
BUF #(.TP(1.5)) BUF_1617 (s_1500, id00326);
INV #(.TP(1.5)) INV_1618 (s_1501, id00323);
INV #(.TP(1.5)) INV_1620 (s_1502, id00326);
BUF #(.TP(1.5)) BUF_1621 (s_1503, id00195QN);
BUF #(.TP(1.5)) BUF_1622 (s_1504, id00322);
BUF #(.TP(1.5)) BUF_1623 (s_1505, id00325);
BUF #(.TP(1.5)) BUF_1624 (s_1506, id00323);
BUF #(.TP(1.5)) BUF_1625 (s_1507, id00321);
BUF #(.TP(1.5)) BUF_1626 (s_1508, id00324);
BUF #(.TP(1.5)) BUF_1628 (s_1509, id00326);
INV #(.TP(1.5)) INV_1629 (s_1510, id00324);
TRI #(.TA(2.0), .TEN(4.0)) TRI_1652 (.Q(IDE_DA0), .A(id00346Q), .EN(vcc));
DFFEARS #(.TCQ(1.0), .TAR(2.0), .TAS(2.0), .TSU(3.0), .THD(2.0)) DFFEARS_1649 (.Q(id00346Q), .D(id00346D), .CLK(s_1511), .AR(s_1512), .AS(gnd), .CE(vcc));
BUF #(.TP(1.5), .ND(1)) BUF_1650 (s_1511, CLK);
INV #(.TP(1.5)) INV_1651 (s_1512, PWR_RST_n);
XOR2 #(.TP(0)) XOR2_1648 (id00346D, s_1513, gnd);
OR2 #(.TP(0)) OR2_1641 (s_1513, s_1514, s_1515);
AND2 #(.TP(3.0)) AND2_1642 (s_1514, s_1516, s_1517);
AND2 #(.TP(3.0)) AND2_1645 (s_1515, s_1518, s_1519);
BUF #(.TP(1.5)) BUF_1643 (s_1516, id00020Q);
BUF #(.TP(1.5)) BUF_1644 (s_1517, A1);
INV #(.TP(1.5)) INV_1646 (s_1518, id00020Q);
BUF #(.TP(1.5)) BUF_1647 (s_1519, id00346Q);
TRI #(.TA(2.0), .TEN(4.0)) TRI_1659 (.Q(HALT_n_combQ), .A(s_1520), .EN(s_1521));
AND1 #(.TP(3.0)) AND1_1660 (s_1521, s_1522);
INV #(.TP(1.5)) INV_1661 (s_1522, Com_Ctrl_766);
BUF #(.TP(1.0)) BUF_1658 (s_1520, s_1523);
XOR2 #(.TP(0)) XOR2_1657 (s_1523, s_1524, gnd);
OR1 #(.TP(0)) OR1_1656 (s_1524, s_1525);
AND2 #(.TP(3.0)) AND2_1655 (s_1525, s_1526, s_1527);
INV #(.TP(1.5)) INV_1653 (s_1526, id00306);
BUF #(.TP(1.5)) BUF_1654 (s_1527, PWR_RST_n);
DFFEARS #(.TCQ(1.0), .TAR(2.0), .TAS(2.0), .TSU(3.0), .THD(2.0)) DFFEARS_1666 (.Q(id00313), .D(id00313D), .CLK(s_1528), .AR(s_1529), .AS(gnd), .CE(vcc));
BUF #(.TP(1.5), .ND(1)) BUF_1667 (s_1528, CLK);
INV #(.TP(1.5)) INV_1668 (s_1529, PWR_RST_n);
XOR2 #(.TP(0)) XOR2_1665 (id00313D, s_1530, gnd);
OR1 #(.TP(0)) OR1_1664 (s_1530, s_1531);
AND1 #(.TP(3.0)) AND1_1663 (s_1531, s_1532);
INV #(.TP(1.5)) INV_1662 (s_1532, id00313);
TRI #(.TA(2.0), .TEN(4.0)) TRI_1675 (.Q(BERR_n_combQ), .A(s_1533), .EN(s_1534));
AND1 #(.TP(3.0)) AND1_1676 (s_1534, s_1535);
BUF #(.TP(1.5)) BUF_1677 (s_1535, id00352);
BUF #(.TP(1.0)) BUF_1674 (s_1533, s_1536);
XOR2 #(.TP(0)) XOR2_1673 (s_1536, s_1537, vcc);
OR1 #(.TP(0)) OR1_1672 (s_1537, s_1538);
AND2 #(.TP(3.0)) AND2_1671 (s_1538, s_1539, s_1540);
INV #(.TP(1.5)) INV_1669 (s_1539, AS_n);
BUF #(.TP(1.5)) BUF_1670 (s_1540, id00352);
BUF #(.TP(1.0)) BUF_1683 (Com_Ctrl_766, s_1541);
XOR2 #(.TP(0)) XOR2_1682 (s_1541, s_1542, gnd);
OR1 #(.TP(0)) OR1_1681 (s_1542, s_1543);
AND2 #(.TP(3.0)) AND2_1680 (s_1543, s_1544, s_1545);
BUF #(.TP(1.5)) BUF_1678 (s_1544, PWR_RST_n);
INV #(.TP(1.5)) INV_1679 (s_1545, id00306);
DFFEARS #(.TCQ(1.0), .TAR(2.0), .TAS(2.0), .TSU(3.0), .THD(2.0)) DFFEARS_1694 (.Q(id00314), .D(id00314D), .CLK(s_1546), .AR(s_1547), .AS(gnd), .CE(vcc));
BUF #(.TP(1.5), .ND(1)) BUF_1695 (s_1546, CLK);
INV #(.TP(1.5)) INV_1696 (s_1547, PWR_RST_n);
XOR2 #(.TP(0)) XOR2_1693 (id00314D, s_1548, gnd);
OR2 #(.TP(0)) OR2_1684 (s_1548, s_1549, s_1550);
AND3 #(.TP(3.0)) AND3_1685 (s_1549, s_1551, s_1552, s_1553);
AND3 #(.TP(3.0)) AND3_1689 (s_1550, s_1554, s_1555, s_1556);
INV #(.TP(1.5)) INV_1686 (s_1551, id00038QN);
INV #(.TP(1.5)) INV_1687 (s_1552, id00313);
BUF #(.TP(1.5)) BUF_1688 (s_1553, id00314);
INV #(.TP(1.5)) INV_1690 (s_1554, id00038QN);
BUF #(.TP(1.5)) BUF_1691 (s_1555, id00313);
INV #(.TP(1.5)) INV_1692 (s_1556, id00314);
TRI #(.TA(2.0), .TEN(4.0)) TRI_1712 (.Q(FPU_CS_n), .A(s_1557), .EN(vcc));
BUF #(.TP(1.0)) BUF_1711 (s_1557, s_1558);
XOR2 #(.TP(0)) XOR2_1710 (s_1558, s_1559, vcc);
OR1 #(.TP(0)) OR1_1709 (s_1559, s_1560);
AND11 #(.TP(3.0)) AND11_1708 (s_1560, s_1561, s_1562, s_1563, s_1564, s_1565, s_1566, s_1567, s_1568, s_1569, s_1570, s_1571);
BUF #(.TP(1.5)) BUF_1697 (s_1561, A13);
INV #(.TP(1.5)) INV_1698 (s_1562, A14);
INV #(.TP(1.5)) INV_1699 (s_1563, A15);
INV #(.TP(1.5)) INV_1700 (s_1564, A16);
BUF #(.TP(1.5)) BUF_1701 (s_1565, A17);
INV #(.TP(1.5)) INV_1702 (s_1566, A18);
INV #(.TP(1.5)) INV_1703 (s_1567, A19);
INV #(.TP(1.5)) INV_1704 (s_1568, AS_n);
BUF #(.TP(1.5)) BUF_1705 (s_1569, FC0);
BUF #(.TP(1.5)) BUF_1706 (s_1570, FC1);
BUF #(.TP(1.5)) BUF_1707 (s_1571, FC2);
TRI #(.TA(2.0), .TEN(4.0)) TRI_1718 (.Q(IPL0_n), .A(s_1572), .EN(vcc));
BUF #(.TP(1.0)) BUF_1717 (s_1572, s_1573);
XOR2 #(.TP(0)) XOR2_1716 (s_1573, s_1574, gnd);
OR1 #(.TP(0)) OR1_1715 (s_1574, s_1575);
AND1 #(.TP(3.0)) AND1_1714 (s_1575, s_1576);
INV #(.TP(1.5)) INV_1713 (s_1576, id00003);
DFFEARS #(.TCQ(1.0), .TAR(2.0), .TAS(2.0), .TSU(3.0), .THD(2.0)) DFFEARS_1723 (.Q(id00337), .D(id00337D), .CLK(s_1577), .AR(gnd), .AS(s_1578), .CE(vcc));
BUF #(.TP(1.5), .ND(1)) BUF_1724 (s_1577, CLK);
INV #(.TP(1.5)) INV_1725 (s_1578, PWR_RST_n);
XOR2 #(.TP(0)) XOR2_1722 (id00337D, s_1579, gnd);
OR1 #(.TP(0)) OR1_1721 (s_1579, s_1580);
AND1 #(.TP(3.0)) AND1_1720 (s_1580, s_1581);
BUF #(.TP(1.5)) BUF_1719 (s_1581, IDE_IORDY);
DFFEARS #(.TCQ(1.0), .TAR(2.0), .TAS(2.0), .TSU(3.0), .THD(2.0)) DFFEARS_1733 (.Q(id00297), .D(id00297D), .CLK(s_1582), .AR(gnd), .AS(s_1583), .CE(vcc));
BUF #(.TP(1.5), .ND(1)) BUF_1734 (s_1582, CLK);
INV #(.TP(1.5)) INV_1735 (s_1583, PWR_RST_n);
XOR2 #(.TP(0)) XOR2_1732 (id00297D, s_1584, gnd);
OR1 #(.TP(0)) OR1_1731 (s_1584, s_1585);
AND4 #(.TP(3.0)) AND4_1730 (s_1585, s_1586, s_1587, s_1588, s_1589);
BUF #(.TP(1.5)) BUF_1726 (s_1586, DUART_INT_n);
BUF #(.TP(1.5)) BUF_1727 (s_1587, NIC_INT_n);
INV #(.TP(1.5)) INV_1728 (s_1588, id00303);
INV #(.TP(1.5)) INV_1729 (s_1589, id00307);
DFFEARS #(.TCQ(1.0), .TAR(2.0), .TAS(2.0), .TSU(3.0), .THD(2.0)) DFFEARS_1751 (.Q(id00315), .D(id00315D), .CLK(s_1590), .AR(s_1591), .AS(gnd), .CE(vcc));
BUF #(.TP(1.5), .ND(1)) BUF_1752 (s_1590, CLK);
INV #(.TP(1.5)) INV_1753 (s_1591, PWR_RST_n);
XOR2 #(.TP(0)) XOR2_1750 (id00315D, s_1592, gnd);
OR3 #(.TP(0)) OR3_1736 (s_1592, s_1593, s_1594, s_1595);
AND4 #(.TP(3.0)) AND4_1737 (s_1593, s_1596, s_1597, s_1598, s_1599);
AND3 #(.TP(3.0)) AND3_1742 (s_1594, s_1600, s_1601, s_1602);
AND3 #(.TP(3.0)) AND3_1746 (s_1595, s_1603, s_1604, s_1605);
INV #(.TP(1.5)) INV_1738 (s_1596, id00038QN);
INV #(.TP(1.5)) INV_1739 (s_1597, id00315);
BUF #(.TP(1.5)) BUF_1740 (s_1598, id00314);
BUF #(.TP(1.5)) BUF_1741 (s_1599, id00313);
INV #(.TP(1.5)) INV_1743 (s_1600, id00038QN);
BUF #(.TP(1.5)) BUF_1744 (s_1601, id00315);
INV #(.TP(1.5)) INV_1745 (s_1602, id00313);
INV #(.TP(1.5)) INV_1747 (s_1603, id00038QN);
BUF #(.TP(1.5)) BUF_1748 (s_1604, id00315);
INV #(.TP(1.5)) INV_1749 (s_1605, id00314);
TRI #(.TA(2.0), .TEN(4.0)) TRI_1759 (.Q(IPL2_n), .A(s_1606), .EN(vcc));
BUF #(.TP(1.0)) BUF_1758 (s_1606, s_1607);
XOR2 #(.TP(0)) XOR2_1757 (s_1607, s_1608, gnd);
OR1 #(.TP(0)) OR1_1756 (s_1608, s_1609);
AND1 #(.TP(3.0)) AND1_1755 (s_1609, s_1610);
BUF #(.TP(1.5)) BUF_1754 (s_1610, id00297);
DFFEARS #(.TCQ(1.0), .TAR(2.0), .TAS(2.0), .TSU(3.0), .THD(2.0)) DFFEARS_1768 (.Q(id00312), .D(id00312D), .CLK(s_1611), .AR(gnd), .AS(s_1612), .CE(vcc));
BUF #(.TP(1.5), .ND(1)) BUF_1769 (s_1611, CLK);
INV #(.TP(1.5)) INV_1770 (s_1612, PWR_RST_n);
XOR2 #(.TP(0)) XOR2_1767 (id00312D, s_1613, gnd);
OR2 #(.TP(0)) OR2_1760 (s_1613, s_1614, s_1615);
AND2 #(.TP(3.0)) AND2_1761 (s_1614, s_1616, s_1617);
AND2 #(.TP(3.0)) AND2_1764 (s_1615, s_1618, s_1619);
INV #(.TP(1.5)) INV_1762 (s_1616, id00038QN);
BUF #(.TP(1.5)) BUF_1763 (s_1617, id00312);
BUF #(.TP(1.5)) BUF_1765 (s_1618, id00038QN);
BUF #(.TP(1.5)) BUF_1766 (s_1619, id00311);
DFFEARS #(.TCQ(1.0), .TAR(2.0), .TAS(2.0), .TSU(3.0), .THD(2.0)) DFFEARS_1779 (.Q(id00311), .D(id00311D), .CLK(s_1620), .AR(gnd), .AS(s_1621), .CE(vcc));
BUF #(.TP(1.5), .ND(1)) BUF_1780 (s_1620, CLK);
INV #(.TP(1.5)) INV_1781 (s_1621, PWR_RST_n);
XOR2 #(.TP(0)) XOR2_1778 (id00311D, s_1622, gnd);
OR2 #(.TP(0)) OR2_1771 (s_1622, s_1623, s_1624);
AND2 #(.TP(3.0)) AND2_1772 (s_1623, s_1625, s_1626);
AND2 #(.TP(3.0)) AND2_1775 (s_1624, s_1627, s_1628);
INV #(.TP(1.5)) INV_1773 (s_1625, id00038QN);
BUF #(.TP(1.5)) BUF_1774 (s_1626, id00311);
BUF #(.TP(1.5)) BUF_1776 (s_1627, id00038QN);
BUF #(.TP(1.5)) BUF_1777 (s_1628, WARM_RST_BTN_n);
DFFEARS #(.TCQ(1.0), .TAR(2.0), .TAS(2.0), .TSU(3.0), .THD(2.0)) DFFEARS_1790 (.Q(id00309), .D(id00309D), .CLK(s_1629), .AR(gnd), .AS(s_1630), .CE(vcc));
BUF #(.TP(1.5), .ND(1)) BUF_1791 (s_1629, CLK);
INV #(.TP(1.5)) INV_1792 (s_1630, PWR_RST_n);
XOR2 #(.TP(0)) XOR2_1789 (id00309D, s_1631, gnd);
OR2 #(.TP(0)) OR2_1782 (s_1631, s_1632, s_1633);
AND2 #(.TP(3.0)) AND2_1783 (s_1632, s_1634, s_1635);
AND2 #(.TP(3.0)) AND2_1786 (s_1633, s_1636, s_1637);
INV #(.TP(1.5)) INV_1784 (s_1634, id00038QN);
BUF #(.TP(1.5)) BUF_1785 (s_1635, id00309);
BUF #(.TP(1.5)) BUF_1787 (s_1636, id00038QN);
BUF #(.TP(1.5)) BUF_1788 (s_1637, NMI_BTN_n);
BIBUF #(.TA(2.0), .TEN(4.0)) BIBUF_1799 (.Q(RESET_n), .A(s_1638), .EN(s_1639), .PAD(RESET_n));
AND1 #(.TP(3.0)) AND1_1800 (s_1639, s_1640);
INV #(.TP(1.5)) INV_1801 (s_1640, Com_Ctrl_766);
BUF #(.TP(1.0)) BUF_1798 (s_1638, s_1641);
XOR2 #(.TP(0)) XOR2_1797 (s_1641, s_1642, gnd);
OR1 #(.TP(0)) OR1_1796 (s_1642, s_1643);
AND2 #(.TP(3.0)) AND2_1795 (s_1643, s_1644, s_1645);
INV #(.TP(1.5)) INV_1793 (s_1644, id00306);
BUF #(.TP(1.5)) BUF_1794 (s_1645, PWR_RST_n);
BUF #(.TP(1.0)) BUF_1807 (id00108Q, s_1646);
XOR2 #(.TP(0)) XOR2_1806 (s_1646, s_1647, gnd);
OR1 #(.TP(0)) OR1_1805 (s_1647, s_1648);
AND2 #(.TP(3.0)) AND2_1804 (s_1648, s_1649, s_1650);
BUF #(.TP(1.5)) BUF_1802 (s_1649, id00098Q);
BUF #(.TP(1.5)) BUF_1803 (s_1650, id00107Q);
DFFEARS #(.TCQ(1.0), .TAR(2.0), .TAS(2.0), .TSU(3.0), .THD(2.0)) DFFEARS_1816 (.Q(id00321), .D(id00321D), .CLK(s_1651), .AR(s_1652), .AS(gnd), .CE(vcc));
BUF #(.TP(1.5), .ND(1)) BUF_1817 (s_1651, CLK);
INV #(.TP(1.5)) INV_1818 (s_1652, PWR_RST_n);
XOR2 #(.TP(0)) XOR2_1815 (id00321D, s_1653, gnd);
OR2 #(.TP(0)) OR2_1808 (s_1653, s_1654, s_1655);
AND2 #(.TP(3.0)) AND2_1809 (s_1654, s_1656, s_1657);
AND2 #(.TP(3.0)) AND2_1812 (s_1655, s_1658, s_1659);
BUF #(.TP(1.5)) BUF_1810 (s_1656, id00321);
INV #(.TP(1.5)) INV_1811 (s_1657, id00195QN);
INV #(.TP(1.5)) INV_1813 (s_1658, id00321);
BUF #(.TP(1.5)) BUF_1814 (s_1659, id00195QN);
DFFEARS #(.TCQ(1.0), .TAR(2.0), .TAS(2.0), .TSU(3.0), .THD(2.0)) DFFEARS_1829 (.Q(id00329), .D(id00329D), .CLK(s_1660), .AR(s_1661), .AS(gnd), .CE(vcc));
BUF #(.TP(1.5), .ND(1)) BUF_1830 (s_1660, CLK);
INV #(.TP(1.5)) INV_1831 (s_1661, PWR_RST_n);
XOR2 #(.TP(0)) XOR2_1828 (id00329D, s_1662, gnd);
OR2 #(.TP(0)) OR2_1819 (s_1662, s_1663, s_1664);
AND3 #(.TP(3.0)) AND3_1820 (s_1663, s_1665, s_1666, s_1667);
AND3 #(.TP(3.0)) AND3_1824 (s_1664, s_1668, s_1669, s_1670);
INV #(.TP(1.5)) INV_1821 (s_1665, id00038QN);
INV #(.TP(1.5)) INV_1822 (s_1666, id00214Q);
BUF #(.TP(1.5)) BUF_1823 (s_1667, id00329);
INV #(.TP(1.5)) INV_1825 (s_1668, id00038QN);
BUF #(.TP(1.5)) BUF_1826 (s_1669, id00214Q);
INV #(.TP(1.5)) INV_1827 (s_1670, id00329);
DFFEARS #(.TCQ(1.0), .TAR(2.0), .TAS(2.0), .TSU(3.0), .THD(2.0)) DFFEARS_1841 (.Q(id00333), .D(id00333D), .CLK(s_1671), .AR(s_1672), .AS(gnd), .CE(vcc));
BUF #(.TP(1.5), .ND(1)) BUF_1842 (s_1671, CLK);
INV #(.TP(1.5)) INV_1843 (s_1672, PWR_RST_n);
XOR2 #(.TP(0)) XOR2_1840 (id00333D, s_1673, gnd);
OR2 #(.TP(0)) OR2_1832 (s_1673, s_1674, s_1675);
AND3 #(.TP(3.0)) AND3_1833 (s_1674, s_1676, s_1677, s_1678);
AND2 #(.TP(3.0)) AND2_1837 (s_1675, s_1679, s_1680);
BUF #(.TP(1.5)) BUF_1834 (s_1676, id00038QN);
INV #(.TP(1.5)) INV_1835 (s_1677, id00309);
INV #(.TP(1.5)) INV_1836 (s_1678, id00310);
INV #(.TP(1.5)) INV_1838 (s_1679, id00038QN);
BUF #(.TP(1.5)) BUF_1839 (s_1680, id00333);
DFFEARS #(.TCQ(1.0), .TAR(2.0), .TAS(2.0), .TSU(3.0), .THD(2.0)) DFFEARS_1856 (.Q(id00322), .D(id00322D), .CLK(s_1681), .AR(s_1682), .AS(gnd), .CE(vcc));
BUF #(.TP(1.5), .ND(1)) BUF_1857 (s_1681, CLK);
INV #(.TP(1.5)) INV_1858 (s_1682, PWR_RST_n);
XOR2 #(.TP(0)) XOR2_1855 (id00322D, s_1683, gnd);
OR3 #(.TP(0)) OR3_1844 (s_1683, s_1684, s_1685, s_1686);
AND3 #(.TP(3.0)) AND3_1845 (s_1684, s_1687, s_1688, s_1689);
AND2 #(.TP(3.0)) AND2_1849 (s_1685, s_1690, s_1691);
AND2 #(.TP(3.0)) AND2_1852 (s_1686, s_1692, s_1693);
INV #(.TP(1.5)) INV_1846 (s_1687, id00322);
BUF #(.TP(1.5)) BUF_1847 (s_1688, id00195QN);
BUF #(.TP(1.5)) BUF_1848 (s_1689, id00321);
BUF #(.TP(1.5)) BUF_1850 (s_1690, id00322);
INV #(.TP(1.5)) INV_1851 (s_1691, id00321);
BUF #(.TP(1.5)) BUF_1853 (s_1692, id00322);
INV #(.TP(1.5)) INV_1854 (s_1693, id00195QN);
DFFEARS #(.TCQ(1.0), .TAR(2.0), .TAS(2.0), .TSU(3.0), .THD(2.0)) DFFEARS_1874 (.Q(id00330), .D(id00330D), .CLK(s_1694), .AR(s_1695), .AS(gnd), .CE(vcc));
BUF #(.TP(1.5), .ND(1)) BUF_1875 (s_1694, CLK);
INV #(.TP(1.5)) INV_1876 (s_1695, PWR_RST_n);
XOR2 #(.TP(0)) XOR2_1873 (id00330D, s_1696, gnd);
OR3 #(.TP(0)) OR3_1859 (s_1696, s_1697, s_1698, s_1699);
AND3 #(.TP(3.0)) AND3_1860 (s_1697, s_1700, s_1701, s_1702);
AND3 #(.TP(3.0)) AND3_1864 (s_1698, s_1703, s_1704, s_1705);
AND4 #(.TP(3.0)) AND4_1868 (s_1699, s_1706, s_1707, s_1708, s_1709);
INV #(.TP(1.5)) INV_1861 (s_1700, id00038QN);
BUF #(.TP(1.5)) BUF_1862 (s_1701, id00330);
INV #(.TP(1.5)) INV_1863 (s_1702, id00214Q);
INV #(.TP(1.5)) INV_1865 (s_1703, id00038QN);
BUF #(.TP(1.5)) BUF_1866 (s_1704, id00330);
INV #(.TP(1.5)) INV_1867 (s_1705, id00329);
INV #(.TP(1.5)) INV_1869 (s_1706, id00038QN);
INV #(.TP(1.5)) INV_1870 (s_1707, id00330);
BUF #(.TP(1.5)) BUF_1871 (s_1708, id00329);
BUF #(.TP(1.5)) BUF_1872 (s_1709, id00214Q);
DFFEARS #(.TCQ(1.0), .TAR(2.0), .TAS(2.0), .TSU(3.0), .THD(2.0)) DFFEARS_1897 (.Q(id00316), .D(id00316D), .CLK(s_1710), .AR(s_1711), .AS(gnd), .CE(vcc));
BUF #(.TP(1.5), .ND(1)) BUF_1898 (s_1710, CLK);
INV #(.TP(1.5)) INV_1899 (s_1711, PWR_RST_n);
XOR2 #(.TP(0)) XOR2_1896 (id00316D, s_1712, gnd);
OR4 #(.TP(0)) OR4_1877 (s_1712, s_1713, s_1714, s_1715, s_1716);
AND3 #(.TP(3.0)) AND3_1878 (s_1713, s_1717, s_1718, s_1719);
AND5 #(.TP(3.0)) AND5_1882 (s_1714, s_1720, s_1721, s_1722, s_1723, s_1724);
AND3 #(.TP(3.0)) AND3_1888 (s_1715, s_1725, s_1726, s_1727);
AND3 #(.TP(3.0)) AND3_1892 (s_1716, s_1728, s_1729, s_1730);
INV #(.TP(1.5)) INV_1879 (s_1717, id00038QN);
BUF #(.TP(1.5)) BUF_1880 (s_1718, id00316);
INV #(.TP(1.5)) INV_1881 (s_1719, id00314);
INV #(.TP(1.5)) INV_1883 (s_1720, id00038QN);
INV #(.TP(1.5)) INV_1884 (s_1721, id00316);
BUF #(.TP(1.5)) BUF_1885 (s_1722, id00313);
BUF #(.TP(1.5)) BUF_1886 (s_1723, id00314);
BUF #(.TP(1.5)) BUF_1887 (s_1724, id00315);
INV #(.TP(1.5)) INV_1889 (s_1725, id00038QN);
BUF #(.TP(1.5)) BUF_1890 (s_1726, id00316);
INV #(.TP(1.5)) INV_1891 (s_1727, id00315);
INV #(.TP(1.5)) INV_1893 (s_1728, id00038QN);
BUF #(.TP(1.5)) BUF_1894 (s_1729, id00316);
INV #(.TP(1.5)) INV_1895 (s_1730, id00313);
DFFEARS #(.TCQ(1.0), .TAR(2.0), .TAS(2.0), .TSU(3.0), .THD(2.0)) DFFEARS_1925 (.Q(id00318), .D(id00318D), .CLK(s_1731), .AR(s_1732), .AS(gnd), .CE(vcc));
BUF #(.TP(1.5), .ND(1)) BUF_1926 (s_1731, CLK);
INV #(.TP(1.5)) INV_1927 (s_1732, PWR_RST_n);
XOR2 #(.TP(0)) XOR2_1924 (id00318D, s_1733, gnd);
OR2 #(.TP(0)) OR2_1920 (s_1733, s_1734, s_1735);
AND2 #(.TP(3.0)) AND2_1921 (s_1734, s_1736, s_1737);
BUF #(.TP(1.5)) BUF_1922 (s_1736, id00318);
INV #(.TP(1.5)) INV_1923 (s_1737, id00315);
OR5 #(.TP(0)) OR5_1900 (s_1735, s_1738, s_1739, s_1740, s_1741, s_1742);
AND2 #(.TP(3.0)) AND2_1901 (s_1738, s_1743, s_1744);
AND2 #(.TP(3.0)) AND2_1904 (s_1739, s_1745, s_1746);
AND6 #(.TP(3.0)) AND6_1907 (s_1740, s_1747, s_1748, s_1749, s_1750, s_1751, s_1752);
AND2 #(.TP(3.0)) AND2_1914 (s_1741, s_1753, s_1754);
AND2 #(.TP(3.0)) AND2_1917 (s_1742, s_1755, s_1756);
BUF #(.TP(1.5)) BUF_1902 (s_1743, id00318);
INV #(.TP(1.5)) INV_1903 (s_1744, id00313);
BUF #(.TP(1.5)) BUF_1905 (s_1745, id00318);
INV #(.TP(1.5)) INV_1906 (s_1746, id00314);
INV #(.TP(1.5)) INV_1908 (s_1747, id00318);
BUF #(.TP(1.5)) BUF_1909 (s_1748, id00315);
BUF #(.TP(1.5)) BUF_1910 (s_1749, id00313);
BUF #(.TP(1.5)) BUF_1911 (s_1750, id00314);
BUF #(.TP(1.5)) BUF_1912 (s_1751, id00316);
BUF #(.TP(1.5)) BUF_1913 (s_1752, id00317);
BUF #(.TP(1.5)) BUF_1915 (s_1753, id00318);
INV #(.TP(1.5)) INV_1916 (s_1754, id00317);
BUF #(.TP(1.5)) BUF_1918 (s_1755, id00318);
INV #(.TP(1.5)) INV_1919 (s_1756, id00316);
TRI #(.TA(2.0), .TEN(4.0)) TRI_1934 (.Q(DSACK1_n_combQ), .A(s_1757), .EN(s_1758));
AND1 #(.TP(3.0)) AND1_1935 (s_1758, s_1759);
BUF #(.TP(1.5)) BUF_1936 (s_1759, id00350);
BUF #(.TP(1.0)) BUF_1933 (s_1757, s_1760);
XOR2 #(.TP(0)) XOR2_1932 (s_1760, s_1761, vcc);
OR1 #(.TP(0)) OR1_1931 (s_1761, s_1762);
AND2 #(.TP(3.0)) AND2_1930 (s_1762, s_1763, s_1764);
INV #(.TP(1.5)) INV_1928 (s_1763, AS_n);
BUF #(.TP(1.5)) BUF_1929 (s_1764, id00350);

endmodule
