mattbettcher/m68030-sbc/68030-design/cpld/glue/sim/prims.v

`timescale 1ns/1ps
// Behavioural models of the ATF15xx fitter's timing-model primitives (for post-fit sim only)
module AND1(output Q, input A1);
assign Q = A1;
specify
  (A1 => Q) = 0;
endspecify
endmodule
module OR1(output Q, input A1);
assign Q = A1;
specify
  (A1 => Q) = 0;
endspecify
endmodule
module AND2(output Q, input A1, A2);
assign Q = A1 & A2;
specify
  (A1 => Q) = 0;
  (A2 => Q) = 0;
endspecify
endmodule
module OR2(output Q, input A1, A2);
assign Q = A1 | A2;
specify
  (A1 => Q) = 0;
  (A2 => Q) = 0;
endspecify
endmodule
module AND3(output Q, input A1, A2, A3);
assign Q = A1 & A2 & A3;
specify
  (A1 => Q) = 0;
  (A2 => Q) = 0;
  (A3 => Q) = 0;
endspecify
endmodule
module OR3(output Q, input A1, A2, A3);
assign Q = A1 | A2 | A3;
specify
  (A1 => Q) = 0;
  (A2 => Q) = 0;
  (A3 => Q) = 0;
endspecify
endmodule
module AND4(output Q, input A1, A2, A3, A4);
assign Q = A1 & A2 & A3 & A4;
specify
  (A1 => Q) = 0;
  (A2 => Q) = 0;
  (A3 => Q) = 0;
  (A4 => Q) = 0;
endspecify
endmodule
module OR4(output Q, input A1, A2, A3, A4);
assign Q = A1 | A2 | A3 | A4;
specify
  (A1 => Q) = 0;
  (A2 => Q) = 0;
  (A3 => Q) = 0;
  (A4 => Q) = 0;
endspecify
endmodule
module AND5(output Q, input A1, A2, A3, A4, A5);
assign Q = A1 & A2 & A3 & A4 & A5;
specify
  (A1 => Q) = 0;
  (A2 => Q) = 0;
  (A3 => Q) = 0;
  (A4 => Q) = 0;
  (A5 => Q) = 0;
endspecify
endmodule
module OR5(output Q, input A1, A2, A3, A4, A5);
assign Q = A1 | A2 | A3 | A4 | A5;
specify
  (A1 => Q) = 0;
  (A2 => Q) = 0;
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
  (A14 => Q) = 0;
  (A15 => Q) = 0;
  (A16 => Q) = 0;
  (A17 => Q) = 0;
  (A18 => Q) = 0;
endspecify
endmodule
module XOR2(output Q, input A1, A2);
assign Q = A1 ^ A2;
specify
  (A1 => Q) = 0;
  (A2 => Q) = 0;
endspecify
endmodule
module INV(output QN, input A);
assign QN = ~A;
specify
  (A => QN) = 0;
endspecify
endmodule
module BUF(output Q, input A);
assign Q = A;
specify
  (A => Q) = 0;
endspecify
endmodule
module TRI(output Q, input A, input EN);
assign Q = EN ? A : 1'bz;
specify
  (A => Q) = 0;
  (EN => Q) = 0;
endspecify
endmodule
module BIBUF(output Q, input A, input EN, inout PAD);
assign PAD = EN ? A : 1'bz;
// Q is tied to PAD in the fitter netlist
endmodule
module DFFEARS(output reg Q, input D, CLK, AR, AS, CE);
always @(posedge CLK or posedge AR or posedge AS)
  if (AR) Q <= 1'b0; else if (AS) Q <= 1'b1; else if (CE) Q <= D;
specify
  (posedge CLK => (Q +: D)) = 0;
  (posedge AR => (Q +: 1'b0)) = 0;
  (posedge AS => (Q +: 1'b1)) = 0;
  $setup(D, posedge CLK, 0);
  $hold(posedge CLK, D, 0);
endspecify
endmodule
