mattbettcher/m68030-sbc/68030-design/kicad/tools/project.py

import os, json, sys
sys.path.insert(0, os.path.dirname(__file__))
from kgen import *

class Project:
    def __init__(self, outdir, root_name=PROJECT, date="2026-09-26", rev="A (draft)", company="Matthew Bettcher — 68030 Linux SBC"):
        self.outdir = outdir
        self.root_name = root_name
        self.date, self.rev, self.company = date, rev, company
        self.libs = Libs({"m68030-sbc": os.path.join(outdir, "lib", "m68030-sbc.kicad_sym")})
        self.root_uuid = U("root")
        self.root = Sheet(self, "root", "68030 Linux SBC — top level", 1, "A2", root=True)
        self.root.inst_path = "/" + self.root_uuid
        self.root.sheets = []
        self.subs = []
    def sub(self, name, title, page, paper="A3"):
        s = Sheet(self, name, title, page, paper)
        s.inst_path = "/%s/%s" % (self.root_uuid, U("sheetsym", name))
        self.subs.append(s)
        return s
    def place_sheet(self, sh, x, y, w, pins_left, pins_right, label_nets=True):
        """pins_*: list of (name, shape) or None(spacer)"""
        n = max(len(pins_left), len(pins_right))
        h = snap((n + 2) * 2.54, 2.54)
        su = U("sheetsym", sh.name)
        o = [Sym("sheet"), [Sym("at"), x, y], [Sym("size"), w, h], [Sym("exclude_from_sim"), Sym("no")],
             [Sym("in_bom"), Sym("yes")], [Sym("on_board"), Sym("yes")], [Sym("dnp"), Sym("no")],
             [Sym("fields_autoplaced"), Sym("yes")],
             [Sym("stroke"), [Sym("width"), 0.1524], [Sym("type"), Sym("solid")]],
             [Sym("fill"), [Sym("color"), 255, 255, 225, 1.0]], [Sym("uuid"), su],
             [Sym("property"), "Sheetname", sh.name, [Sym("at"), x, y - 0.7116, 0], eff(1.27, "left bottom", bold=True)],
             [Sym("property"), "Sheetfile", sh.name + ".kicad_sch", [Sym("at"), x, y + h + 0.5846, 0], eff(1.27, "left top")]]
        R = self.root
        for side, pins in (("L", pins_left), ("R", pins_right)):
            for i, p in enumerate(pins):
                if not p:
                    continue
                name, shape = p
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
