mattbettcher/m68030-sbc/(commit log)

2026-10-04 Import the MC68030 single-board computer design.
    Unpack the KiCad project, spec, BOM, CPLD sources, and renders under 68030-design/, and add the schematic PDF plus the MC68030, MC68881, and BR509 datasheets.
    [bom.csv, clock.kicad_sch, cpu.kicad_sch, debug.kicad_sch, dram.kicad_sch, duart_spi_rtc.kicad_sch, expansion.kicad_sch, fpu.kicad_sch]
2026-10-17 PCB: add silkscreen labels for connectors and jumpers
2026-10-18 PCB: condense to 220x175 mm with SMD oscillators, IDE buffers, battery holder, fuse
2026-10-18 CPLD: Rev A.2 pin swap for U3 glue and U4 DRAM to match the 220x175 placement
    Re-assign the U3/U4 user I/O pins to follow the bus order at the CPU, FPU,
    SIMM, LA headers and DIN. Dedicated inputs, JTAG, power, jumpered pins, TP pins
    and the reserved SPI pins (46/48/49) did not move.
    - U3 glue: 57 pins moved; airwire length 2784 -> 2369 mm, crossings 254 -> 0.
    - U4 DRAM: 54 pins moved; 1598 -> 1296 mm, crossings 372 -> 8. The search
    kept fit1508 in the loop, so all 9 cascades and the 14.0 ns timing were kept.
    - Refits (fit1508 v1918, -7, JTAG on): glue 121/128 MC, 20.3 ns; DRAM 78/128 MC,
    14.0 ns (same as Rev A.1). All CPLD and system sims: 0 errors, 0 DSACK contention.
    - Schematics: lab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
2026-10-18 PCB: fully route the 4-layer board, then fix DRAM termination, strobe stubs and clocks
    Route all 499 signal connections on the 220x175 mm 4-layer board, with signals
    on F.Cu/B.Cu and solid In1 GND / In2 +5V (+3V3 island). The scripted grid router
    is in kicad/tools/route/ (0.4233 mm grid aligned to U1, A* + PathFinder).
    Then fix signal integrity (kicad/tools/route/sifix/): strip the signal tracks,
    move the parts and reroute.
    Full route (first pass):
    - 100 % routed, DRC 0 errors, parity 0; 2453 vias, 56.1 m of signal track.
    - 55 parts nudged <= 0.212 mm onto the grid. The DNP 74ACT257 fallback
    (U801-U803, R829-R838) is set to on_board no in dram.kicad_sch.
    SI fix (this board, sha1 2221a671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
2026-10-18 PCB: 45-degree chamfers and de-hitch pull-tight pass
    Two cleanup passes on the routed 4-layer board. Placement, vias and layers are
    unchanged; only the F.Cu/B.Cu signal tracks were edited.
    45-degree chamfer pass (kicad/tools/route/chamfer45/):
    - 14,403 corners chamfered at the largest size the clearance allows (0.1-8.9 mm).
    90-degree bends 14,456 -> 43 (14 on a via, 25 inside a same-net pad,
    4 with no room).
    - Signal track 53.84 -> 49.87 m. Vias 2365, unchanged. No net got longer.
    De-hitch / pull-tight pass (kicad/tools/route/dehitch/):
    - Each path between pads, vias and T-junctions is rebuilt with the fewest
    octilinear segments (bends <= 45 degrees). Small jogs are removed by shifti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
2026-10-18 Fab: Gerbers, drill, BOM and CPL for Rev A (4-layer, 220x175)
    Fab package made with kicad-cli 9.0.2 from kicad/m68030-sbc.kicad_pcb
    (sha1 e88d2ee4, unchanged). Zones were refilled before DRC and plotting.
    - fab/gerbers/:
    - Protel-extension Gerbers: F.Cu, In1.Cu (GND), In2.Cu (+5V/+3V3), B.Cu,
    F/B mask, F/B silkscreen, F/B paste, Edge.Cuts.
    - The .gbrjob job file.
    - Excellon drill files in mm, PTH (3531 hits) and NPTH (5) separate, plus
    PDF drill maps.
    - The inner layers are renamed -In1_Cu.g1/-In2_Cu.g2, and the inner
    FileFunction in the job file is fixed to L2/L3 (KiCad 9.0.2 wrote L5/L7).
    - Board: 220 x 175 mm, 4 layers, 1.6 mm, ENIG.
    - Min track 0.20 mm; clearance r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
2026-10-18 Fab: PCBWay-clean upload zip, inch drill files per PCBWay plugin
    The "giant hole on the top left" seen in PCBWay's online Gerber viewer was
    not a board or drill-data error. The previous m68030-sbc-fab.zip also held
    non-fab files, and the viewer assigns layers by file name:
    m68030-sbc-NPTH-drl_map.pdf ("NPTH" in the name) and README.txt (.txt) were
    read as Excellon drill files, and the check/*_Cu.png renders as inner copper.
    Parsed as Excellon with no header, the PDF bytes became 3 in and 6 in "holes"
    near the origin, i.e. the giant hole at the top left. The real drill data
    was correct: all 3536 holes and slots match the board in position and size.
    Changes:
    - m68030-sbc-fab.zip is now a flat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
2026-10-18 PCB: 3D models for all chips and sockets
    Only model references change in m68030-sbc.kicad_pcb (pcb sha1 e88d2ee4 -> 67b67dc8).
    Pads, routing, nets and zones are untouched, and .kicad_pro is unchanged.
    - Stock KiCad 9 models (${KICAD9_3DMODEL_DIR}) are kept wherever they resolve:
    SOIC buffers, SOT/TO regulators, crystal, oscillators, passives and connectors.
    - KiCad 9.0.2 and upstream kicad-packages3D have no files for the PLCC THT
    sockets, the NANO2 fuse or the SRP1770TA inductor, although the stock
    footprints point at them. These, plus the custom PGA-128 and SIMM-72
    footprints, now use simple generated STEP models in
    kicad/3dmodels/m68030-sbc.3dshapes/, referenced via ${KIPRJMOD}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
